klaus-liebler/factory_in_a_box/Erweiterungen Hardware.txt

Einen RGB-Ausgang weg
Dafür PWM-Steuerausgang für Vakuum-Pumpe -->passt eins zu eins, oder? Frequenz? ggf für Vakuum keine PWM, sondern knallhartes On/Off?
Wie viele Ventile haben wir jetzt eigentlich
	- Umschaltung für Schieber
	- Vakuum-Auflösung für Sauger
	- 2 oder 3 "Störventile
