klaus-liebler/factory_in_a_box/pcb_factory_control_unit/report.txt

Info: Processing symbol 'C1:Capacitor_SMD:C_0402_1005Metric'.
Info: Processing symbol 'C2:Capacitor_SMD:C_0402_1005Metric'.
Info: Processing symbol 'C3:Capacitor_SMD:C_0402_1005Metric'.
Info: Processing symbol 'C4:Capacitor_SMD:C_0402_1005Metric'.
Info: Processing symbol 'C5:Capacitor_SMD:C_0402_1005Metric'.
Info: Processing symbol 'C6:Capacitor_SMD:C_0402_1005Metric'.
Info: Processing symbol 'C7:Capacitor_SMD:C_0402_1005Metric'.
Info: Processing symbol 'C8:Capacitor_SMD:C_0402_1005Metric'.
Info: Processing symbol 'C9:Capacitor_SMD:C_0402_1005Metric'.
Info: Processing symbol 'C10:Capacitor_SMD:C_0402_1005Metric'.
Info: Processing symbol 'C11:Capacitor_SMD:C_0402_1005Metric'.
Info: Processing symbol 'C12:Capacitor_SMD:C_0402_1005Metric'.
Info: Processing symbol 'C13:Capacitor_SMD:C_0402_1005Metric'.
Info: Processing symbol 'C14:Capacitor_SMD:C_0402_1005Metric'.
Info: Processing symbol 'C15:Capacitor_SMD:C_0402_1005Metric'.
Info: Processing symbol 'C16:Capacitor_SMD:C_0402_1005Metric'.
Info: Processing symbol 'C17:Capacitor_SMD:C_0402_1005Metric'.
Info: Processing symbol 'C18:Capacitor_SMD:C_0402_1005Metric'.
Info: Processing symbol 'C19:Capacitor_SMD:C_0402_1005Metric'.
Info: Processing symbol 'C20:Capacitor_SMD:C_0402_1005Metric'.
Info: Processing symbol 'C21:Capacitor_SMD:C_0402_1005Metric'.
Info: Processing symbol 'C22:Capacitor_SMD:C_0402_1005Metric'.
Info: Processing symbol 'C23:Capacitor_SMD:C_0402_1005Metric'.
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
Info: Processing symbol 'C91:Capacitor_SMD:C_0402_1005Metric'.
Info: Processing symbol 'C92:Capacitor_SMD:C_0402_1005Metric'.
Info: Processing symbol 'C93:Capacitor_SMD:C_0402_1005Metric'.
Info: Processing symbol 'C94:Capacitor_SMD:C_0402_1005Metric'.
Info: Processing symbol 'C95:Capacitor_SMD:C_0402_1005Metric'.
Info: Processing symbol 'C96:Capacitor_SMD:C_0402_1005Metric'.
Info: Processing symbol 'C97:Capacitor_SMD:C_0402_1005Metric'.
Info: Processing symbol 'C98:Capacitor_SMD:C_0402_1005Metric'.
Info: Processing symbol 'C99:Capacitor_SMD:C_0402_1005Metric'.
Info: Processing symbol 'C100:Capacitor_SMD:C_0402_1005Metric'.
Info: Processing symbol 'C101:Capacitor_SMD:C_0805_2012Metric_Pad1.18x1.45mm_HandSolder'.
Info: Processing symbol 'D1:LED_SMD:LED_1206_3216Metric_ReverseMount_Hole1.8x2.4mm'.
Info: Processing symbol 'D2:Diode_SMD:D_SMA'.
Info: Processing symbol 'D3:Diode_SMD:D_SMA'.
Info: Processing symbol 'D4:LED_SMD:LED_1206_3216Metric_ReverseMount_Hole1.8x2.4mm'.
Info: Processing symbol 'D5:LED_SMD:LED_1206_3216Metric_ReverseMount_Hole1.8x2.4mm'.
Info: Processing symbol 'D6:LED_SMD:LED_1206_3216Metric_ReverseMount_Hole1.8x2.4mm'.
Info: Processing symbol 'D7:LED_SMD:LED_1206_3216Metric_ReverseMount_Hole1.8x2.4mm'.
Info: Processing symbol 'D8:Diode_SMD:D_SMA'.
Info: Processing symbol 'D9:Diode_SMD:D_SMA'.
Info: Processing symbol 'D10:Diode_SMD:D_SMA'.
Info: Processing symbol 'D11:Diode_SMD:D_SMA'.
Info: Processing symbol 'D12:LED_SMD:LED_1206_3216Metric_ReverseMount_Hole1.8x2.4mm'.
Info: Processing symbol 'D13:LED_SMD:LED_1206_3216Metric_ReverseMount_Hole1.8x2.4mm'.
Info: Processing symbol 'D14:Diode_SMD:D_SMA'.
Info: Processing symbol 'D15:Diode_SMD:D_SMA'.
Info: Processing symbol 'D16:LED_SMD:LED_1206_3216Metric_ReverseMount_Hole1.8x2.4mm'.
Info: Processing symbol 'D17:LED_SMD:LED_1206_3216Metric_ReverseMount_Hole1.8x2.4mm'.
Info: Processing symbol 'EthercatA1:liebler_CONN:RJ45_HANRUN_HR911105A'.
Info: Processing symbol 'EthercatB1:liebler_CONN:RJ45_HANRUN_HR911105A'.
Info: Processing symbol 'ETHERNET1:liebler_CONN:RJ45_HANRUN_HR911105A'.
Info: Processing symbol 'H1:MountingHole:MountingHole_4.3mm_M4_DIN965'.
Info: Processing symbol 'H2:MountingHole:MountingHole_4.3mm_M4_DIN965'.
Info: Processing symbol 'H3:MountingHole:MountingHole_4.3mm_M4_DIN965'.
Info: Processing symbol 'H4:MountingHole:MountingHole_4.3mm_M4_DIN965'.
Info: Processing symbol 'IJ1:liebler_CONN:JST_XH_B5B-XH-A_1x05_P2.50mm_Vertical_smaller'.
Info: Processing symbol 'J1:liebler_CONN:JST_XH_B3B-XH-A_1x03_P2.50mm_Vertical_smaller'.
Info: Processing symbol 'J2:liebler_CONN:IDC-Header_2x07_P1.27mm_Vertical_SMD'.
Info: Processing symbol 'J3:liebler_MECH:microSD push'.
Info: Processing symbol 'U5:Package_TO_SOT_SMD:SOT-23-6'.
Info: Processing symbol 'U6:Package_DFN_QFN:Texas_RGE0024H_VQFN-24-1EP_4x4mm_P0.5mm_EP2.7x2.7mm_ThermalVias'.
Info: Processing symbol 'U7:Package_TO_SOT_SMD:SOT-223-3_TabPin2'.
Info: Processing symbol 'U8:Package_SO:TSSOP-10_3x3mm_P0.5mm'.
Info: Processing symbol 'J4:Connector_BarrelJack:BarrelJack_Horizontal'.
Info: Processing symbol 'J5:liebler_CONN:USB_C_Receptacle_HRO_TYPE-C-31-M-12_smaller'.
Info: Processing symbol 'U9:Package_DFN_QFN:QFN-28-1EP_5x5mm_P0.5mm_EP3.75x3.75mm_ThermalVias'.
Info: Processing symbol 'U10:Package_DFN_QFN:QFN-28-1EP_5x5mm_P0.5mm_EP3.75x3.75mm_ThermalVias'.
Info: Processing symbol 'U11:Package_SO:SOIC-14_3.9x8.7mm_P1.27mm'.
Info: Processing symbol 'U12:Package_SO:SOIC-16_3.9x9.9mm_P1.27mm'.
Info: Processing symbol 'J6:liebler_CONN:USB_C_Receptacle_HRO_TYPE-C-31-M-12_smaller'.
Info: Processing symbol 'U13:Package_DFN_QFN:QFN-64-1EP_9x9mm_P0.5mm_EP6x6mm_ThermalVias'.
Info: Processing symbol 'X1:liebler_MODULES:DCDC-XL6009-boost'.
Info: Processing symbol 'Y1:Crystal:Crystal_SMD_2016-4Pin_2.0x1.6mm'.
Info: Processing symbol 'Y2:Crystal:Crystal_SMD_2016-4Pin_2.0x1.6mm'.
Info: Processing symbol 'J7:liebler_CONN:JST_XH_B5B-XH-A_1x05_P2.50mm_Vertical_smaller'.
Info: Processing symbol 'J8:liebler_CONN:JST_XH_B5B-XH-A_1x05_P2.50mm_Vertical_smaller'.
Info: Processing symbol 'J9:liebler_CONN:JST_XH_B5B-XH-A_1x05_P2.50mm_Vertical_smaller'.
Info: Processing symbol 'J10:liebler_CONN:JST_XH_B3B-XH-A_1x03_P2.50mm_Vertical_smaller'.
Info: Processing symbol 'J11:liebler_CONN:JST_XH_B3B-XH-A_1x03_P2.50mm_Vertical_smaller'.
Info: Processing symbol 'J12:liebler_CONN:JST_XH_B3B-XH-A_1x03_P2.50mm_Vertical_smaller'.
Info: Processing symbol 'J13:liebler_CONN:JST_XH_B3B-XH-A_1x03_P2.50mm_Vertical_smaller'.
Info: Processing symbol 'J14:liebler_CONN:JST_XH_B3B-XH-A_1x03_P2.50mm_Vertical_smaller'.
Info: Processing symbol 'J15:Connector_IDC:IDC-Header_2x05_P2.54mm_Vertical'.
Info: Processing symbol 'J16:liebler_CONN:JST_XH_B4B-XH-A_1x04_P2.50mm_Vertical_smaller'.
Info: Processing symbol 'J17:liebler_CONN:JST_XH_B4B-XH-A_1x04_P2.50mm_Vertical_smaller'.
Info: Processing symbol 'J18:liebler_CONN:JST_XH_B4B-XH-A_1x04_P2.50mm_Vertical_smaller'.
Info: Processing symbol 'J19:liebler_CONN:JST_XH_B3B-XH-A_1x03_P2.50mm_Vertical_smaller'.
Info: Processing symbol 'J20:Connector_Molex:Molex_SPOX_5267-03A_1x03_P2.50mm_Vertical'.
Info: Processing symbol 'J21:Connector_JST:JST_XH_B2B-XH-A_1x02_P2.50mm_Vertical'.
Info: Processing symbol 'J22:liebler_CONN:JST_XH_B4B-XH-A_1x04_P2.50mm_Vertical_smaller'.
Info: Processing symbol 'J23:liebler_CONN:PhoenixContact_MC_1,5_2-G-3.5_1x02_P3.50mm_Horizontal_smallerCourtyard'.
Info: Processing symbol 'J24:liebler_CONN:PhoenixContact_MC_1,5_2-G-3.5_1x02_P3.50mm_Horizontal_smallerCourtyard'.
Info: Processing symbol 'J25:Connector_JST:JST_XH_B2B-XH-A_1x02_P2.50mm_Vertical'.
Info: Processing symbol 'J26:Connector_JST:JST_XH_B2B-XH-A_1x02_P2.50mm_Vertical'.
Info: Processing symbol 'J27:Connector_JST:JST_XH_B2B-XH-A_1x02_P2.50mm_Vertical'.
Info: Processing symbol 'J28:Connector_JST:JST_XH_B2B-XH-A_1x02_P2.50mm_Vertical'.
Info: Processing symbol 'J29:liebler_CONN:JST_XH_B4B-XH-A_1x04_P2.50mm_Vertical_smaller'.
Info: Processing symbol 'L1:Inductor_SMD:L_0603_1608Metric'.
Info: Processing symbol 'L2:Inductor_SMD:L_0603_1608Metric'.
Info: Processing symbol 'L3:Inductor_SMD:L_Abracon_ASPI-0630LR'.
Info: Processing symbol 'L4:Inductor_SMD:L_Abracon_ASPI-0630LR'.
Info: Processing symbol 'L5:Inductor_SMD:L_Bourns_SRP1245A'.
Info: Processing symbol 'L6:Inductor_SMD:L_0805_2012Metric'.
Info: Processing symbol 'L7:Inductor_SMD:L_0603_1608Metric'.
Info: Processing symbol 'L8:Inductor_SMD:L_0603_1608Metric'.
Info: Processing symbol 'L9:Inductor_SMD:L_0603_1608Metric'.
Info: Processing symbol 'L10:Inductor_SMD:L_0603_1608Metric'.
Info: Processing symbol 'L11:Inductor_SMD:L_0603_1608Metric'.
Info: Processing symbol 'NT1:NetTie:NetTie-2_SMD_Pad0.5mm'.
Info: Processing symbol 'NT2:NetTie:NetTie-2_SMD_Pad0.5mm'.
Info: Processing symbol 'NT3:NetTie:NetTie-2_SMD_Pad0.5mm'.
Info: Processing symbol 'Q1:Package_SON:VSON-8_3.3x3.3mm_P0.65mm_NexFET'.
Info: Processing symbol 'Q2:Package_TO_SOT_SMD:SOT-23'.
Info: Processing symbol 'Q3:Package_TO_SOT_SMD:SOT-23'.
Info: Processing symbol 'Q4:Package_TO_SOT_SMD:SOT-23'.
Info: Processing symbol 'Q5:Package_TO_SOT_SMD:SOT-23'.
Info: Processing symbol 'Q6:Package_TO_SOT_SMD:SOT-23'.
Info: Processing symbol 'Q7:Package_TO_SOT_SMD:SOT-23'.
Info: Processing symbol 'Q8:Package_TO_SOT_SMD:SOT-23'.
Info: Processing symbol 'Q9:Package_TO_SOT_SMD:SOT-23'.
Info: Processing symbol 'R1:Resistor_SMD:R_0402_1005Metric'.
Info: Processing symbol 'R2:Resistor_SMD:R_0402_1005Metric'.
Info: Processing symbol 'R3:Resistor_SMD:R_0402_1005Metric'.
Info: Processing symbol 'R4:Resistor_SMD:R_0402_1005Metric'.
Info: Processing symbol 'R5:Resistor_SMD:R_0402_1005Metric'.
Info: Processing symbol 'R6:Resistor_SMD:R_0402_1005Metric'.
Info: Processing symbol 'R7:Resistor_SMD:R_0402_1005Metric'.
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
Info: Processing symbol 'R75:Resistor_SMD:R_0402_1005Metric'.
Info: Processing symbol 'R76:Resistor_SMD:R_0402_1005Metric'.
Info: Processing symbol 'R77:Resistor_SMD:R_0402_1005Metric'.
Info: Processing symbol 'R78:Resistor_SMD:R_0402_1005Metric'.
Info: Processing symbol 'R79:Resistor_SMD:R_0402_1005Metric'.
Info: Processing symbol 'R80:Resistor_SMD:R_0402_1005Metric'.
Info: Processing symbol 'R81:Resistor_SMD:R_0402_1005Metric'.
Info: Processing symbol 'R82:Resistor_SMD:R_0402_1005Metric'.
Info: Processing symbol 'R83:Resistor_SMD:R_0402_1005Metric'.
Info: Processing symbol 'R84:Resistor_SMD:R_0402_1005Metric'.
Info: Processing symbol 'R85:Resistor_SMD:R_0402_1005Metric'.
Info: Processing symbol 'R86:Resistor_SMD:R_0402_1005Metric'.
Info: Processing symbol 'R87:Resistor_SMD:R_0402_1005Metric'.
Info: Processing symbol 'R88:Resistor_SMD:R_0402_1005Metric'.
Info: Processing symbol 'R89:Resistor_SMD:R_0402_1005Metric'.
Info: Processing symbol 'R90:Resistor_SMD:R_0402_1005Metric'.
Info: Processing symbol 'R91:Resistor_SMD:R_0402_1005Metric'.
Info: Processing symbol 'R92:Resistor_SMD:R_0402_1005Metric'.
Info: Processing symbol 'R93:Resistor_SMD:R_0402_1005Metric'.
Info: Processing symbol 'R94:Resistor_SMD:R_0402_1005Metric'.
Info: Processing symbol 'R95:Resistor_SMD:R_0805_2012Metric_Pad1.20x1.40mm_HandSolder'.
Info: Processing symbol 'R96:Resistor_SMD:R_0805_2012Metric_Pad1.20x1.40mm_HandSolder'.
Info: Processing symbol 'R97:Resistor_SMD:R_0402_1005Metric'.
Info: Processing symbol 'R98:Resistor_SMD:R_0402_1005Metric'.
Info: Processing symbol 'R99:Resistor_SMD:R_0402_1005Metric'.
Info: Processing symbol 'R100:Resistor_SMD:R_0402_1005Metric'.
Info: Processing symbol 'R101:Resistor_SMD:R_0402_1005Metric'.
Info: Processing symbol 'R102:Resistor_SMD:R_0402_1005Metric'.
Info: Processing symbol 'R103:Resistor_SMD:R_0402_1005Metric'.
Info: Processing symbol 'R104:Resistor_SMD:R_0805_2012Metric_Pad1.20x1.40mm_HandSolder'.
Info: Processing symbol 'R105:Resistor_SMD:R_0402_1005Metric'.
Info: Processing symbol 'SW1:liebler_MECH:SW_SPST_TL3342_smaller'.
Info: Processing symbol 'SW2:liebler_MECH:SW_SPST_TL3342_smaller'.
Info: Processing symbol 'TP1:TestPoint:TestPoint_THTPad_D1.0mm_Drill0.5mm'.
Info: Processing symbol 'TP2:TestPoint:TestPoint_THTPad_D1.0mm_Drill0.5mm'.
Info: Processing symbol 'TP3:TestPoint:TestPoint_THTPad_D1.0mm_Drill0.5mm'.
Info: Processing symbol 'TP4:TestPoint:TestPoint_THTPad_D1.0mm_Drill0.5mm'.
Info: Processing symbol 'U1:Package_QFP:LQFP-100_14x14mm_P0.5mm'.
Info: Processing symbol 'U2:Package_DFN_QFN:DFN-8-1EP_3x3mm_P0.65mm_EP1.55x2.4mm'.
Info: Processing symbol 'U3:Package_DFN_QFN:VQFN-24-1EP_4x4mm_P0.5mm_EP2.5x2.5mm_ThermalVias'.
Info: Processing symbol 'U4:Package_TO_SOT_SMD:SOT-23-6'.
Updated X1 unit metadata.
Updated U11 symbol association from /3e57726e-e70f-48f8-bf8b-be1a55c6b2d5/e5de299f-0096-4c31-9eca-c668b48ce3ce to /3e57726e-e70f-48f8-bf8b-be1a55c6b2d5/e5f502ed-76cb-4969-b676-b47a32f629b9.
Changed X1 footprint from 'liebler_MODULES:DCDC-XL4015' to 'liebler_MODULES:DCDC-XL6009-boost'.
Removed unused net Net-(Q4-B).
Removed unused net Net-(Q4-C).
Warning: No net found for component J3 pad 10 (no pin 10 in symbol).
Warning: No net found for component J3 pad 10 (no pin 10 in symbol).
Warning: No net found for component J3 pad 10 (no pin 10 in symbol).
Warning: No net found for component J3 pad 10 (no pin 10 in symbol).
Warning: No net found for component J5 pad S1 (no pin S1 in symbol).
Warning: No net found for component J5 pad S1 (no pin S1 in symbol).
Warning: No net found for component J5 pad S1 (no pin S1 in symbol).
Warning: No net found for component J5 pad S1 (no pin S1 in symbol).
Warning: No net found for component J6 pad S1 (no pin S1 in symbol).
Warning: No net found for component J6 pad S1 (no pin S1 in symbol).
Warning: No net found for component J6 pad S1 (no pin S1 in symbol).
Warning: No net found for component J6 pad S1 (no pin S1 in symbol).
Error: J3 pad SH not found in liebler_MECH:microSD push.
Error: J5 pad SH not found in liebler_CONN:USB_C_Receptacle_HRO_TYPE-C-31-M-12_smaller.
Error: J6 pad SH not found in liebler_CONN:USB_C_Receptacle_HRO_TYPE-C-31-M-12_smaller.

Info: Total warnings: 12, errors: 3.
