klaus-liebler/factory_in_a_box/component_3d_models/requirements.md

# FactoryInABox
- Ein Rahmen wirklich ganz außen rum in allen drei Dimensionen. Gesamte Anlage muss innerhalb dieses Rahmens geschützt sein
- Möglichst viel mit Standard-Komponenten und Item-20-Profilen arbeiten
- Dann gerne 2D-Plattenmaterial benutzen
- Letzte Alternative: 3D-Druck
- Roboter-Montageplatte muss frei verschiebbar in x-Richtung sein

## Abmessungen
- Höhe des "Obergeschosses"= Höhe Fließband ab Befestigungsflasch + Höhe Steine + Breite (weil Quermontage) des 100mm Linearachse + 5mm Toleranz. Problem: Wie hoch ist die Kamera und reicht deren "Blickwinkel". Drehbare Befestigung auf der "Gegenseite" der Linearachse.
- Roboter Waveshare M1 gibt es nicht mehr. Nachfolger M2 ggf andere Abmessungen?

## Durchlaufregal
- Breite oben 82mm (Breite des Fließbandes)
- Damit das ganze unten sanft im für den Greifer notwendigen Winkel und im für den Greifer notwendigen Abstand zulaufen kann: Im Freien Fall ein Auseinanderführen. Bzw. Weil der hinterste Schacht auch schon fast hinten aufliegt: Hinten gerade runter
- TOF-Sensor ist 26x13mm und hat 20mm Lochabstand und soll zum Anschluss einen 6pol JST-XH-Stecker 90° abgewinkelt bekommen
