klaus-liebler/factory_in_a_box/UI für Druckregelung.pptx

Bedientableau für Kompressor (ein/aus, Leistung)

Tank-Symbol bzw Druckspeicher-Symbol.

Druck-Messinstrument mit Zeiger und Zahlenanzeige

Verbraucher-Symbol

Ventil

Verbraucher-Symbol

Ventil

Verbraucher-Symbol

Ventil

Kompressor-Symbol

Ventile können durch Draufklicken geöffnet und geschlossen werden – dann auch durch Farbumschlag anzeigen
