klaus-liebler/factory_in_a_box/paper_aale2027/AALE2027_Volltext.pdf

23. AALE-Konferenz
Fulda, 17.–19. März 2027

# Factory Control Unit

# Modellgetriebene Steuerung für die Lernfabrik Factory-in-a-Box

### Klaus M. Liebler¹

## Zusammenfassung

Lernfabriken machen Automatisierungstechnik greifbar und werden in berufsbildenden Schulen und Hochschulen der angewandten Wissenschaften in praxisorientierten Lehrformaten eingesetzt. Factory-in-a-Box (FiaB) ist ein weiteres Konzept in diesem Umfeld, das einen neuen Kompromiss zwischen Vielfalt, Kosten und Einsatzbereich anstrebt. Der Beitrag stellt zunächst kurz die wesentlichen Änderungen am Prozesskonzept gegenüber [8] vor. Im Fokus steht anschließend die Factory Control Unit (FCU), die eingebettete elektronische Zentralsteuerung von FiaB.

## Stichwörter

Factory-in-a-Box, Factory Control Unit, Lernfabrik, Modellgetriebene Entwicklung, Eingebettete Systeme

## 1 Stand der Technik

Für die berufliche Bildung und die Hochschullehre existiert eine Reihe kommerzieller Lehraufbauten, die jedoch selten sämtliche in Kapitel 2 formulierten Anforderungen gleichzeitig erfüllen. Die fischertechnik Training Factory [3] bildet mit den aus dem Baukastensystem bekannten Komponenten verschiedene Abläufe eines Industrieunternehmens spielerisch nach, wobei industrietypische Technik nur in geringem Umfang zum Einsatz kommt. Festo Didactic bietet demgegenüber ein breites Spektrum modularer, industrienaher Lernfabriken an, deren Module üblicherweise kundenspezifisch konfiguriert werden; vergleichbare, jedoch stärker auf einzelne Regelkreise als auf einen Gesamtprozess ausgerichtete Systeme vertreibt beispielsweise auch GUNT. Die Anschaffungskosten dieser industrienahen Systeme liegen typischerweise zwischen 20.000 € und über 100.000 €, wodurch sich eine Mehrfachbeschaffung für Kleingruppen- oder Einzelarbeitsplätze kaum wirtschaftlich realisieren lässt.

Einen deutlich kostengünstigeren, primär auf den schulischen Unterricht zugeschnittenen Weg verfolgt das an den Berufsbildenden Schulen Osnabrück entwickelte Smart Factory Model [9]: Eine reale speicherprogrammierbare Steuerung steuert einen kompakten Portalroboter, während ein in den Arbeitsbereich integrierter Bildschirm den Shopfloor virtuell darstellt und so einen schnellen Wechsel zwischen unterschiedlichen Prozessen ermöglicht; die Kosten für einen vollständigen Aufbau belaufen sich auf etwa 6.000 €.

Das in diesem Beitrag betrachtete Konzept Factory-in-a-Box (FiaB) wurde von Liebler [8] als kompakte, mobile und kostengünstige Modellfabrik vorgestellt, die einen vereinfachten industriellen Produktionsprozess anschaulich macht: einen Kreislaufprozess farbiger Holzklötze, aus denen kundenindividuelle Türme gefertigt werden. Der gesamte Aufbau wird als Open-Source-Projekt bereitgestellt, sodass

1 Hochschule Osnabrück, Fakultät für Ingenieurwissenschaften und Informatik, Osnabrück, Deutschland

Open Access. © 2027 Klaus M. Liebler
This work is licensed under the Creative Commons Attribution 4.0 License. +

Factory Control Unit | 2

Nachbau, Anpassung und Weiterentwicklung durch Dritte ausdrücklich vorgesehen sind. Gegenüber den zuvor genannten Systemen ordnet sich FiaB damit sowohl hinsichtlich der Anschaffungskosten als auch hinsichtlich Bauraum und Beweglichkeit am unteren Ende des Spektrums ein (vgl. Kapitel 7).

## 2 Anforderungen und Architektur

An die Modellfabrik Factory-in-a-Box wurden die folgenden wesentlichen Anforderungen gestellt:

– | Darstellung eines vereinfachten industriellen Produktionsprozesses
– | Einsetzbarkeit in verschiedenen Vorlesungsmodulen der Automatisierungstechnik
– | vielfältige Sensorik und Aktorik
– | vielfältige Kommunikationsschnittstellen
– | niedrige Investitions- und Betriebskosten
– | mechanisch und elektrisch robust (Außenrahmen, verpolungssicherer USB-C-Anschluss)
– | kompakt und mobil

Die Anforderungen wurden hinsichtlich Mechanik, Elektronik und Software wie folgt umgesetzt.

### 2.1 Mechanischer Aufbau

Die derzeitige Umsetzung basiert im Wesentlichen auf dem in [8] vorgestellten Konzept: einem Kreislaufprozess farbiger Holzblöcke. Produkt der Fabrik sind kundenindividuell gefertigte Türme aus diesen Holzklötzen. Eine wesentliche Erweiterung gegenüber dem ursprünglichen Konzept ist ein Pneumatiksystem, das die Holzklötze auf das Förderband auflegt: Es ersetzt den zuvor eingesetzten Servoantrieb durch ein weiteres, industrietypisches System und ermöglicht zugleich die Druckregelung als Thema der Regelungstechnik. Außerdem wurde der Greifer am Roboter durch einen Vakuum-Saugnapf ersetzt, was ein weiteres interessantes System einführt und die Betriebssicherheit erhöht. Darüber hinaus sollen RGB-LED-Streifen in den senkrechten Stützen als Fehlermeldeleuchte dienen und alternativ Prozessgrößen unmittelbar visualisieren.

### 2.2 Elektronisches Konzept

Die wachsende Vielfalt der integrierten Komponenten und die Anforderung nach innovativen Kommunikationsschnittstellen machten es erforderlich, von Lab@Home als zentraler Steuerungskomponente Abstand zu nehmen. Eine eigene Steuerplatine auf Basis eines STM32H5-Mikrocontrollers bindet stattdessen alle Sensoren und Aktoren an und stellt diverse Kommunikationsprotokolle bereit – sowohl für smarte Sensoren und Aktoren als auch in Richtung der übergeordneten Steuerungsebene.

### 2.3 Softwarearchitektur

Die C++-Firmware (C++20) basiert auf Eclipse ThreadX [2] als Echtzeitbetriebssystem und nutzt zusätzlich NetX Duo (für TCP/IP, TLS, DHCP, mDNS) sowie USBX (für CDC-ACM zur Realisierung von Modbus RTU sowie für CDC-NCM). Die Firmware orchestriert alle Sensoren und Aktoren, stellt verschiedene Kommunikationswege zur Außenwelt bereit und pflegt ein zentrales Informationsmodell.

### 2.4 Software-Build-Prozess

Zur Erstellung des Binärabbildes der Software ist es – ähnlich wie bei Lab@Home [7] – erforderlich, dass mehrere Schritte koordiniert nacheinander ablaufen. Bei Lab@Home wurde hierfür ein Gulp-Skript eingesetzt. Für die FCU wurde stattdessen ein eigenes Build-Tool auf Basis von .NET entwickelt. Die Entwicklung erfolgte KI-unterstützt: Ein KI-Assistent half unter anderem beim Architekturentwurf, bei der Codegenerierung sowie bei der Fehlersuche und verkürzte damit die Entwicklungszeit spürbar. Die Gründe für diese Werkzeugwahl werden im Folgenden erläutert.

## 3 Implementierung

### 3.1 Details zum Informationsmodell

Das Prozessabbild ist einmalig als annotierte C#-Klassen beschrieben (Abb. 1): 16 Klassen bilden Regionen, 75 Felder Register. Attribute legen Zugriffsrecht, Einheit, Registeradresse, Pin, Wertebereich und Darstellungsart fest; auch Bitfelder und 32-Bit-Werte aus Registerpaaren lassen sich beschreiben. Ein neu entwickelter Generator in C# (UniversalRegisterAccess), vom .NET-Build-Orchestrator aufgerufen, erzeugt daraus drei Artefakte: (1) einen C++-Header für Modbus mit Adresskonstanten, Regionsgrenzen, Bitmasken und typisierten Accessoren; (2) eine constexpr-Knotentabelle für OPC UA (ein Objekt je Region, eine Variable je Register mit Datentyp, Zugriffsrechten und Callbacks), die ohne Laufzeitaufbau im Flash liegt; sowie (3) eine TypeScript-Registerkarte, aus der das Web-UI seine generischen Register-Panels (Tabellen, Schalter, Schieberegler mit Grenzen) rendert. Schemaänderungen wirken so gleichzeitig auf Firmware und Oberfläche; Inkonsistenzen zwischen den Sichten werden bereits zur Übersetzungszeit vermieden.


Bild 1: Informationsmodell und Laufzeitarchitektur der FCU: Ein C#-Schema wird durch einen Generator in Modbus-, OPC-UA- und Web-UI-Code übersetzt; zur Laufzeit teilen alle Zugriffswege ein gemeinsames Registermodell.

Ein zweites Schema (BestBinaryBuffers) beschreibt rund 30 Nachrichten des WebSocket-Protokolls samt Union-Typen für Missionsschritte und Längengrenzen und erzeugt Kodierer, Dekodierer und maximale Puffergrößen für C++ und TypeScript. Der Orchestrator leitet je Board Hostname und MAC-Adresse aus der Chip-UID ab, erzeugt das TLS-Zertifikat, baut Web-UI (Vite) und Firmware (CMake) und flasht; das Preset Debug-Nucleo erlaubt die Arbeit auf einem Nucleo-H563ZI-Testboard.

### 3.2 Details zur Hardware

Die vierlagige Platine vereint einen STM32H563 (Cortex-M33, 640 KiB RAM) mit Ethernet, zwei USB-C-Anschlüssen (Device, Power-Delivery-Sink) und FDCAN. Für die Anlage sind zwei Schrittmotortreiber (TMC2209, sensorloses Homing), ein Wägezellenwandler, drei Abstands- und ein Farbsensor (I²C), ein Leistungsmonitor (INA226), Lichtschranken, Ventil- und PWM-Treiber, ein Drucksensoreingang, eine Statusbeleuchtung sowie ein Bus-Servo-Anschluss für den Roboterarm vorgesehen. Ein EtherCAT-Slave-Controller (LAN9253) ermöglicht bei Bedarf auch die Implementierung dieses echtzeitfähigen Protokolls.

Die elektronische Baugruppe ist auf einer Leiterplatte aufgebaut, die sich direkt mit den horizontalen oberen Streben verschrauben lässt. Die Platinenunterseite trägt alle SMD-Bauteile, die von einem chinesischen Platinenfertiger unmittelbar bestückt werden; die Oberseite enthält von Hand zu bestückende THT-Buchsen sowie umfangreiche Beschriftungen. Die Stromversorgung kann wahlweise über ein 24-V-Netzteil (Klinkenstecker) oder über ein USB-PD-Netzteil (20 V, 100 W) erfolgen.

### 3.3 Details zur Firmware

Kernaufgabe der Firmware ist die Initialisierung der Hardware und die Herstellung der Betriebsbereitschaft. Im laufenden Betrieb bedienen mehrere unabhängige Tasks alle Kommunikationsprozesse und steuern die Hardware an. Dabei laufen folgende Kommunikationsprozesse:

– | Konsolenausgabe des Logs
– | Modbus-TCP-Server, erreichbar über Ethernet und über einen virtuellen Netzwerkadapter an der USB-C-Schnittstelle (USB CDC-NCM)
– | OPC-UA-Server (Basic256Sha256 im Modus Sign), ebenfalls erreichbar über Ethernet und den vir- tuellen Netzwerkadapter
– | Modbus-RTU-Server, erreichbar über Ethernet und über eine virtuelle serielle Schnittstelle an der USB-C-Schnittstelle (USB CDC)
– | SNTP-Client zum Bezug der Echtzeit
– | HTTPS-Server zur Bereitstellung des Browser-Clients und einer RESTful API
– | HTTPS-WebSocket-Server für die laufende Kommunikation zwischen Browser und Baugruppe
– | synchronisierte Ansteuerung der Antriebe des 6-DOF-Roboters über ein Bus-Servo-Protokoll
– | USB-PD-Sink zur Anforderung von 20 V oder 28 V (PD 3.1) von einem entsprechend kompatiblen USB-PD-Netzteil

Der OPC-UA-Server ist als ressourceneffiziente Eigenentwicklung (rund 3900 Zeilen C++) entstanden. Hinsichtlich der Sicherheit unterstützt er derzeit Basic256Sha256 im Modus Sign. Eine Besonderheit: Der Namespace 0 enthält überwiegend konstante Werte und liegt daher als konstante Tabelle im Flash; nur die wenigen volatilen Werte verweisen auf Speicherorte im RAM. Zur Laufzeit wird dafür kaum RAM benötigt. OPC UA und HTTPS-Server teilen sich ein gemeinsames X.509-Zertifikat.

## 4 Details zum Webfrontend

Das Web-UI ist eine Single-Page-Anwendung aus Lit-Web-Components (TypeScript, Vite), die als whitespace-minimierte, obfuskierte und Brotli-komprimierte Datei (84 kB statt 460 kB) per HTTPS aus dem Flash der FCU ausgeliefert wird. Alle Anwendungsdaten werden anschließend ausschließlich über einen binären WebSocket ausgetauscht. Folgende Seiten sind erreichbar:

– | Registermodell: lesender und schreibender Zugriff auf alle im Informationsmodell definierten Re- gister über typgerecht gerenderte Eingabefelder und Schalter
– | Power Monitoring mit aktueller Versorgungsspannung, Strom, Momentanleistung und Leistungs- historie
– | Task-Manager mit ThreadX-Live-Statistik
– | Roboter-Missionsplanung
– | Druckregelkreis: Identifikation und Charakterisierung einer Druckregelstrecke sowie Parametrie- rung eines PID-Reglers

Die Seiten Druckregelkreis und Roboter-Missionsplanung haben besondere Bedeutung in der Lehre des Autors und werden deshalb im Folgenden ausführlicher beschrieben.

### 4.1 Druckregelstrecke

Die Druckregelstrecke besteht aus Kompressor, Kessel, einem realen Verbraucher (Doppelkolbenzylinder), drei simulierten Verbrauchern (Ventile mit Drossel) und einem Drucksensor. Die Weboberfläche bietet vollständig integrierte Möglichkeiten zur Kennlinienerstellung und zur dynamischen Analyse mittels des klassischen Sprungantwortversuchs (Auswertung nach dem Wendetangentenverfahren).

Im Vergleich zu den zuvor im Labor verwendeten Regelstrecken Heizwiderstand und Schwebekörper zeichnet sich die Druckregelstrecke durch eine gute Linearität in einem weiten Arbeitsbereich und ein angenehmes Zeitverhalten aus (Zeitkonstante etwa 20 s). Die Studierenden erhalten auf Wunsch programmintegrierte Unterstützung bei der Ermittlung von Arbeitspunkt, Proportionalitätsfaktor, Totzeit und Zeitkonstante. Die Werte lassen sich unmittelbar in eine Berechnungshilfe nach der T-Summen-Regel nach Kuhn oder nach Chien–Hrones–Reswick [1] übertragen, die ihrerseits die Ergebnisse in die Parameterfelder eines P-, PI- oder PIDT1-Reglers überträgt. Der Regelalgorithmus läuft dabei im Browser, der über Lesen und Beschreiben des Registermodells mit Drucksensor sowie realem und simulierten Verbrauchern kommuniziert.

### 4.2 Roboter-Missionsplanung

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

## 5 Details zum Build-Prozess

Zur Orchestrierung des Build-Prozesses wurde ein neues Build-Tool in .NET entwickelt. Ausschlaggebend für diese Entscheidung war, dass zur Beschreibung des Informationsmodells und der Nachrichtenstrukturen zwischen Browser-Frontend und HTTPS-WebSocket-Server annotierte C#-Klassen zum


Bild 2: Teach-Seite: Roboterdaten aus der Offline-Werkzeugkette, Browser-Komponenten und Kopplung zur FCU über eine Backend-Schnittstelle.

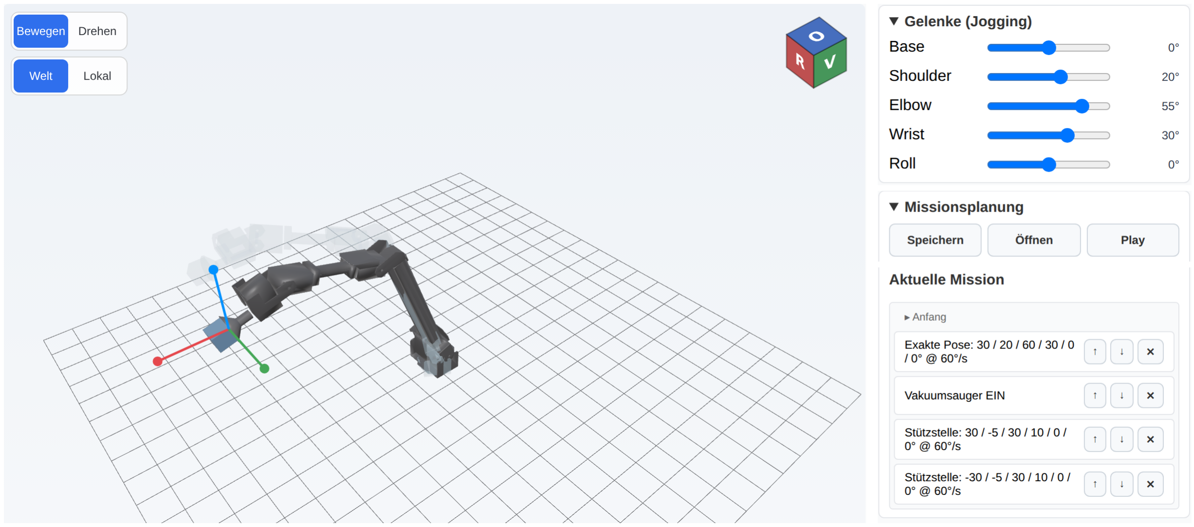
[picture p4: figure]

Bild 3: Teach-Seite (Ausschnitte): 3D-Modell mit Gizmo, ViewCube und Geisterbild; Gelenkschieber und Missionsliste (Entwicklungsserver, Mock-Backend).

Einsatz kommen sollten. Da für das Parsen und die Umwandlung dieser Klassen ohnehin eine .NET-Umgebung erforderlich war, erschien es aus Effizienzgründen sinnvoll, dieses Framework auch für die gesamte Build-Orchestrierung zu verwenden. Ein ausführliches Log und eine farbige Konsolenausgabe während des Builds schaffen dabei Transparenz und Nachverfolgbarkeit:

1. Auslesen der eindeutigen Chip-ID über das Debugging-Interface oder den seriellen Bootloader
2. Erstellung eines gerätespezifischen Zertifikats für OPC UA und HTTPS
3. Codegenerierung für einkompilierbare Informationen über die Hardware-ID der Baugruppe und daraus abgeleitete Größen
4. Codegenerierung für den einkompilierten Verweis auf den verwendeten Repository-Stand
5. Codegenerierung für das Informationsmodell auf Basis der annotierten C#-Klassen; der generierte Code wird vom OPC-UA-Server, von beiden Modbus-Servern und vom Webclient zum Aufbau der Strukturen verwendet
6. Codegenerierung der Encoder und Parser für die Kommunikation zwischen HTTPS-WebSocket-Server und Browser-Client, ebenfalls auf Basis annotierter C#-Klassen
7. Bau des Browser-Clients (Vite-Applikation, anschließend Single-File-Inlining, Whitespace-Elimination und Brotli-Kompression)
8. Bau der Firmware, wobei Zertifikate und Browser-Client in das Binary eingelinkt werden

## 6 Einsatz in der Lehre

Die FCU soll in vier Lehrveranstaltungen eingesetzt werden (Tab. 1). Alle arbeiten an derselben, greifbaren Anlage, setzen aber an unterschiedlichen Schnittstellen an.

Tabelle 1: Geplanter Einsatz der FCU in vier Lehrveranstaltungen.

Veranstaltung | Lerninhalte | Nutzung der FCU und Aufgaben
Connected | Systems
(Master)

Kommunikationsgrundlagen, Signierung und Verschlüsselung in OPC UA, Echtzeitprotokoll EtherCAT

| | Modbus und OPC UA (Basic256Sha256, Sign, Gerätezertifikat) auf einem Pro- zessabbild; EtherCAT-Slave (LAN9253); Mitschnitte und Zertifikate untersuchen
Regelungstechnik | Streckenidentifikation, | Reglerent-
| wurf, Anti-Windup | Druckregelstrecke: Kennlinie, Sprungant- wort, Reglerbetrieb (P/PI/PID); Regler ein- stellen und vergleichen

Automatisierungstechnik

IEC 61131-3, Ablaufsprache (AS),
Funktionsbausteinsprache (FBS)
| | Fabrik als reale Anlage; Soft-SPS (z. B. CODESYS) über OPC UA oder Modbus; Sortier- und Transportablauf, Inbetrieb- nahme
Embedded Systems | Hardwarenaher Entwurf, Echtzeitbe-
| triebssystem, Treiber | Modulare Platine, Testboard Nucleo- H563ZI, reproduzierbarer Build; Bau- gruppe oder Submodul weiterentwickeln

### 6.1 Master-Vorlesung „Connected Systems“

Die FCU dient als Anschauungsobjekt für Kommunikation, Absicherung und Echtzeitfähigkeit. Zunächst werden Kommunikationskonzepte (Master/Slave, Client/Server, Registerabbild gegenüber Informationsmodell) an Modbus und OPC UA auf demselben Prozessabbild verglichen. Für OPC UA wird das Sicherheitskonzept praktisch nachvollzogen: Der Server nutzt Basic256Sha256 im Modus Sign mit gerätespezifischem Zertifikat; Studierende untersuchen Zertifikate und Vertrauenskette, stellen im Netzwerkmitschnitt fest, dass signierte Nachrichten manipulationsgeschützt, aber lesbar sind, und diskutieren den Schritt zu Sign and Encrypt [5]. Als Echtzeitprotokoll dient EtherCAT [4]: Der Slave-Controller der Platine wird in einen Verbund aufgenommen, Zykluszeit und Determinismus werden mit Modbus und OPC UA verglichen.

### 6.2 Regelungstechnik: Druckregelstrecke

Die Druckregelstrecke hat eine nichtlineare, über die Ventilkombination veränderliche Kennlinie und deckt den Weg von der Identifikation bis zum Regler ab: Studierende nehmen Kennlinien auf, bestimmen aus Sprungantworten Totzeit und Zeitkonstante, entwerfen P-, PI- und PID-Regler nach Einstellregeln und beobachten im realen Regelkreis Stellgrößenbegrenzung und Anti-Windup. Da der Regelkreis nur über Register geschlossen wird, kann der Regler auch in einem Skript oder einer SPS laufen.

### 6.3 Automatisierungstechnik: Steuerungsentwurf nach IEC 61131-3

Die Fabrik ist der Prozess, für den Studierende die Steuerlogik nach IEC 61131-3 [6] entwickeln, wahlweise in Ablaufsprache (AS) oder Funktionsbausteinsprache (FBS), etwa in CODESYS als Soft-SPS. Die Kommunikation mit der Fabrik erfolgt über OPC UA oder Modbus, sodass beide Wege verglichen werden können. Typische Aufgaben sind ein Sortier- und Transportablauf mit Förderband, Lichtschranken, Ventilen und Sensoren sowie der Aufruf von Roboter-Missionen als Teilablauf; die Register-Panels dienen der Inbetriebnahme.

### 6.4 Embedded Systems: Weiterentwicklung von Baugruppen

Die Platine gliedert sich in funktionale Baugruppen (Antriebe, I²C-Sensorik, Leistungserfassung, Ventil- und PWM-Ausgänge, Kommunikation); Studierende können einzelne Baugruppen oder Submodule weiterentwickeln, etwa einen Sensorzweig, eine Treiberstufe oder eine Erweiterungsplatine samt Firmware-Treiber. Reproduzierbarer Build und Nucleo-H563ZI-Testboard erlauben Arbeit ohne eigene Platine; neue Register stehen nach Ergänzung im Schema in Modbus, OPC UA und Web-UI bereit.

## 7 Evaluation

Die grundsätzliche Funktion der Mechanik und der Elektronik der FCU wurde im Rahmen studentischer Abschlussarbeiten geprüft. Firmware und Build-Prozess sind implementiert und anhand von Unit-Tests geprüft. Offen sind konkrete Aufgabenformulierungen in allen Modulen sowie das Einholen von Feedback der Studierenden. Die Materialkosten pro Einheit belaufen sich auf etwa 750–850 €, wobei ein wesentlicher Teil auf den Roboter entfällt.

Zum Konferenzthema Energiemonitoring liefert der INA226 Spannung, Strom und Leistung der Anlage über alle Schnittstellen; in der Lehre lassen sich Ablaufvarianten energetisch vergleichen. Für Praxis und Forschung zeigt der Ansatz, wie ein Informationsmodell konsistente Feldbus-, OPC-UA- und Web-Sichten aus einer Quelle erzeugt und dabei auf einem preiswerten Mikrocontroller Platz findet.

## 8 Geplante Weiterentwicklung bis zur AALE

Angesichts des Fokus der AALE 2027 soll dieser Bereich noch dahingehend erweitert werden, dass die Leistung in den Kontext der aktivierten Verbraucher gesetzt wird und so eine verursachergerechte Zuordnung und damit eine effiziente Reduktion des Energieverbrauchs möglich wird.

Die Fortentwicklung von EtherCAT wird zunächst niedriger priorisiert, da es gegenwärtig keinen konkreten Einsatzfall dafür gibt.

## 9 Literatur

[1] K. L. Chien, J. A. Hrones, and J. B. Reswick. On the automatic control of generalized passive systems. Transactions of the ASME, 74:175–185, 1952.
[2] Eclipse Foundation. Eclipse threadx (ehemals azure rtos threadx). https://threadx.io.
[3] fischertechnik GmbH. Training factory industry 4.0 24v – accompanying booklet, 2024. Stand 22.03.2024.
[4] IEC. Iec 61158 (typ 12): Industrial communication networks – fieldbus specifications (ethercat). Technical report, International Electrotechnical Commission.
[5] IEC. Iec 62541: Opc unified architecture, teil 2 (sicherheitsmodell) und teil 6 (mappings). Technical report, International Electrotechnical Commission.
[6] IEC. Iec 61131-3: Speicherprogrammierbare steuerungen – teil 3: Programmiersprachen. Technical report, International Electrotechnical Commission, 2013.
[7] Klaus Liebler. Lab@home: Eine open-source experimentierplattform. In Tagungsband AALE 2023, pages 1–12. Hochschule für Technik, Wirtschaft und Kultur Leipzig, 2023.
[8] Klaus Liebler. Lab@home automatisiert eine modellfabrik und erhält einen ki-assistenten. In Tagungsband AALE 2025: Menschzentrierte Automation im digitalen Zeitalter, pages 232–240. Hochschule für Technik, Wirtschaft und Kultur Leipzig, 2025.
[9] Harald Strating and Simon Sayk. Das smart factory modell – innovativer unterricht an bbs zur vorbereitung auf den arbeitsplatz der zukunft in der industrie 4.0. In A. Grimm et al., editors, Digitalisierung und Nachhaltigkeit gestalten lernen. Beiträge der BAG-Tagung „All Days For Future – Energievielfalt in der gewerblichtechnischen Berufsbildung“, pages 113–128. wbv, Bielefeld, 2023.
