klaus-liebler/factory_in_a_box/Materialliste.xlsx

Sheet: Komponenten
Kosten:
Budget: | 8000.00 €
Anzahl: | 10
 |  | Einzel Budget: | Benötigt: | Verfügbar:
 |  | 800.00 € | 266.89 € | 533.11 €
 | Kategorien | Produkt | Bezeichnung/Daten | Preis | Anzahl | Gesamt Preis | Bestell-Link | Bestand | Benötigt | Zubestellen | Spalte 8 | Im Warenkorb |  |  |  |  | Produkt | Bestand
 | Roboterarm | RoArm | M3-S | 240.00 € | 1 | 240.00 € | https://www.waveshare.com/roarm-m3.htm?sku=30442 | 2 | 10 | 8 | Nicht Ausreichend | zurückgestellt |  |  |  | Nicht Verwendete Komponenten | Balgsauggreifer 1,5 Falten d=10mm | 10
 |  | Pneumatik-Magnetventil | 0520F-12V | 3.59 € | 1 | 3.59 € | https://de.aliexpress.com/item/1005004259294900.html | 10 | 10 | 0 | Vollständig | zurückgestellt |  |  |  |  | Digitaler Drucksensor | 1
 |  | Vakuumkompressor | HPV1-12V |  | 1 | 0.00 € |  | 5 | 10 | 5 | Nicht Ausreichend | zurückgestellt |  |  |  |  | NFC PN5180 | 1
 |  | Steck-Fitting 4-1/8" Anschluss L-Form | ELP4-1/8 |  | 1 | 0.00 € |  | 5 | 10 | 5 | Nicht Ausreichend | zurückgestellt |  |  |  |  | NFC PN532 | 1
 |  | Balgsauggreifer | 1,5 Falten d=15 mm |  | 1 | 0.00 € |  | 10 | 10 | 0 | Vollständig | zurückgestellt |  |  |  |  | Pneumatik-Magnetventil | 2
 |  | Anschlussstück |  |  | 1 | 0.00 € |  | 10 | 10 | 0 | Vollständig | zurückgestellt |  |  |  |  | Flow-Control-Valve | 20
 |  |  |  |  |  |  |  |  |  |  |  |  |  |  |  |  | Serial Servo Bus | 1
 | Pneumatik-System | Drucksensor | GS01525-02 | 15.78 € | 1 | 15.78 € | https://www.amazon.de/Sensor-Transducer-Druck-Kraftstoff-Gewinde-Edelstahl/dp/B0748BHLQL | 5 | 10 | 5 | Nicht Ausreichend | 7 |  |  |  |  | Pneumatik-Zylinder | 6
 |  | Pneumatik-Zylinder | SG-566-03 | 5.00 € | 1 | 5.00 € | https://de.aliexpress.com/item/4000324592767.html | 10 | 10 | 0 | Vollständig | ok |  |  |  |  | Doppel-Pneumatik-Zylinder | 2
 |  | Störventil | 3V1-06-3F-24V |  | 1 | 0.00 € |  | 1 | 10 | 9 | Nicht Ausreichend | 10 |  |  |  |  | Dichtband/Abdichtband | 11
 |  | Kompressor | Micro air pump DC24V |  | 1 | 0.00 € |  | 11 | 10 | -1 | Vollständig | ok |  |  |  |  | Endschalter | 10
 |  | Regulierungsventil | SL6-M5 | 0.76 € | 2 | 1.52 € |  | 20 | 20 | 0 | Vollständig | ok |  |  |  |  | NFC Wet Tag Sticker | 100
 |  | Regulierungsventil Störungen |  |  | 3 |  |  | 0 | 30 | 30 | Nicht Ausreichend | ??? |  |  |  |  | Kamera-Module | 6
 |  | Schwingungsdämpfer | M4 10mm | 0.25 € | 4 | 1.00 € |  | 8 | 40 | 32 | Nicht Ausreichend | 40 |  |  |  |  | Anschlussstück-Vakuumgreifer klein | 10
 |  | Schwingungsdämpfer | M5 15mm |  | 4 | 0.00 € |  | 40 | 40 | 0 | Vollständig | ok |  |  |  |  | Heatsinks | 1
 |  | Pneumatik T-Stück | female,female,male 1/8 Zoll |  | 1 | 0.00 € |  | 10 | 10 | 0 | Vollständig | ok |  |  |  |  | Mircocontroller | 5
 |  | Reduzierstück | Male G1/4 Female G1/8 |  | 1 | 0.00 € | https://de.aliexpress.com/item/1005008053975060.html | 12 | 10 | -2 | Vollständig | ok |  |  |  |  | Vakuumkompressor HPV1 24V | 1
 |  | Pneumatik-Magnetventil |  |  | 1 | 0.00 € |  | 10 | 10 | 0 | Vollständig | ok |  |  |  |  | Kompressor | 1
 |  | DruckBehälter |  |  | 1 | 0.00 € |  | 11 | 10 | -1 | Vollständig | ok |  |  |  |  | Alte Steuerplatine | 3
 |  |  |  |  |  |  |  |  |  |  |  |  |  |  |  |  | Spannungswandler | 1
 | Fahrstuhl | Gewichtsensor/Wägezellen |  |  | 1 | 0.00 € |  | 10 | 10 | 0 | Vollständig | ok |  |  |  |  | POE Switch | 1
 |  | Linearachse Fahrstuhl |  |  | 1 | 0.00 € |  | 10 | 10 | 0 | Vollständig | ok |  |  |  |  | Serial Bus Servo STS3215 12V | 1
 |  |  |  |  |  |  |  |  |  |  |  |  |  |  |  |  | Robot Manipulator | 1
 | Sortiermechanismus | Linearachse Sort | 28H30H0604A2 |  | 1 | 0.00 € |  | 11 | 10 | -1 | Vollständig | ok |  |  |  |  | L-Form verbindungsstück m/m | 3
 |  | Time of Flight Sensor | VL53L0X |  | 3 | 0.00 € |  | 3 | 30 | 27 | Nicht Ausreichend | noch offen |  |  |  |  | Pcross Laser | 1
 |  | Conveyerbelt | Mini-S210-552mm-NoPower |  | 1 | 0.00 € |  | 8 | 10 | 2 | Nicht Ausreichend | 3 |  |  |  |  | s 340 | 2
 |  | Lichtschranke | E3Z-R61 |  | 2 | 0.00 € |  | 11 | 20 | 9 | Nicht Ausreichend | 10 |  |  |  |  | Gelber Plastik Ball | 1
 |  | RGB-Sensor / KI-Kamera |  |  | 1 | 0.00 € |  | 0 | 10 | 10 | Nicht Ausreichend | noch offen, 2.Semester ET, ESP32-S3-CAM
 |  | Reflektor | Reflektor für Lichtschranke |  | 2 |  |  | 1 | 20 | 19 | Nicht Ausreichend | Reflexband verwenden
 | Steuerung | Platine |  |  | 1 | 0.00 € |  | Unbekannt | 10 | #VALUE! | #VALUE!
 |  | LED-Streifen in Meter |  |  | 0.5 | 0.00 € |  | 3 | 5 | 2 | Nicht Ausreichend
 |  | LED leisten |  |  | 1 | 0.00 € |  | 10 | 10 | 0 | Vollständig
 | Kabel | Cable Saddle Cable Tie Holder |  |  | Unbekannt |  |  | 50 | #VALUE! | #VALUE! | #VALUE!
 |  | PCB Phoenix Connector 2 Pin |  |  | 1 | 0.00 € |  | 12 | 10 | -2 | Vollständig
 |  | PCB Phoenix Connector 4 Pin |  |  | Unbekannt |  |  | 12 | #VALUE! | #VALUE! | #VALUE!
 |  | kabelkette 7x7mm ca. 45 cm |  |  | 1 | 0.00 € |  | 3 | 10 | 7 | Nicht Ausreichend
 | Rahmen | Eckverbinder 3D 20x20 B-Type nut 6 mit Schraube M4x5 |  | 0.00 € | 8 | 0.00 € |  | 128 | 80 | -48 | Vollständig
 |  | Aluprofil 20x20 B-Typ Nut 6 710mm |  | 0.00 € | 4 | 0.00 € |  | 40 | 40 | 0 | Vollständig |  | Aluprofil 20x20 B-Typ Nut 6
 |  | Aluprofil 20x20 B-Typ Nut 6 150mm |  | 0.00 € | 4 | 0.00 € |  | 42 | 40 | -2 | Vollständig |  | Gesamt | 56 | meter
 |  | Aluprofil 20x20 B-Typ Nut 6 540mm |  | 0.00 € | 4 | 0.00 € |  | 40 | 40 | 0 | Vollständig |  | Benötig | -0.3 | meter
 |  | Gummifüße 20x15x8mm | BOKJ097168x20 |  | 4 |  |  | 20 | 40 | 20 | Nicht Ausreichend
 |  | Nutensteine M4 |  |  | 39 | 0.00 € |  |  | 390 | 390 | Nicht Ausreichend
 | Schrauben etc. | Schrauben M2 5 mm |  |  | 2 |  |  |  | 20 | 20 | Nicht Ausreichend
 |  | Schrauben M2 10 mm |  |  | 4 |  |  |  | 40 | 40 | Nicht Ausreichend
 |  | Schrauben M3 30 mm |  |  | 3 |  |  |  | 30 | 30 | Nicht Ausreichend
 |  | Schrauben M3 10 mm |  |  | 6 |  |  |  | 60 | 60 | Nicht Ausreichend
 |  | Schrauben M3 15 mm |  |  | 6 |  |  |  | 60 | 60 | Nicht Ausreichend
 |  | Schrauben M4 10 mm |  |  | 44 | 0.00 € |  |  | 440 | 440 | Nicht Ausreichend
 |  | Schrauben M5 10 mm |  |  | 1 |  |  |  | 10 | 10 | Nicht Ausreichend
 |  | Schrauben M7 20 mm |  |  | 2 |  |  |  | 20 | 20 | Nicht Ausreichend
 |  | Schrauben M6 35 mm |  |  | 2 |  |  |  | 20 | 20 | Nicht Ausreichend
 |  | Muttern M2 |  |  | 4 |  |  |  | 40 | 40 | Nicht Ausreichend
 |  | Muttern M3 |  |  | 11 |  |  |  | 110 | 110 | Nicht Ausreichend
 |  | Muttern M4 |  |  | 4 |  |  |  | 40 | 40 | Nicht Ausreichend
 |  | Muttern M5 |  |  | 1 |  |  |  | 10 | 10 | Nicht Ausreichend
 |  | Muttern M6 |  |  | 2 |  |  |  | 20 | 20 | Nicht Ausreichend
 |  | Scheiben M3 7 mm |  |  | 3 |  |  |  | 30 | 30 | Nicht Ausreichend
 |  | Scheiben M4 15 mm |  |  | 20 |  |  |  | 200 | 200 | Nicht Ausreichend

Sheet: 3D-Druck
3D-Druck
 |  | Komponenten | Anzahl | Druckdauer | Fillament | Schrauben | Reifegrad | Schrauben zusätzlich* | Nutsteine | Unterlegscheiben** | Muttern
 | RoArm | VakuumpumpHolder | 1 |  |  | 2x M4 10mm |  |  | -
 |  | Vakuumgreifer | 1 |  |  | 2x M4 10mm ; 4x M3 | 100% |  | -
 |  | Verbindungsplatte RoArm | 1 |  |  | 4x M4 10mm |  |  | 4
 |  | VentHolder | 1 |  |  | 1x M4 10mm |  |  | -
 | Pneumatik | Regelungsventilhalter | 1 |  |  | 2x M4 10mm | 90% | 2x M6 35mm | 2 |  | 2x M6
 |  | Kompressorhalterung | 1 |  |  | 4x M4 Schwingungsdämpfer | 100% | 4x M5 Schwingungsdämpfer | 4 | 20x M4 15mm | 4x M4
 |  | Zylinderaufsatz | 1 |  |  | 2x M3 10mm | 100% |  | -
 |  | Zylinderhalterung | 1 |  |  | 2x M4 10mm | 90% | 1x M3 30mm | 2 | 1x M3 7mm | 1x M3
 |  | Befestigung Druckbehälter | 2 |  |  | 4x M4 10mm |  | 2x M7 20mm | 4
 | Sort | Separator | 1 |  |  | 8x M4 10mm |  |  | 8
 |  | Förderbandschlitten | 1 |  |  | - | 100% |  | -
 |  | SortierMechanismus | 1 |  |  | 6x M3 15mm ; 4x M2 5mm | 90% |  | - |  | 4x M2
 | Universal | Universal Bridge | 2 |  |  | 4x M4 10mm |  | 4x M3 10 mm ; 4x M4 10mm | 4 |  | 4x M3
 |  | Universal Side Holder | 2 |  |  | 4x M4 10mm | 100% | 2x M3 30 mm ; 2x M3 10 mm | 4 | 2x M3 7mm | 4x M3
 | Fahrstuhl | Befestigung Aufzug unten | 1 |  |  | 3x M4 10mm |  |  | 3
 |  | Trichter | 1 |  |  | - | 60% |  | -
 |  | Befestigung Aufzug oben | 1 |  |  | 2x M4 10mm |  |  | 2
 |  | Trichter Halterung | 1 |  |  | 1x M5 10mm | 60% | 2x M3 10 mm ; 2x M2 10mm | - |  | 1x M5
 |  |  |  |  |  |  |  |  |  |  | 2x M3
 |  | LED Mount | 2 |  |  | 2x M4 10mm | 80% |  | 2
 |  | Gesamt |  |  |  |  |  |  | 39
 |  |  |  |  |  |  |  | *Schrauben die nicht zur befestigung des 3D-Drucks dienen, sondern um Komponenten an diesem zu befestigen |  | **Länge gibt den Durchmesser an
