klaus-liebler/factory_in_a_box/pcb_factory_control_unit/jlcpcb/production_files/BOM-pcb_factory_control_unit.csv

Comment | Designator | Footprint | LCSC | Quantity
0 | R95,R96 | R_0805_2012Metric_Pad1.20x1.40mm_HandSolder | C17477 | 2
100m | R49,R50,R51,R52 | R_1206_3216Metric | C7467250 | 4
100u/50V | C45 | CP_Elec_8x10 | C178548 | 1
100uF | C64,C65 | CP_Elec_6.3x7.7 | C72478 | 2
10k | R10,R101,R102,R107,R11,R113,R114,R116,R118,R12,R14,R15,R16,R24,R33,R37,R38,R43,R47,R48,R54,R55,R57,R78,R79,R8,R81,R82,R9 | R_0402_1005Metric | C25744 | 29
10n | C19,C23,C24 | C_0402_1005Metric | C5137480 | 3
10p | C107,C113,C18,C20,C74,C75,C91,C92,C93,C94,C95,C96,C97,C98 | C_0402_1005Metric | C106199 | 14
10u | C110,C111,C25,C29,C30,C40,C67,C69 | C_0805_2012Metric | C6119889 | 8
10u | C102,C103,C104,C42,C44 | C_1210_3225Metric | C77102 | 5
10uH | L12,L3,L4 | L_Abracon_ASPI-0630LR | C475521 | 3
12k1 | R22,R83 | R_0402_1005Metric | C25852 | 2
1k | R1,R108,R13,R53,R58,R61,R62,R63,R64,R70,R71 | R_0402_1005Metric | C11702 | 11
1n5 | C112 | C_0402_1005Metric | C23967 | 1
1u | C14,C21,C4,C76,C79,C82,C87 | C_0402_1005Metric | C52923 | 7
1u/50V | C106,C33 | C_0805_2012Metric | C28323 | 2
220R@100M | L1,L10,L11,L2,L7,L8,L9 | L_0603_1608Metric | C80165 | 7
22k | R41 | R_0402_1005Metric | C25768 | 1
22n/50V | C100,C26,C56,C58,C99 | C_0402_1005Metric | C1532 | 5
22u | C36,C37,C38,C39,C43 | C_0805_2012Metric | C45783 | 5
22u/35V | C59,C60,C61,C62 | C_0805_2012Metric | C6119901 | 4
25MHz | Y1,Y2,Y3 | Crystal_SMD_2016-4Pin_2.0x1.6mm | C19711739 | 3
2m | R44 | R_1206_3216Metric | C844294 | 1
2u2 | C13,C15,C55,C57 | C_0402_1005Metric | C12530 | 4
330 | R103,R105,R28,R29,R97,R99 | R_0402_1005Metric | C25104 | 6
330k | R36,R40 | R_0402_1005Metric | C25778 | 2
33R | R17,R18,R19,R21 | R_0402_1005Metric | C25105 | 4
3k3 | R100,R20,R30,R80,R85,R86,R98 | R_0402_1005Metric | C25890 | 7
3u3 | L6 | L_0805_2012Metric | C162585 | 1
4.7uH | L5 | L_Bourns_SRP1245A | C212263 | 1
40N06D | Q1,Q10,Q4,Q5,Q6,Q7,Q8 | VSON-8_3.3x3.3mm_P0.65mm_NexFET | C7543836 | 7
47n | C108,C109 | C_0402_1005Metric | C307434 | 2
49R9 | R23,R25,R26,R27,R87,R88,R89,R90,R91,R92,R93,R94 | R_0402_1005Metric | C25120 | 12
4u7 | C11 | C_0402_1005Metric | C307423 | 1
56p | C34,C35 | C_0402_1005Metric | C107007 | 2
5k1 | R2,R3,R31,R39,R4,R42,R45,R46,R5,R6,R7,R84 | R_0402_1005Metric | C25905 | 12
74AHCT125 | U11 | SOIC-14_3.9x8.7mm_P1.27mm | C155176 | 1
82k | R109,R110 | R_0402_1005Metric | C4142 | 2
AMS1117-3.3 | U7 | SOT-223-3_TabPin2 | C6186 | 1
BSS138 | Q2 | SOT-23 | C82045 | 1
CH224A | U1 | Texas_DSQ0010A_WSON-10-1EP_2x2mm_P0.4mm_EP0.9x1.5mm_ThermalVias | C42459160 | 1
HR911105A_small | ETHERNET1,EthercatA1,EthercatB1 | RJ45_HANRUN_HR911105A | C12074 | 3
HX711 | U12 | SOIC-16_3.9x9.9mm_P1.27mm | C6705483 | 1
INA226 | U8 | TSSOP-10_3x3mm_P0.5mm | C49851 | 1
LAN8742A | U3 | VQFN-24-1EP_4x4mm_P0.5mm_EP2.5x2.5mm_ThermalVias | C621425 | 1
LAN9253 | U13 | QFN-64-1EP_9x9mm_P0.5mm_EP6x6mm_ThermalVias | C5745149 | 1
M1 | R106,R32,R34,R60,R65,R67,R69,R73,R75 | R_0402_1005Metric | C25741 | 9
MX26631DL | U14 | Texas_RGE0024H_VQFN-24-1EP_4x4mm_P0.5mm_EP2.7x2.7mm_ThermalVias | C18197523 | 1
Micro_SD_Card_Det1 | J3 | microSD push | C381082 | 1
NUP2105L | D18 | SOT-23 | C2976509 | 1
OFF TERM ON | SW3 | SW_SPDT_PCM12 | C221841 | 1
Push | SW1,SW2 | SW_SPST_TL3342_smaller | C318884 | 2
RED | D1,D12,D13,D16,D17,D4,D5,D6,D7 | LED_1206_3216Metric_ReverseMount_Hole1.8x2.4mm | C2827254 | 9
S8550 | Q9 | SOT-23 | C364313 | 1
SIT3051TK | U2 | DFN-8-1EP_3x3mm_P0.65mm_EP1.55x2.4mm | C601078 | 1
SMAJ28CA | D3 | D_SMA | C19077546 | 1
SS34 | D10,D11,D14,D15,D8,D9 | D_SMA | C8678 | 6
SS56C | D2 | D_SMC | C24138 | 1
STDC14 | J2 | IDC-Header_2x07_P1.27mm_Vertical_SMD | C6332251 | 1
STM32H743VITx | U17 | LQFP-100_14x14mm_P0.5mm | C114409 | 1
TMC2209 | U10,U9 | QFN-28-1EP_5x5mm_P0.5mm_EP3.75x3.75mm_ThermalVias | C2150710 | 2
TPS54202DDC | U4,U5 | SOT-23-6 | C191884 | 2
TPS55340 | U15 | WQFN-16-1EP_3x3mm_P0.5mm_EP1.68x1.68mm_ThermalVias | C169167 | 1
USB-C | J5,J6 | USB_C_Receptacle_HRO_TYPE-C-31-M-12_smaller | C165948 | 2
USBLC6-2SC6 | U16 | SOT-23-6 | C2687116 | 1
k1 | R35,R59,R66,R68,R72,R74,R76,R77 | R_0402_1005Metric | C25076 | 8
k12 | R115 | R_0805_2012Metric | C17437 | 1
n47 | C22,C78 | C_0402_1005Metric | C76971 | 2
u1 | C1,C12,C16,C17,C2,C3,C46,C49,C5,C50,C6,C63,C66,C68,C7,C70,C71,C72,C73,C77,C8,C80,C81,C83,C84,C85,C86,C88,C89,C9,C90 | C_0402_1005Metric | C1525 | 31
u1/16V | C31,C32,C41 | C_0402_1005Metric | C1525 | 3
u1/35 | C105 | C_0805_2012Metric | C49678 | 1
u1/35V | C27,C28,C51,C52,C53,C54 | C_0805_2012Metric | C49678 | 6
u1/50V | C47,C48 | C_0805_2012Metric | C49678 | 2
GND_ETH | R104 | R_0805_2012Metric_Pad1.20x1.40mm_HandSolder |  | 1
4n7/2k | C101 | C_0805_2012Metric_Pad1.18x1.45mm_HandSolder |  | 1
INB | J28 | JST_XH_B2B-XH-A_1x02_P2.50mm_Vertical |  | 1
Gpio1 | J30 | JST_XH_B3B-XH-A_1x03_P2.50mm_Vertical_smaller |  | 1
I2C1A | J9 | JST_XH_B5B-XH-A_1x05_P2.50mm_Vertical_smaller |  | 1
Vacuum Valve | J25 | JST_XH_B2B-XH-A_1x02_P2.50mm_Vertical |  | 1
Gpio2 | J31 | JST_XH_B3B-XH-A_1x03_P2.50mm_Vertical_smaller |  | 1
I2C3 | J7 | JST_XH_B5B-XH-A_1x05_P2.50mm_Vertical_smaller |  | 1
I2C1B | J8 | JST_XH_B5B-XH-A_1x05_P2.50mm_Vertical_smaller |  | 1
Conveyor | J23 | PhoenixContact_MC_1,5_2-G-3.5_1x02_P3.50mm_Horizontal_smallerCourtyard |  | 1
Elevator | J17 | JST_XH_B4B-XH-A_1x04_P2.50mm_Vertical_smaller |  | 1
RoArm | J20 | Molex_SPOX_5267-03A_1x03_P2.50mm_Vertical |  | 1
Malibotti | J16 | JST_XH_B4B-XH-A_1x04_P2.50mm_Vertical_smaller |  | 1
Disturbance1 | J26 | JST_XH_B2B-XH-A_1x02_P2.50mm_Vertical |  | 1
Weight | J29 | JST_XH_B4B-XH-A_1x04_P2.50mm_Vertical_smaller |  | 1
StepperUART | TP4 | TestPoint_THTPad_D1.0mm_Drill0.5mm |  | 1
I2C4 | IJ1 | JST_XH_B5B-XH-A_1x05_P2.50mm_Vertical_smaller |  | 1
UEXT | J15 | IDC-Header_2x05_P2.54mm_Vertical |  | 1
Cylinder Valve | J21 | JST_XH_B2B-XH-A_1x02_P2.50mm_Vertical |  | 1
DC IN | J4 | BarrelJack_Horizontal |  | 1
PressureSns | J14 | JST_XH_B3B-XH-A_1x03_P2.50mm_Vertical_smaller |  | 1
WS2812_CH1 | J10 | JST_XH_B3B-XH-A_1x03_P2.50mm_Vertical_smaller |  | 1
WS2812_CH2 | J11 | JST_XH_B3B-XH-A_1x03_P2.50mm_Vertical_smaller |  | 1
Vacuum Pump | J19 | JST_XH_B3B-XH-A_1x03_P2.50mm_Vertical_smaller |  | 1
Disturbance2 | J27 | JST_XH_B2B-XH-A_1x02_P2.50mm_Vertical |  | 1
RoArm | J22 | JST_XH_B4B-XH-A_1x04_P2.50mm_Vertical_smaller |  | 1
Compressor | J24 | PhoenixContact_MC_1,5_2-G-3.5_1x02_P3.50mm_Horizontal_smallerCourtyard |  | 1
Sorter | J18 | JST_XH_B4B-XH-A_1x04_P2.50mm_Vertical_smaller |  | 1
LightBar2 | J13 | JST_XH_B3B-XH-A_1x03_P2.50mm_Vertical_smaller |  | 1
LightBar1 | J12 | JST_XH_B3B-XH-A_1x03_P2.50mm_Vertical_smaller |  | 1
CAN-Bus | J1 | JST_XH_B3B-XH-A_1x03_P2.50mm_Vertical_smaller |  | 1
