klaus-liebler/factory_in_a_box/Budgetplanung.xlsx

Bauteil | Preis
Roboter | 280
Förderband | 60
Aufzug | 40
Sortierer | 25
Factory Control Board | 60
Stecker Buchsen für FCB | 20
Aluprofile | 50
Kleinteile | 10
3D-Druck | 20
Kompressor | 25
Vakuumpumpe | 15
Druckbehälter | 30
Zylinder | 10
Ventile | 20
Schlauch | 5
Lichtschranke | 10
Distanzsensoren | 10
Lichtschranken am Fallschacht | 10
Kleinteilepauschale | 50
