klaus-liebler/factory_in_a_box/first_concept_prototype/Models-3D/Separador con cosito Assembly.stp

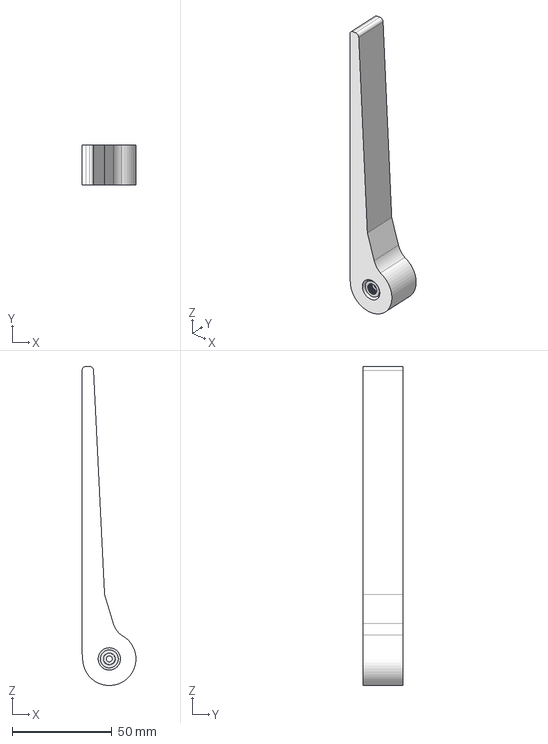
[picture p5: CAD file, 2025-12-14]
first_concept_prototype/Models-3D/Separador con cosito Assembly.stp
27.0 x 20.0 x 159.9 mm
Separador
arm_2pad
