klaus-liebler/factory_in_a_box/first_concept_prototype/Models-3D/Assembly.stp

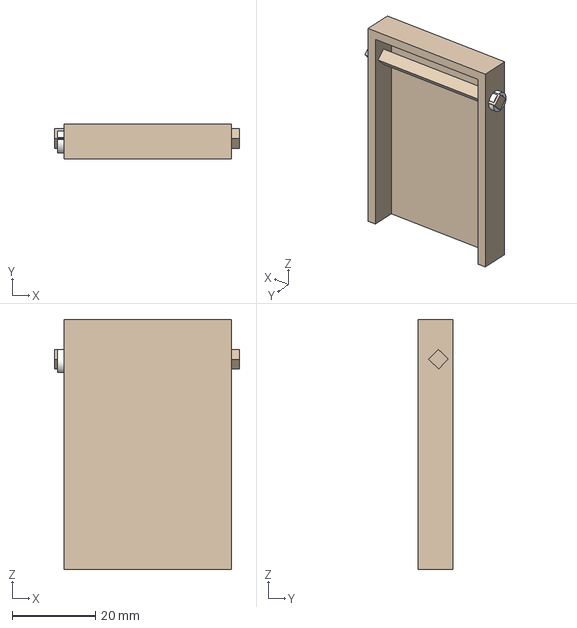
[picture p6: CAD file, 2025-12-14]
first_concept_prototype/Models-3D/Assembly.stp
44.5 x 8.50 x 60.0 mm
Rampa Separador
Parte del servo
