klaus-liebler/factory_in_a_box/component_3d_models/20X20 - T-slot - Aluminium Profile.iges

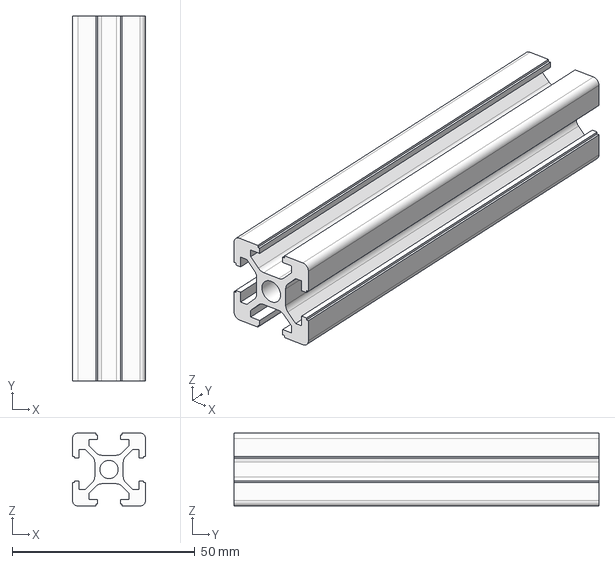
[picture p7: CAD file, 2025-12-14]
component_3d_models/20X20 - T-slot - Aluminium Profile.iges
20.0 x 100.0 x 20.0 mm
