klaus-liebler/factory_in_a_box/firmware_factory_control_unit/web/tools/roarm-meshes/source-assets/meshes/roarm_m3/link5.stl

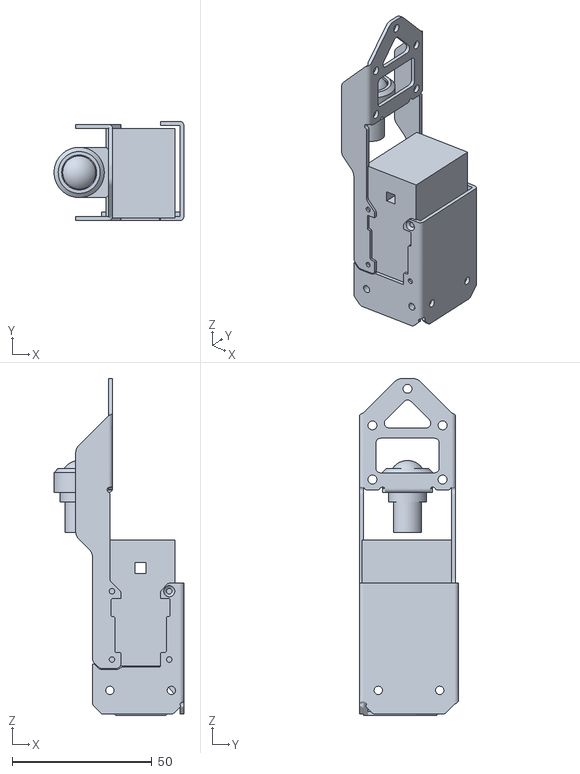
[picture p8: CAD file, 2026-08-25]
firmware_factory_control_unit/web/tools/roarm-meshes/source-assets/meshes/roarm_m3/link5.stl
46.5 x 35.5 x 120.6
