klaus-liebler/factory_in_a_box/first_concept_prototype/Models-3D/Tarjeta.stp

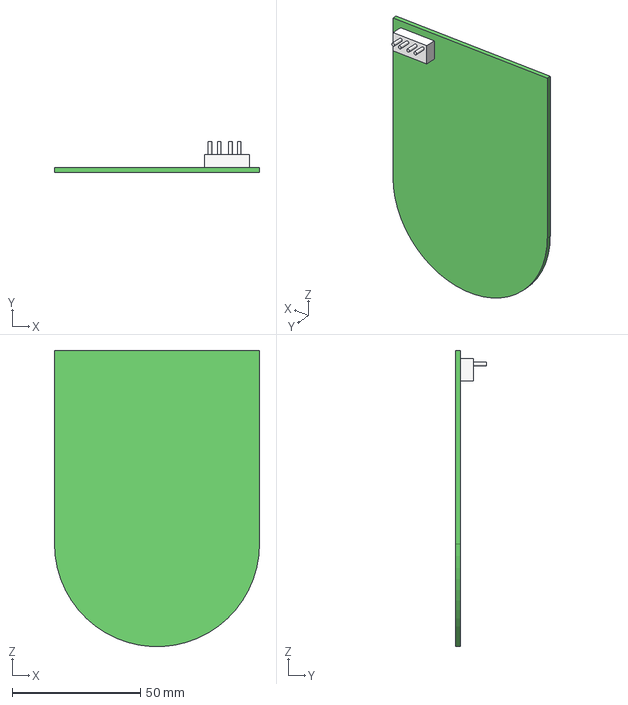
[picture p9: CAD file, 2025-12-14]
first_concept_prototype/Models-3D/Tarjeta.stp
80.0 x 12.0 x 115.5 mm
