klaus-liebler/factory_in_a_box/component_3d_models/item_44804_profil-5-20x20-natur-448_3000_front_high.dxf

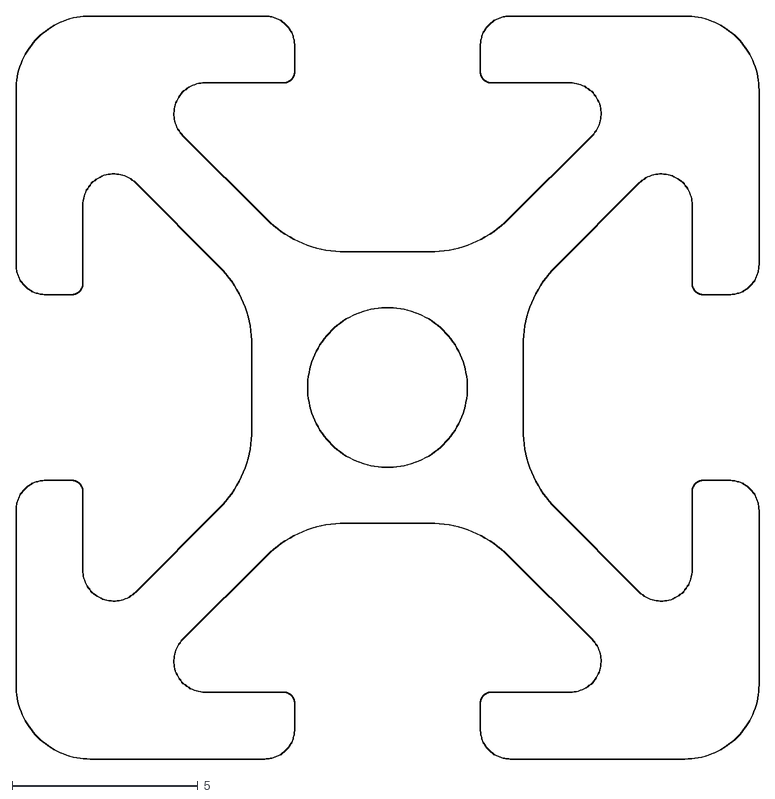
[picture p10: CAD file, 2025-12-14]
component_3d_models/item_44804_profil-5-20x20-natur-448_3000_front_high.dxf
20.0 x 20.0
