klaus-liebler/factory_in_a_box/firmware_factory_control_unit/web/tools/roarm-meshes/source-assets/meshes/roarm_m3/gripper_link.stl

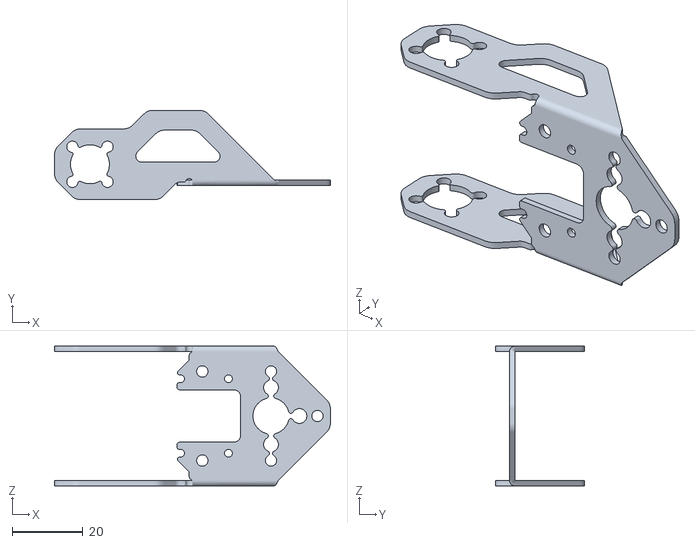
[picture p11: CAD file, 2026-08-25]
firmware_factory_control_unit/web/tools/roarm-meshes/source-assets/meshes/roarm_m3/gripper_link.stl
77.9 x 25.2 x 39.4
