klaus-liebler/factory_in_a_box/first_concept_prototype/Models-3D/BeltConvenyor.stp

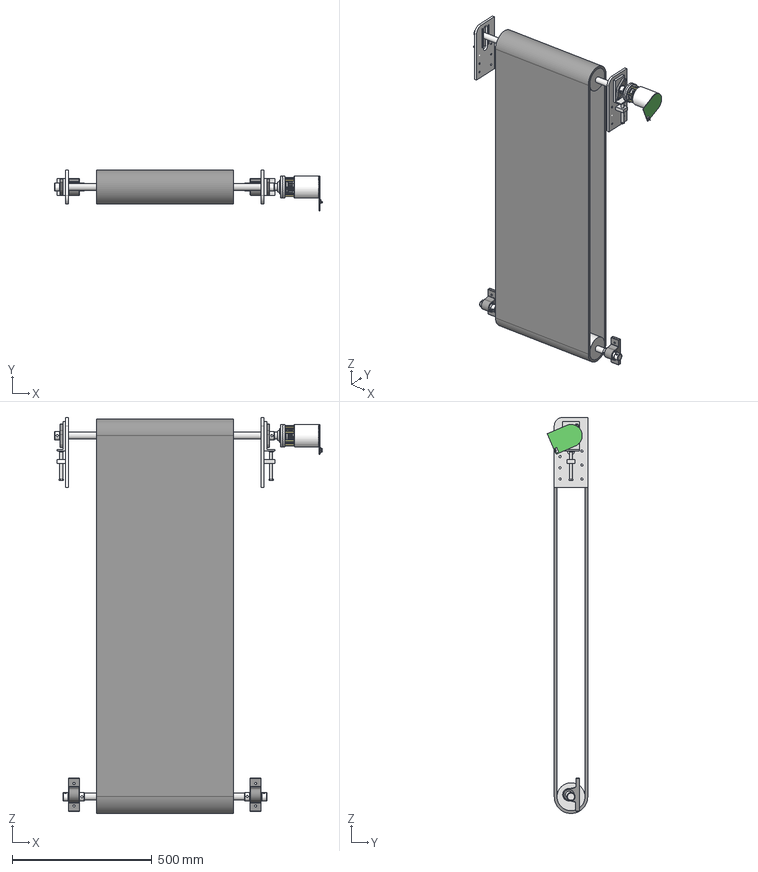
[picture p12: CAD file, 2025-12-14]
first_concept_prototype/Models-3D/BeltConvenyor.stp
958.9 x 145.2 x 1416.2 mm
RulmanYataklama x 2
Tahrik tamburu
MilYüzüğü x 6
GerdirmeMekanizması
Gergi-Mek-Rulman
Gerdirme-Mesnet x 2
Gewindeschaft x 2
Gerdirme-Mek-Sol_1
Gerdirme-plaka2
Tahrik-Tamburu
MİL-redüktor
Flanş-1
Flanş-2
Belt
Rehber-Plaka x 2
Gear
Palitos x 6
Parte de afuera
Tarjeta
