klaus-liebler/factory_in_a_box/component_3d_models/Eurobox 80 x 60 x 22.STEP

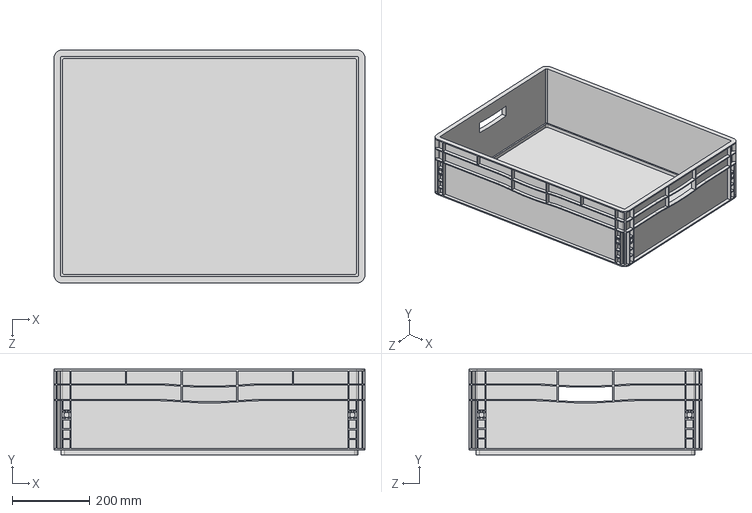
[picture p13: CAD file, 2025-12-14]
component_3d_models/Eurobox 80 x 60 x 22.STEP
800.0 x 220.0 x 600.0 mm
