klaus-liebler/factory_in_a_box/firmware_factory_control_unit/web/tools/roarm-meshes/source-assets/meshes/roarm_m3/base_link.stl

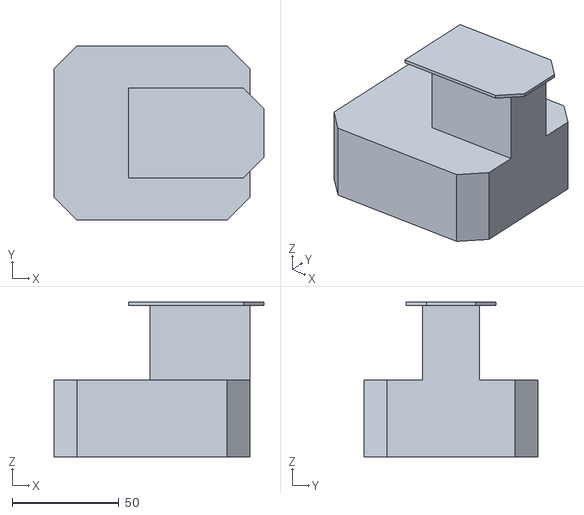
[picture p14: CAD file, 2026-08-25]
firmware_factory_control_unit/web/tools/roarm-meshes/source-assets/meshes/roarm_m3/base_link.stl
98.5 x 81.6 x 72.6
