klaus-liebler/factory_in_a_box/first_concept_prototype/Models-3D/Soporte elevador.stp

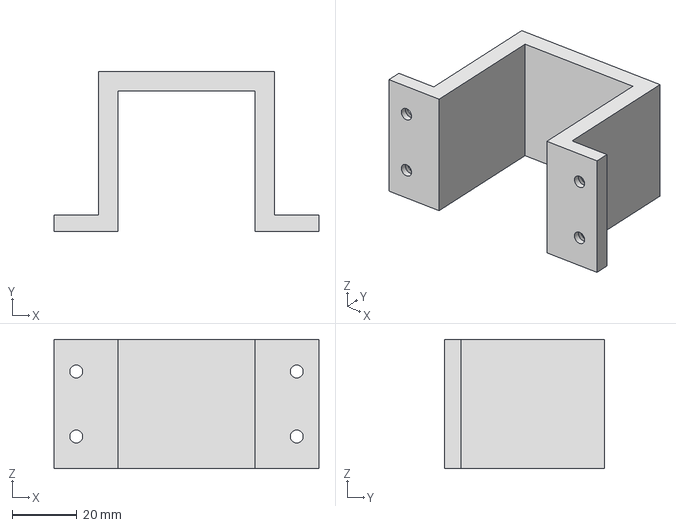
[picture p15: CAD file, 2025-12-14]
first_concept_prototype/Models-3D/Soporte elevador.stp
82.0 x 49.4 x 40.0 mm
