klaus-liebler/factory_in_a_box/component_3d_models/LinearAxis Stepper 100mm .stp

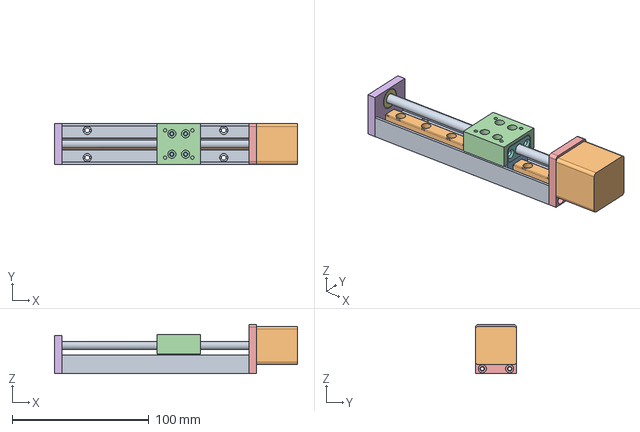
[picture p16: CAD file, 2025-12-14]
component_3d_models/LinearAxis Stepper 100mm .stp
178.0 x 30.0 x 36.0 mm
