klaus-liebler/factory_in_a_box/firmware_factory_control_unit/web/tools/roarm-meshes/source-assets/meshes/roarm_m3/link1.stl

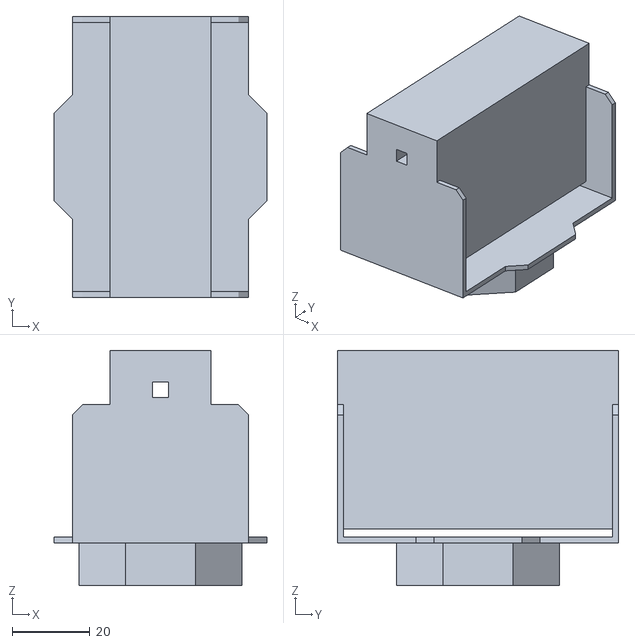
[picture p17: CAD file, 2026-08-25]
firmware_factory_control_unit/web/tools/roarm-meshes/source-assets/meshes/roarm_m3/link1.stl
54.8 x 72.4 x 60.6
