klaus-liebler/factory_in_a_box/firmware_factory_control_unit/web/tools/roarm-meshes/source-assets/meshes/roarm_m3/link4.stl

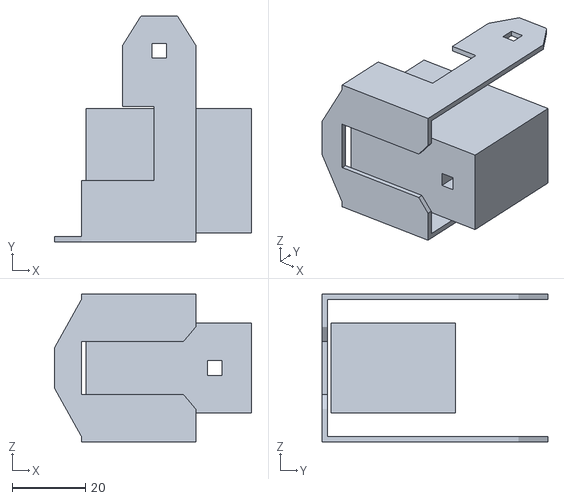
[picture p18: CAD file, 2026-08-25]
firmware_factory_control_unit/web/tools/roarm-meshes/source-assets/meshes/roarm_m3/link4.stl
53.9 x 61.8 x 40.4
