klaus-liebler/factory_in_a_box/first_concept_prototype/Models-3D/Tornillo.stp

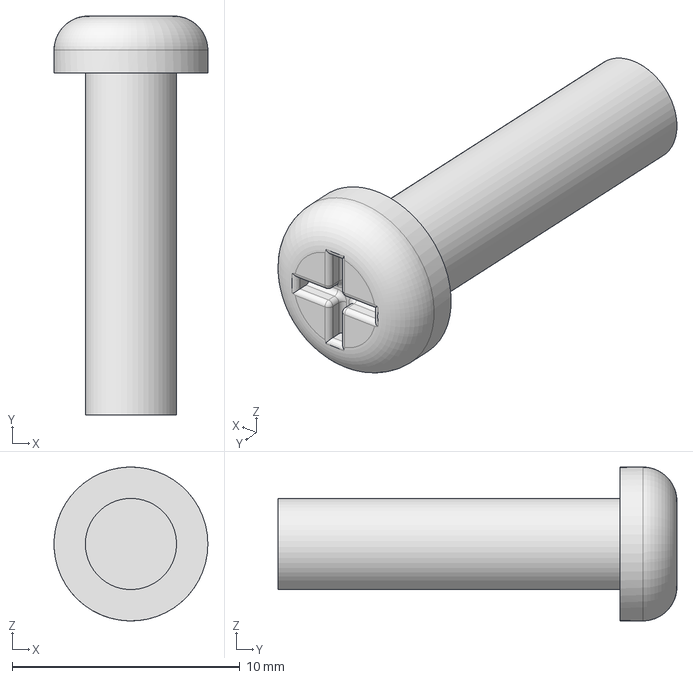
[picture p19: CAD file, 2025-12-14]
first_concept_prototype/Models-3D/Tornillo.stp
6.75 x 17.5 x 6.75 mm
