klaus-liebler/factory_in_a_box/first_concept_prototype/Models-3D/Parte1 Soporte sensor.stp

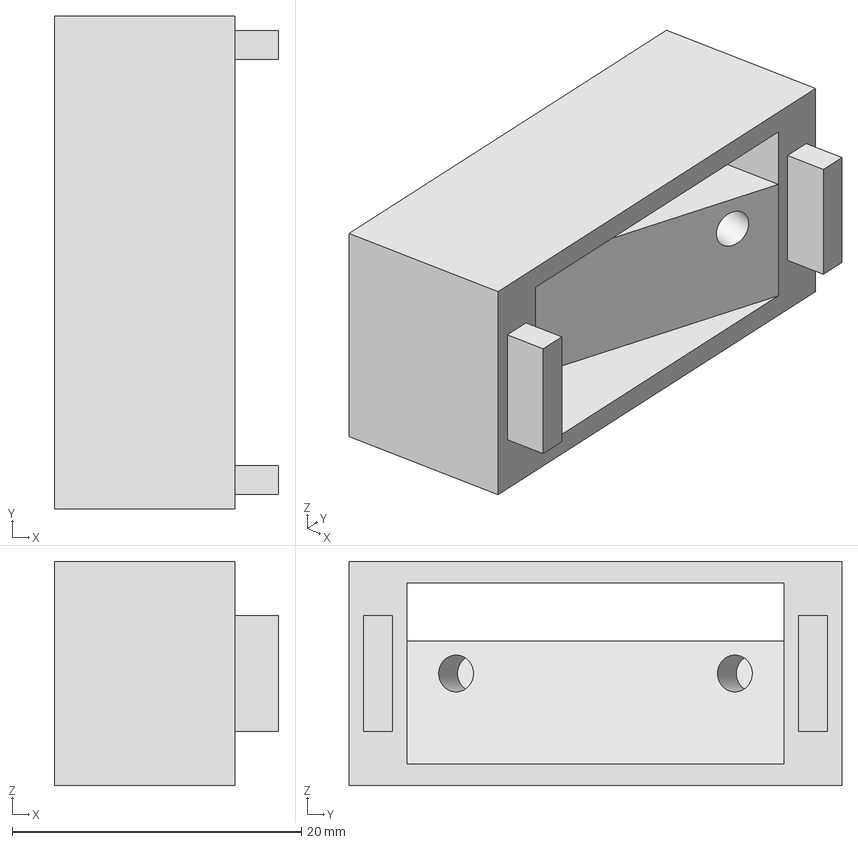
[picture p21: CAD file, 2025-12-14]
first_concept_prototype/Models-3D/Parte1 Soporte sensor.stp
15.5 x 34.1 x 15.5 mm
