klaus-liebler/factory_in_a_box/first_concept_prototype/Models-3D/Rampa de arriba.stp

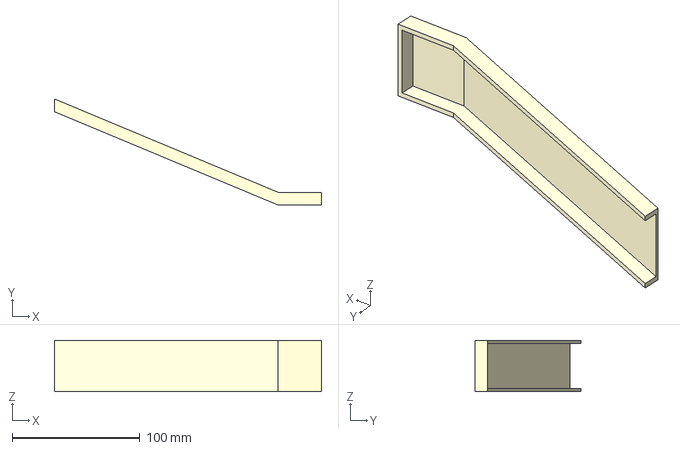
[picture p23: CAD file, 2025-12-14]
first_concept_prototype/Models-3D/Rampa de arriba.stp
208.9 x 83.0 x 40.1 mm
