klaus-liebler/factory_in_a_box/first_concept_prototype/Models-3D/Soporte 1 Elevador.stp

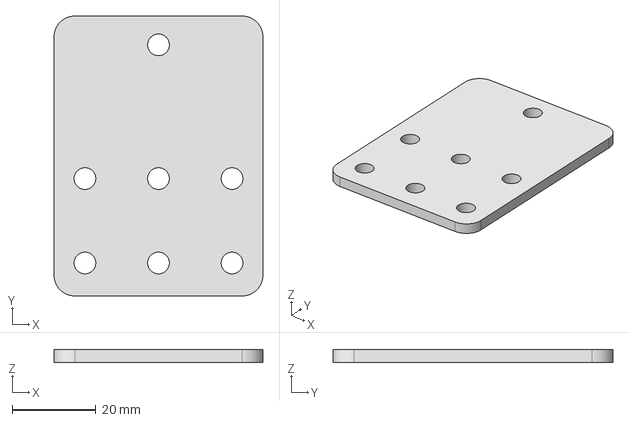
[picture p24: CAD file, 2025-12-14]
first_concept_prototype/Models-3D/Soporte 1 Elevador.stp
50.0 x 67.0 x 3.00 mm
