klaus-liebler/factory_in_a_box/first_concept_prototype/Models-3D/Rampa V4.stp

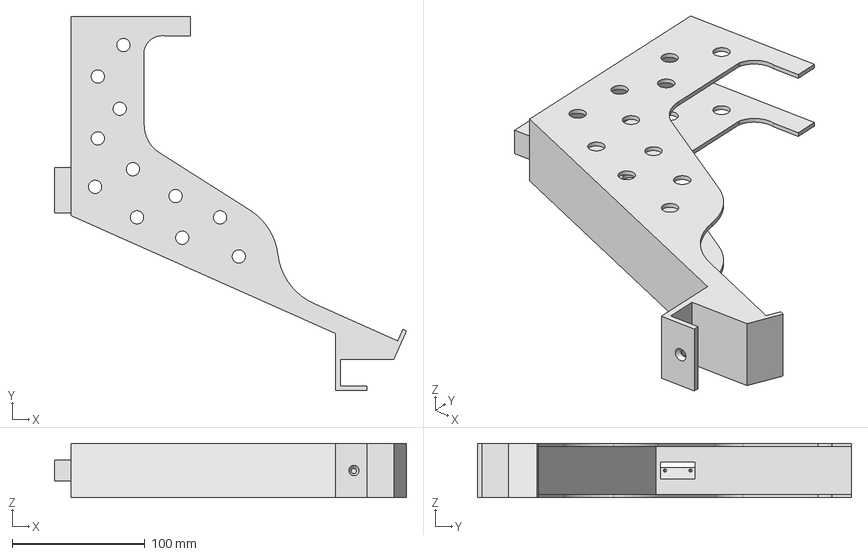
[picture p25: CAD file, 2025-12-14]
first_concept_prototype/Models-3D/Rampa V4.stp
264.8 x 281.7 x 41.0 mm
