klaus-liebler/factory_in_a_box/first_concept_prototype/Models-3D/Parte del servo.stp

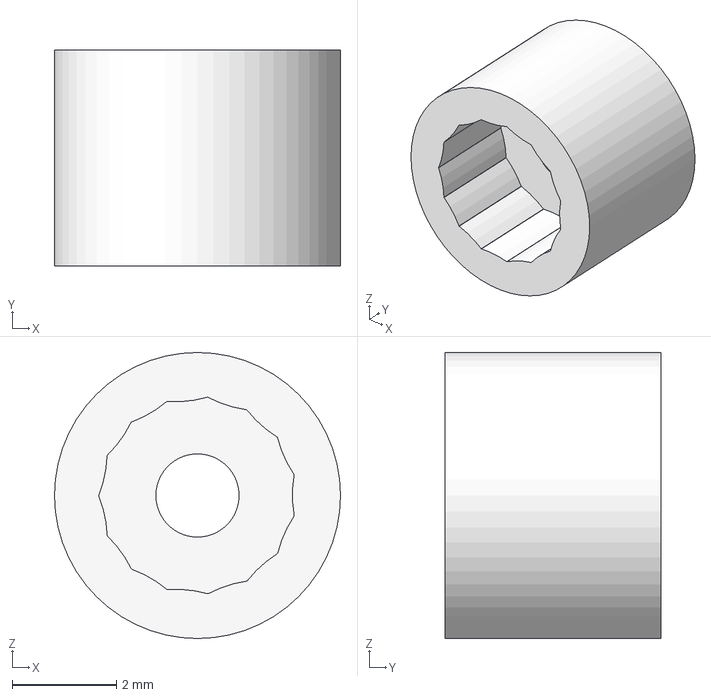
[picture p26: CAD file, 2025-12-14]
first_concept_prototype/Models-3D/Parte del servo.stp
5.50 x 4.15 x 5.50 mm
