klaus-liebler/factory_in_a_box/first_concept_prototype/Models-3D/Profile42-6cm.stp

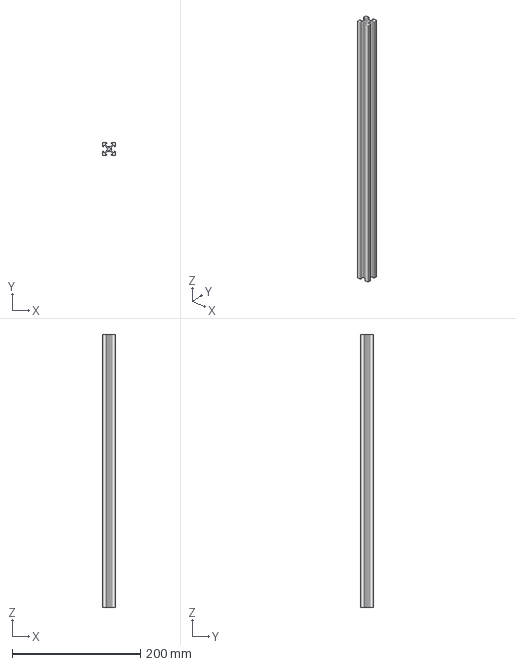
[picture p27: CAD file, 2025-12-14]
first_concept_prototype/Models-3D/Profile42-6cm.stp
20.0 x 20.0 x 426.0 mm
