klaus-liebler/factory_in_a_box/first_concept_prototype/Models-3D/dge_25a_tb_eg_100_lf_01.stp

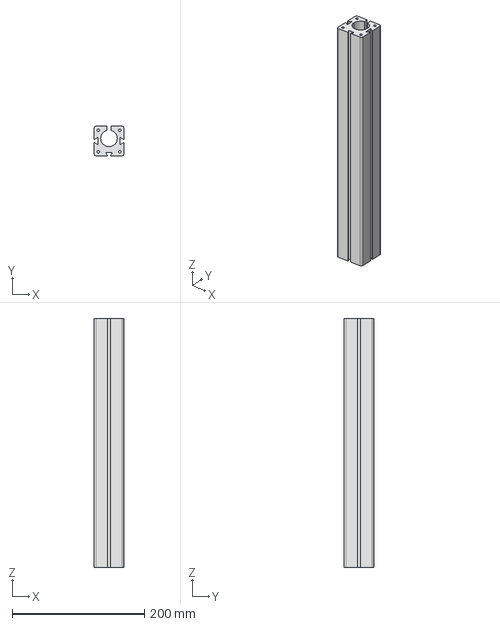
[picture p28: CAD file, 2025-12-14]
first_concept_prototype/Models-3D/dge_25a_tb_eg_100_lf_01.stp
45.0 x 45.0 x 376.0 mm
