klaus-liebler/factory_in_a_box/first_concept_prototype/Models-3D/dge_25a_tb_eg_100_lf_05.stp

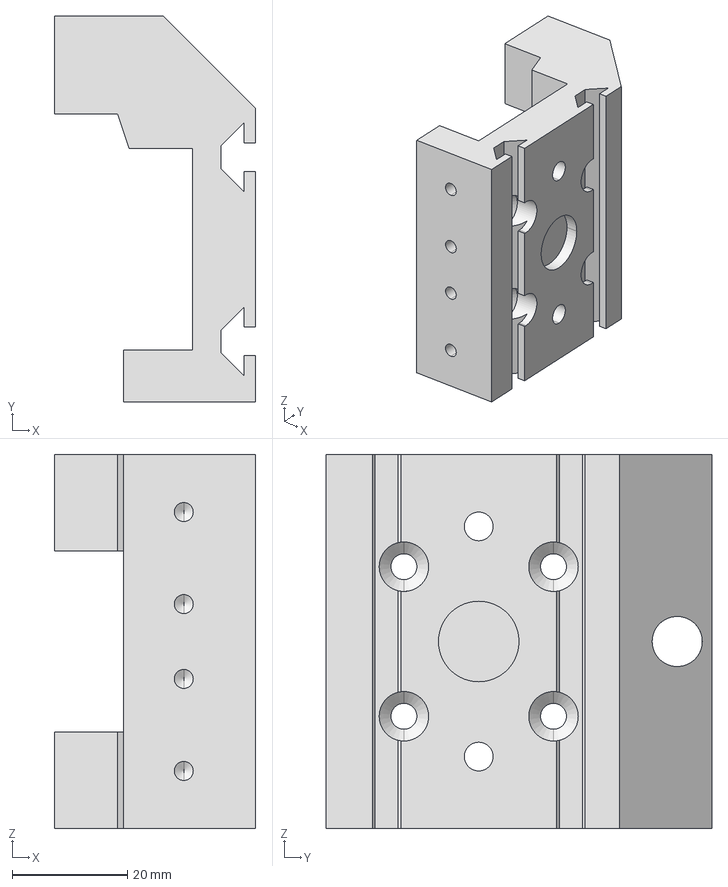
[picture p29: CAD file, 2025-12-14]
first_concept_prototype/Models-3D/dge_25a_tb_eg_100_lf_05.stp
35.0 x 67.0 x 65.0 mm
