klaus-liebler/factory_in_a_box/first_concept_prototype/Models-3D/dge_25a_tb_eg_100_lf_10.stp

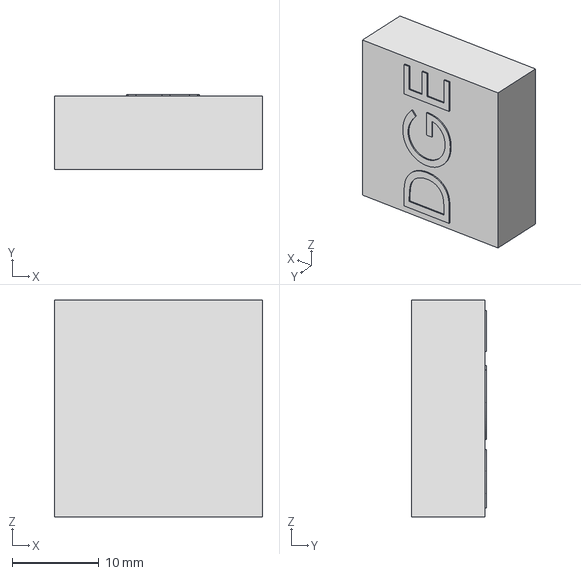
[picture p30: CAD file, 2025-12-14]
first_concept_prototype/Models-3D/dge_25a_tb_eg_100_lf_10.stp
24.0 x 8.70 x 25.0 mm
