klaus-liebler/factory_in_a_box/first_concept_prototype/Models-3D/Color Sensor Module.stp

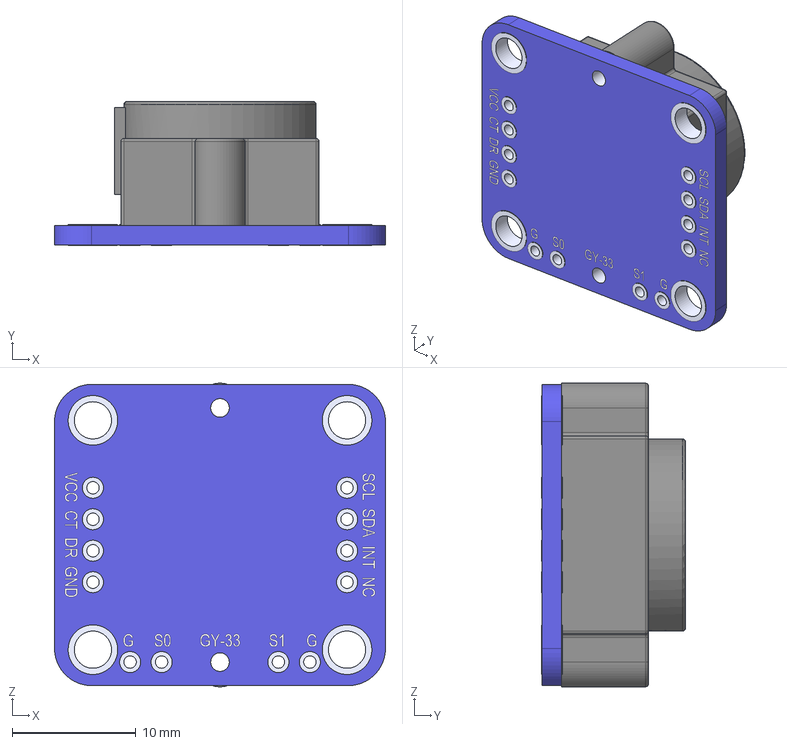
[picture p32: CAD file, 2025-12-14]
first_concept_prototype/Models-3D/Color Sensor Module.stp
26.7 x 11.7 x 24.5 mm
