klaus-liebler/factory_in_a_box/first_concept_prototype/Models-3D/Separador Largo.stp

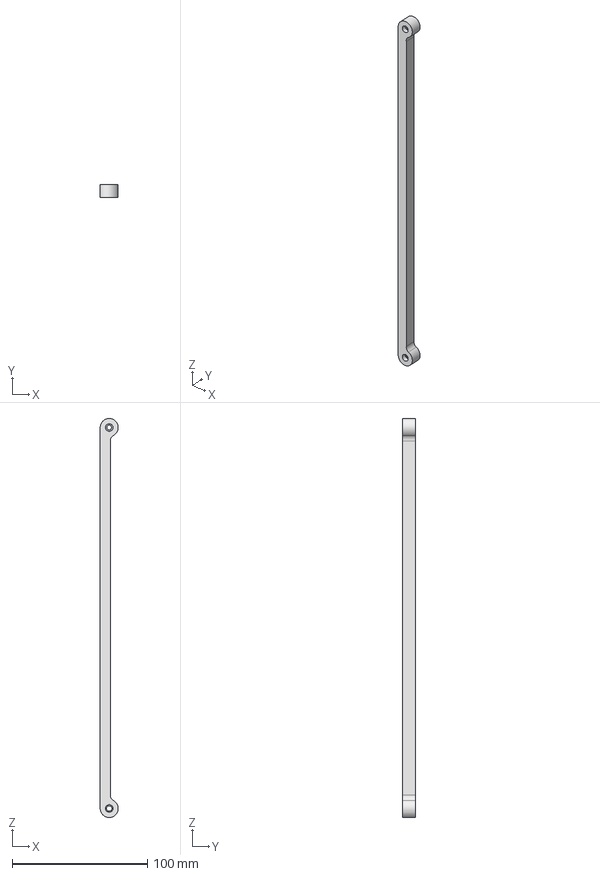
[picture p33: CAD file, 2025-12-14]
first_concept_prototype/Models-3D/Separador Largo.stp
13.7 x 9.43 x 295.0 mm
