klaus-liebler/factory_in_a_box/first_concept_prototype/Models-3D/Conveyor V2.stp

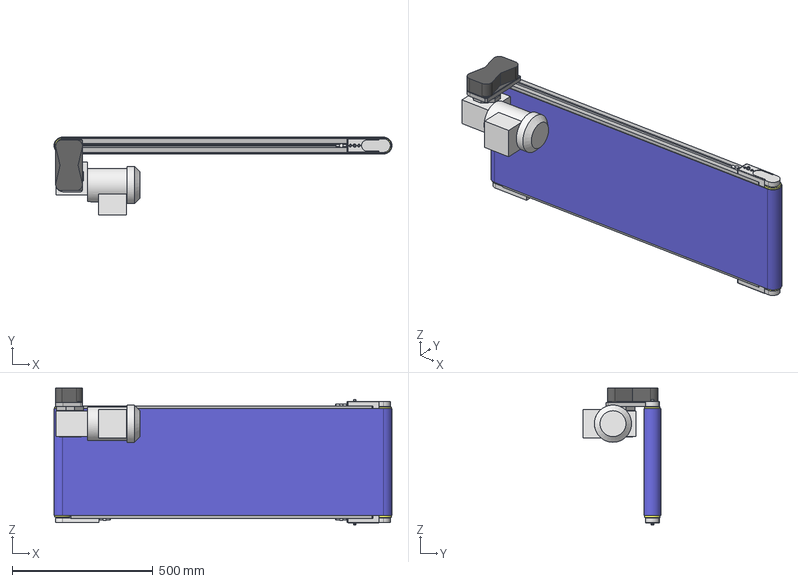
[picture p34: CAD file, 2025-12-14]
first_concept_prototype/Models-3D/Conveyor V2.stp
1200.0 x 276.0 x 485.1 mm
ñò³ë
êðîíøòåéí
âàë
êðîíøòåéí_1
M8x40 x 3
ñóõàð x 3
Ì6õ12 x 8
ñòð³÷êà
ðåäóêòîð
äâèãóí
êðèøêà
âàë_1
êðîíøòåéí_2 x 2
åêðàí x 2
øàéáà 6 x 2
ïëàñòèíà
