klaus-liebler/factory_in_a_box/first_concept_prototype/Models-3D/Palitos.stp

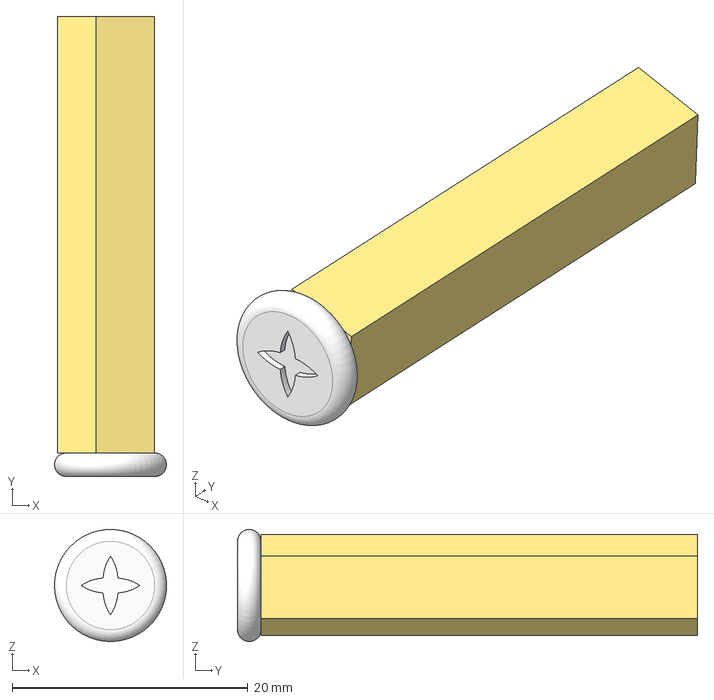
[picture p35: CAD file, 2025-12-14]
first_concept_prototype/Models-3D/Palitos.stp
9.50 x 39.0 x 9.50 mm
