klaus-liebler/factory_in_a_box/first_concept_prototype/Models-3D/Little green box.stp

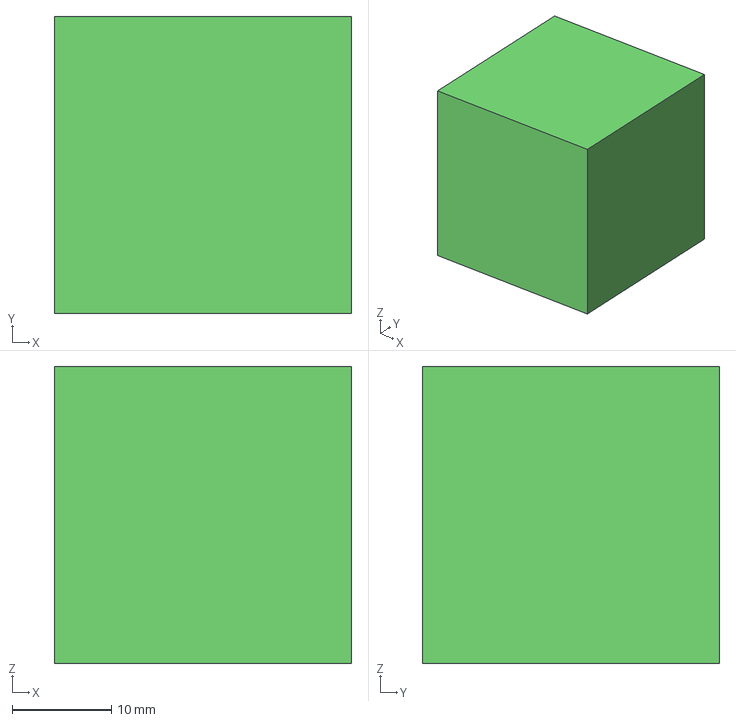
[picture p36: CAD file, 2025-12-14]
first_concept_prototype/Models-3D/Little green box.stp
30.0 x 30.0 x 30.0 mm
