klaus-liebler/factory_in_a_box/first_concept_prototype/Models-3D/Pieza ascensor.stp

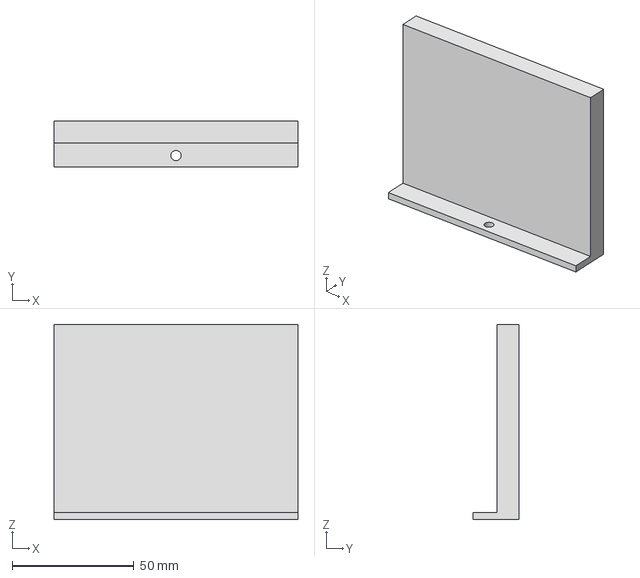
[picture p37: CAD file, 2025-12-14]
first_concept_prototype/Models-3D/Pieza ascensor.stp
100.0 x 19.0 x 80.0 mm
