klaus-liebler/factory_in_a_box/first_concept_prototype/Models-3D/Gear.stp

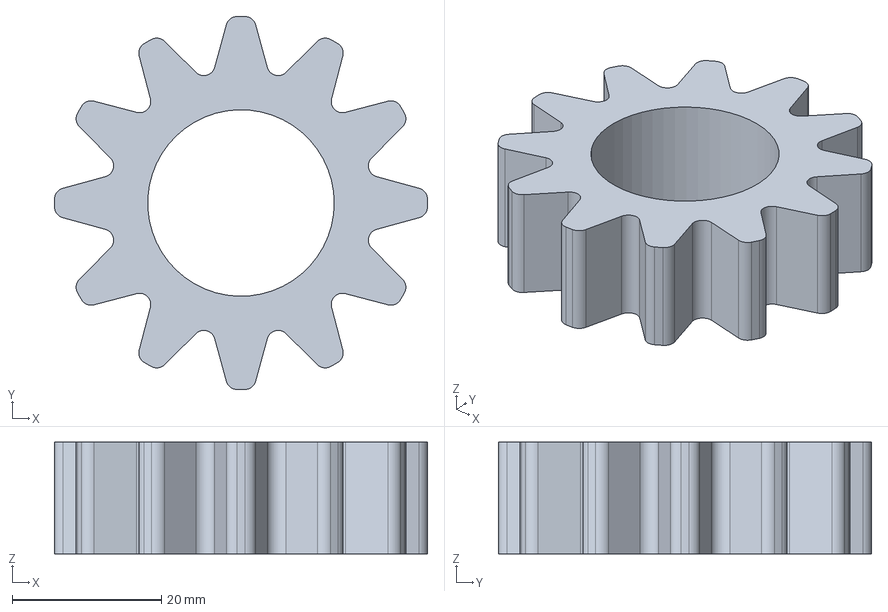
[picture p38: CAD file, 2025-12-14]
first_concept_prototype/Models-3D/Gear.stp
50.0 x 50.0 x 15.0 mm
