klaus-liebler/factory_in_a_box/first_concept_prototype/Models-3D/Profile16-5cm.stp

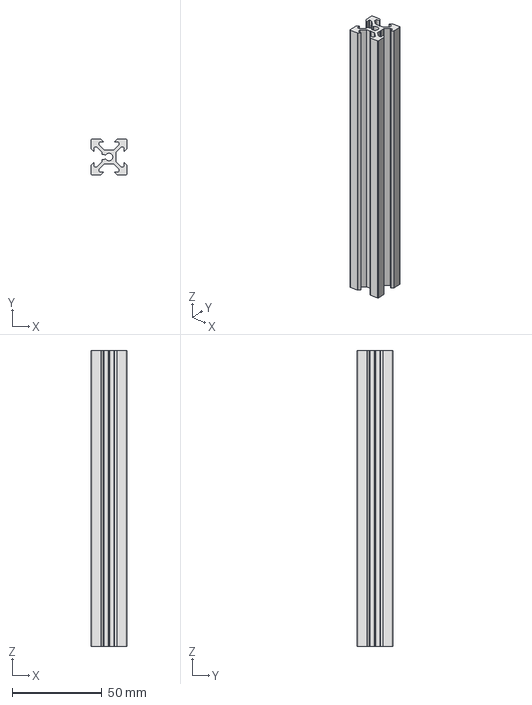
[picture p39: CAD file, 2025-12-14]
first_concept_prototype/Models-3D/Profile16-5cm.stp
20.0 x 20.0 x 165.0 mm
