klaus-liebler/factory_in_a_box/first_concept_prototype/Models-3D/Soporte Servo.stp

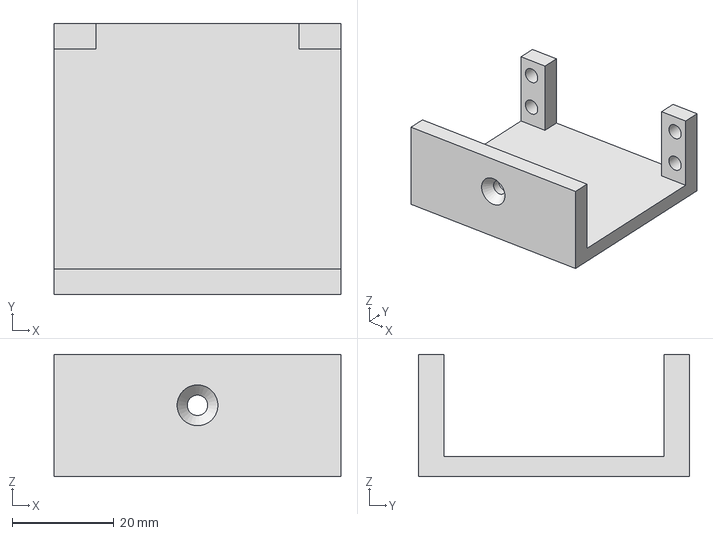
[picture p40: CAD file, 2025-12-14]
first_concept_prototype/Models-3D/Soporte Servo.stp
56.3 x 53.2 x 24.0 mm
