klaus-liebler/factory_in_a_box/first_concept_prototype/Models-3D/Elevador cosa.stp

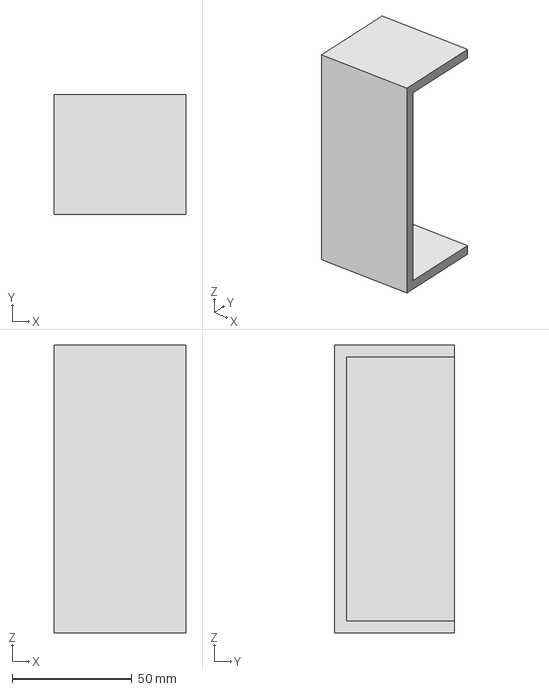
[picture p41: CAD file, 2025-12-14]
first_concept_prototype/Models-3D/Elevador cosa.stp
55.0 x 50.0 x 120.0 mm
