klaus-liebler/factory_in_a_box/first_concept_prototype/Models-3D/Box.stp

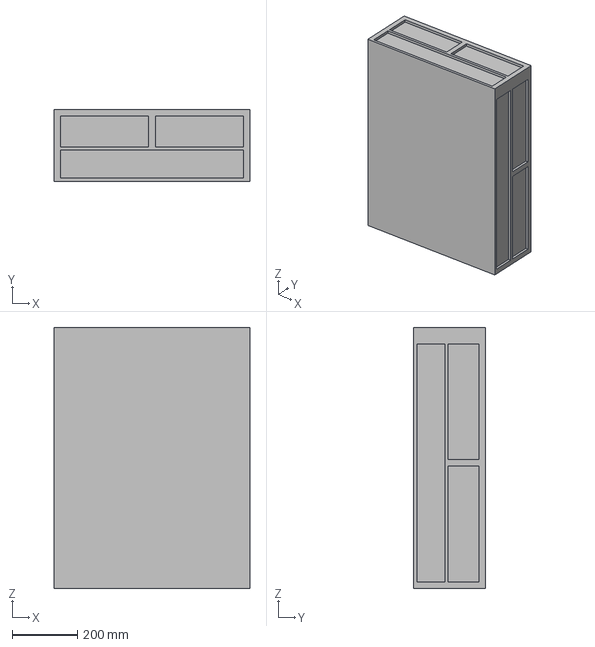
[picture p42: CAD file, 2025-12-14]
first_concept_prototype/Models-3D/Box.stp
600.0 x 220.0 x 800.0 mm
