klaus-liebler/factory_in_a_box/first_concept_prototype/Models-3D/Parte de afuera.stp

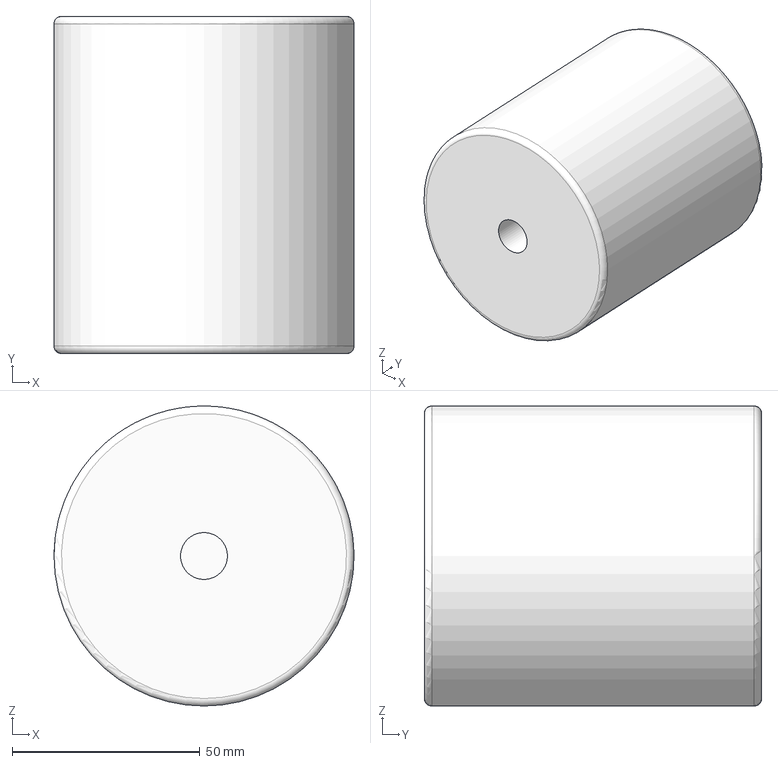
[picture p44: CAD file, 2025-12-14]
first_concept_prototype/Models-3D/Parte de afuera.stp
80.0 x 90.0 x 80.0 mm
