klaus-liebler/factory_in_a_box/first_concept_prototype/Models-3D/dge_25a_tb_eg_100_lf_09.stp

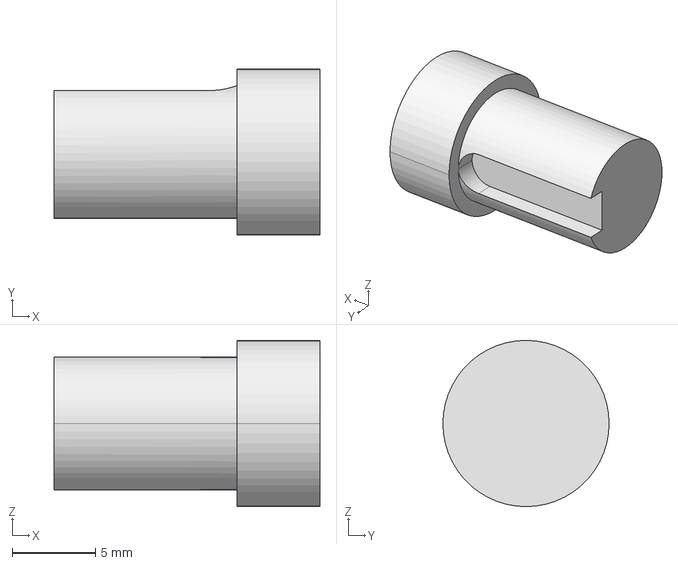
[picture p45: CAD file, 2025-12-14]
first_concept_prototype/Models-3D/dge_25a_tb_eg_100_lf_09.stp
16.0 x 10.0 x 10.0 mm
