klaus-liebler/factory_in_a_box/first_concept_prototype/Models-3D/Soporte Separadores.stp

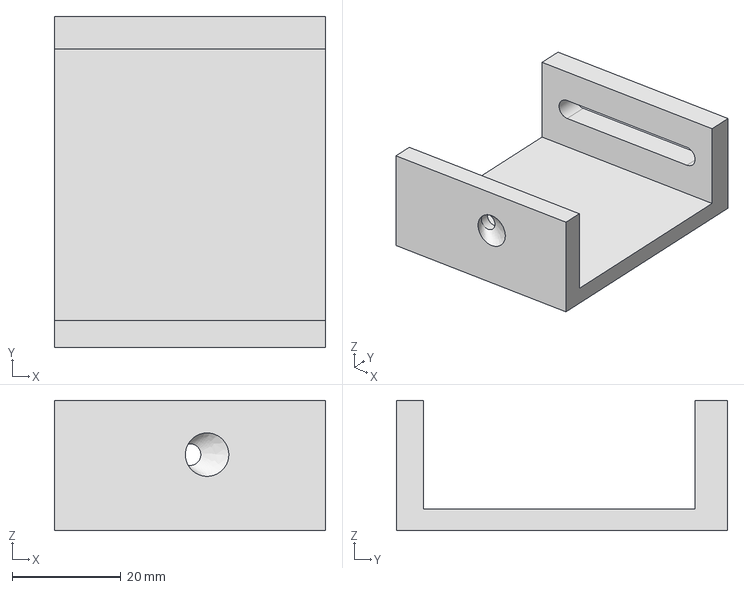
[picture p46: CAD file, 2025-12-14]
first_concept_prototype/Models-3D/Soporte Separadores.stp
50.0 x 61.0 x 24.0 mm
