klaus-liebler/factory_in_a_box/first_concept_prototype/Models-3D/Convenyor Belt.stp

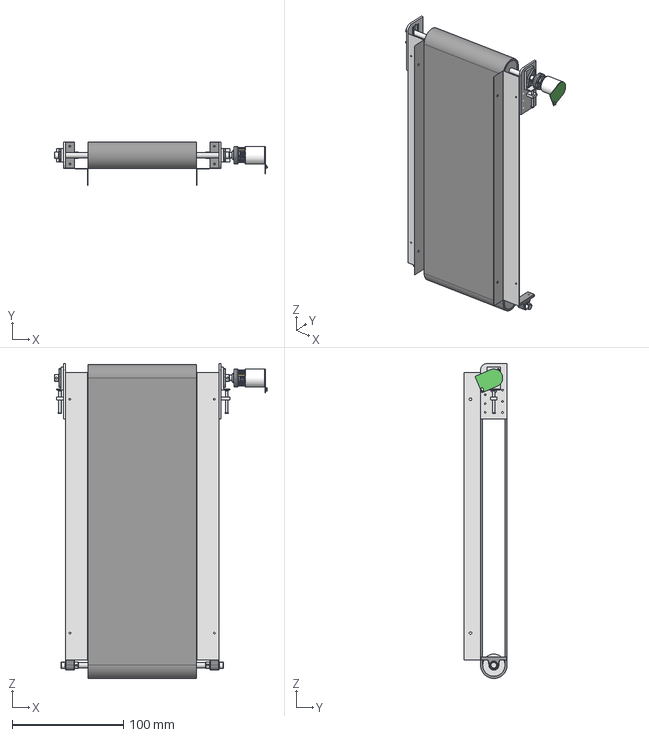
[picture p48: CAD file, 2025-12-14]
first_concept_prototype/Models-3D/Convenyor Belt.stp
191.8 x 39.0 x 283.2 mm
