klaus-liebler/factory_in_a_box/first_concept_prototype/Models-3D/Soporte Sensor de color.stp

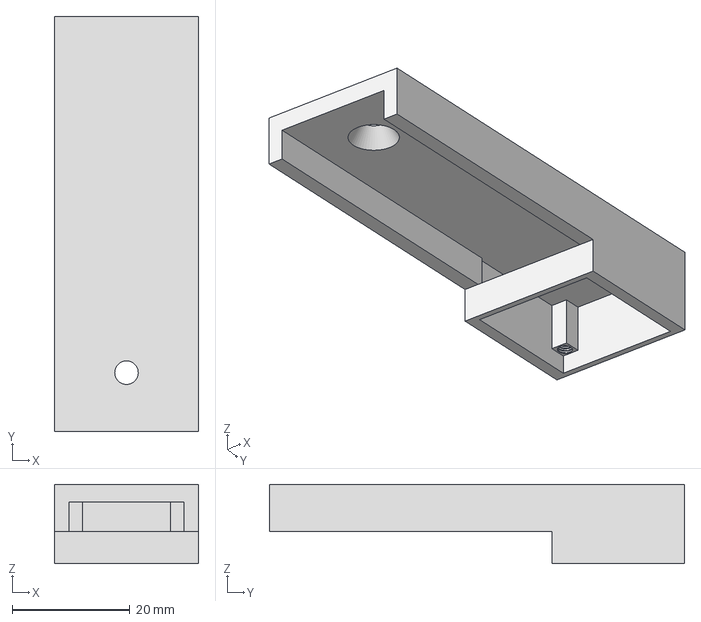
[picture p49: CAD file, 2025-12-14]
first_concept_prototype/Models-3D/Soporte Sensor de color.stp
24.5 x 70.5 x 13.5 mm
