klaus-liebler/factory_in_a_box/first_concept_prototype/Models-3D/Separador Largo 280mm.stp

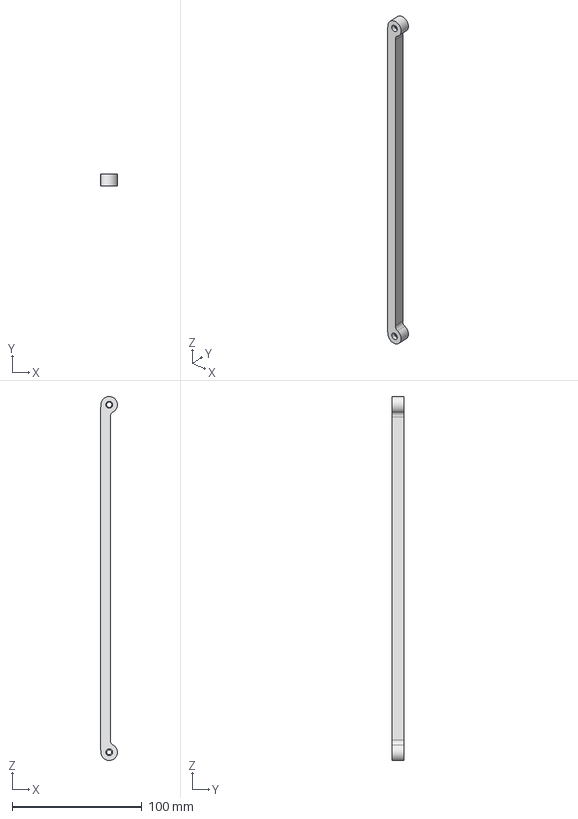
[picture p50: CAD file, 2025-12-14]
first_concept_prototype/Models-3D/Separador Largo 280mm.stp
13.0 x 8.95 x 280.0 mm
