klaus-liebler/factory_in_a_box/first_concept_prototype/Models-3D/DibujoSeparadorUnico.dxf

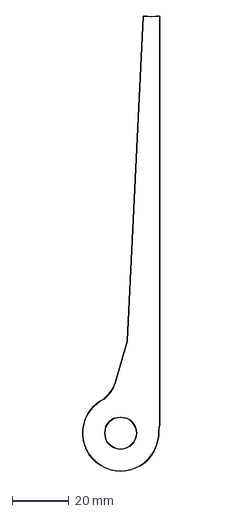
[picture p52: CAD file, 2025-12-14]
first_concept_prototype/Models-3D/DibujoSeparadorUnico.dxf
27.8 x 160.8 mm
