klaus-liebler/factory_in_a_box/first_concept_prototype/Models-3D/Parte 3 - Pared 1.stp

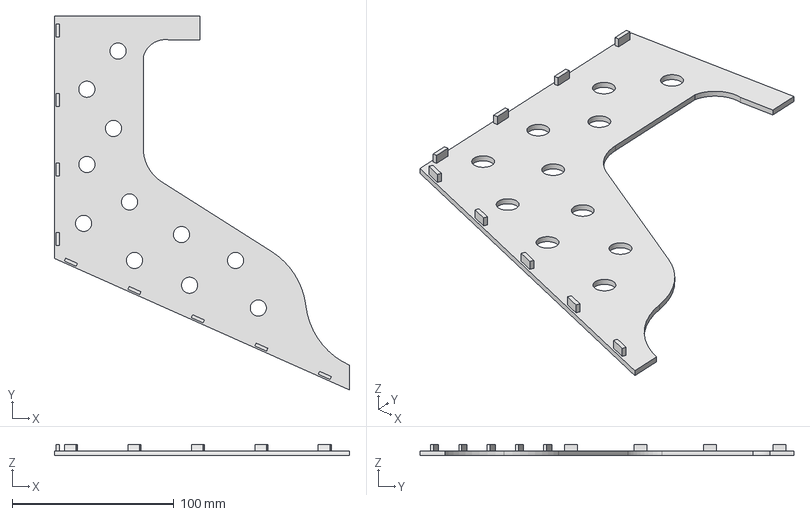
[picture p54: CAD file, 2025-12-14]
first_concept_prototype/Models-3D/Parte 3 - Pared 1.stp
182.6 x 231.4 x 6.50 mm
