klaus-liebler/factory_in_a_box/first_concept_prototype/Models-3D/Robot Arm.stp

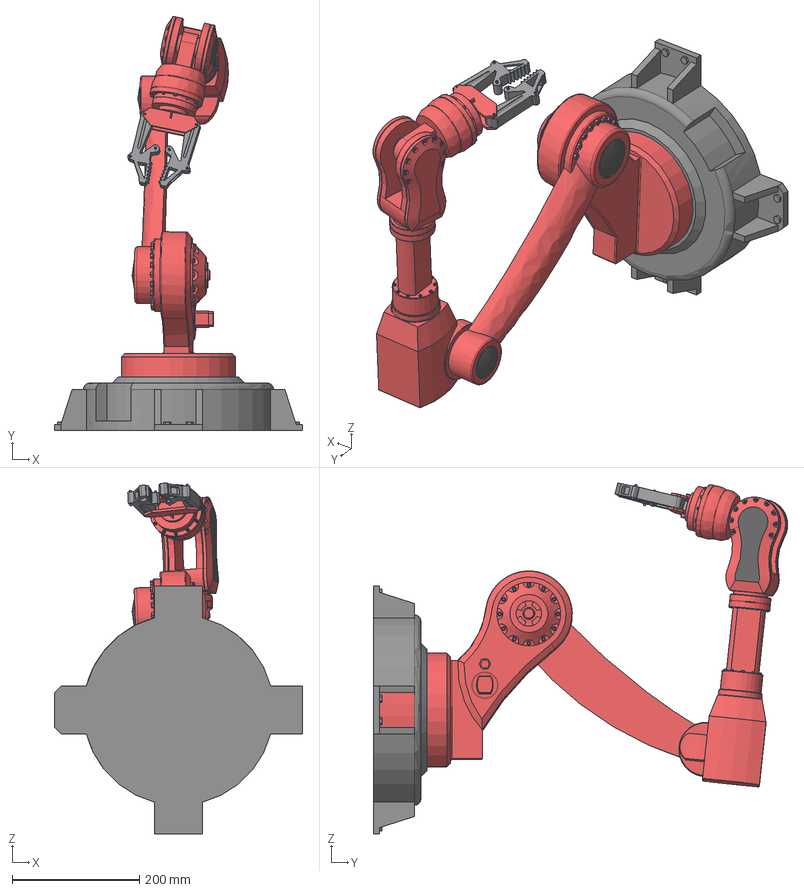
[picture p55: CAD file, 2025-12-14]
first_concept_prototype/Models-3D/Robot Arm.stp
390.5 x 652.6 x 552.6 mm
BASE
LINK 1
link 2
LINK 3
link end 2
link 4
LINK END 1
END EFFECTOR x 2
