klaus-liebler/factory_in_a_box/first_concept_prototype/Models-3D/Profile72-5cm.stp

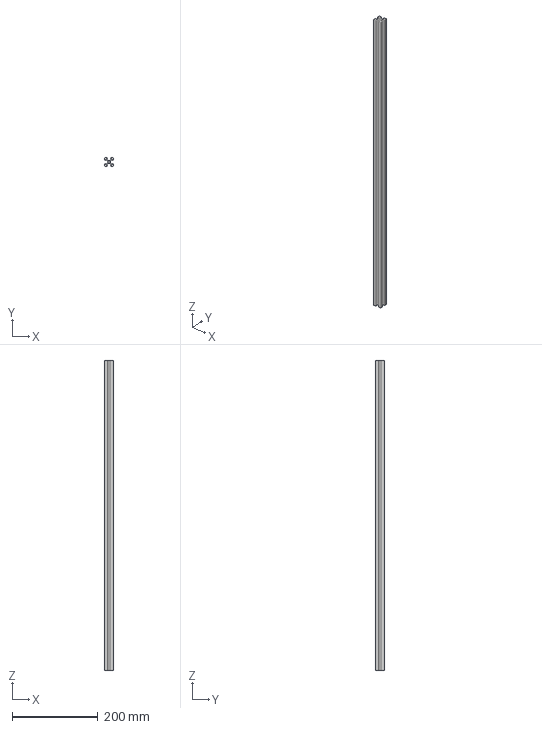
[picture p56: CAD file, 2025-12-14]
first_concept_prototype/Models-3D/Profile72-5cm.stp
20.0 x 20.0 x 725.0 mm
