klaus-liebler/factory_in_a_box/first_concept_prototype/Models-3D/Soporte Tubo.stp

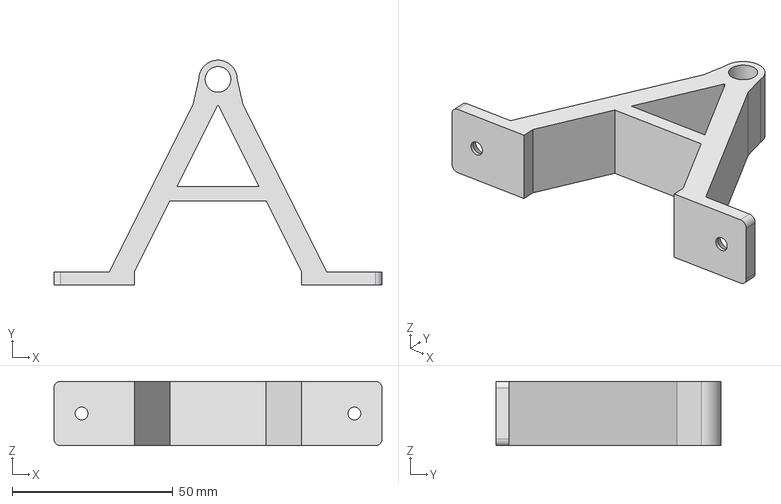
[picture p57: CAD file, 2025-12-14]
first_concept_prototype/Models-3D/Soporte Tubo.stp
102.2 x 70.0 x 20.0 mm
