klaus-liebler/factory_in_a_box/first_concept_prototype/Models-3D/ServoMotor.stp

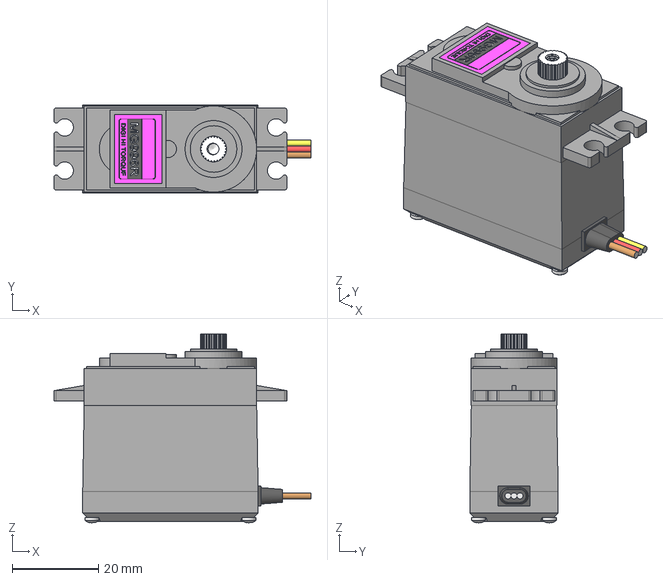
[picture p58: CAD file, 2025-12-14]
first_concept_prototype/Models-3D/ServoMotor.stp
59.6 x 20.5 x 43.8 mm
