klaus-liebler/factory_in_a_box/first_concept_prototype/Models-3D/Slide Guide.stp

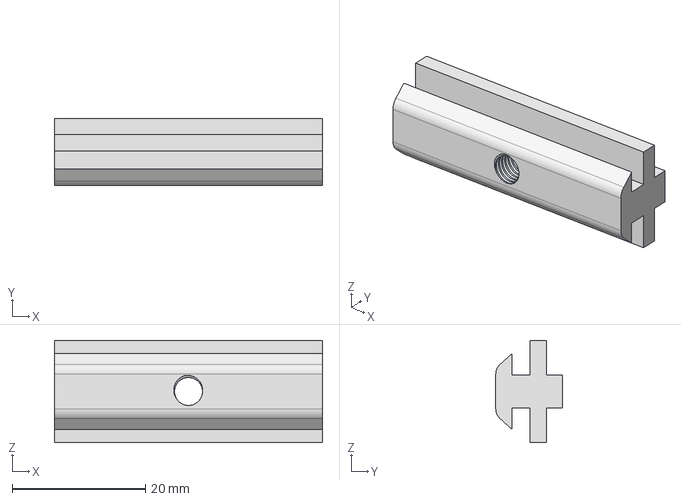
[picture p59: CAD file, 2025-12-14]
first_concept_prototype/Models-3D/Slide Guide.stp
40.3 x 10.0 x 15.4 mm
