klaus-liebler/factory_in_a_box/first_concept_prototype/Models-3D/Little Robot Arm 1.stp

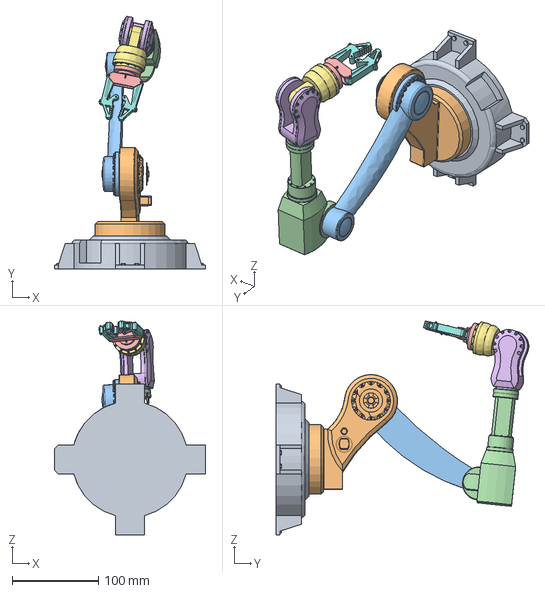
[picture p60: CAD file, 2025-12-14]
first_concept_prototype/Models-3D/Little Robot Arm 1.stp
175.7 x 293.7 x 248.7 mm
