klaus-liebler/factory_in_a_box/first_concept_prototype/Models-3D/Elevador Superior.stp

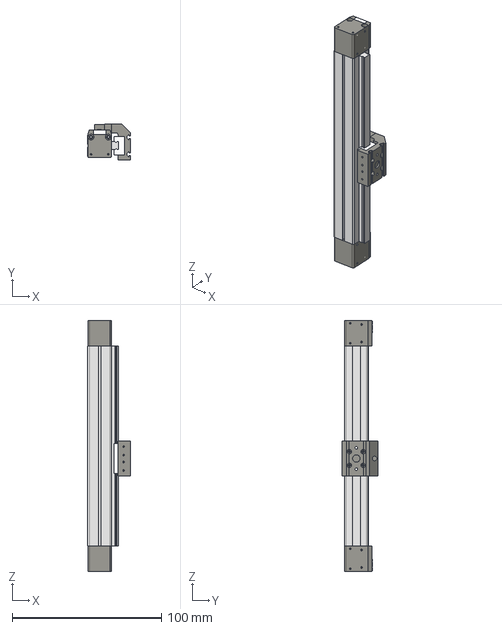
[picture p61: CAD file, 2025-12-14]
first_concept_prototype/Models-3D/Elevador Superior.stp
28.5 x 23.8 x 168.0 mm
