klaus-liebler/factory_in_a_box/first_concept_prototype/Models-3D/Rampa de abajo.stp

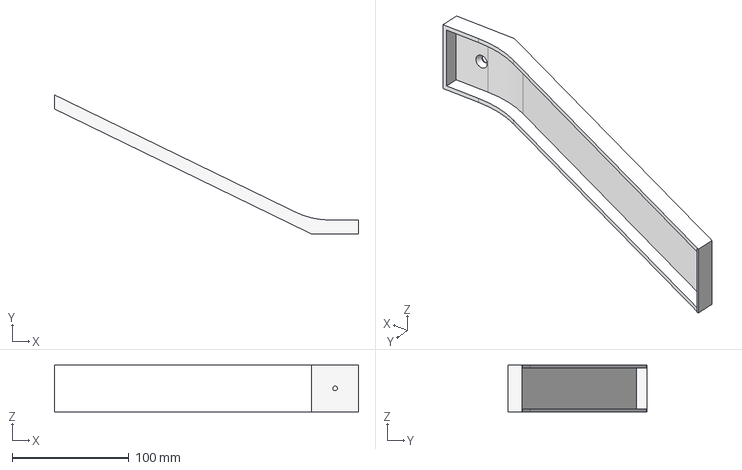
[picture p62: CAD file, 2025-12-14]
first_concept_prototype/Models-3D/Rampa de abajo.stp
260.0 x 119.0 x 40.1 mm
