klaus-liebler/factory_in_a_box/first_concept_prototype/Models-3D/Little Robot Arm.stp

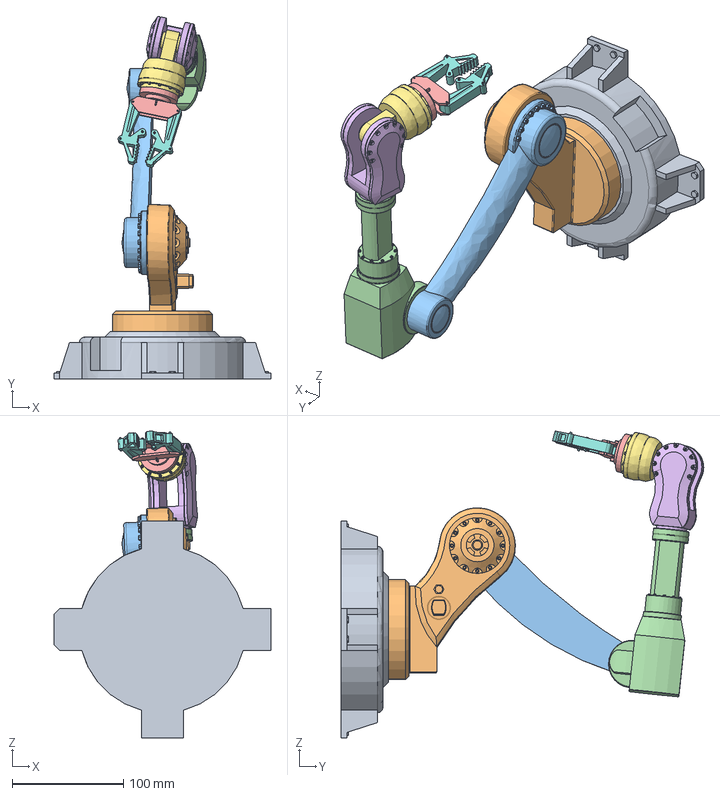
[picture p63: CAD file, 2025-12-14]
first_concept_prototype/Models-3D/Little Robot Arm.stp
195.2 x 326.3 x 276.3 mm
