klaus-liebler/factory_in_a_box/first_concept_prototype/Models-3D/Parte 2 - Base.stp

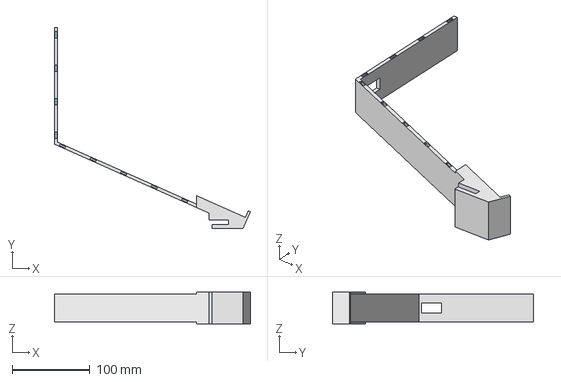
[picture p64: CAD file, 2025-12-14]
first_concept_prototype/Models-3D/Parte 2 - Base.stp
252.3 x 258.2 x 41.0 mm
