klaus-liebler/factory_in_a_box/first_concept_prototype/Models-3D/Cosito servo.stp

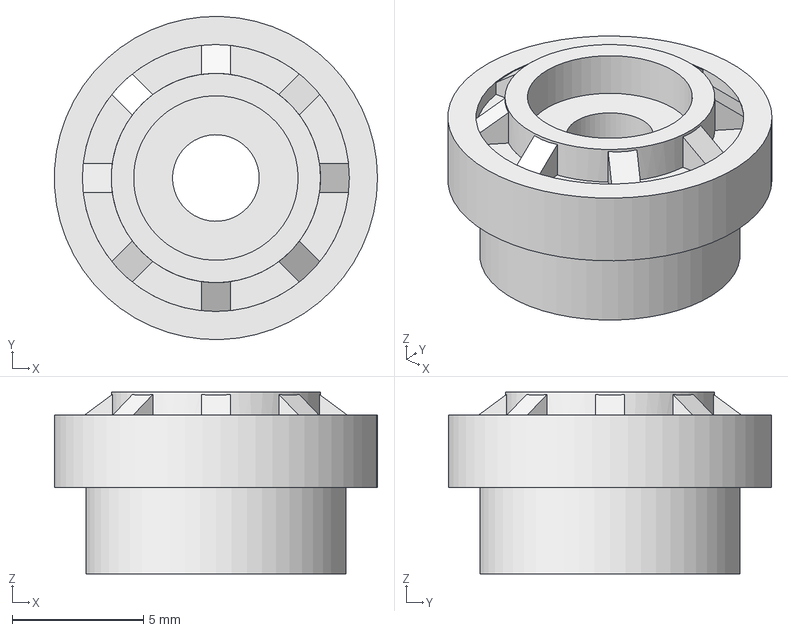
[picture p65: CAD file, 2025-12-14]
first_concept_prototype/Models-3D/Cosito servo.stp
12.3 x 12.3 x 6.93 mm
