klaus-liebler/factory_in_a_box/first_concept_prototype/Models-3D/Base para las piezas V2.stp

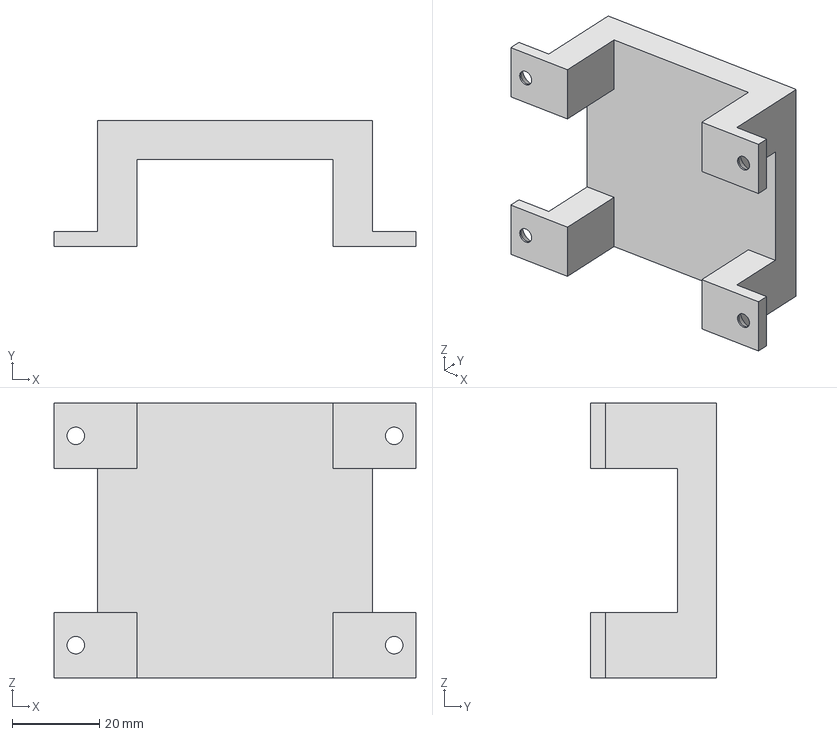
[picture p66: CAD file, 2025-12-14]
first_concept_prototype/Models-3D/Base para las piezas V2.stp
83.0 x 29.0 x 63.0 mm
