klaus-liebler/factory_in_a_box/first_concept_prototype/Models-3D/Conveyor belt_si.stp

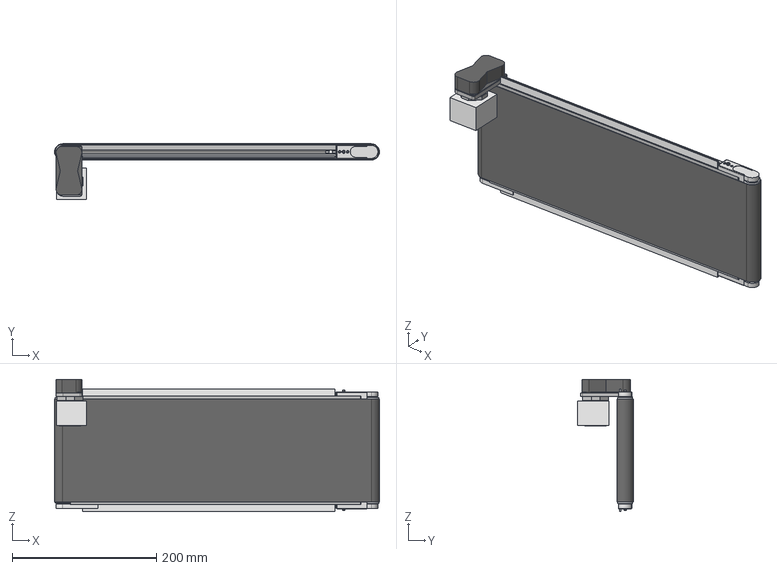
[picture p67: CAD file, 2025-12-14]
first_concept_prototype/Models-3D/Conveyor belt_si.stp
450.0 x 76.9 x 183.4 mm
