klaus-liebler/factory_in_a_box/first_concept_prototype/Models-3D/Separador.stp

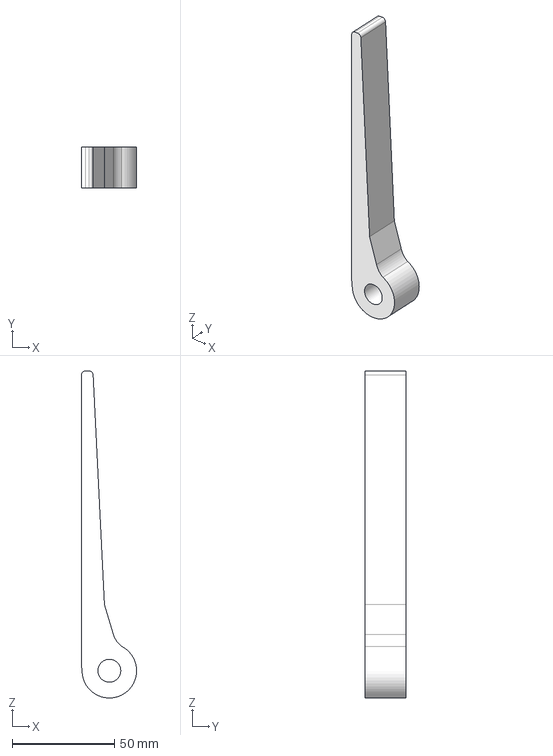
[picture p68: CAD file, 2025-12-14]
first_concept_prototype/Models-3D/Separador.stp
27.0 x 20.0 x 159.9 mm
