klaus-liebler/factory_in_a_box/first_concept_prototype/Models-3D/dge_25a_tb_eg_100_lf.stp

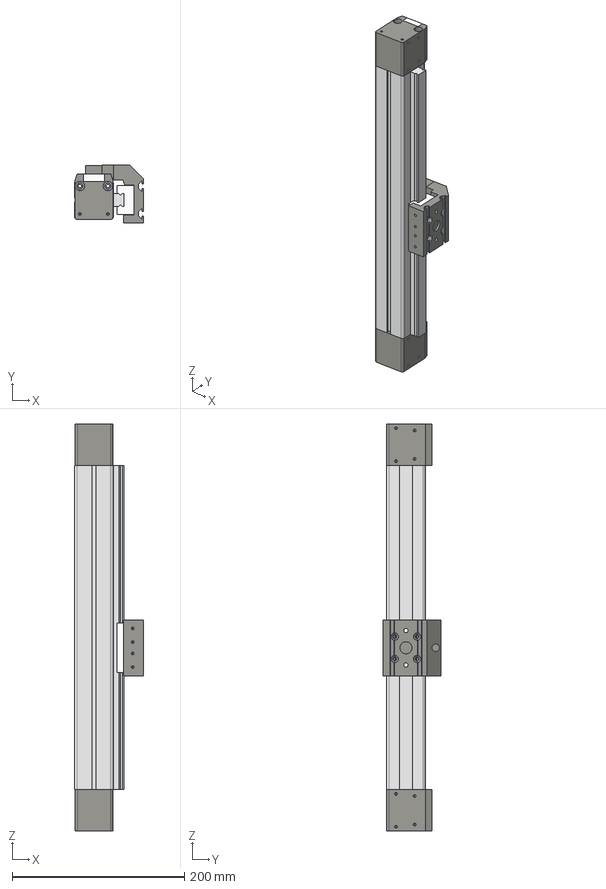
[picture p69: CAD file, 2025-12-14]
first_concept_prototype/Models-3D/dge_25a_tb_eg_100_lf.stp
80.0 x 67.0 x 472.0 mm
dge_25a_tb_eg_100_lf_01
dge_25a_tb_eg_100_lf_02
dge_25a_tb_eg_100_lf_03
dge_25a_tb_eg_100_lf_04
dge_25a_tb_eg_100_lf_05
dge_25a_tb_eg_100_lf_06
dge_25a_tb_eg_100_lf_07
dge_25a_tb_eg_100_lf_08
dge_25a_tb_eg_100_lf_10
dge_25a_tb_eg_100_lf_11
dge_25a_tb_eg_100_lf_12
