klaus-liebler/factory_in_a_box/first_concept_prototype/Models-3D/Rampa del medio.stp

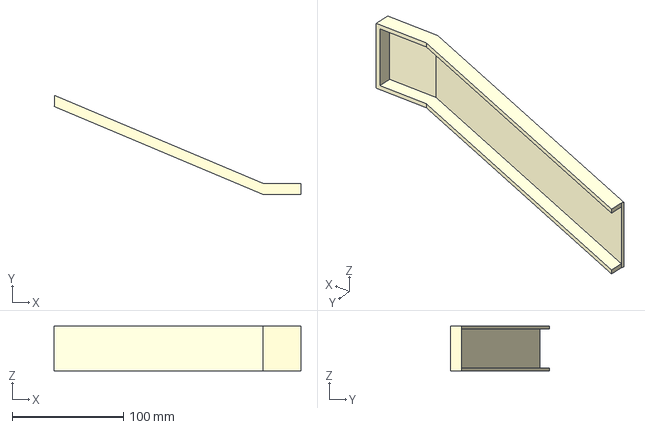
[picture p70: CAD file, 2025-12-14]
first_concept_prototype/Models-3D/Rampa del medio.stp
222.4 x 89.3 x 40.1 mm
