klaus-liebler/factory_in_a_box/first_concept_prototype/Models-3D/Rampa.stp

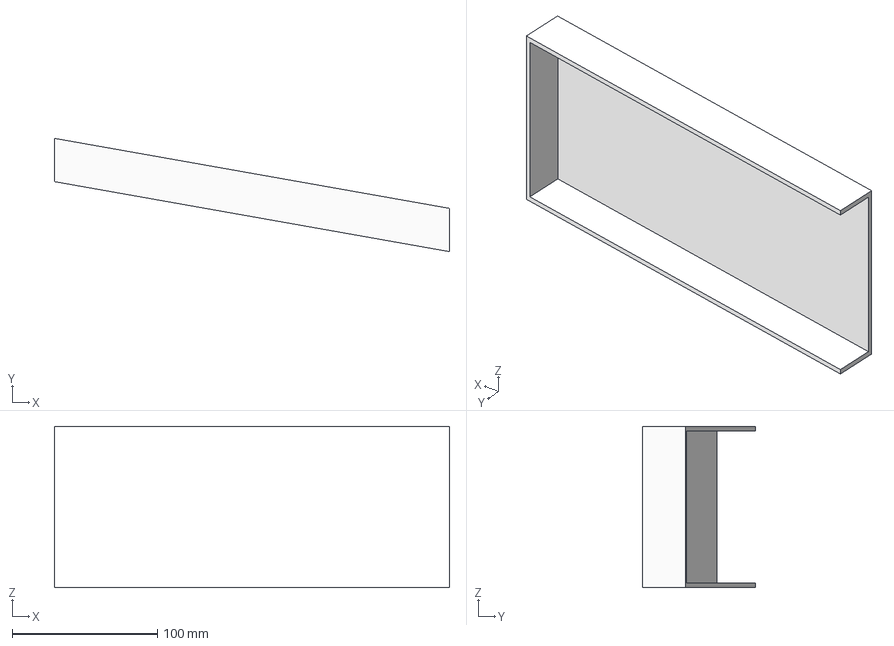
[picture p71: CAD file, 2025-12-14]
first_concept_prototype/Models-3D/Rampa.stp
272.0 x 78.0 x 110.9 mm
