klaus-liebler/factory_in_a_box/first_concept_prototype/Models-3D/20x20_aluminium_vslot_extrusion.SLDPRT

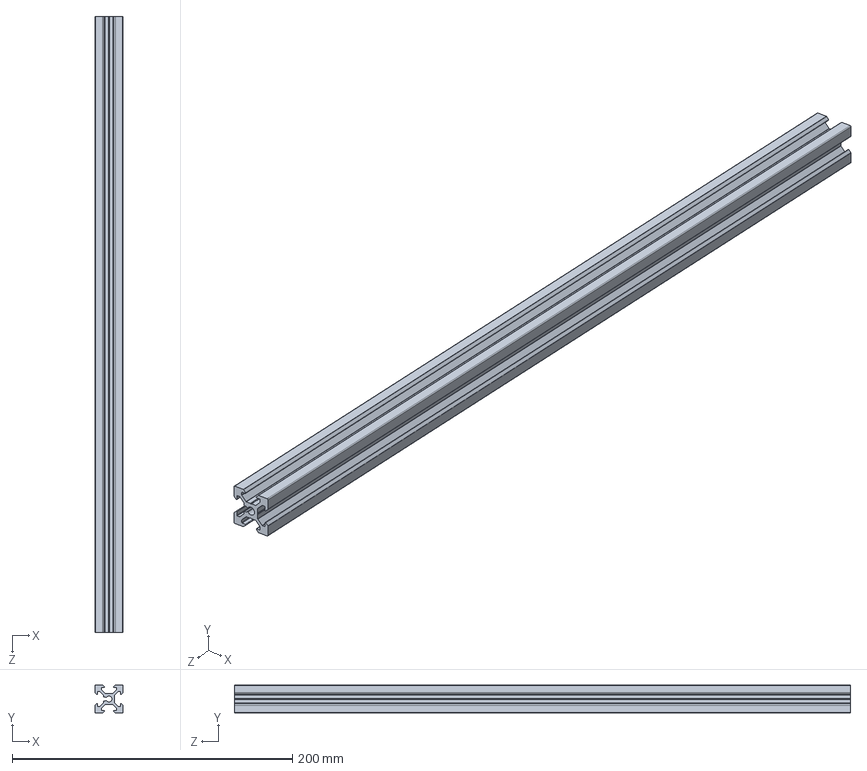
[picture p72: CAD file, 2025-12-14]
first_concept_prototype/Models-3D/20x20_aluminium_vslot_extrusion.SLDPRT
20.0 x 20.0 x 440.0 mm
