klaus-liebler/factory_in_a_box/first_concept_prototype/Models-3D/Parte 5 - Soporte de abajo.stp

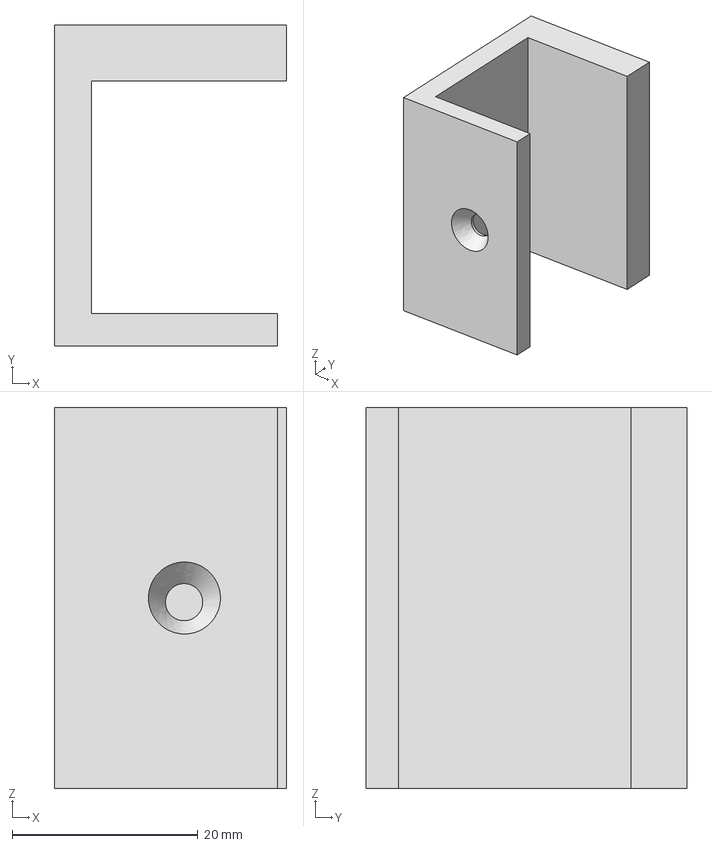
[picture p73: CAD file, 2025-12-14]
first_concept_prototype/Models-3D/Parte 5 - Soporte de abajo.stp
25.0 x 34.5 x 41.0 mm
