klaus-liebler/factory_in_a_box/first_concept_prototype/Models-3D/Little Robot Arm 2.stp

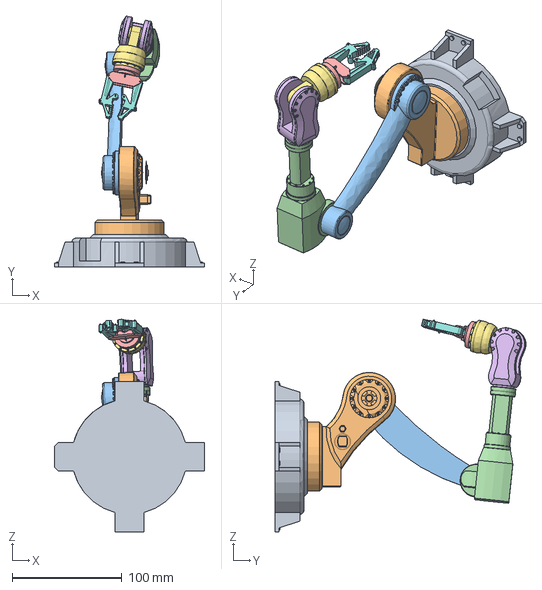
[picture p74: CAD file, 2025-12-14]
first_concept_prototype/Models-3D/Little Robot Arm 2.stp
136.7 x 228.4 x 193.4 mm
