klaus-liebler/factory_in_a_box/first_concept_prototype/Models-3D/Rampa Separador.stp

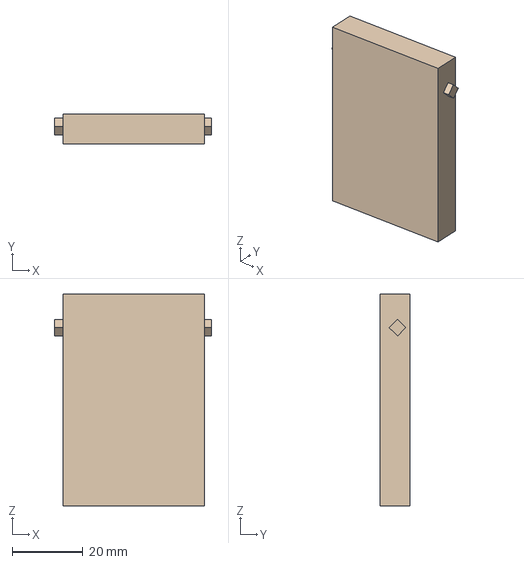
[picture p75: CAD file, 2025-12-14]
first_concept_prototype/Models-3D/Rampa Separador.stp
44.5 x 8.50 x 60.0 mm
