klaus-liebler/factory_in_a_box/first_concept_prototype/Models-3D/Belt.stp

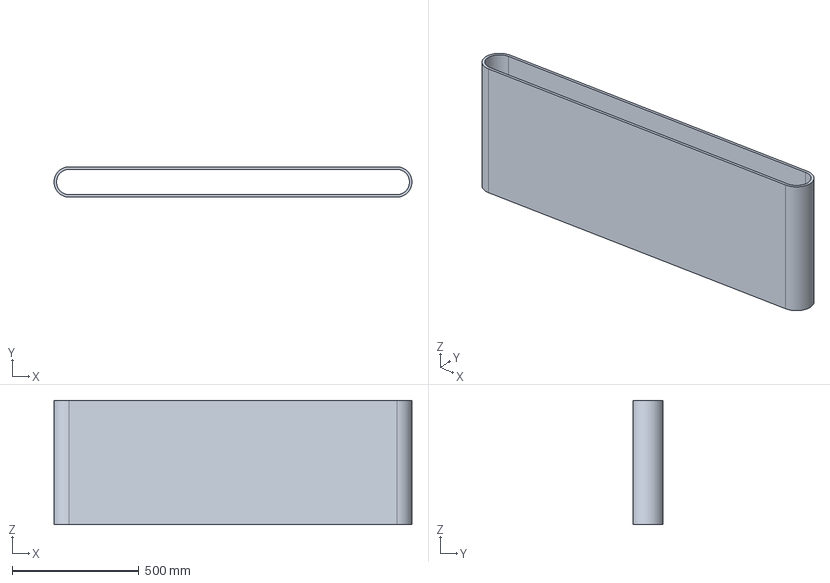
[picture p79: CAD file, 2025-12-14]
first_concept_prototype/Models-3D/Belt.stp
1411.2 x 120.0 x 489.6 mm
