klaus-liebler/factory_in_a_box/first_concept_prototype/Models-3D/cosita de servo 2 lados.stp

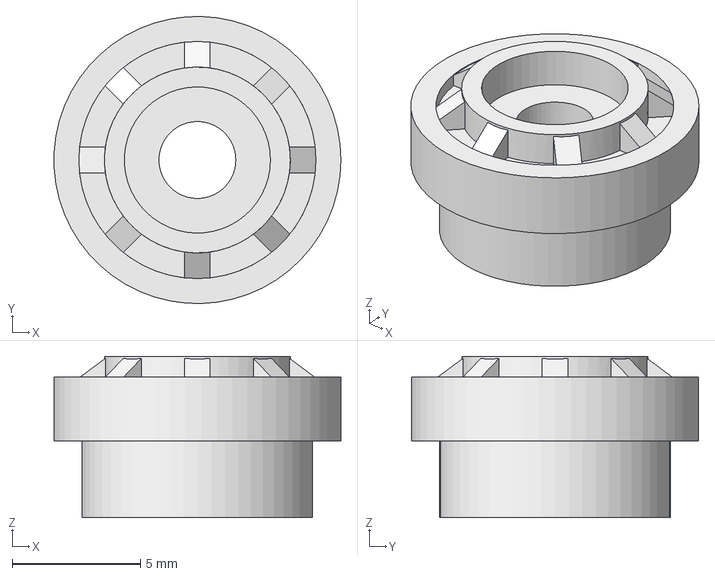
[picture p80: CAD file, 2025-12-14]
first_concept_prototype/Models-3D/cosita de servo 2 lados.stp
11.2 x 11.2 x 6.30 mm
