klaus-liebler/factory_in_a_box/first_concept_prototype/Models-3D/Tunel.stp

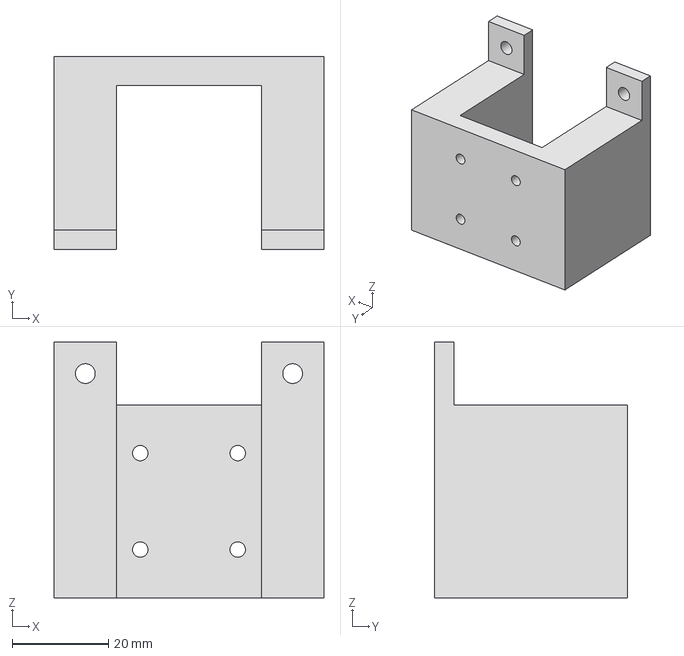
[picture p81: CAD file, 2025-12-14]
first_concept_prototype/Models-3D/Tunel.stp
56.0 x 40.0 x 53.0 mm
