klaus-liebler/factory_in_a_box/(list of files, cad)

Other CAD files:
first_concept_prototype/Models-3D/Little blue box.stp
first_concept_prototype/Models-3D/dge_25a_tb_eg_100_lf_07.stp
first_concept_prototype/Models-3D/Separador servo (Left).stp
first_concept_prototype/Models-3D/Parte 4 - Pared 2.stp
first_concept_prototype/Models-3D/dge_25a_tb_eg_100_lf_06.stp
first_concept_prototype/Models-3D/Separador servo (Right).stp
first_concept_prototype/Models-3D/Little red box.stp
component_3d_models/20X20 - T-slot - Aluminium Profile.f3d
first_concept_prototype/Models-3D/Convenyor Belt_.stp
first_concept_prototype/Models-3D/Rampa V2.stp
first_concept_prototype/Models-3D/Rampa V3 - copia.stp
first_concept_prototype/Models-3D/Rampa V3.stp
first_concept_prototype/Models-3D/Rampa V4 - copia.stp
first_concept_prototype/Models-3D/Rampa de abajo - copia.stp
first_concept_prototype/Models-3D/Separador - copia.stp
first_concept_prototype/Models-3D/Soporte Servo - copia.stp
