klaus-liebler/factory_in_a_box/firmware_factory_control_unit/docs/build-process.md

# Build-Prozess

`builder/` ist der Build-Orchestrator für den gesamten Build: Board-Identität + TLS-Zertifikat
provisionieren, Register-Map und Git-Info generieren, Web-UI bauen (Single-File, Brotli-komprimiert),
Firmware bauen (CMake) und flashen (STM32_Programmer_CLI) -- inklusive dateibasiertem Protokoll
jedes erfolgreichen Flash-Vorgangs im Board-Archiv (s. Abschnitt 6). Implementiert als
dotnet-Konsolenapplikation (C#, net10.0); lediglich
das Vite-Plugin für den Web-Build (Abschnitt 7) ist weiterhin TypeScript, da Vite keine C#-API hat --
`BuildWebApp` ruft Vite dafür per Kindprozess auf (Abschnitt 4).

## 1. Voraussetzungen

Vor dem ersten Build muessen folgende Programme installiert und im `PATH` verfuegbar sein (nach
Installation jeweils Terminal/IDE neu starten, damit ein aktualisierter `PATH` greift). Kein Punkt
davon wird vom Build-Prozess selbst geprueft oder installiert -- fehlt eines, bricht die jeweils
betroffene Phase mit einer Fehlermeldung ab (`cmake`/`ninja`/`arm-none-eabi-gcc` nicht gefunden,
`node`/`npm` nicht gefunden, `STM32_Programmer_CLI.exe` nicht gefunden).

| Programm | Gebraucht fuer | Installation |
|---|---|---|
| .NET SDK 10 | `builder/` selbst (`dotnet build`/`dotnet run`) | `winget install Microsoft.DotNet.SDK.10` |
| Node.js (inkl. npm) | `BuildWebApp` (vite) | `winget install OpenJS.NodeJS` |
| CMake | `BuildFirmware` (Configure) | `winget install Kitware.CMake` |
| Ninja | `BuildFirmware` (Generator, s. `CMakePresets.json`) | `winget install Ninja-build.Ninja` |
| GCC 16 fuer arm-none-eabi (MSYS2 UCRT64, `C:/opt/msys64/ucrt64`) | `BuildFirmware` (Cross-Compiler, s. `rtoos/cmake/arm-none-eabi.cmake`; `CMakePresets.json` setzt `RTOS_GCC_ROOT` und den PATH) | MSYS2: `pacman -S mingw-w64-ucrt-x86_64-arm-none-eabi-gcc` (GCC >= 16; rtoos bricht mit jedem anderen Compiler ab) |
| STM32CubeProgrammer | `FlashFirmware`/`PipelineFlash` (nicht fuer reine Board-Builds noetig) | Kein Winget-Paket -- Installer von [st.com/stm32cubeprog](https://www.st.com/en/development-tools/stm32cubeprog.html) (ST-Account noetig); Standardpfad passt zu `appsettings.json.template`, s. Abschnitt 8 |

`arm-none-eabi-gcc`/`STM32_Programmer_CLI.exe` haben keinen projektinternen Pfad-Override
(muessen im `PATH` liegen); Letzteres kann zusaetzlich per `STM32_PRG_PATH`-Umgebungsvariable oder
`builder/appsettings.json` auf einen abweichenden Installationsort zeigen, s. Abschnitt 8.

## 2. Kommandos

Einmalig nach dem Checkout:

```
dotnet build builder
npm install --prefix web
```

(`dotnet build` legt `builder/appsettings.json` aus der Vorlage an, falls sie fehlt, s. Abschnitt
8. `npm install` muss im `web/`-Verzeichnis laufen -- es gibt bewusst kein npm-Workspace-Root mehr
(s. Abschnitt 4); es installiert `web/`s Dependencies inkl. `vite`/`terser`/`html-minifier-terser`
nach `web/node_modules/`, wo `WebAppBuildService` sowie
`web/build-tools/vite-plugin-single-file-firmware-asset.ts` sie zur Laufzeit erwarten.)

### Gesamt-Pipelines

```
dotnet run --project builder -- PipelineLazy   -- --preset <Release|Debug|Release-Rev1|Debug-Rev1|Release-Rev3|Debug-Rev3>   # kein Flash
dotnet run --project builder -- PipelineForced -- --preset <Release|Debug|Release-Rev1|Debug-Rev1|Release-Rev3|Debug-Rev3>   # wie lazy, Zertifikat erzwungen
dotnet run --project builder -- PipelineFlash  -- --preset <Release|Debug|Release-Rev1|Debug-Rev1|Release-Rev3|Debug-Rev3>   # wie lazy, danach flashen
```

`--preset` fehlt -> Default `Release` (s. `Stm32BuildContext.Preset`). Das Preset waehlt die
Hardware-Revision der Platine (`RTOS_FCU_REVISION`, Pin-Belegung in `src/pins.hpp`):
`Release`/`Debug` = Revision 2 (STM32H563 mit CH224K), `Release-Rev1`/`Debug-Rev1` = Revision 1
(erste Platinen, STM32H563, Pin-Belegung des frueheren CubeMX-Projekts), `Release-Rev3`/`Debug-Rev3`
= Revision 3 (STM32H743VIT6, aktuelle Platine `pcb_factory_control_unit`; `RTOS_CHIP=stm32h743`).
Das Nucleo-Testboard wird nicht mehr unterstuetzt. Die Unique-ID liest der Builder je nach Chip an
der richtigen Adresse (Device ID beim Verbinden: 0x484 STM32H563 -> 0x08FFF800, 0x450 STM32H743 ->
0x1FF1E800, `Stm32HardwareIdentityService`).

Beispiel fuer den alltaeglichen Zyklus (Board an ST-Link, provisionieren + bauen + flashen):

```
dotnet run --project builder -- PipelineFlash -- --preset Release
```

### Einzelne Schritte

Jeder Build-Schritt ist eine mit `[BuildStep]` markierte Methode in `builder/Program.cs`, per CLI
über ihren Methodennamen aufrufbar (kein zentrales String-Register mehr, s. Abschnitt 4):

```
dotnet run --project builder -- PrepareContextWithRealHardware                 # Board-ID lesen + Hardware-Snapshot schreiben
dotnet run --project builder -- PrepareContextWithCommandLineArguments -- --board <boardId>   # Board-Kontext ohne angeschlossene Hardware setzen
dotnet run --project builder -- GenerateCertificatesLazy                       # Zertifikat wiederverwenden/bei Bedarf erzeugen
dotnet run --project builder -- GenerateCertificatesForced                     # Zertifikat immer neu erzeugen
dotnet run --project builder -- GenerateDeviceArtifacts                        # device_ids.hh + device-ids.json (generated/) + Kopie von board_info.json aus dem Board-Archiv
dotnet run --project builder -- GenerateRegisterAccessFiles          # schema/register_map/*.cs -> Code (Modbus + OPC UA + Web)
dotnet run --project builder -- GenerateBestBinaryBufferFiles                  # schema/best_binary_buffers/*.cs -> Code
dotnet run --project builder -- GenerateTerminalFiles                          # schema/terminal/*.cs -> Code
dotnet run --project builder -- ReadGitStatusAndGenerateFiles                  # Git-Stand -> Code
dotnet run --project builder -- CopyGeneratedFilesToBuildDirectory             # Board-Archiv -> generated, web/generated, build/assets
dotnet run --project builder -- BuildWebApp                                    # vite build
dotnet run --project builder -- BuildFirmware        -- --preset <preset>      # cmake configure + build
dotnet run --project builder -- FlashFirmware        -- --preset <preset>      # STM32_Programmer_CLI + board_info.json/flash_events.jsonl-Eintrag
```

Jeder Schritt ist einzeln sinnvoll aufrufbar, z. B. nur `GenerateRegisterAccessFiles` nach
einer Änderung an `schema/register_map/*.cs`, ohne Board oder Firmware-Build anzufassen.

### `--board` überschreiben

Alle Schritte außer `PrepareContextWithRealHardware`/`PrepareContextWithCommandLineArguments`
ermitteln das Board über einen Cache (`build/.last-board-id`, geschrieben von diesen beiden
Schritten). Um explizit für ein anderes, gerade nicht angeschlossenes Board zu arbeiten (z. B.
Register-Map für ein Archiv nachziehen):

```
dotnet run --project builder -- GenerateRegisterAccessFiles -- --board 363836_004500173434510434363836
```

## 3. Build-Schritte im Detail

Generierte Dateien landen seit August 2026 direkt im Projekt (`generated/`, `web/generated/`),
nicht mehr im Board-Archiv -- Ausnahme sind Dateien, die echten persistenten Zustand tragen statt
reiner Build-Ableitung zu sein: Zertifikate/Schluessel (Kontinuitaet gewuenscht), `board_info.json`
(das Board-Archiv-Root selbst) und `gitstatus.json` (Audit-Trail fuer `flash_events.jsonl`, s.
Abschnitt 6) -- die bleiben im Board-Archiv bzw. werden von dort unveraendert gespiegelt.

| # | Schritt | Braucht Hardware? | Schreibt nach |
|---|---|---|---|
| 1 | `PrepareContextWithRealHardware` | ja (ST-Link) | Board-Archiv -- liest Chip-UID, berechnet Hostname/MACs und schreibt `hardware-identity.json`. |
| 1' | `PrepareContextWithCommandLineArguments` | nein (`--board <boardId>`) | Nur die Board-ID-Cache-Datei -- setzt den Board-Kontext ohne Geräte-Zugriff, fuer ein bereits archiviertes Board. |
| 2 | `GenerateCertificatesLazy` | nein | Board-Archiv (Ausnahme, s.o.) -- erzeugt/aktualisiert PEM+DER nur falls noch nicht vorhanden; schreibt `certificate-info.json`. |
| 3 | `GenerateCertificatesForced` | nein | Board-Archiv (Ausnahme) -- wie 2, aber immer neu erzeugen (CA-Rotation, Ablauf). |
| 4 | `GenerateDeviceArtifacts` | nein | `generated/` -- `hardware-identity.json` + `certificate-info.json` (Board-Archiv) -> `device_ids.hh` + `device-ids.json`; kopiert zusaetzlich `board_info.json` (Archiv-Root, Ausnahme) unveraendert dorthin. |
| 5 | `GenerateRegisterAccessFiles` | nein | `generated/` + `web/generated/` + `docs/generated/` -- `schema/register_map/*.cs` -> `register_map.hpp` + `register_map_opcua.hpp` + `register-map.ts` + `modbus-registers.md` (tabellarische Register-Uebersicht nach Gruppe und nach Adresse) (universal_register_access). |
| 6 | `GenerateBestBinaryBufferFiles` | nein | `generated/` + `web/generated/` -- `schema/best_binary_buffers/*.cs` (wiederholbares `--best-binary-buffer-schema-path` fuer weitere Quellen) -> `ws_protocol.hh` + `ws-protocol.ts` (ueber das geteilte WsProtocolBuildService, s. Abschnitt 4). |
| 6' | `GenerateTerminalFiles` | nein | `generated/` + `web/generated/` -- `schema/terminal/*.cs` (C#-Klassen: Befehle, Parameter, Werte/Lookups der Terminal-Seite; Attribute in `TerminalSchemaAttributes.cs`, Generator `TerminalCatalog` in `firmware_builder_common`) -> `terminal_commands.hh` (Firmware: Handler je Befehl, Antwort je Lookup, zur Compilezeit geprueft) + `terminal-commands.ts` (in die Web-App compiliert: Vervollstaendigung, help, Parameter-Sprechblase); s. [terminal.md](terminal.md). |
| 7 | `ReadGitStatusAndGenerateFiles` | nein | `generated/` + `web/generated/` -- `gitconstants.hh`, `firmware_constants.hh` (BOARD_NAME/FW_VERSION_*, s. Abschnitt 6), `build-info.ts` aus Git-Abfrage + `firmware-version.json` + `device-ids.json` (generated/); `gitstatus.json` (Ausnahme) zusaetzlich ins Board-Archiv. |
| 8 | `CopyGeneratedFilesToBuildDirectory` | nein | `build/assets/` -- kopiert nur noch die Zertifikat-DER-Dateien (Ausnahme) aus dem Board-Archiv; alles andere generiert bereits direkt im Projekt. |
| 9 | `BuildWebApp` | nein | `web/dist/`, `build/assets/index.html.br` -- ruft `vite build` per Kindprozess auf (inkl. Inlining/Minify/Brotli über `singleFileFirmwareAssetPlugin`). |
| 10 | `BuildFirmware` | nein | `build/<preset>/` -- `cmake --preset` + `cmake --build --preset`. |
| 11 | `FlashFirmware` | ja (ST-Link) | `STM32_Programmer_CLI -c port=SWD -w <build>.elf -v -rst`, danach Aktualisierung von `board_info.json`/`flash_events.jsonl` im Board-Archiv (nur bei verifiziertem Erfolg). |

```mermaid
flowchart TD
    HW["Board an ST-Link"]
    HWID["1: PrepareContextWithRealHardware"]
    CERTL["2: GenerateCertificatesLazy"]
    CERTF["3: GenerateCertificatesForced"]
    ART["4: GenerateDeviceArtifacts"]
    RM["5: GenerateRegisterAccessFiles"]
    WSP["6: GenerateBestBinaryBufferFiles"]
    TERM["6': GenerateTerminalFiles"]
    GS["7: ReadGitStatusAndGenerateFiles"]
    ARCHIVE["Board-Archiv (Ausnahmen)\nstm32_boards/&lt;id&gt;/generated/\nhardware-identity.json, certificate-info.json,\nZertifikate/Schluessel, gitstatus.json"]
    PROJECT["generated/ + web/generated/\n(direkt generiert, kein Zwischenschritt)"]
    COPY["8: CopyGeneratedFilesToBuildDirectory\n(nur noch Zertifikate -> build/assets/)"]
    WEB["9: BuildWebApp (vite)"]
    FW["10: BuildFirmware (cmake)"]
    FLASH["11: FlashFirmware"]
    BOARDJSON[("board_info.json +\nflash_events.jsonl\n(im Board-Archiv)")]

    HW --> HWID
    HWID --> ARCHIVE
    CERTL --> ARCHIVE
    CERTF --> ARCHIVE
    ART --> PROJECT
    ART -.->|"liest hardware-identity.json/\ncertificate-info.json, spiegelt board_info.json"| ARCHIVE
    RM --> PROJECT
    WSP --> PROJECT
    TERM --> PROJECT
    GS --> PROJECT
    GS -.->|"gitstatus.json"| ARCHIVE
    ARCHIVE --> COPY
    PROJECT --> WEB
    COPY --> WEB
    PROJECT --> FW
    COPY --> FW
    WEB --> FW
    FW --> FLASH
    FLASH -->|"nur bei Erfolg"| BOARDJSON
```

## 4. Architektur des Build-Skripts (`builder/`)

```
builder/
├── builder.csproj                   # net10.0 Console-App, Microsoft.Extensions.Configuration(.Json/.Binder)
├── Program.cs                       # Einstiegspunkt + ein [BuildStep] pro Schritt (s. Abschnitt 3): dispatcht per BuildStepRunner.Run(args, a => Stm32Toolchain.CreateBuildContext(a, x => new Stm32BuildContext(x)), typeof(Program)); Pipelines rufen andere Schritte per BuildStepRunner.Invoke seriell auf
├── Stm32BuildContext.cs             # projekteigene Pfade auf Basis von Stm32BuildContextBase (FirmwareBuilder.Common) -- die chip-generische IBuildContextStm32-Logik (Board-Identitaet/BoardSettings etc.) liegt dort
├── appsettings.json                  # gitignored: persönliche Maschinenpfade (STM32CubeProgrammer, OneDrive-Ordner, CA, Default-Board-Type)
├── appsettings.json.template         # getrackte Vorlage; wird von einem MSBuild-Target (EnsureAppSettings) automatisch angelegt
├── BuilderSettings.cs                # appsettings.json gebunden an getrennte typsichere Konfigurationsklassen
└── GlobalUsings.cs                   # globale Imports auf FirmwareBuilder.Common

web/build-tools/
├── vite-plugin-single-file-firmware-asset.ts
├── singlefile-minify.ts
└── html-minifier-terser.d.ts
```

Die eigentlichen Schritt-Implementierungen (`Stm32BoardProvisioningService`, `GitBuildArtifactsService`,
`GeneratedArtifactsCopyService`, `Stm32FlashService`, `FlashFirmwarePipelineService`,
`UniversalRegisterAccessBuildService`, `BestBinaryBufferBuildService`, `CmakeFirmwareBuildService`,
`WebAppBuildService`, `BoardStateStore`, `FirmwareVersionReader` -- die von `Program.cs` aufgerufenen
Services) leben **nicht** in diesem Repo, sondern in einem eigenständigen Schwester-Repo
`dotnet_libs/firmware_builder_common` (Projekt `FirmwareBuilder.Common`, per `<ProjectReference>`
in `builder/builder.csproj` eingebunden, analog zu `../stm32_libs` fuer die Firmware selbst, s.
Abschnitt 5) -- dieses Repo wird von mehreren Hardware-Projekten geteilt (u. a. gibt es dort auch
einen `Esp32/`-Zweig fuer ESP-IDF-Boards, s. `sensact_firmware`). Auch der generische Dispatch-
Mechanismus (`[BuildStepAttribute]`, `BuildStepRunner`, `IBuildContext`/`IBuildContextStm32`) liegt
dort, projektuebergreifend geteilt; die STM32-spezifischen Services liegen unter `stm32/`
(`Stm32BoardProvisioningService.cs`, `Stm32FlashService.cs`, `Stm32HardwareIdentityService.cs`).
Fuer den genauen Dateizuschnitt gilt das Schwester-Repo selbst als Quelle, nicht dieses Dokument.

Jeder Schritt ist eine mit `[BuildStep]` markierte, oeffentliche statische Methode
`(IBuildContextStm32 ctx)` in `Program.cs` -- per CLI ueber ihren Methodennamen aufrufbar, keine
String-Konstanten-Registrierung mehr. Pipelines (`PipelineLazy`/`PipelineForced`/`PipelineFlash`)
sind selbst ganz normale `[BuildStep]`-Methoden, deren Body andere Schritte seriell per
`BuildStepRunner.Invoke(ctx, SchrittName)` aufruft -- jeder Aufruf (top-level oder aus einer
Pipeline heraus) bekommt dieselbe farbige Start/Erfolg/Fehler-Konsolenausgabe samt Zeitmessung.

Ausführung ausschließlich über `dotnet run --project builder -- <Schritt> [--preset ...] [--board ...]`
(bzw. nach einem einmaligen `dotnet build builder` auch direkt über die gebaute
`builder/bin/<Config>/net10.0/builder.exe`).

**`BuildWebApp` und die drei TypeScript-Dateien:** Vite hat keine C#-API, daher bleiben
`vite-plugin-single-file-firmware-asset.ts`, `singlefile-minify.ts` und `html-minifier-terser.d.ts`
bewusst TypeScript -- sie implementieren ein Vite-Plugin, das `web/vite.config.ts` einbindet
(`import { singleFileFirmwareAssetPlugin } from "./build-tools/vite-plugin-single-file-firmware-asset.ts"`).
`Program.cs` ruft dafür den zentralen Shared-Service `WebAppBuildService` auf, der intern
`node node_modules/vite/bin/vite.js build <webDir> --config web/vite.config.ts` startet
(Node/npm müssen dafür installiert sein, s. Abschnitt 1) --
Vite lädt die Plugin-Datei dabei selbst (natives TypeScript-Type-Stripping, keine
Zusatzabhängigkeit wie `ts-node`/`tsx`).

Alle fuer den Web-Build noetigen npm-Abhaengigkeiten liegen direkt in `web/package.json`
(`vite`, `html-minifier-terser`, `terser` usw.). Es gibt bewusst kein npm-Workspace-Root mehr;
Install und Build laufen ausschliesslich im `web/`-Verzeichnis.

## 5. Verzeichnisstrukturen

Repo (nur die vom Build-Prozess betroffenen Teile):

```
firmware_factory_control_unit/
├── firmware-version.json         # Produktversion (FW_VERSION_MAJOR/MINOR/PATCH), s. Abschnitt 6
├── builder/                      # s. Abschnitt 4
├── tools/                        # Skripte OHNE Bezug zur Codegenerierung (rename-usb-devices.ps1, test-modbus.ts, ...)
├── generated/                     # gitignored: device_ids.hh, gitconstants.hh, firmware_constants.hh,
│                                  # board_info.json, register_map.hpp,
│                                  # register_map_opcua.hpp, ws_protocol.hh, terminal_commands.hh
├── web/
│   ├── src/                      # kein generated/, kein register-map.ts mehr darunter
│   └── generated/                 # gitignored: build-info.ts, register-map.ts, ws-protocol.ts
├── build/                         # komplett gitignored (CMake-Output + generierte Assets)
│   ├── .last-board-id             # "letztes bekanntes Board"-Cache, s. Abschnitt 2
│   ├── assets/                    # device_certificate.der, device_key.der, index.html.br
│   └── Release/, Debug/, Release-Rev1/, Debug-Rev1/, Release-Rev3/, Debug-Rev3/   # je Preset ein eigener CMake-Binärordner
├── schema/
│   ├── best_binary_buffers/       # C#-Protokollschema (BestBinaryBuffers) + ids.txt
│   ├── register_map/              # C#-Registerschema (Modbus + OPC UA), s. Abschnitt 3
│   └── terminal/commands.cs       # Befehlskatalog der Terminal-Seite (Web-UI + Firmware)
└── docs/
    ├── build-process.md
    └── generated/                 # eingecheckt: modbus-registers.md (Register-Uebersicht, s. Abschnitt 3)
```

Board-Archiv (`C:\Users\<user>\OneDrive - HSOS\stm32_boards\`, Pfad aus `builder/appsettings.json`,
je Maschine individuell):

```
stm32_boards/
└── <shortId>_<fullUid>\                # = boardId, s. Abschnitt 6
    ├── board_info.json                      # aktueller Board-Zustand, s. Abschnitt 6
    ├── flash_events.jsonl               # Flash-Historie (Append-Only-Log), s. Abschnitt 6
    ├── factory-box-<shortId>.pem.key
    ├── factory-box-<shortId>.pem.crt
    ├── factory-box-<shortId>.csr
    └── generated\                      # NUR persistenter Zustand -- reine Build-Ableitung generiert
                                          # seit August 2026 direkt ins Projekt (generated/,
                                          # web/generated/), s. Abschnitt 3
        ├── hardware-identity.json      # Rohdaten vom letzten PrepareContextWithRealHardware-Lauf
        ├── certificate-info.json       # Issuer/Gueltigkeit des aktuellen Zertifikats
        ├── device_certificate.der      # Ausnahme: Kontinuitaet gewuenscht, nicht bei jedem Build neu
        ├── device_key.der
        ├── root_ca.der
        └── gitstatus.json              # Ausnahme: Audit-Trail, mit flash_events.jsonl korreliert
```

Generierte Verzeichnisse/Dateien sind nicht eingecheckt (`generated/`, `web/generated/`,
`build/` komplett -- inkl. `build/assets/*.der`, `build/assets/index.html.br` -- sowie `web/dist/`,
s. `.gitignore`). Ein frisches Checkout ist erst nach einmaligem Lauf der Build-Phasen baubar.

## 6. Board-Verwaltung (`board_info.json`/`flash_events.jsonl`) + Board-Type-/BOARD_NAME-Zuordnung

Dateibasiert, kein zentrales DB-File -- jedes physische Board hat sein eigenes Archivverzeichnis
`stm32_boards/<boardId>/` (`boardId` = `<shortId>_<volle96-Bit-Chip-UID>`, s. `Stm32HardwareIdentityService.ReadHardwareIds`),
darin zwei Dateien (Zugriff über `BoardStateStore.cs` im Shared-Projekt), analog zum Vorbild
`@klaus-liebler/espidf-vite` (Repo `npm-packages`, Commit "Generate everything in special
'GENERATED'-Directory", 2025-01-26 -- dort wurde eine anfangs eingesetzte SQLite-Lösung exakt
dieses Zuschnitts zugunsten von genau einem Verzeichnis pro Board verworfen; dieses Projekt hatte
dieselbe SQLite-Zwischenlösung, s. Commit f57f7f2, und zieht hier nach):

**`board_info.json`** -- aktueller Zustand dieses einen Boards, bei jedem erfolgreichen Flash komplett
neu geschrieben:

```json
{
  "chipUid": "004500173434510434363836",
  "hostname": "factory-box-363836",
  "mcuType": "STM32H563ZI",
  "boardTypeName": "FactoryControlUnit",
  "boardTypeVersion": null,
  "firstConnectedAtEpoch": 1753000000,
  "lastConnectedAtEpoch": 1753500000,
  "webAdminPassword": null,
  "boardSettings": { "last_debug_probe_id": "066FFF525550755187144257" }
}
```

`boardTypeVersion`/`webAdminPassword`/`boardSettings` sind der projektübergreifende, generische Teil
des Board-Zustands (Backing für `IBuildContext.BoardTypeVersion`/`WebAdminPassword`/`BoardSettings`,
s. `dotnet_libs/firmware_builder_common`) -- `boardSettings` ist ein flaches String-Dictionary,
`"last_debug_probe_id"` ersetzt das frühere dedizierte `lastStlinkProbeSerial`-Feld (chip-
übergreifend nutzbar, nicht STM32-spezifisch benannt). Weitere wohlbekannte Schlüssel:
`"override_hostname"`, `"override_wifi_ap_ssid"`.

**`flash_events.jsonl`** -- ein JSON-Objekt pro Zeile, ein Eintrag pro verifiziert erfolgreichem
Flash-Vorgang (echtes Append-Only-Log: `File.AppendAllText`, kein Read-Modify-Write der ganzen
Historie bei jedem Flash):

```jsonl
{"flashedAtEpoch":1753500000,"cmakePreset":"Release","gitCommitHash":"a1b2c3d","gitBranch":"master","gitIsDirty":false,"firmwareVersion":"1.2.3"}
```

Kein separater Typ-Katalog (die vormaligen `mcu_types`/`board_types`-Tabellen entfallen ersatzlos):
`mcuType`/`boardTypeName` stehen direkt als Klartext-Feld in `board_info.json`, ohne Fremdschlüssel --
`mcu_types` enthielt ohnehin projektweit nur den einen Eintrag `"STM32H563ZI"`,
`board_types.version` war immer `1` und `.settings` immer `NULL` (nie geschrieben). Falls künftig
eine vom angeschlossenen Board unabhängige Liste ALLER bekannten Board-Typen gebraucht wird (z. B.
für eine Auswahl-UI): das lässt sich jederzeit nachträglich per Verzeichnis-Scan über alle
`stm32_boards/*/board_info.json` ermitteln (Distinct auf `boardTypeName`), ohne dass `BoardStateStore.cs`
dafür etwas vorhalten muss.

**Board-Type-Zuordnung über die Chip-UID (bzw. das daraus abgeleitete `boardId`), nicht über das
Preset:** `PrepareContextWithRealHardware` (Schritt 1) schlägt `boardId` in
dessen `board_info.json` nach (`BoardStateStore.TryGetBoardTypeName`). Existiert noch kein `board_info.json` (z. B.
brandneue Platine), greift `BuilderSettings.BoardDefaults.DefaultBoardTypeName` (aus `appsettings.json`, s.
Abschnitt 8) als Fallback -- derselbe Mechanismus liefert `IBuildContext.BoardTypeName` fuer JEDEN
Schritt, nicht nur fuer Schritt 1 (s. `Stm32BuildContext.BoardTypeName`). Das Ergebnis landet als
`boardName` in `device-ids.json`; `board_info.json` selbst wird unveraendert (keine eigene
Projektionsdatei mehr, vormals `board-variant.json`/`BoardVariant`) direkt nach `generated/`
gespiegelt (Schritt 4, `GenerateDeviceArtifacts` -- die einzige Ausnahme von "generierte Dateien nur
im Projekt", s. Abschnitt 3, da es kein Build-Derivat, sondern gespiegelter persistenter Zustand ist)
und wird von dort sowohl für `firmware_constants.hh`s `BOARD_NAME` (Schritt 7,
`ReadGitStatusAndGenerateFiles`) als auch beim tatsächlichen Flashen (Schritt 11, `FlashFirmware`,
liest aus dem Board-Archiv) für `boardTypeName` wiederverwendet.

Die Hardware-Revision kommt ausschliesslich aus dem CMake-Preset (s. Abschnitt 2), nicht aus
`board_info.json`.

`BOARD_NAME` (der Anzeigename in Firmware-Log/Web-UI, z. B. `"FactoryControlUnit"`) ist damit
identisch mit `board_info.json`s `boardTypeName`-Wert -- kein separater, ausführlicherer Anzeigestring
mehr (den gab es in der frueheren HAL-Firmware hartkodiert samt
`#ifdef BOARD_NUCLEO_H563ZI`-Umschaltung). `FW_VERSION_MAJOR/MINOR/PATCH` kommen unabhängig davon aus
`firmware-version.json` (Repo-Root, von Hand gepflegt bei einem Versions-Bump). Beide zusammen
generiert `ReadGitStatusAndGenerateFiles` (Phase 7) nach `generated/firmware_constants.hh`
und in `web/generated/build-info.ts`.

## 7. Web-Build-Plugin

`web/build-tools/vite-plugin-single-file-firmware-asset.ts` ersetzt die frühere Kombination aus
`vite-plugin-singlefile` + separatem Minify-Schritt + manuellem `npm run embed`: EIN Vite-Plugin,
das im selben `generateBundle`-Hook (a) JS/CSS in die `index.html` inlined (Kern angelehnt an
[`vite-plugin-singlefile`](https://github.com/richardtallent/vite-plugin-singlefile), MIT-lizenziert,
nachgebaut statt als Abhängigkeit eingebunden), (b) über `singlefile-minify.ts`
(`minifyHtmlDocument()`) Whitespace/Kommentare inkl. Lit-Templates entfernt und (c) Brotli-
komprimiert direkt nach `build/assets/index.html.br` schreibt. `BuildWebApp` (Phase 9) ist damit ein
einziger Vite-Build-Aufruf (aus `WebAppBuildService` per Kindprozess gestartet, s. Abschnitt 4)
ohne Nachbearbeitungsschritt.

## 8. Bekannte Annahmen / Hinweise

- **LAN8742-PHY-Adresse `0`** (rtoos `boards/fcu`, `board::phy_address`; PHYAD0 offen = interner
  Pull-down). Liest das System-Info-Panel "PHY nicht erreichbar", stimmt die Adresse nicht.

- **`builder/appsettings.json`** enthält persönliche Maschinenpfade (STM32CubeProgrammer-Pfad,
  OneDrive-Ordner für Board-Archiv/CA) und den `DefaultBoardTypeName`-Fallback (s. Abschnitt 6) und
  ist gitignored -- getrackt ist nur `appsettings.json.template`; ein MSBuild-Target
  (`EnsureAppSettings` in `builder.csproj`) legt die reale Datei bei jedem `dotnet build`/`dotnet run`
  automatisch daraus an, falls sie fehlt, ohne eine vorhandene zu überschreiben. Gebunden an die
  typsichere `BuilderSettings`-Konfigurationsklassen über die Standard-.NET-Konfigurationsmechanik
  (`Microsoft.Extensions.Configuration`) -- `STM32_PRG_PATH` bleibt zusätzlich als dokumentierte
  Umgebungsvariable überschreibbar (s. `Stm32ProgrammerOptions.ResolveStm32ProgrammerCli()`).
