klaus-liebler/factory_in_a_box/pcb_factory_control_unit/pcb_factory_control_unit.kicad_pcb

## KiCad design pcb_factory_control_unit/pcb_factory_control_unit.kicad_pcb (2026-11-12)

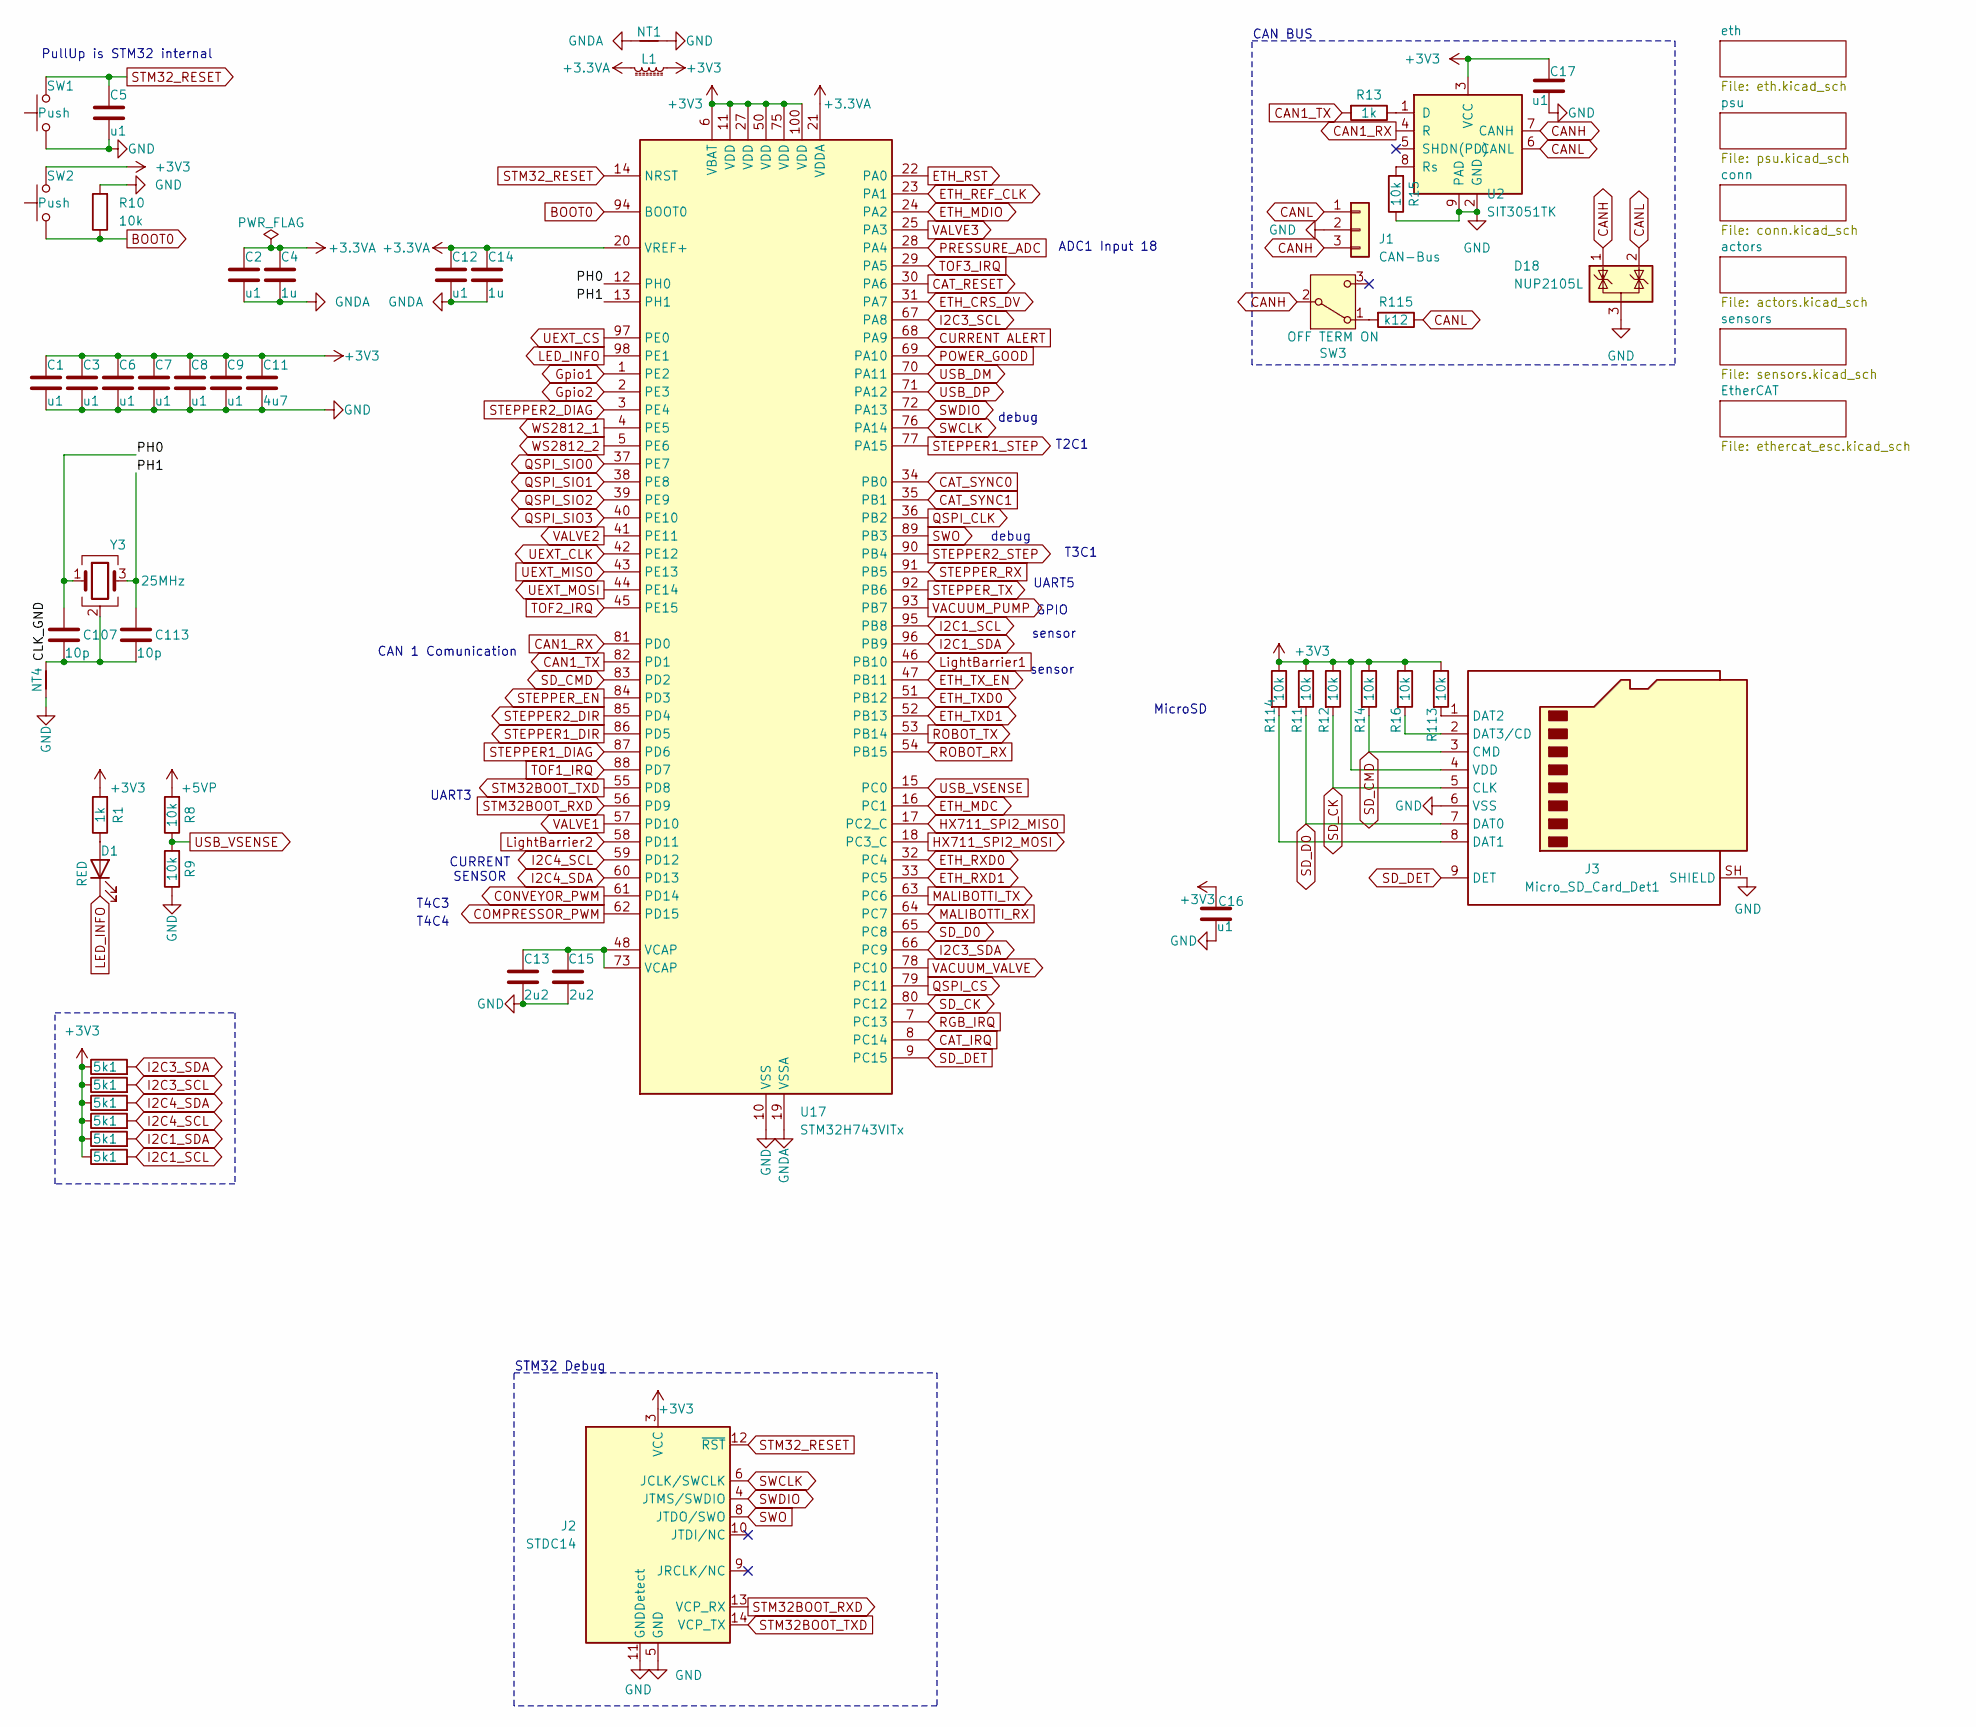
[picture p82: schematic pcb_factory_control_unit.kicad_sch]

Parts:
C1, C2, C3, C5, C6, C7, C8, C9, C12, C16, C17: u1; C_0402_1005Metric; MPN CL05B104KO5NNNC; LCSC C1525
C4, C14: 1u; C_0402_1005Metric; MPN CL05A105KA5NQNC; LCSC C52923
C11: 4u7; C_0402_1005Metric; LCSC C307423
C13, C15: 2u2; C_0402_1005Metric; MPN CL05A225MQ5NSNC; LCSC C12530
C107, C113: 10p; C_0402_1005Metric; MPN CC0402JRNPO9BN100; LCSC C106199
D1: RED; LED_1206_3216Metric_ReverseMount_Hole1.8x2.4mm; MPN P2-1206RTCS2-0.9T-F; LCSC C2827254
D18: NUP2105L; SOT-23; MPN NUP2105LT1G; LCSC C2976509
J1: CAN-Bus; JST_XH_B3B-XH-A_1x03_P2.50mm_Vertical_smaller
J2: STDC14; IDC-Header_2x07_P1.27mm_Vertical_SMD; LCSC C6332251
J3: Micro_SD_Card_Det1; microSD push; MPN TF PUSH; LCSC C381082
L1: 220R@100M; L_0603_1608Metric; MPN BLM18PG221SN1D; LCSC C80165
NT1, NT4: NetTie_2; NetTie-2_SMD_Pad0.5mm
R1, R13: 1k; R_0402_1005Metric; MPN 0402WGF1001TCE; LCSC C11702
R2, R3, R4, R5, R6, R7: 5k1; R_0402_1005Metric; MPN 0402WGF5101TCE; LCSC C25905
R8, R9, R10, R11, R12, R14, R15, R16, R113, R114: 10k; R_0402_1005Metric; MPN 0402WGF1002TCE; LCSC C25744
R115: k12; R_0805_2012Metric; MPN 0805W8F1200T5E; LCSC C17437
SW1, SW2: Push; SW_SPST_TL3342_smaller; LCSC C318884
SW3: OFF TERM ON; SW_SPDT_PCM12; MPN PCM12SMTR; LCSC C221841
U2: SIT3051TK; DFN-8-1EP_3x3mm_P0.65mm_EP1.55x2.4mm; LCSC C601078
U17: STM32H743VITx; LQFP-100_14x14mm_P0.5mm
Y3: 25MHz; Crystal_SMD_2016-4Pin_2.0x1.6mm; LCSC C19711739

Connections:
+3.3VA: C2.1, C4.1, C12.1, C14.1, L1.2, U17.20 (VREF+), U17.21 (VDDA)
+3V3: C1.1, C3.1, C6.1, C7.1, C8.1, C9.1, C11.1, C16.2, C17.1, J2.3 (VCC), J3.4 (VDD), L1.1, R1.2, R2.1, R3.1, R4.1, R5.1, R6.1, R7.1, R11.1, R12.1, R14.1, R16.1, R113.1, R114.1, SW2.2, U2.3 (VCC), U17.6 (VBAT), U17.11 (VDD), U17.27 (VDD), U17.50 (VDD), U17.75 (VDD), U17.100 (VDD); also elsewhere on the board
+5VP: R8.2; also elsewhere on the board
/CLK_GND: C107.2, C113.2, NT4.2, Y3.2 (G), Y3.4 (G)
/PH0: C107.1, U17.12 (PH0), Y3.1
/PH1: C113.1, U17.13 (PH1), Y3.3
BOOT0: R10.1, SW2.1, U17.94 (BOOT0)
CAN1_RX: U2.4 (R), U17.81 (PD0)
CAN1_TX: R13.2, U17.82 (PD1)
CANH: D18.1 (K), J1.3, SW3.2 (B), U2.7 (CANH)
CANL: D18.2 (K), J1.1, R115.1, U2.6 (CANL)
CAT_IRQ: U17.8 (PC14); also elsewhere on the board
CAT_RESET: U17.30 (PA6); also elsewhere on the board
CAT_SYNC0: U17.34 (PB0); also elsewhere on the board
CAT_SYNC1: U17.35 (PB1); also elsewhere on the board
COMPRESSOR_PWM: U17.62 (PD15); also elsewhere on the board
CONVEYOR_PWM: U17.61 (PD14); also elsewhere on the board
CURRENT ALERT: U17.68 (PA9); also elsewhere on the board
ETH_CRS_DV: U17.31 (PA7); also elsewhere on the board
ETH_MDC: U17.16 (PC1); also elsewhere on the board
ETH_MDIO: U17.24 (PA2); also elsewhere on the board
ETH_REF_CLK: U17.23 (PA1); also elsewhere on the board
ETH_RST: U17.22 (PA0); also elsewhere on the board
ETH_RXD0: U17.32 (PC4); also elsewhere on the board
ETH_RXD1: U17.33 (PC5); also elsewhere on the board
ETH_TXD0: U17.51 (PB12); also elsewhere on the board
ETH_TXD1: U17.52 (PB13); also elsewhere on the board
ETH_TX_EN: U17.47 (PB11); also elsewhere on the board
GND: C1.2, C3.2, C5.2, C6.2, C7.2, C8.2, C9.2, C11.2, C13.2, C15.2, C16.1, C17.2, D18.3 (A), J1.2, J2.5 (GND), J2.7 (GND), J2.11 (GNDDetect), J3.6 (VSS), J3.SH (SHIELD), NT1.2, NT4.1, R9.1, R10.2, R15.1, SW1.1, U2.2 (GND), U2.9 (PAD), U17.10 (VSS), U17.26 (VSS), U17.49 (VSS), U17.74 (VSS), U17.99 (VSS); also elsewhere on the board
GNDA: C2.2, C4.2, C12.2, C14.2, NT1.1, U17.19 (VSSA)
Gpio1: U17.1 (PE2); also elsewhere on the board
Gpio2: U17.2 (PE3); also elsewhere on the board
HX711_SPI2_MISO: U17.17 (PC2_C); also elsewhere on the board
HX711_SPI2_MOSI: U17.18 (PC3_C); also elsewhere on the board
I2C1_SCL: R7.2, U17.95 (PB8); also elsewhere on the board
I2C1_SDA: R6.2, U17.96 (PB9); also elsewhere on the board
I2C3_SCL: R3.2, U17.67 (PA8); also elsewhere on the board
I2C3_SDA: R2.2, U17.66 (PC9); also elsewhere on the board
I2C4_SCL: R5.2, U17.59 (PD12); also elsewhere on the board
I2C4_SDA: R4.2, U17.60 (PD13); also elsewhere on the board
LED_INFO: D1.1 (K), U17.98 (PE1)
LightBarrier1: U17.46 (PB10); also elsewhere on the board
LightBarrier2: U17.58 (PD11); also elsewhere on the board
MALIBOTTI_RX: U17.64 (PC7); also elsewhere on the board
MALIBOTTI_TX: U17.63 (PC6); also elsewhere on the board
unnamed: C13.1, C15.1, U17.48 (VCAP), U17.73 (VCAP)
unnamed: D1.2 (A), R1.1
unnamed: J3.8 (DAT1), R114.2
unnamed: J3.1 (DAT2), R113.2
unnamed: J3.2 (DAT3/CD), R16.2
unnamed: R115.2, SW3.1 (A)
unnamed: R13.1, U2.1 (D)
unnamed: R15.2, U2.8 (Rs)
POWER_GOOD: U17.69 (PA10); also elsewhere on the board
PRESSURE_ADC: U17.28 (PA4); also elsewhere on the board
QSPI_CLK: U17.36 (PB2); also elsewhere on the board
QSPI_CS: U17.79 (PC11); also elsewhere on the board
QSPI_SIO0: U17.37 (PE7); also elsewhere on the board
QSPI_SIO1: U17.38 (PE8); also elsewhere on the board
QSPI_SIO2: U17.39 (PE9); also elsewhere on the board
QSPI_SIO3: U17.40 (PE10); also elsewhere on the board
RGB_IRQ: U17.7 (PC13); also elsewhere on the board
ROBOT_RX: U17.54 (PB15); also elsewhere on the board
ROBOT_TX: U17.53 (PB14); also elsewhere on the board
SD_CK: J3.5 (CLK), R12.2, U17.80 (PC12)
SD_CMD: J3.3 (CMD), R14.2, U17.83 (PD2)
SD_D0: J3.7 (DAT0), R11.2, U17.65 (PC8)
SD_DET: J3.9 (DET), U17.9 (PC15)
STEPPER1_DIAG: U17.87 (PD6); also elsewhere on the board
STEPPER1_DIR: U17.86 (PD5); also elsewhere on the board
STEPPER1_STEP: U17.77 (PA15); also elsewhere on the board
STEPPER2_DIAG: U17.3 (PE4); also elsewhere on the board
STEPPER2_DIR: U17.85 (PD4); also elsewhere on the board
STEPPER2_STEP: U17.90 (PB4); also elsewhere on the board
STEPPER_EN: U17.84 (PD3); also elsewhere on the board
STEPPER_RX: U17.91 (PB5); also elsewhere on the board
STEPPER_TX: U17.92 (PB6); also elsewhere on the board
STM32BOOT_RXD: J2.13 (VCP_RX), U17.56 (PD9)
STM32BOOT_TXD: J2.14 (VCP_TX), U17.55 (PD8)
STM32_RESET: C5.1, J2.12 (~RST), SW1.2, U17.14 (NRST)
SWCLK: J2.6 (JCLK/SWCLK), U17.76 (PA14)
SWDIO: J2.4 (JTMS/SWDIO), U17.72 (PA13)
SWO: J2.8 (JTDO/SWO), U17.89 (PB3)
TOF1_IRQ: U17.88 (PD7); also elsewhere on the board
TOF2_IRQ: U17.45 (PE15); also elsewhere on the board
TOF3_IRQ: U17.29 (PA5); also elsewhere on the board
UEXT_CLK: U17.42 (PE12); also elsewhere on the board
UEXT_CS: U17.97 (PE0); also elsewhere on the board
UEXT_MISO: U17.43 (PE13); also elsewhere on the board
UEXT_MOSI: U17.44 (PE14); also elsewhere on the board
USB_DM: U17.70 (PA11); also elsewhere on the board
USB_DP: U17.71 (PA12); also elsewhere on the board
USB_VSENSE: R8.1, R9.2, U17.15 (PC0)
VACUUM_PUMP: U17.93 (PB7); also elsewhere on the board
VACUUM_VALVE: U17.78 (PC10); also elsewhere on the board
VALVE1: U17.57 (PD10); also elsewhere on the board
VALVE2: U17.41 (PE11); also elsewhere on the board
VALVE3: U17.25 (PA3); also elsewhere on the board
WS2812_1: U17.4 (PE5); also elsewhere on the board
WS2812_2: U17.5 (PE6); also elsewhere on the board

Notes on the sheet:
T4C3
CAN 1 Comunication
debug
MicroSD
T2C1
UART5
CAN BUS
UART3
sensor
ADC1 Input 18
STM32 Debug
CURRENT SENSOR
PullUp is STM32 internal
T4C4
T3C1
GPIO

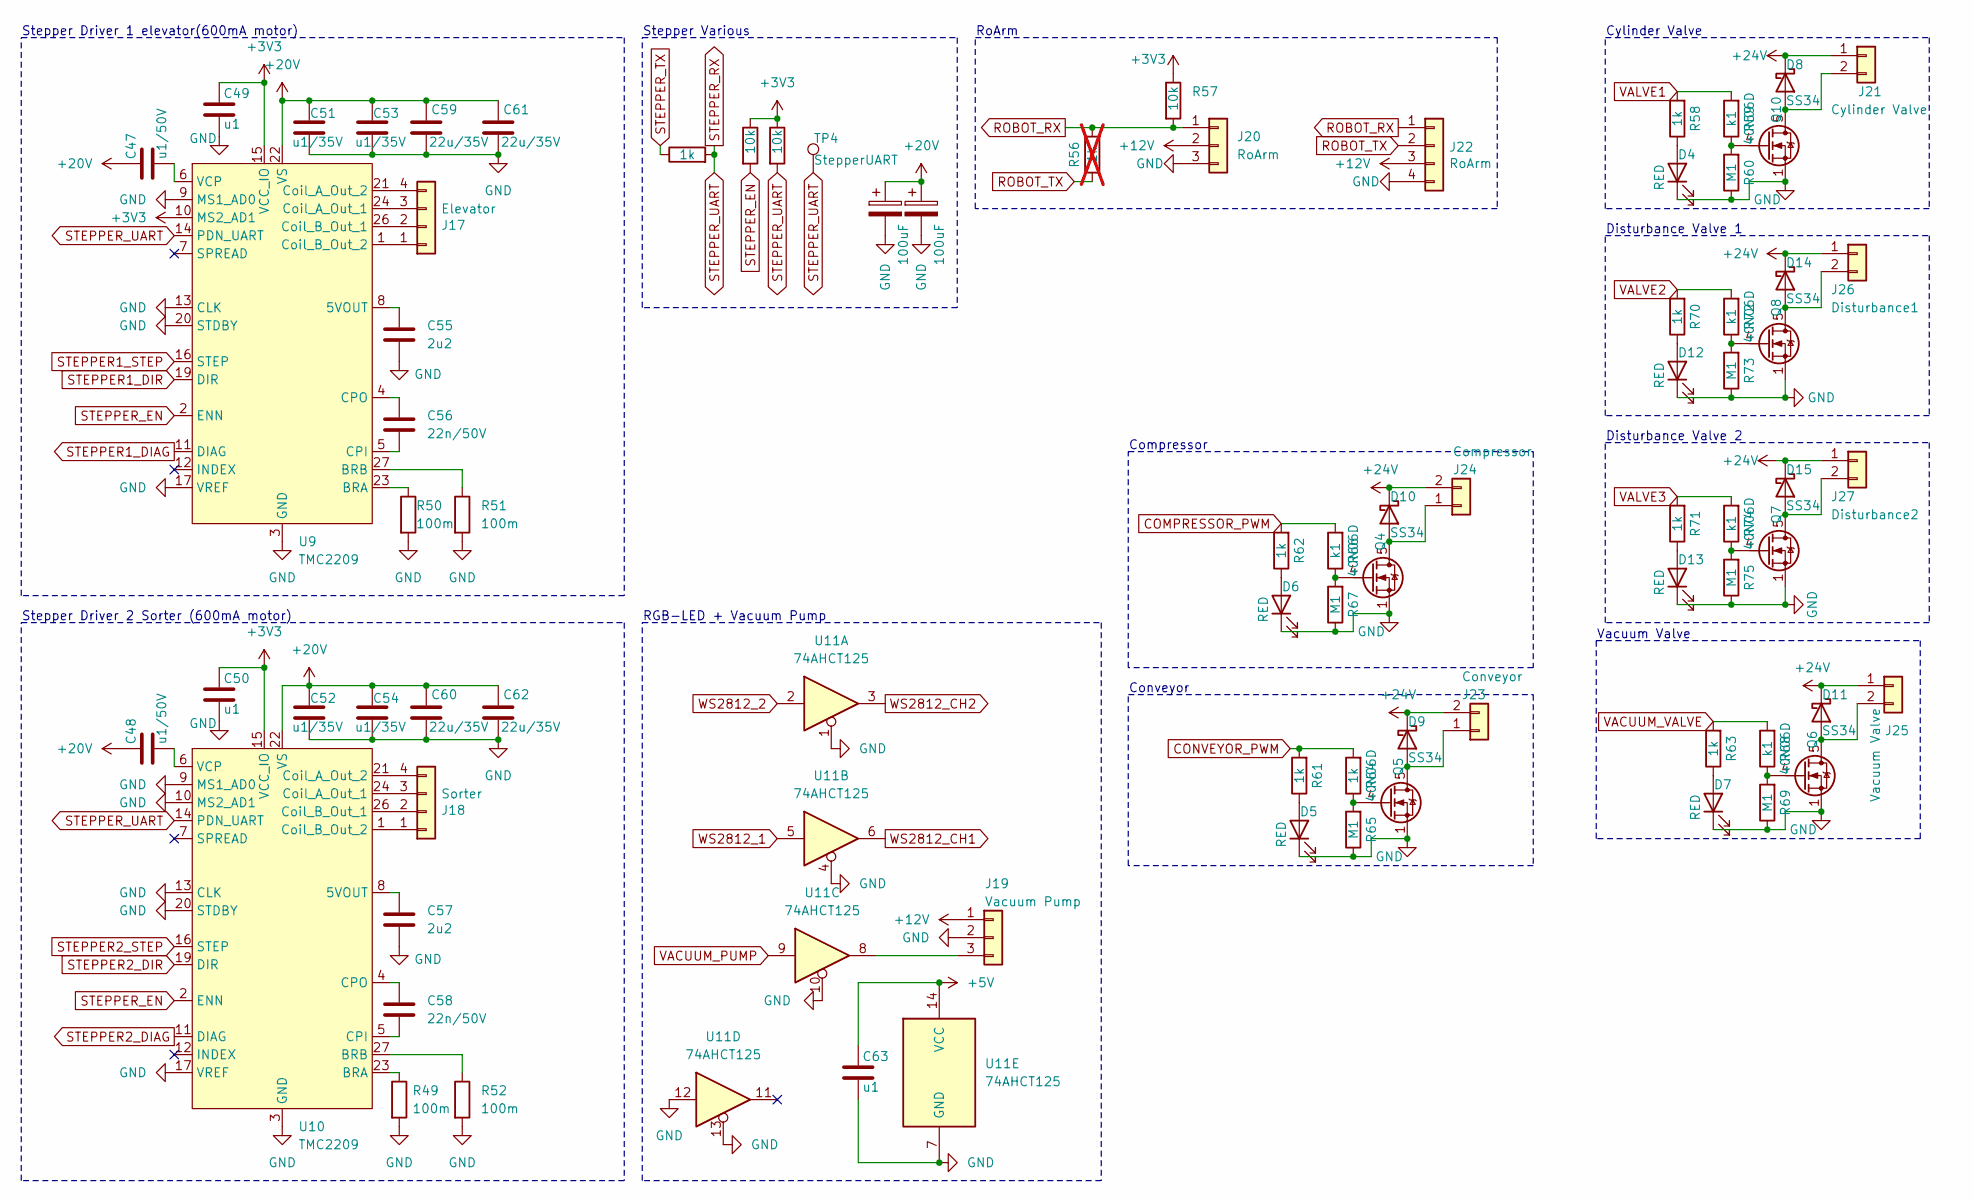
[picture p83: schematic actors.kicad_sch]

Parts:
C47, C48: u1/50V; C_0805_2012Metric; MPN CC0805KRX7R9BB104; LCSC C49678
C49, C50, C63: u1; C_0402_1005Metric; MPN CL05B104KO5NNNC; LCSC C1525
C51, C52, C53, C54: u1/35V; C_0805_2012Metric; MPN CC0805KRX7R9BB104; LCSC C49678
C55, C57: 2u2; C_0402_1005Metric; MPN CL05A225MQ5NSNC; LCSC C12530
C56, C58: 22n/50V; C_0402_1005Metric; MPN 0402B223K500NT; LCSC C1532
C59, C60, C61, C62: 22u/35V; C_0805_2012Metric; MPN CGA0805X5R226M350MT; LCSC C6119901
C64, C65: 100uF; CP_Elec_6.3x7.7; MPN RVT1V101M0607; LCSC C72478
D4, D5, D6, D7, D12, D13: RED; LED_1206_3216Metric_ReverseMount_Hole1.8x2.4mm; MPN P2-1206RTCS2-0.9T-F; LCSC C2827254
D8, D9, D10, D11, D14, D15: SS34; D_SMA; MPN SS34; LCSC C8678
J17: Elevator; JST_XH_B4B-XH-A_1x04_P2.50mm_Vertical_smaller; MPN XH-4AW
J18: Sorter; JST_XH_B4B-XH-A_1x04_P2.50mm_Vertical_smaller; MPN XH-4AW
J19: Vacuum Pump; JST_XH_B3B-XH-A_1x03_P2.50mm_Vertical_smaller
J20: RoArm; Molex_SPOX_5267-03A_1x03_P2.50mm_Vertical; MPN 5267-03A / 22035035
J21: Cylinder Valve; JST_XH_B2B-XH-A_1x02_P2.50mm_Vertical
J22: RoArm; JST_XH_B4B-XH-A_1x04_P2.50mm_Vertical_smaller; MPN XH-4AW
J23: Conveyor; PhoenixContact_MC_1,5_2-G-3.5_1x02_P3.50mm_Horizontal_small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
J24: Compressor; PhoenixContact_MC_1,5_2-G-3.5_1x02_P3.50mm_Horizontal_small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
J25: Vacuum Valve; JST_XH_B2B-XH-A_1x02_P2.50mm_Vertical
J26: Disturbance1; JST_XH_B2B-XH-A_1x02_P2.50mm_Vertical
J27: Disturbance2; JST_XH_B2B-XH-A_1x02_P2.50mm_Vertical
Q4, Q5, Q6, Q7, Q8, Q10: 40N06D; VSON-8_3.3x3.3mm_P0.65mm_NexFET; MPN 40N06D; LCSC C7543836
R49, R50, R51, R52: 100m; R_1206_3216Metric; MPN FRM121WFR100TM; LCSC C7467250
R53, R58, R61, R62, R63, R64, R70, R71: 1k; R_0402_1005Metric; MPN 0402WGF1001TCE; LCSC C11702
R54, R55, R57: 10k; R_0402_1005Metric; MPN 0402WGF1002TCE; LCSC C25744
R56: 1k; R_0805_2012Metric_Pad1.20x1.40mm_HandSolder; not fitted
R59, R66, R68, R72, R74: k1; R_0402_1005Metric; MPN 0402WGF1000TCE; LCSC C25076
R60, R65, R67, R69, R73, R75: M1; R_0402_1005Metric; MPN 0402WGF1003TCE; LCSC C25741
TP4: StepperUART; TestPoint_THTPad_D1.0mm_Drill0.5mm
U9, U10: TMC2209; QFN-28-1EP_5x5mm_P0.5mm_EP3.75x3.75mm_ThermalVias; MPN TMC2209-LA-T; LCSC C2150710
U11: 74AHCT125; SOIC-14_3.9x8.7mm_P1.27mm; LCSC C155176

Connections:
+3V3: C49.1, C50.1, R54.1, R55.1, R57.1, U9.10 (MS2_AD1), U9.15 (VCC_IO), U10.15 (VCC_IO); also elsewhere on the board
+5V: C63.1, U11.14 (VCC); also elsewhere on the board
+12V: J19.1, J20.2, J22.3; also elsewhere on the board
+20V: C47.1, C48.1, C51.1, C52.1, C53.1, C54.1, C59.2, C60.2, C61.2, C62.2, C64.1, C65.1, U9.22 (VS), U9.28 (VS), U10.22 (VS), U10.28 (VS); also elsewhere on the board
+24V: D8.1 (K), D9.1 (K), D10.1 (K), D11.1 (K), D14.1 (K), D15.1 (K), J21.1, J23.2, J24.2, J25.1, J26.1, J27.1; also elsewhere on the board
COMPRESSOR_PWM: R62.2, R66.2; also elsewhere on the board
CONVEYOR_PWM: R61.2, R64.2; also elsewhere on the board
GND: C49.2, C50.2, C51.2, C52.2, C53.2, C54.2, C55.2, C57.2, C59.1, C60.1, C61.1, C62.1, C63.2, C64.2, C65.2, D4.1 (K), D5.1 (K), D6.1 (K), D7.1 (K), D12.1 (K), D13.1 (K), J19.2, J20.3, J22.4, Q4.1 (S), Q4.2 (S), Q4.3 (S), Q5.1 (S), Q5.2 (S), Q5.3 (S), Q6.1 (S), Q6.2 (S), Q6.3 (S), Q7.1 (S), Q7.2 (S), Q7.3 (S), Q8.1 (S), Q8.2 (S), Q8.3 (S), Q10.1 (S), Q10.2 (S), Q10.3 (S), R49.2, R50.2, R51.2, R52.2, R60.1, R65.1, R67.1, R69.1, R73.1, R75.1, U9.3 (GND), U9.9 (MS1_AD0), U9.13 (CLK), U9.17 (VREF), U9.18 (GND), U9.20 (STDBY), U9.25 (GND), U9.29 (PAD), U10.3 (GND), U10.9 (MS1_AD0), U10.10 (MS2_AD1), U10.13 (CLK), U10.17 (VREF), U10.18 (GND), U10.20 (STDBY), U10.25 (GND), U10.29 (PAD), U11.1, U11.4, U11.7 (GND), U11.10, U11.12, U11.13; also elsewhere on the board
unnamed: D4.2 (A), R58.1
unnamed: D5.2 (A), R61.1
unnamed: D6.2 (A), R62.1
unnamed: D7.2 (A), R63.1
unnamed: D8.2 (A), J21.2, Q10.5 (D)
unnamed: D9.2 (A), J23.1, Q5.5 (D)
unnamed: D10.2 (A), J24.1, Q4.5 (D)
unnamed: D11.2 (A), J25.2, Q6.5 (D)
unnamed: D12.2 (A), R70.1
unnamed: D13.2 (A), R71.1
unnamed: D14.2 (A), J26.2, Q8.5 (D)
unnamed: D15.2 (A), J27.2, Q7.5 (D)
unnamed: J17.1, U9.1 (Coil_B_Out_2)
unnamed: J17.2, U9.26 (Coil_B_Out_1)
unnamed: J17.3, U9.24 (Coil_A_Out_1)
unnamed: J17.4, U9.21 (Coil_A_Out_2)
unnamed: J18.1, U10.1 (Coil_B_Out_2)
unnamed: J18.2, U10.26 (Coil_B_Out_1)
unnamed: J18.3, U10.24 (Coil_A_Out_1)
unnamed: J18.4, U10.21 (Coil_A_Out_2)
unnamed: J19.3, U11.8
unnamed: Q4.4 (G), R66.1, R67.2
unnamed: Q5.4 (G), R64.1, R65.2
unnamed: Q6.4 (G), R68.1, R69.2
unnamed: Q7.4 (G), R74.1, R75.2
unnamed: Q8.4 (G), R72.1, R73.2
unnamed: Q10.4 (G), R59.1, R60.2
unnamed: C55.1, U9.8 (5VOUT)
unnamed: R50.1, U9.23 (BRA)
unnamed: R51.1, U9.27 (BRB)
unnamed: C56.2, U9.5 (CPI)
unnamed: C56.1, U9.4 (CPO)
unnamed: C47.2, U9.6 (VCP)
unnamed: C57.1, U10.8 (5VOUT)
unnamed: R49.1, U10.23 (BRA)
unnamed: R52.1, U10.27 (BRB)
unnamed: C58.2, U10.5 (CPI)
unnamed: C58.1, U10.4 (CPO)
unnamed: C48.2, U10.6 (VCP)
ROBOT_RX: J20.1, J22.1, R56.2, R57.2; also elsewhere on the board
ROBOT_TX: J22.2, R56.1; also elsewhere on the board
STEPPER1_DIAG: U9.11 (DIAG); also elsewhere on the board
STEPPER1_DIR: U9.19 (DIR); also elsewhere on the board
STEPPER1_STEP: U9.16 (STEP); also elsewhere on the board
STEPPER2_DIAG: U10.11 (DIAG); also elsewhere on the board
STEPPER2_DIR: U10.19 (DIR); also elsewhere on the board
STEPPER2_STEP: U10.16 (STEP); also elsewhere on the board
STEPPER_EN: R54.2, U9.2 (ENN), U10.2 (ENN); also elsewhere on the board
STEPPER_RX: R53.2, R55.2, TP4.1 (1_1), U9.14 (PDN_UART), U10.14 (PDN_UART); also elsewhere on the board
STEPPER_TX: R53.1; also elsewhere on the board
VACUUM_PUMP: U11.9; also elsewhere on the board
VACUUM_VALVE: R63.2, R68.2; also elsewhere on the board
VALVE1: R58.2, R59.2; also elsewhere on the board
VALVE2: R70.2, R72.2; also elsewhere on the board
VALVE3: R71.2, R74.2; also elsewhere on the board
WS2812_1: U11.5; also elsewhere on the board
WS2812_2: U11.2; also elsewhere on the board
WS2812_CH1: U11.6; also elsewhere on the board
WS2812_CH2: U11.3; also elsewhere on the board

Notes on the sheet:
RoArm
Disturbance Valve 1
Vacuum Valve
Compressor
Stepper Driver 2 Sorter (600mA motor)
Disturbance Valve 2
Stepper Driver 1 elevator(600mA motor)
Conveyor
RGB-LED + Vacuum Pump
Stepper Various
Cylinder Valve

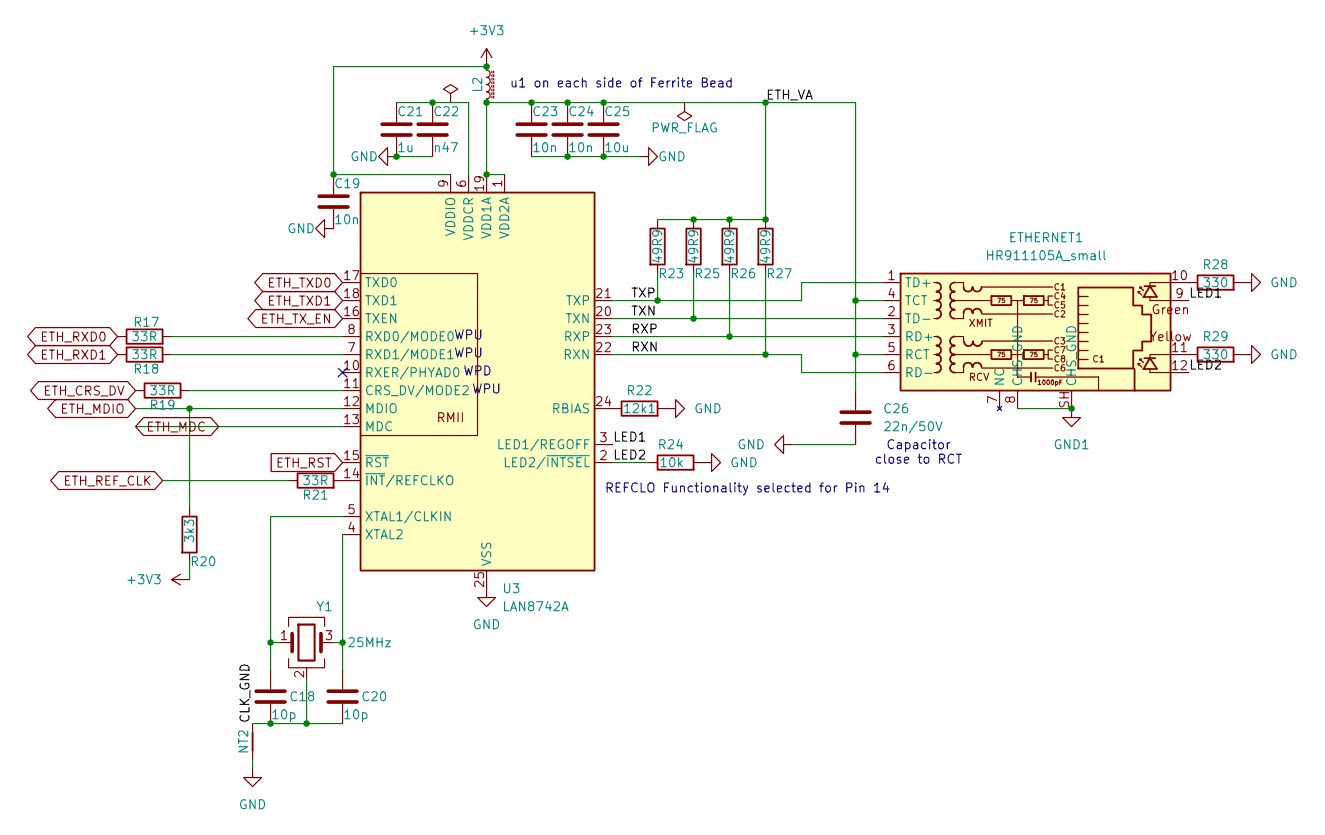
[picture p84: schematic eth.kicad_sch]

Parts:
C18, C20: 10p; C_0402_1005Metric; MPN CC0402JRNPO9BN100; LCSC C106199
C19, C23, C24: 10n; C_0402_1005Metric; MPN FCC0402B103K500AT; LCSC C5137480
C21: 1u; C_0402_1005Metric; MPN CL05A105KA5NQNC; LCSC C52923
C22: n47; C_0402_1005Metric; MPN GRM1555C1H471JA01D; LCSC C76971
C25: 10u; C_0805_2012Metric; MPN CGA0805X5R106K500MT; LCSC C6119889
C26: 22n/50V; C_0402_1005Metric; MPN 0402B223K500NT; LCSC C1532
ETHERNET1: HR911105A_small; RJ45_HANRUN_HR911105A; LCSC C12074
L2: 220R@100M; L_0603_1608Metric; MPN BLM18PG221SN1D; LCSC C80165
NT2: NetTie_2; NetTie-2_SMD_Pad0.5mm
R17, R18, R19, R21: 33R; R_0402_1005Metric; LCSC C25105
R20: 3k3; R_0402_1005Metric; MPN 0402WGF3301TCE; LCSC C25890
R22: 12k1; R_0402_1005Metric; LCSC C25852
R23, R25, R26, R27: 49R9; R_0402_1005Metric; LCSC C25120
R24: 10k; R_0402_1005Metric; MPN 0402WGF1002TCE; LCSC C25744
R28, R29: 330; R_0402_1005Metric; MPN 0402WGF3300TCE; LCSC C25104
U3: LAN8742A; VQFN-24-1EP_4x4mm_P0.5mm_EP2.5x2.5mm_ThermalVias; LCSC C621425
Y1: 25MHz; Crystal_SMD_2016-4Pin_2.0x1.6mm; LCSC C19711739

Connections:
+3V3: C19.1, L2.1, R20.2, U3.9 (VDDIO); also elsewhere on the board
/eth/CLK_GND: C18.2, C20.2, NT2.2, Y1.2 (G), Y1.4 (G)
/eth/ETH_VA: C23.1, C24.1, C25.1, C26.1, ETHERNET1.4 (TCT), ETHERNET1.5 (RCT), L2.2, R23.1, R25.1, R26.1, R27.1, U3.1 (VDD2A), U3.19 (VDD1A)
/eth/LED1: ETHERNET1.9, U3.3 (LED1/REGOFF)
/eth/LED2: ETHERNET1.12, R24.1, U3.2 (LED2/~INTSEL)
/eth/RXN: ETHERNET1.6 (RD-), R27.2, U3.22 (RXN)
/eth/RXP: ETHERNET1.3 (RD+), R26.2, U3.23 (RXP)
/eth/TXN: ETHERNET1.2 (TD-), R25.2, U3.20 (TXN)
/eth/TXP: ETHERNET1.1 (TD+), R23.2, U3.21 (TXP)
ETH_CRS_DV: R19.1; also elsewhere on the board
ETH_MDC: U3.13 (MDC); also elsewhere on the board
ETH_MDIO: R20.1, U3.12 (MDIO); also elsewhere on the board
ETH_REF_CLK: R21.1; also elsewhere on the board
ETH_RST: U3.15 (~RST); also elsewhere on the board
ETH_RXD0: R17.1; also elsewhere on the board
ETH_RXD1: R18.1; also elsewhere on the board
ETH_TXD0: U3.17 (TXD0); also elsewhere on the board
ETH_TXD1: U3.18 (TXD1); also elsewhere on the board
ETH_TX_EN: U3.16 (TXEN); also elsewhere on the board
GND: C19.2, C21.2, C22.2, C23.2, C24.2, C25.2, C26.2, NT2.1, R22.2, R24.2, R28.2, R29.2, U3.25 (VSS); also elsewhere on the board
GND1: ETHERNET1.8 (CHS_GND), ETHERNET1.SH (CHS_GND); also elsewhere on the board
unnamed: ETHERNET1.10, R28.1
unnamed: ETHERNET1.11, R29.1
unnamed: R19.2, U3.11 (CRS_DV/MODE2)
unnamed: R22.1, U3.24 (RBIAS)
unnamed: R17.2, U3.8 (RXD0/MODE0)
unnamed: R18.2, U3.7 (RXD1/MODE1)
unnamed: C21.1, C22.1, U3.6 (VDDCR)
unnamed: C18.1, U3.5 (XTAL1/CLKIN), Y1.1
unnamed: C20.1, U3.4 (XTAL2), Y1.3
unnamed: R21.2, U3.14 (~INT/REFCLKO)

Notes on the sheet:
Capacitor close to RCT
u1 on each side of Ferrite Bead
WPU
REFCLO Functionality selected for Pin 14
WPD

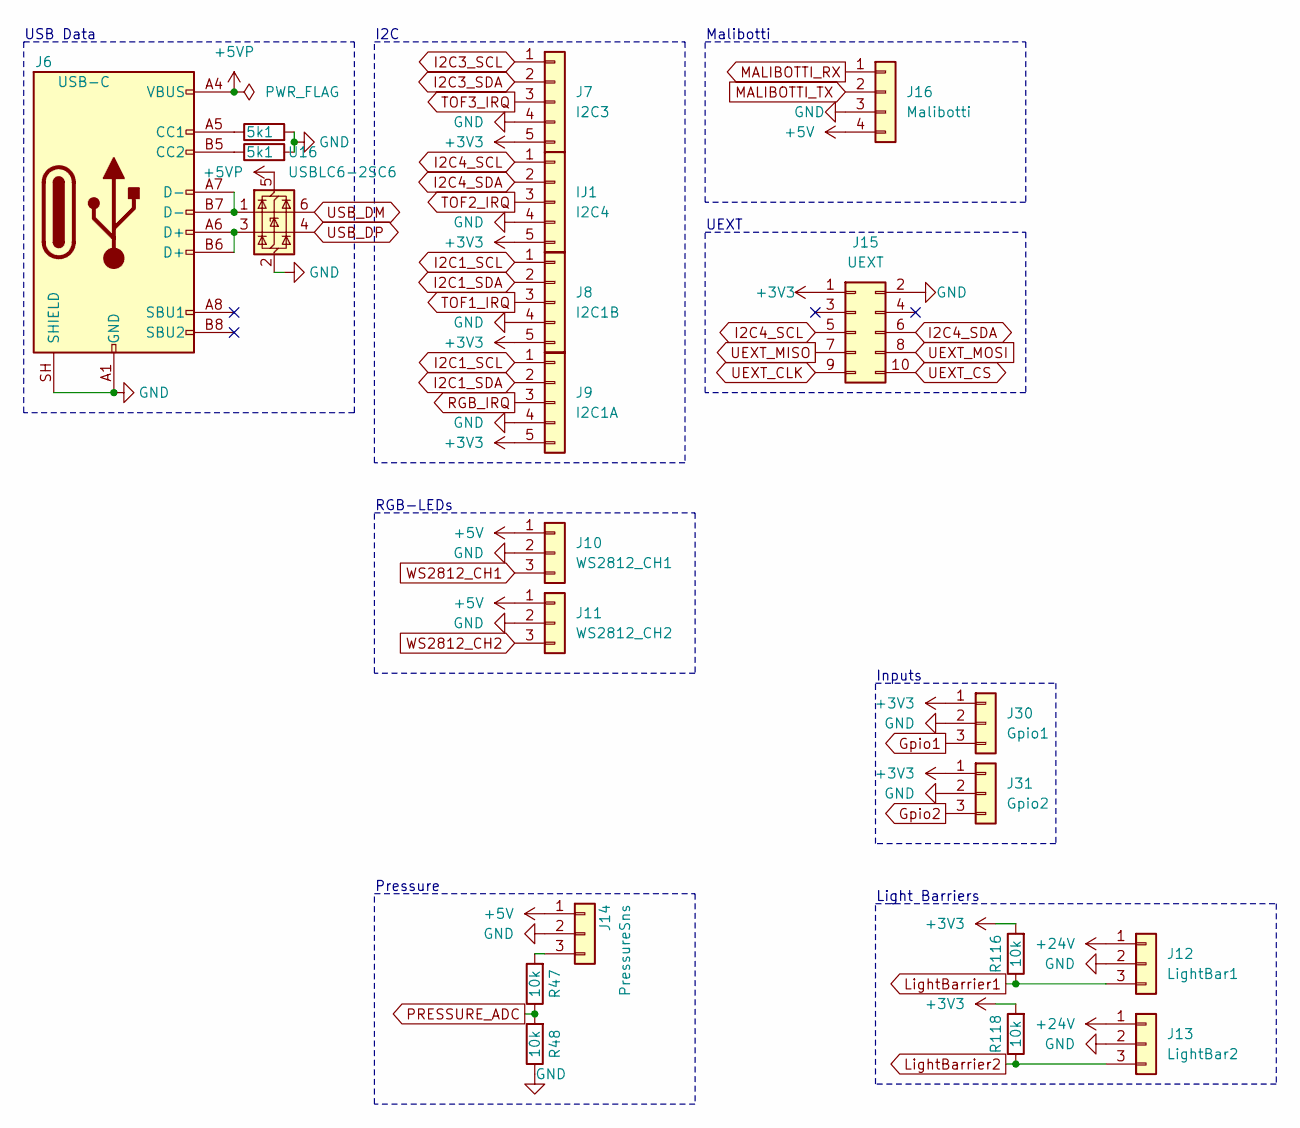
[picture p85: schematic conn.kicad_sch]

Parts:
IJ1: I2C4; JST_XH_B5B-XH-A_1x05_P2.50mm_Vertical_smaller
J6: USB-C; USB_C_Receptacle_HRO_TYPE-C-31-M-12_smaller; MPN TYPE-C-31-M-12; LCSC C165948
J7: I2C3; JST_XH_B5B-XH-A_1x05_P2.50mm_Vertical_smaller
J8: I2C1B; JST_XH_B5B-XH-A_1x05_P2.50mm_Vertical_smaller
J9: I2C1A; JST_XH_B5B-XH-A_1x05_P2.50mm_Vertical_smaller
J10: WS2812_CH1; JST_XH_B3B-XH-A_1x03_P2.50mm_Vertical_smaller
J11: WS2812_CH2; JST_XH_B3B-XH-A_1x03_P2.50mm_Vertical_smaller
J12: LightBar1; JST_XH_B3B-XH-A_1x03_P2.50mm_Vertical_smaller
J13: LightBar2; JST_XH_B3B-XH-A_1x03_P2.50mm_Vertical_smaller
J14: PressureSns; JST_XH_B3B-XH-A_1x03_P2.50mm_Vertical_smaller
J15: UEXT; IDC-Header_2x05_P2.54mm_Vertical
J16: Malibotti; JST_XH_B4B-XH-A_1x04_P2.50mm_Vertical_smaller
J30: Gpio1; JST_XH_B3B-XH-A_1x03_P2.50mm_Vertical_smaller
J31: Gpio2; JST_XH_B3B-XH-A_1x03_P2.50mm_Vertical_smaller
R45, R46: 5k1; R_0402_1005Metric; MPN 0402WGF5101TCE; LCSC C25905
R47, R48, R116, R118: 10k; R_0402_1005Metric; MPN 0402WGF1002TCE; LCSC C25744
U16: USBLC6-2SC6; SOT-23-6; MPN USBLC6-2SC6; LCSC C2687116

Connections:
+3V3: IJ1.5, J7.5, J8.5, J9.5, J15.1, J30.1, J31.1, R116.2, R118.2; also elsewhere on the board
+5V: J10.1, J11.1, J14.1, J16.4; also elsewhere on the board
+5VP: J6.A4 (VBUS), J6.A9 (VBUS), J6.B4 (VBUS), J6.B9 (VBUS), U16.5 (VBUS); also elsewhere on the board
+24V: J12.1, J13.1; also elsewhere on the board
GND: IJ1.4, J6.A1 (GND), J6.A12 (GND), J6.B1 (GND), J6.B12 (GND), J6.SH (SHIELD), J7.4, J8.4, J9.4, J10.2, J11.2, J12.2, J13.2, J14.2, J15.2, J16.3, J30.2, J31.2, R45.2, R46.2, R48.1, U16.2 (GND); also elsewhere on the board
Gpio1: J30.3; also elsewhere on the board
Gpio2: J31.3; also elsewhere on the board
I2C1_SCL: J8.1, J9.1; also elsewhere on the board
I2C1_SDA: J8.2, J9.2; also elsewhere on the board
I2C3_SCL: J7.1; also elsewhere on the board
I2C3_SDA: J7.2; also elsewhere on the board
I2C4_SCL: IJ1.1, J15.5; also elsewhere on the board
I2C4_SDA: IJ1.2, J15.6; also elsewhere on the board
LightBarrier1: J12.3, R116.1; also elsewhere on the board
LightBarrier2: J13.3, R118.1; also elsewhere on the board
MALIBOTTI_RX: J16.1; also elsewhere on the board
MALIBOTTI_TX: J16.2; also elsewhere on the board
unnamed: J6.A5 (CC1), R45.1
unnamed: J6.B5 (CC2), R46.1
unnamed: J6.A6 (D+), J6.B6 (D+), U16.3 (I/O2)
unnamed: J6.A7 (D-), J6.B7 (D-), U16.1 (I/O1)
unnamed: J14.3, R47.2
PRESSURE_ADC: R47.1, R48.2; also elsewhere on the board
RGB_IRQ: J9.3; also elsewhere on the board
TOF1_IRQ: J8.3; also elsewhere on the board
TOF2_IRQ: IJ1.3; also elsewhere on the board
TOF3_IRQ: J7.3; also elsewhere on the board
UEXT_CLK: J15.9; also elsewhere on the board
UEXT_CS: J15.10; also elsewhere on the board
UEXT_MISO: J15.7; also elsewhere on the board
UEXT_MOSI: J15.8; also elsewhere on the board
USB_DM: U16.6 (I/O1); also elsewhere on the board
USB_DP: U16.4 (I/O2); also elsewhere on the board
WS2812_CH1: J10.3; also elsewhere on the board
WS2812_CH2: J11.3; also elsewhere on the board

Notes on the sheet:
Pressure
I2C
UEXT
Light Barriers
Inputs
RGB-LEDs
USB Data
Malibotti

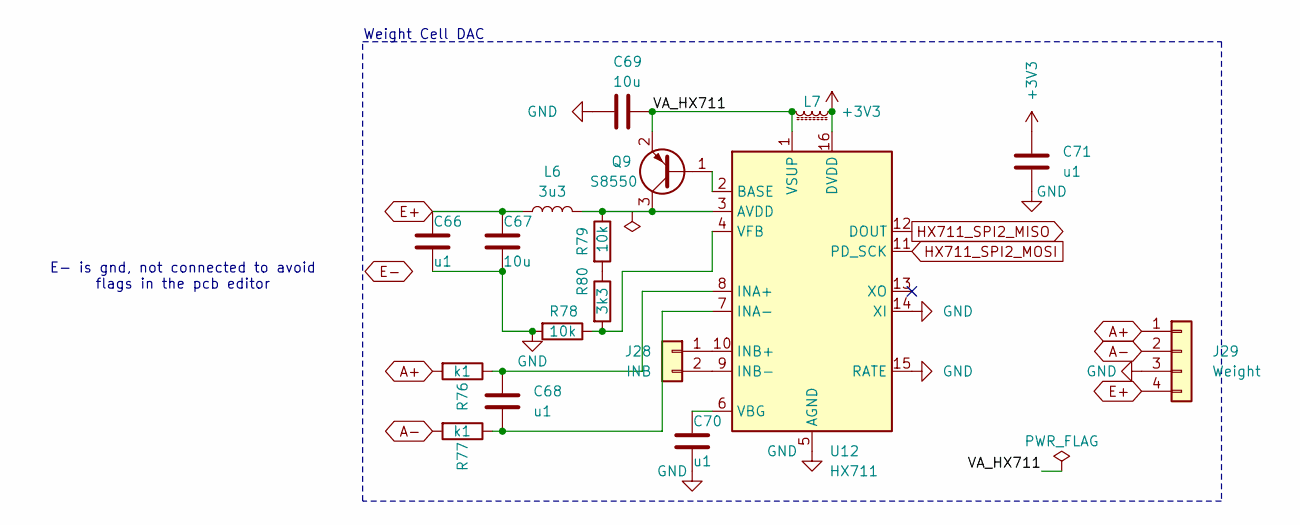
[picture p86: schematic sensors.kicad_sch]

Parts:
C66, C68, C70, C71: u1; C_0402_1005Metric; MPN CL05B104KO5NNNC; LCSC C1525
C67, C69: 10u; C_0805_2012Metric; MPN CGA0805X5R106K500MT; LCSC C6119889
J28: INB; JST_XH_B2B-XH-A_1x02_P2.50mm_Vertical
J29: Weight; JST_XH_B4B-XH-A_1x04_P2.50mm_Vertical_smaller
L6: 3u3; L_0805_2012Metric; LCSC C162585
L7: 220R@100M; L_0603_1608Metric; MPN BLM18PG221SN1D; LCSC C80165
Q9: S8550; SOT-23; MPN S8550; LCSC C364313
R76, R77: k1; R_0402_1005Metric; MPN 0402WGF1000TCE; LCSC C25076
R78, R79: 10k; R_0402_1005Metric; MPN 0402WGF1002TCE; LCSC C25744
R80: 3k3; R_0402_1005Metric; MPN 0402WGF3301TCE; LCSC C25890
U12: HX711; SOIC-16_3.9x9.9mm_P1.27mm; LCSC C6705483

Connections:
+3V3: C71.1, L7.1, U12.16 (DVDD); also elsewhere on the board
/sensors/VA_HX711: C69.1, L7.2, Q9.2 (E), U12.1 (VSUP)
A+: J29.1, R76.2
A-: J29.2, R77.2
E+: C66.1, C67.1, J29.4, L6.1
GND: C66.2, C67.2, C69.2, C70.2, C71.2, J29.3, R78.2, U12.5 (AGND), U12.14 (XI), U12.15 (RATE); also elsewhere on the board
HX711_SPI2_MISO: U12.12 (DOUT); also elsewhere on the board
HX711_SPI2_MOSI: U12.11 (PD_SCK); also elsewhere on the board
unnamed: J28.1, U12.10 (INB+)
unnamed: J28.2, U12.9 (INB-)
unnamed: Q9.1 (B), U12.2 (BASE)
unnamed: L6.2, Q9.3 (C), R79.1, U12.3 (AVDD)
unnamed: R79.2, R80.1
unnamed: C68.1, R76.1, U12.8 (INA+)
unnamed: C68.2, R77.1, U12.7 (INA-)
unnamed: C70.1, U12.6 (VBG)
unnamed: R78.1, R80.2, U12.4 (VFB)

Notes on the sheet:
Weight Cell DAC
E- is gnd, not connected to avoid flags in the pcb editor
