klaus-liebler/factory_in_a_box/pcb_factory_control_unit/pcb_factory_control_unit.kicad_pcb

## KiCad design pcb_factory_control_unit/pcb_factory_control_unit.kicad_pcb (continued)

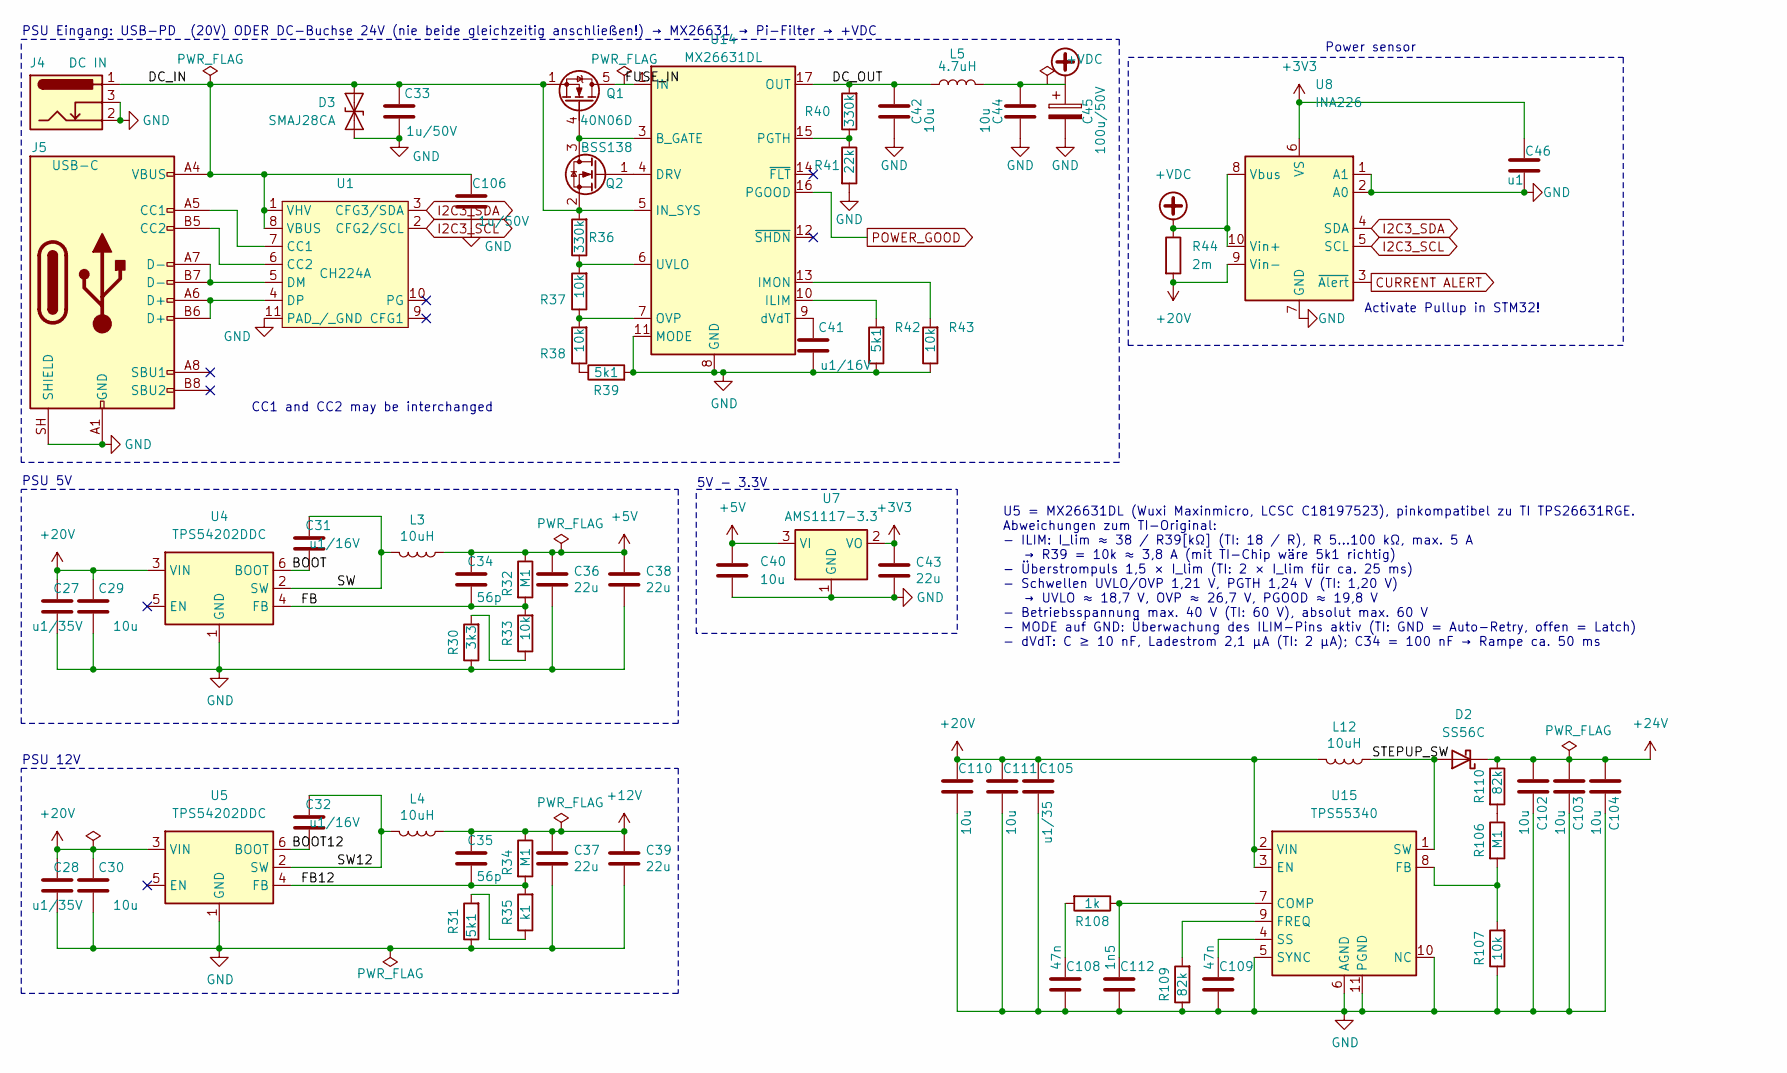
[picture p87: schematic psu.kicad_sch]

Parts:
C27, C28: u1/35V; C_0805_2012Metric; MPN CC0805KRX7R9BB104; LCSC C49678
C29, C30, C40, C110, C111: 10u; C_0805_2012Metric; MPN CGA0805X5R106K500MT; LCSC C6119889
C31, C32, C41: u1/16V; C_0402_1005Metric; MPN CL05B104KO5NNNC; LCSC C1525
C33, C106: 1u/50V; C_0805_2012Metric; MPN CL21B105KBFNNNE; LCSC C28323
C34, C35: 56p; C_0402_1005Metric; MPN CC0402JRNPO9BN560; LCSC C107007
C36, C37, C38, C39, C43: 22u; C_0805_2012Metric; MPN CL21A226MAQNNNE; LCSC C45783
C42, C44, C102, C103, C104: 10u; C_1210_3225Metric; MPN GRM32ER71H106KA12L; LCSC C77102
C45: 100u/50V; CP_Elec_8x10; MPN EEE-FK1H101P; LCSC C178548
C46: u1; C_0402_1005Metric; MPN CL05B104KO5NNNC; LCSC C1525
C105: u1/35; C_0805_2012Metric; MPN CC0805KRX7R9BB104; LCSC C49678
C108, C109: 47n; C_0402_1005Metric; MPN CL05B473KO5NNNC; LCSC C307434
C112: 1n5; C_0402_1005Metric; MPN CL05B152KB5NNNC; LCSC C23967
D2: SS56C; D_SMC; LCSC C24138
D3: SMAJ28CA; D_SMA; MPN SMAJ28CA; LCSC C19077546
J4: DC IN; BarrelJack_Horizontal; MPN DC-005 2.0
J5: USB-C; USB_C_Receptacle_HRO_TYPE-C-31-M-12_smaller; MPN TYPE-C-31-M-12; LCSC C165948
L3, L4, L12: 10uH; L_Abracon_ASPI-0630LR; MPN FXL0650-100-M; LCSC C475521
L5: 4.7uH; L_Bourns_SRP1245A; LCSC C54620181
Q1: 40N06D; VSON-8_3.3x3.3mm_P0.65mm_NexFET; MPN 40N06D; LCSC C7543836
Q2: BSS138; SOT-23; MPN BSS138LT1G; LCSC C82045
R30: 3k3; R_0402_1005Metric; MPN 0402WGF3301TCE; LCSC C25890
R31, R39, R42: 5k1; R_0402_1005Metric; MPN 0402WGF5101TCE; LCSC C25905
R32, R34, R106: M1; R_0402_1005Metric; MPN 0402WGF1003TCE; LCSC C25741
R33, R37, R38, R43, R107: 10k; R_0402_1005Metric; MPN 0402WGF1002TCE; LCSC C25744
R35: k1; R_0402_1005Metric; MPN 0402WGF1000TCE; LCSC C25076
R36, R40: 330k; R_0402_1005Metric; MPN 0402WGF3303TCE; LCSC C25778
R41: 22k; R_0402_1005Metric; MPN 0402WGF2202TCE; LCSC C25768
R44: 2m; R_1206_3216Metric; LCSC C844294
R108: 1k; R_0402_1005Metric; MPN 0402WGF1001TCE; LCSC C11702
R109, R110: 82k; R_0402_1005Metric; MPN 0402WGF8202TCE; LCSC C4142
U1: CH224A; Texas_DSQ0010A_WSON-10-1EP_2x2mm_P0.4mm_EP0.9x1.5mm_Thermal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; LCSC C42459160
U4, U5: TPS54202DDC; SOT-23-6; MPN TPS54202DDCR; LCSC C191884
U7: AMS1117-3.3; SOT-223-3_TabPin2; LCSC C6186
U8: INA226; TSSOP-10_3x3mm_P0.5mm; LCSC C49851
U14: MX26631DL; Texas_RGE0024H_VQFN-24-1EP_4x4mm_P0.5mm_EP2.7x2.7mm_Thermal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; MPN MX26631DL; LCSC C18197523
U15: TPS55340; WQFN-16-1EP_3x3mm_P0.5mm_EP1.68x1.68mm_ThermalVias; MPN TPS55340RTER; LCSC C169167

Connections:
+3V3: C43.1, C46.1, U7.2 (VO), U8.6 (VS); also elsewhere on the board
+5V: C34.2, C36.1, C38.1, C40.1, L3.1, R32.1, U7.3 (VI); also elsewhere on the board
+12V: C35.2, C37.1, C39.1, L4.1, R34.1; also elsewhere on the board
+20V: C27.2, C28.2, C29.2, C30.2, C105.2, C110.2, C111.2, L12.2, R44.2, U4.3 (VIN), U5.3 (VIN), U8.9 (Vin-), U15.2 (VIN), U15.3 (EN); also elsewhere on the board
+24V: C102.1, C103.1, C104.1, D2.1 (K), R110.1; also elsewhere on the board
+VDC: C44.1, C45.1, L5.2, R44.1, U8.8 (Vbus), U8.10 (Vin+)
/psu/BOOT: C31.1, U4.6 (BOOT)
/psu/BOOT12: C32.1, U5.6 (BOOT)
/psu/DC_IN: C33.2, C106.2, D3.2 (A2), J4.1, J5.A4 (VBUS), J5.A9 (VBUS), J5.B4 (VBUS), J5.B9 (VBUS), Q1.1 (S), Q1.2 (S), Q1.3 (S), Q2.2 (S), R36.2, U1.1 (VHV), U1.8 (VBUS), U14.5 (IN_SYS)
/psu/DC_OUT: C42.1, L5.1, R40.2, U14.17 (OUT), U14.18 (OUT)
/psu/FB: C34.1, R32.2, R33.2, U4.4 (FB)
/psu/FB12: C35.1, R34.2, R35.2, U5.4 (FB)
/psu/FUSE_IN: Q1.5 (D), U14.1 (IN), U14.2 (IN)
/psu/STEPUP_SW: D2.2 (A), L12.1, U15.1 (SW), U15.15 (SW), U15.16 (SW)
/psu/SW: C31.2, L3.2, U4.2 (SW)
/psu/SW12: C32.2, L4.2, U5.2 (SW)
CURRENT ALERT: U8.3 (~Alert); also elsewhere on the board
GND: C27.1, C28.1, C29.1, C30.1, C33.1, C36.2, C37.2, C38.2, C39.2, C40.2, C41.1, C42.2, C43.2, C44.2, C45.2, C46.2, C102.2, C103.2, C104.2, C105.1, C106.1, C108.1, C109.1, C110.1, C111.1, C112.1, D3.1 (A1), J4.2, J4.3, J5.A1 (GND), J5.A12 (GND), J5.B1 (GND), J5.B12 (GND), J5.SH (SHIELD), R30.1, R31.1, R39.2, R41.2, R42.1, R43.1, R107.1, R109.1, U1.11 (PAD_/_GND), U4.1 (GND), U5.1 (GND), U7.1 (GND), U8.1 (A1), U8.2 (A0), U8.7 (GND), U14.8 (GND), U14.11 (MODE), U14.25 (GND), U15.5 (SYNC), U15.6 (AGND), U15.10 (NC), U15.11 (PGND), U15.12 (PGND), U15.13 (PGND), U15.14 (NC), U15.17 (AGND); also elsewhere on the board
I2C3_SCL: U1.2 (CFG2/SCL), U8.5 (SCL); also elsewhere on the board
I2C3_SDA: U1.3 (CFG3/SDA), U8.4 (SDA); also elsewhere on the board
unnamed: C108.2, R108.2
unnamed: J5.A5 (CC1), U1.7 (CC1)
unnamed: J5.B5 (CC2), U1.6 (CC2)
unnamed: Q1.4 (G), Q2.3 (D), U14.3 (B_GATE)
unnamed: Q2.1 (G), U14.4 (DRV)
unnamed: R30.2, R33.1
unnamed: R31.2, R35.1
unnamed: R38.1, R39.1
unnamed: R106.1, R110.2
unnamed: J5.A7 (D-), J5.B7 (D-), U1.5 (DM)
unnamed: J5.A6 (D+), J5.B6 (D+), U1.4 (DP)
unnamed: R42.2, U14.10 (ILIM)
unnamed: R43.2, U14.13 (IMON)
unnamed: R37.1, R38.2, U14.7 (OVP)
unnamed: R40.1, R41.1, U14.15 (PGTH)
unnamed: R36.1, R37.2, U14.6 (UVLO)
unnamed: C41.2, U14.9 (dVdT)
unnamed: C112.2, R108.1, U15.7 (COMP)
unnamed: R106.2, R107.2, U15.8 (FB)
unnamed: R109.2, U15.9 (FREQ)
unnamed: C109.2, U15.4 (SS)
POWER_GOOD: U14.16 (PGOOD); also elsewhere on the board

Notes on the sheet:
PSU 5V
Power sensor
U5 = MX26631DL (Wuxi Maxinmicro, LCSC C18197523), pinkompatibel zu TI TPS26631RGE. Abweichungen zum TI-Original: - ILIM: I_lim ≈ 38 / R39[kΩ] (TI: 18 / R), R 5…100 kΩ, max. 5 A → R39 = 10k ≈ 3,8 A (mit TI-Chip wäre 5k1 richtig) - Überstrompuls 1,5 × I_lim (TI: 2 × I_lim für ca. 25 ms) - Schwellen U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
PSU Eingang: USB-PD (20V) ODER DC-Buchse 24V (nie beide gleichzeitig anschließen!) → MX26631 → Pi-Filter → +VDC
PSU 12V
Activate Pullup in STM32!
CC1 and CC2 may be interchanged
5V - 3.3V

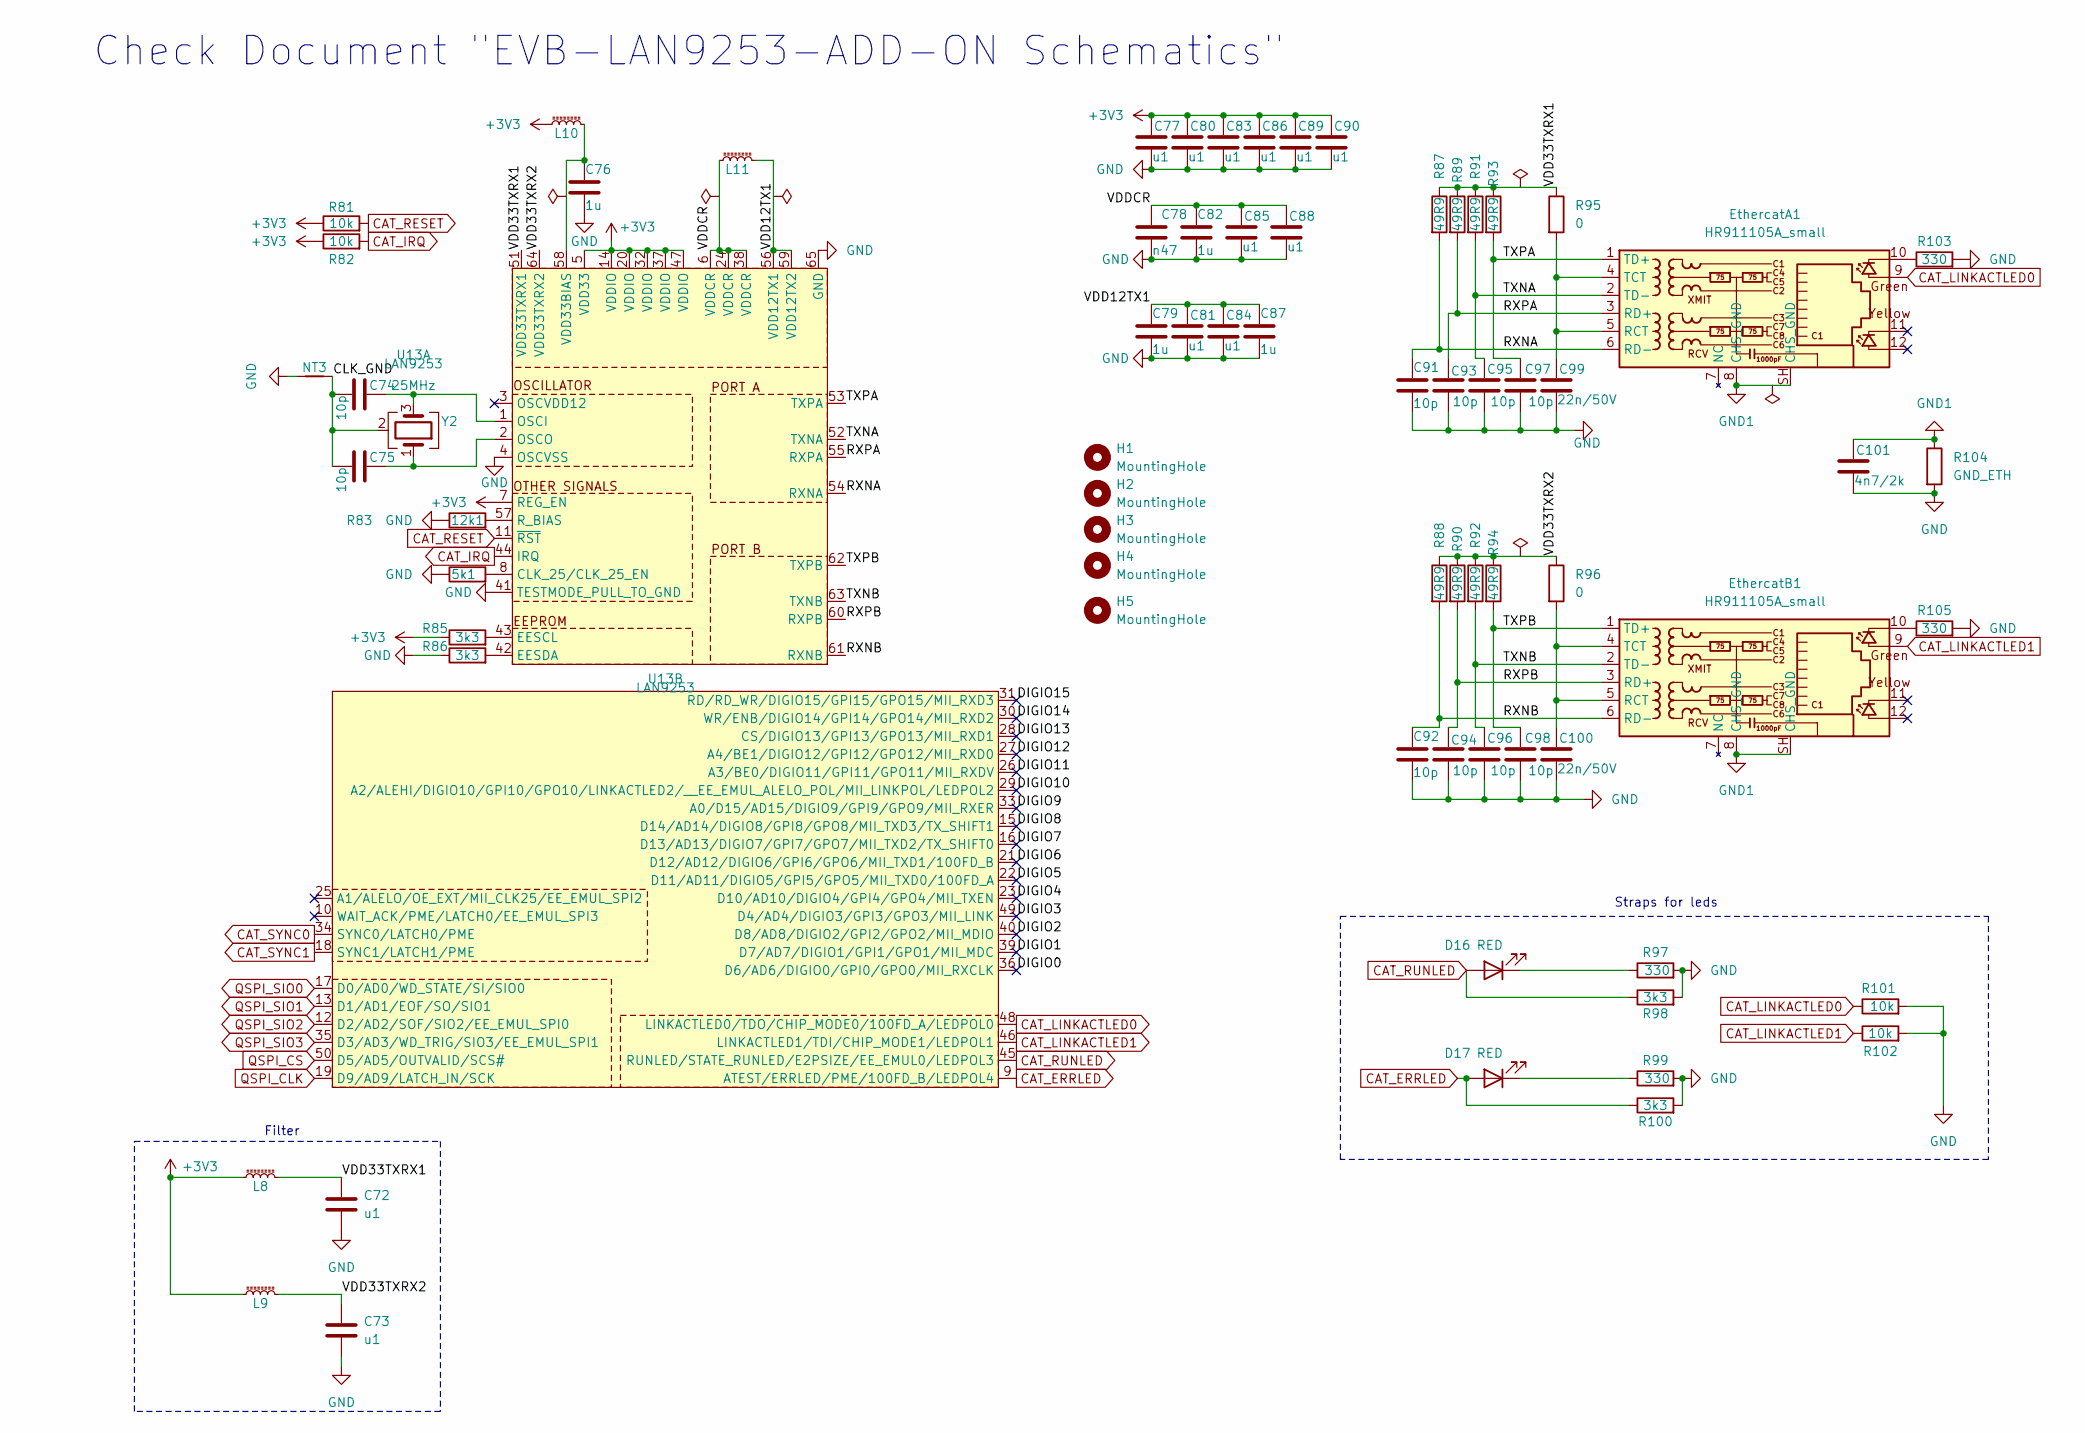
[picture p88: schematic ethercat_esc.kicad_sch]

Parts:
C72, C73, C77, C80, C81, C83, C84, C85, C86, C88, C89, C90: u1; C_0402_1005Metric; MPN CL05B104KO5NNNC; LCSC C1525
C74, C75, C91, C92, C93, C94, C95, C96, C97, C98: 10p; C_0402_1005Metric; MPN CC0402JRNPO9BN100; LCSC C106199
C76, C79, C82, C87: 1u; C_0402_1005Metric; MPN CL05A105KA5NQNC; LCSC C52923
C78: n47; C_0402_1005Metric; MPN GRM1555C1H471JA01D; LCSC C76971
C99, C100: 22n/50V; C_0402_1005Metric; MPN 0402B223K500NT; LCSC C1532
C101: 4n7/2k; C_0805_2012Metric_Pad1.18x1.45mm_HandSolder
D16, D17: RED; LED_1206_3216Metric_ReverseMount_Hole1.8x2.4mm; MPN P2-1206RTCS2-0.9T-F; LCSC C2827254
EthercatA1: HR911105A_small; RJ45_HANRUN_HR911105A; LCSC C12074
EthercatB1: HR911105A_small; RJ45_HANRUN_HR911105A; LCSC C12074
H1, H2, H3, H4: MountingHole; MountingHole_4.3mm_M4_DIN965
H5: MountingHole; barrel_jack_positive_polarity
L8, L9, L10, L11: 220R@100M; L_0603_1608Metric; MPN BLM18PG221SN1D; LCSC C80165
NT3: NetTie_2; NetTie-2_SMD_Pad0.5mm
R81, R82, R101, R102: 10k; R_0402_1005Metric; MPN 0402WGF1002TCE; LCSC C25744
R83: 12k1; R_0402_1005Metric; LCSC C25852
R84: 5k1; R_0402_1005Metric; MPN 0402WGF5101TCE; LCSC C25905
R85, R86, R98, R100: 3k3; R_0402_1005Metric; MPN 0402WGF3301TCE; LCSC C25890
R87, R88, R89, R90, R91, R92, R93, R94: 49R9; R_0402_1005Metric; LCSC C25120
R95, R96: 0; R_0805_2012Metric_Pad1.20x1.40mm_HandSolder; MPN 0805W8F0000T5E; LCSC C17477
R97, R99, R103, R105: 330; R_0402_1005Metric; MPN 0402WGF3300TCE; LCSC C25104
R104: GND_ETH; R_0805_2012Metric_Pad1.20x1.40mm_HandSolder
U13: LAN9253; QFN-64-1EP_9x9mm_P0.5mm_EP6x6mm_ThermalVias; MPN LAN9253-I/R4X; LCSC C5745149
Y2: 25MHz; Crystal_SMD_2016-4Pin_2.0x1.6mm; LCSC C19711739

Connections:
+3V3: C77.1, C80.1, C83.1, C86.1, C89.1, C90.1, L8.1, L9.1, L10.1, R81.1, R82.1, R85.1, U13.5 (VDD33), U13.7 (REG_EN), U13.14 (VDDIO), U13.20 (VDDIO), U13.32 (VDDIO), U13.37 (VDDIO), U13.47 (VDDIO); also elsewhere on the board
/EtherCAT/CLK_GND: C74.2, C75.2, NT3.2, Y2.2 (G), Y2.4 (G)
/EtherCAT/DIGIO0: U13.36 (D6/AD6/DIGIO0/GPI0/GPO0/MII_RXCLK)
/EtherCAT/DIGIO1: U13.39 (D7/AD7/DIGIO1/GPI1/GPO1/MII_MDC)
/EtherCAT/DIGIO2: U13.40 (D8/AD8/DIGIO2/GPI2/GPO2/MII_MDIO)
/EtherCAT/DIGIO3: U13.49 (D4/AD4/DIGIO3/GPI3/GPO3/MII_LINK)
/EtherCAT/DIGIO4: U13.23 (D10/AD10/DIGIO4/GPI4/GPO4/MII_TXEN)
/EtherCAT/DIGIO5: U13.22 (D11/AD11/DIGIO5/GPI5/GPO5/MII_TXD0/100F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)
/EtherCAT/DIGIO6: U13.21 (D12/AD12/DIGIO6/GPI6/GPO6/MII_TXD1/100F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)
/EtherCAT/DIGIO7: U13.16 (D13/AD13/DIGIO7/GPI7/GPO7/MII_TXD2/TX_S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)
/EtherCAT/DIGIO8: U13.15 (D14/AD14/DIGIO8/GPI8/GPO8/MII_TXD3/TX_S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)
/EtherCAT/DIGIO9: U13.33 (A0/D15/AD15/DIGIO9/GPI9/GPO9/MII_RXER)
/EtherCAT/DIGIO10: U13.29 (A2/ALEHI/DIGIO10/GPI10/GPO10/LINKACTLED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)
/EtherCAT/DIGIO11: U13.26 (A3/BE0/DIGIO11/GPI11/GPO11/MII_RXDV)
/EtherCAT/DIGIO12: U13.27 (A4/BE1/DIGIO12/GPI12/GPO12/MII_RXD0)
/EtherCAT/DIGIO13: U13.28 (CS/DIGIO13/GPI13/GPO13/MII_RXD1)
/EtherCAT/DIGIO14: U13.30 (WR/ENB/DIGIO14/GPI14/GPO14/MII_RXD2)
/EtherCAT/DIGIO15: U13.31 (RD/RD_WR/DIGIO15/GPI15/GPO15/MII_RXD3)
/EtherCAT/RXNA: C91.1, EthercatA1.6 (RD-), R87.2, U13.54 (RXNA)
/EtherCAT/RXNB: C92.1, EthercatB1.6 (RD-), R88.2, U13.61 (RXNB)
/EtherCAT/RXPA: C93.1, EthercatA1.3 (RD+), R89.2, U13.55 (RXPA)
/EtherCAT/RXPB: C94.1, EthercatB1.3 (RD+), R90.2, U13.60 (RXPB)
/EtherCAT/TXNA: C95.1, EthercatA1.2 (TD-), R91.2, U13.52 (TXNA)
/EtherCAT/TXNB: C96.1, EthercatB1.2 (TD-), R92.2, U13.63 (TXNB)
/EtherCAT/TXPA: C97.1, EthercatA1.1 (TD+), R93.2, U13.53 (TXPA)
/EtherCAT/TXPB: C98.1, EthercatB1.1 (TD+), R94.2, U13.62 (TXPB)
/EtherCAT/VDD12TX1: C79.1, C81.1, C84.1, C87.1, L11.2, U13.56 (VDD12TX1), U13.59 (VDD12TX2)
/EtherCAT/VDD33TXRX1: C72.1, L8.2, R87.1, R89.1, R91.1, R93.1, R95.1, U13.51 (VDD33TXRX1)
/EtherCAT/VDD33TXRX2: C73.1, L9.2, R88.1, R90.1, R92.1, R94.1, R96.1, U13.64 (VDD33TXRX2)
/EtherCAT/VDDCR: C78.1, C82.1, C85.1, C88.1, L11.1, U13.6 (VDDCR), U13.24 (VDDCR), U13.38 (VDDCR)
CAT_ERRLED: D17.2 (A), R100.1, U13.9 (ATEST/ERRLED/PME/100FD_B/LEDPOL4)
CAT_IRQ: R82.2, U13.44 (IRQ); also elsewhere on the board
CAT_LINKACTLED0: EthercatA1.9, R101.1, U13.48 (LINKACTLED0/TDO/CHIP_MODE0/100FD_A/LEDP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)
CAT_LINKACTLED1: EthercatB1.9, R102.1, U13.46 (LINKACTLED1/TDI/CHIP_MODE1/LEDPOL1)
CAT_RESET: R81.2, U13.11 (~RST); also elsewhere on the board
CAT_RUNLED: D16.2 (A), R98.1, U13.45 (RUNLED/STATE_RUNLED/E2PSIZE/EE_EMUL0/LE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)
CAT_SYNC0: U13.34 (SYNC0/LATCH0/PME); also elsewhere on the board
CAT_SYNC1: U13.18 (SYNC1/LATCH1/PME); also elsewhere on the board
GND: C72.2, C73.2, C76.2, C77.2, C78.2, C79.2, C80.2, C81.2, C82.2, C83.2, C84.2, C85.2, C86.2, C87.2, C88.2, C89.2, C90.2, C91.2, C92.2, C93.2, C94.2, C95.2, C96.2, C97.2, C98.2, C99.2, C100.2, C101.2, NT3.1, R83.1, R84.1, R86.1, R97.2, R98.2, R99.2, R100.2, R101.2, R102.2, R103.2, R104.2, R105.2, U13.4 (OSCVSS), U13.41 (TESTMODE_PULL_TO_GND), U13.65 (GND); also elsewhere on the board
GND1: C101.1, EthercatA1.8 (CHS_GND), EthercatA1.SH (CHS_GND), EthercatB1.8 (CHS_GND), EthercatB1.SH (CHS_GND), R104.1; also elsewhere on the board
unnamed: D16.1 (K), R97.1
unnamed: D17.1 (K), R99.1
unnamed: EthercatA1.10, R103.1
unnamed: C99.1, EthercatA1.4 (TCT), EthercatA1.5 (RCT), R95.2
unnamed: EthercatB1.10, R105.1
unnamed: C100.1, EthercatB1.4 (TCT), EthercatB1.5 (RCT), R96.2
unnamed: R84.2, U13.8 (CLK_25/CLK_25_EN)
unnamed: R85.2, U13.43 (EESCL)
unnamed: R86.2, U13.42 (EESDA)
unnamed: C74.1, U13.1 (OSCI), Y2.3
unnamed: C75.1, U13.2 (OSCO), Y2.1
unnamed: R83.2, U13.57 (R_BIAS)
unnamed: C76.1, L10.2, U13.58 (VDD33BIAS)
QSPI_CLK: U13.19 (D9/AD9/LATCH_IN/SCK); also elsewhere on the board
QSPI_CS: U13.50 (D5/AD5/OUTVALID/SCS#); also elsewhere on the board
QSPI_SIO0: U13.17 (D0/AD0/WD_STATE/SI/SIO0); also elsewhere on the board
QSPI_SIO1: U13.13 (D1/AD1/EOF/SO/SIO1); also elsewhere on the board
QSPI_SIO2: U13.12 (D2/AD2/SOF/SIO2/EE_EMUL_SPI0); also elsewhere on the board
QSPI_SIO3: U13.35 (D3/AD3/WD_TRIG/SIO3/EE_EMUL_SPI1); also elsewhere on the board

Notes on the sheet:
Straps for leds
Filter
Check Document "EVB-LAN9253-ADD-ON Schematics"

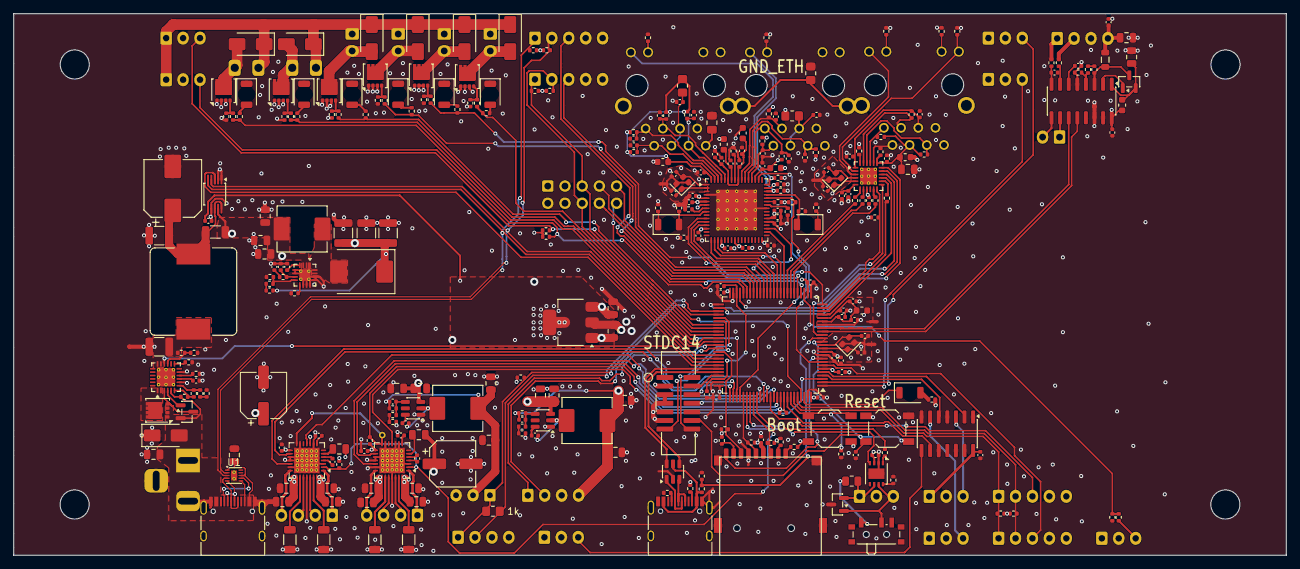
[picture p89: board pcb_factory_control_unit.kicad_pcb from above]

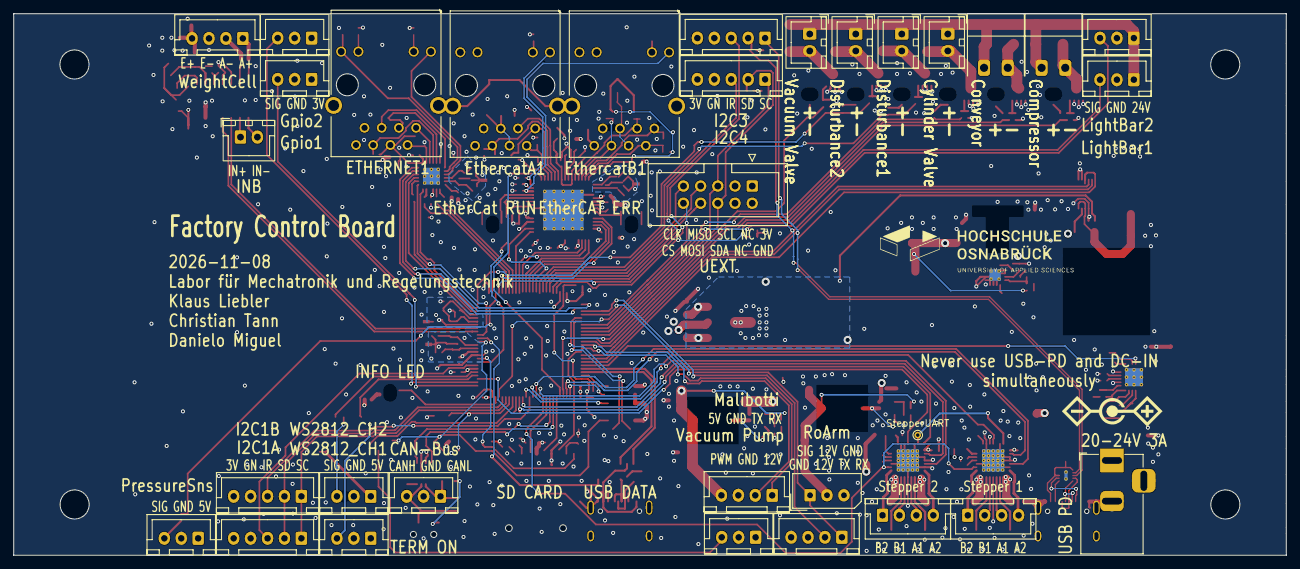
[picture p90: board pcb_factory_control_unit.kicad_pcb from below]

Board: 4 copper layers, 188.0 x 80.0 mm, 333 parts (33 on the bottom side), 244 nets.
