klaus-liebler/factory_in_a_box/licheerv_nano_base/licheerv_nano_base.kicad_pcb

## KiCad design licheerv_nano_base/licheerv_nano_base.kicad_pcb (2025-12-23)

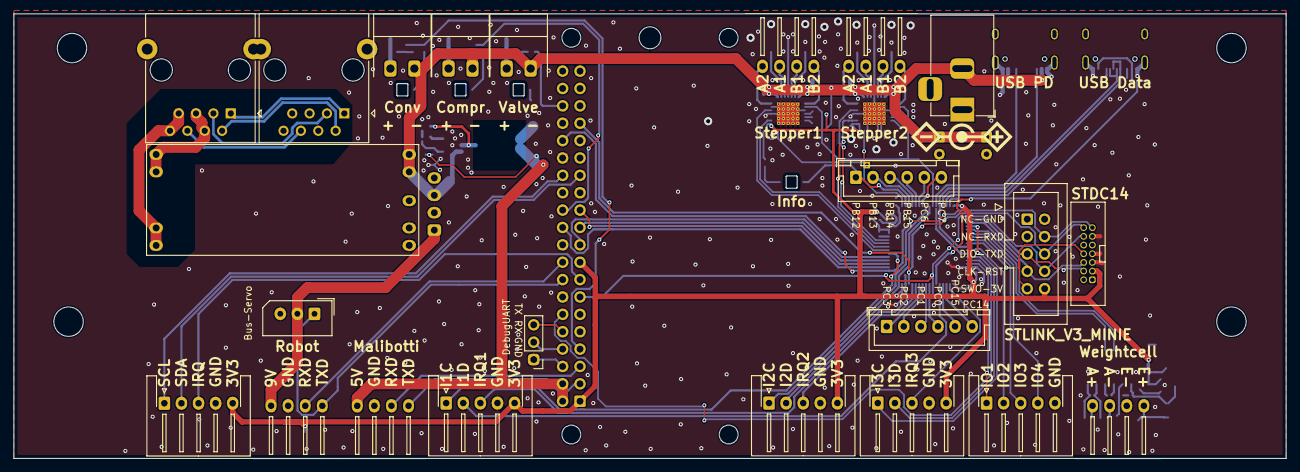
[picture p91: board licheerv_nano_base.kicad_pcb from above]

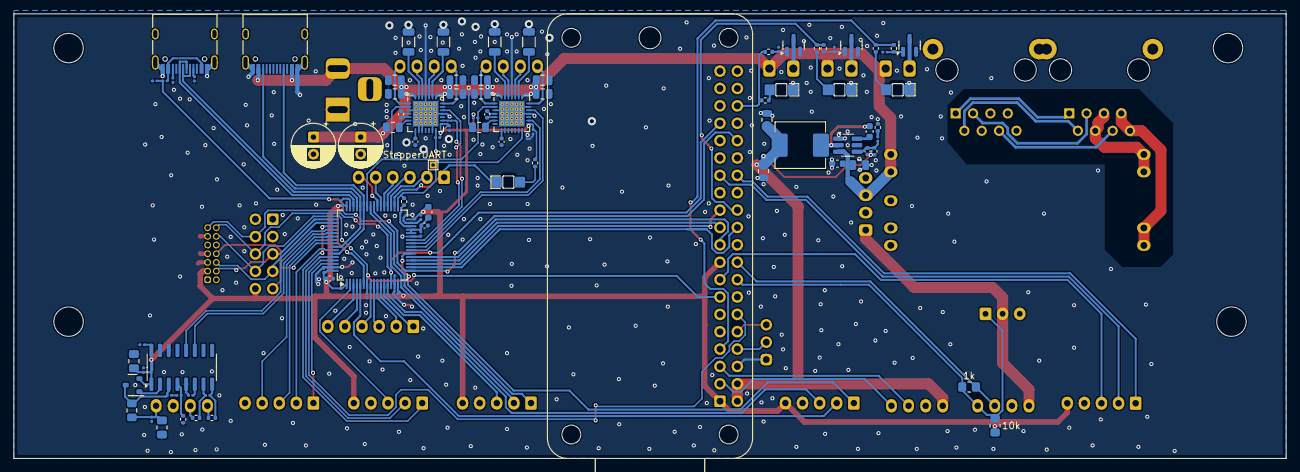
[picture p92: board licheerv_nano_base.kicad_pcb from below]

Board: 2 copper layers, 186.0 x 65.0 mm, 122 parts (92 on the bottom side), 122 nets.

Parts:
C1: u1/35V; C_0603_1608Metric
C2: 10u/35V; C_0805_2012Metric
C3: u1/16V; C_0603_1608Metric
C4: 56p; C_0402_1005Metric
C5, C7: 22u; C_0805_2012Metric
C6, C9, C11, C12, C13, C15, C16, C17, C18, C19, C20, C21, C27, C28: u1; C_0201_0603Metric
C8, C33, C35: 2u2; C_0402_1005Metric
C10, C22: 10u; C_0805_2012Metric_Pad1.18x1.45mm_HandSolder
C14: 4u7; C_0402_1005Metric
C23, C24: 100uF; CP_Radial_D6.3mm_P2.50mm
C25, C26: u1; C_0805_2012Metric
C29, C30, C42, C43: u1/35V; C_0805_2012Metric
C34, C36: 22n/50V; C_0402_1005Metric
C37, C38, C39, C40: 22u/35V; C_0805_2012Metric
D1: Motor; LED_1206_3216Metric_ReverseMount
D2: Valve; LED_1206_3216Metric_ReverseMount
D3: Compressor; LED_1206_3216Metric_ReverseMount
D4: Info; LED_1206_3216Metric_ReverseMount
FB1: 600R; L_0603_1608Metric
FID2: Fiducial; barrel_jack_positive_polarity
H1, H2, H8, H9: MountingHole; MountingHole_4.3mm_M4
H6: MountingHole; MountingHole_3.2mm_M3
J1, J22: USB STM32; USB_C_Receptacle_HRO_TYPE-C-31-M-12_smaller
J2: DC IN; BarrelJack_Horizontal
J3: TOF3; JST_XH_S5B-XH-A-1_1x05_P2.50mm_Horizontal
J4: TOF2; JST_XH_S5B-XH-A-1_1x05_P2.50mm_Horizontal
J5, J6: TOF1; JST_XH_S5B-XH-A-1_1x05_P2.50mm_Horizontal
J7: STEP1; JST_XH_S4B-XH-A-1_1x04_P2.50mm_Horizontal_SmallerCourtyard
J8: STEP2; JST_XH_S4B-XH-A-1_1x04_P2.50mm_Horizontal_SmallerCourtyard
J9: Conveyor; PhoenixContact_MC_1,5_2-G-3.5_1x02_P3.50mm_Horizontal_small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
J10: Valve; PhoenixContact_MC_1,5_2-G-3.5_1x02_P3.50mm_Horizontal_small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
J11: ETH_IN; RJ45_WithoutMagneticsTHT
J12: ETH_OUT; RJ45_WithoutMagneticsTHT
J13: Compressor; PhoenixContact_MC_1,5_2-G-3.5_1x02_P3.50mm_Horizontal_small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
J14: DebugUART; PinHeader_1x03_P2.54mm_Vertical_smallerCourtyard
J15: Weight; JST_XH_S4B-XH-A-1_1x04_P2.50mm_Horizontal_SmallerCourtyard
J16: Malibotti; JST_XH_S4B-XH-A-1_1x04_P2.50mm_Horizontal_SmallerCourtyard
J17: Robot; JST_XH_S4B-XH-A-1_1x04_P2.50mm_Horizontal_SmallerCourtyard
J18: STLINK_V3_MINIE; IDC-Header_2x05_P2.54mm_Vertical
J19: IO; JST_XH_S5B-XH-A-1_1x05_P2.50mm_Horizontal
J20: Bus-Servo; Molex_SPOX_5267-03A_1x03_P2.50mm_Vertical
J21: STDC14; IDC_2x07_P1.27mm_Vertical
J23, J24: IO; JST_XH_B6B-XH-A_1x06_P2.50mm_Vertical
L1: 10uH; L_Abracon_ASPI-0630LR
L2: 3u3; L_0805_2012Metric_Pad1.15x1.40mm_HandSolder
NT1: NetTie_2; NetTie-2_SMD_Pad0.5mm
Q1: BC807; SOT-23_smaller
Q2, Q3, Q4: IRLML6344; SOT-23
R1, R19, R20, R22, R23, R25, R26, R31: 1k; R_0402_1005Metric
R2: M1; R_0402_1005Metric
R3, R8, R9, R10, R11, R21, R24, R27, R29, R30: 10k; R_0201_0603Metric
R4: 3k3; R_0402_1005Metric
R5, R6: k1; R_0402_1005Metric
R7: 8k2; R_0402_1005Metric
R13, R28: 5k1; R_0201_0603Metric
R15, R16, R17, R18: r1; R_1206_3216Metric
R76: 10k; R_0805_2012Metric_Pad1.20x1.40mm_HandSolder
R77: 1k; R_0805_2012Metric_Pad1.20x1.40mm_HandSolder
TP1: StepperUART; TestPoint_THTPad_1.0x1.0mm_Drill0.5mm
U1: TPS54202DDC; SOT-23-6_Handsoldering
U2: STM32G431RBTx; LQFP-64_10x10mm_P0.5mm
U3: HX711; SOIC-16_3.9x9.9mm_P1.27mm
U4: DCDC_MP2315
U5, U6: TMC2209; QFN-28-1EP_5x5mm_P0.5mm_EP3.75x3.75mm_ThermalVias
U7: PoE->24V; XC7010_DCDC_ISOLATED_MODUEL
X1: Radxa Zero 3E

Connections:
5-24V: C1.2, C2.2, C23.1, C24.1, C25.1, C26.1, C29.1, C30.1, C37.2, C38.2, C39.2, C40.2, C42.1, C43.1, J1.A4 (VBUS), J1.A9 (VBUS), J1.B4 (VBUS), J1.B9 (VBUS), J2.2, J9.1, J10.1, J13.1, U1.3 (VIN), U4.3 (IN+), U5.22 (VS), U5.28 (VS), U6.22 (VS), U6.28 (VS), U7.8 (VOUT+), U7.9 (VOUT+)
+3.3VA: C20.1, C22.1, NT1.2, Q1.2 (E), U3.1 (VSUP)
+3V3: C14.1, C15.1, C16.1, C17.1, C18.1, C19.1, C21.1, C27.1, C28.1, FB1.2, J3.5, J4.5, J5.5, J6.5, J18.10, J21.3 (VCC), NT1.1, R9.1, R10.1, R31.2, R76.1, U2.1 (VBAT), U2.16 (VDD), U2.32 (VDD), U2.48 (VDD), U2.64 (VDD), U3.16 (DVDD), U5.15 (VCC_IO), U6.15 (VCC_IO), X1.1 (3V3), X1.17 (3V3)
+5V: C4.2, C5.1, C7.1, J16.1, L1.1, R2.1, X1.2 (5V), X1.4 (5V)
+5VP: J22.A4 (VBUS), J22.A9 (VBUS), J22.B4 (VBUS), J22.B9 (VBUS), R29.2
+9V: J17.1, J20.2, U4.1 (OUT+)
+48V: J11.4, J11.5, U7.1 (VIN+), U7.2 (VIN+)
/RX: J14.2, X1.8 (U2T)
/TX: J14.3, X1.10 (U2R)
/psu/BOOT: C3.1, U1.6 (BOOT)
/psu/FB: C4.1, R2.2, R3.2, U1.4 (FB)
/psu/SW: C3.2, L1.2, U1.2 (SW)
A+: J15.1, R5.2
A-: J15.2, R6.2
Compressor_PWM: R25.2, R26.2, X1.24 (G4C6/S3_CS0/PWM13/U9R/I3S_SDI)
Conveyor_PWM: R19.2, R20.2, X1.7 (G3C4/-/-/PWM14_M0)
E+: C6.1, C10.1, J15.4, L2.1
GND: C1.1, C2.1, C5.2, C6.2, C7.2, C8.2, C9.2, C10.2, C12.2, C13.2, C14.2, C15.2, C16.2, C17.2, C18.2, C19.2, C20.2, C21.2, C22.2, C23.2, C24.2, C27.2, C28.2, C29.2, C30.2, C33.2, C35.2, C37.1, C38.1, C39.1, C40.1, C42.2, C43.2, D1.1 (K), D2.1 (K), D3.1 (K), J1.A1 (GND), J1.A12 (GND), J1.B1 (GND), J1.B12 (GND), J1.S1 (SHIELD), J2.1, J3.4, J4.4, J5.4, J6.4, J11.SH, J12.SH, J14.1, J15.3, J16.2, J17.2, J18.2, J19.5, J20.3, J21.5 (GND), J21.7 (GND), J21.11 (GNDDetect), J22.A1 (GND), J22.A12 (GND), J22.B1 (GND), J22.B12 (GND), J22.S1 (SHIELD), Q2.2 (S), Q3.2 (S), Q4.2 (S), R4.1, R7.2, R13.2, R15.2, R16.2, R17.2, R18.2, R21.1, R24.1, R27.1, R28.2, R30.1, U1.1 (GND), U2.15 (VSS), U2.27 (VSSA), U2.31 (VSS), U2.47 (VSS), U2.63 (VSS), U3.5 (AGND), U3.14 (XI), U3.15 (RATE), U4.2 (GND), U5.3 (GND), U5.9 (MS1_AD0), U5.10 (MS2_AD1), U5.13 (CLK), U5.18 (GND), U5.20 (STDBY), U5.25 (GND), U5.29 (PAD), U6.3 (GND), U6.9 (MS1_AD0), U6.10 (MS2_AD1), U6.13 (CLK), U6.18 (GND), U6.20 (STDBY), U6.25 (GND), U6.29 (PAD), U7.5 (VOUT-), U7.6 (VOUT-), X1.6 (GND), X1.9 (GND), X1.14 (GND), X1.20 (GND), X1.25 (GND), X1.30 (GND), X1.34 (GND), X1.39 (GND)
GND1: J11.7, J11.8, U7.3 (VIN-), U7.4 (VIN-)
HX711_CLK: U2.53 (PC11), U3.11 (PD_SCK)
HX711_DATA: U2.52 (PC10), U3.12 (DOUT)
INT_RGB: J6.3, X1.15 (G3B0)
INT_TOF1: J4.3, U2.13 (PA1)
INT_TOF2: J5.3, U2.12 (PA0)
INT_TOF3: J3.3, U2.2 (PC13)
IO1: J19.1, U2.62 (PB9)
IO2: J19.2, U2.58 (PB5)
IO3: J19.3, U2.55 (PD2)
IO4: J19.4, U2.54 (PC12)
MALIBOTTI_RXD: J16.3, X1.5 (G1A1/U3T/PU!)
MALIBOTTI_TXD: J16.4, X1.3 (G1A0/U3R/PU!)
unnamed: D1.2 (A), R19.1
unnamed: D2.2 (A), R22.1
unnamed: D3.2 (A), R25.1
unnamed: D4.2 (A), R31.1
unnamed: J7.1, U5.1 (Coil_B_Out_2)
unnamed: J7.2, U5.26 (Coil_B_Out_1)
unnamed: J7.3, U5.24 (Coil_A_Out_1)
unnamed: J7.4, U5.21 (Coil_A_Out_2)
unnamed: J8.1, U6.1 (Coil_B_Out_2)
unnamed: J8.2, U6.26 (Coil_B_Out_1)
unnamed: J8.3, U6.24 (Coil_A_Out_1)
unnamed: J8.4, U6.21 (Coil_A_Out_2)
unnamed: J9.2, Q2.3 (D)
unnamed: J10.2, Q3.3 (D)
unnamed: J11.1, J12.1
unnamed: J11.2, J12.2
unnamed: J11.3, J12.3
unnamed: J11.6, J12.6
unnamed: J13.2, Q4.3 (D)
unnamed: J22.A5 (CC1), R13.1
unnamed: J22.B5 (CC2), R28.1
unnamed: Q1.1 (B), U3.2 (BASE)
unnamed: L2.2, Q1.3 (C), R8.1, U3.3 (AVDD)
unnamed: Q2.1 (G), R20.1, R21.2
unnamed: Q3.1 (G), R23.1, R24.2
unnamed: Q4.1 (G), R26.1, R27.2
unnamed: R3.1, R4.2
unnamed: R8.2, R11.1
unnamed: C8.1, C9.1, FB1.1, U2.28 (VREF+), U2.29 (VDDA)
unnamed: C11.1, R5.1, U3.8 (INA+)
unnamed: C11.2, R6.1, U3.7 (INA-)
unnamed: C13.1, U3.6 (VBG)
unnamed: R7.1, R11.2, U3.4 (VFB)
unnamed: C33.1, U5.8 (5VOUT)
unnamed: R15.1, U5.23 (BRA)
unnamed: R17.1, U5.27 (BRB)
unnamed: C34.2, U5.5 (CPI)
unnamed: C34.1, U5.4 (CPO)
unnamed: C25.2, U5.6 (VCP)
unnamed: C35.1, U6.8 (5VOUT)
unnamed: R16.1, U6.23 (BRA)
unnamed: R18.1, U6.27 (BRB)
unnamed: C36.2, U6.5 (CPI)
unnamed: C36.1, U6.4 (CPO)
unnamed: C26.2, U6.6 (VCP)
PB12: D4.1 (K), J23.1, U2.34 (PB12)
PB13: J23.2, U2.35 (PB13)
PC14: J24.6, U2.3 (PC14)
PC15: J24.5, U2.4 (PC15)
ROBOT_RXD: J17.3, R77.1, X1.18 (G3B2/U4T/PWM9)
ROBOT_TXD: J17.4, J20.1, R76.2, R77.2, X1.16 (G3B1/U4R/PWM8)
SCL: J6.1, X1.28 (G4B3/-/-/I4C_SCL/I2S_SDO/PU!)
SDA: J6.2, X1.27 (G4B2/-/I2S_SDI/I4C_SDA/PU!)
SPI1_MISO: U2.20 (PA6), X1.21 (G4C5/S3_MISO/I3S_SDO/PWM12/U9T)
SPI1_MOSI: U2.21 (PA7), X1.19 (G4C3/S3MOSI/I3S_SCLK/PWM15)
SPI1_NSS: U2.18 (PA4), X1.22 (G3C1/-/-/-/I1S_SDO2)
SPI1_SCK: U2.19 (PA5), X1.23 (G4C2/S3_CLK/I3S_MCLK/PWM14)
STEPPER_EN: R9.2, U2.42 (PA8), U5.2 (ENN), U6.2 (ENN)
STEPPER_UART: R1.2, R10.2, TP1.1, U2.33 (PB11), U5.14 (PDN_UART), U6.14 (PDN_UART)
STM32BOOT_RXD: J18.4, J21.13 (VCP_RX), U2.17 (PA3), X1.32 (G3C2/U5T/-/-/I2S_SDO3)
STM32BOOT_TXD: J18.6, J21.14 (VCP_TX), U2.14 (PA2), X1.33 (G3C3/-/I1S_SCLK/-/U5R)
STM32_BOOT: U2.61 (PB8), X1.12 (G3A3)
STM32_RESET: C12.1, J18.8, J21.12 (~RST), U2.7 (PG10), X1.13 (G3A2/-/-/I2S3_MCLK)
SWCLK: J18.7, J21.6 (JCLK/SWCLK), U2.50 (PA14)
SWDIO: J18.5, J21.4 (JTMS/SWDIO), U2.49 (PA13)
SWO: J18.9, J21.8 (JTDO/SWO), U2.56 (PB3)
Stepper1_Dir: U2.23 (PC5), U5.19 (DIR)
Stepper1_Step: U2.24 (PB0), U5.16 (STEP)
Stepper2_Dir: U2.26 (PB2), U6.19 (DIR)
Stepper2_Step: U2.25 (PB1), U6.16 (STEP)
T1C1-LU1R: J24.4, U2.8 (PC0)
T1C2-LU1T: J24.3, U2.9 (PC1)
T1C3: J24.2, U2.10 (PC2)
T1C4: J24.1, U2.11 (PC3)
T8C1: J23.5, U2.38 (PC6)
T8C2: J23.6, U2.39 (PC7)
T15C1: J23.3, U2.36 (PB14)
T15C2: J23.4, U2.37 (PB15)
U3T: R1.1, U2.30 (PB10)
USBPD_CC1: J1.A5 (CC1), U2.43 (PA9), U2.59 (PB6)
USBPD_CC2: J1.B5 (CC2), U2.44 (PA10), U2.57 (PB4)
USBPD_D+: J22.A6 (D+), J22.B6 (D+), U2.46 (PA12)
USBPD_D-: J22.A7 (D-), J22.B7 (D-), U2.45 (PA11)
USB_VSENSE: R29.1, R30.2, U2.6 (PF1)
Valve: R22.2, R23.2, X1.36 (G3A7)
i1c: J4.1, U2.22 (PC4)
i1d: J4.2, U2.5 (PF0)
i2c: J5.1, U2.40 (PC8)
i2d: J5.2, U2.41 (PC9)
i3c: J3.1, U2.51 (PA15)
i3d: J3.2, U2.60 (PB7)
