klaus-liebler/factory_in_a_box/firmware_factory_control_unit/Core/Src/main.c

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
/* Includes ------------------------------------------------------------------*/
#include "main.h"
#include "string.h"

/* USER CODE BEGIN Includes */
#include <stdio.h>
#include "tx_api.h"
#include "generated/device_ids.hh"

void enable_dwt_cycle_counter(void); // common_stm32/common.cc
/* USER CODE END Includes */


ETH_TxPacketConfigTypeDef TxConfig;
ETH_DMADescTypeDef  DMARxDscrTab[ETH_RX_DESC_CNT]; /* Ethernet Rx DMA Descriptors */
ETH_DMADescTypeDef  DMATxDscrTab[ETH_TX_DESC_CNT]; /* Ethernet Tx DMA Descriptors */

ADC_HandleTypeDef hadc1;

DCACHE_HandleTypeDef hdcache1;

ETH_HandleTypeDef heth;

FDCAN_HandleTypeDef hfdcan1;

I2C_HandleTypeDef hi2c1;
I2C_HandleTypeDef hi2c2;
I2C_HandleTypeDef hi2c4;

XSPI_HandleTypeDef hxspi1;

SD_HandleTypeDef hsd1;

SPI_HandleTypeDef hspi2;
SPI_HandleTypeDef hspi4;
DMA_HandleTypeDef handle_GPDMA1_Channel1;
DMA_HandleTypeDef handle_GPDMA1_Channel0;

TIM_HandleTypeDef htim2;
TIM_HandleTypeDef htim3;
TIM_HandleTypeDef htim4;
TIM_HandleTypeDef htim15;
TIM_HandleTypeDef htim16;
TIM_HandleTypeDef htim17;
DMA_HandleTypeDef handle_GPDMA1_Channel3;
DMA_HandleTypeDef handle_GPDMA1_Channel2;

UART_HandleTypeDef huart5;
UART_HandleTypeDef huart7;
UART_HandleTypeDef huart12;
UART_HandleTypeDef huart3;

PCD_HandleTypeDef hpcd_USB_DRD_FS;

void SystemClock_Config(void);
static void MX_GPIO_Init(void);
static void MX_GPDMA1_Init(void);
static void MX_DCACHE1_Init(void);
static void MX_USART3_UART_Init(void);
static void MX_ETH_Init(void);
static void MX_FLASH_Init(void);
static void MX_I2C1_Init(void);
static void MX_I2C2_Init(void);
static void MX_I2C4_Init(void);
static void MX_SDMMC1_SD_Init(void);
static void MX_SPI2_Init(void);
static void MX_TIM2_Init(void);
static void MX_TIM3_Init(void);
static void MX_TIM4_Init(void);
static void MX_TIM15_Init(void);
static void MX_UART7_Init(void);
static void MX_UCPD1_Init(void);
static void MX_USB_PCD_Init(void);
static void MX_FDCAN1_Init(void);
static void MX_SPI4_Init(void);
static void MX_OCTOSPI1_Init(void);
static void MX_TIM16_Init(void);
static void MX_TIM17_Init(void);
static void MX_UART12_Init(void);
static void MX_ADC1_Init(void);
static void MX_UART5_Init(void);
static void MX_ICACHE_Init(void);
/**
  * @brief  The application entry point.
  * @retval int
  */
int main(void)
{

  /* USER CODE BEGIN 1 */
  // DWT-Zykluszaehler ganz am Anfang aktivieren (nicht erst in _tx_initialize_low_level(), das
  // erst mit tx_kernel_enter() weit unten laeuft) -- hal_tick_threadx.c braucht ihn schon fuer
  // HAL_Delay()/HAL_GetTick()-Aufrufe, die VOR dem ThreadX-Kernelstart passieren (z.B.
  // SystemClock_Config() und die MX_*_Init()-Timeouts) und fuer die CPU-Zeit-Statistik
  // (tx_execution_profile.c).
  // tx_initialize_low_level.S setzt dieselben Enable-Bits spaeter nochmals -- harmlos, setzt
  // CYCCNT dort nicht zurueck. Nur hier, genau einmal aufrufen (s. common.cc).
  enable_dwt_cycle_counter();
  /* USER CODE END 1 */

  /* MCU Configuration--------------------------------------------------------*/

  /* Reset of all peripherals, Initializes the Flash interface and the Systick. */
  HAL_Init();

  /* Configure the system clock */
  SystemClock_Config();

  /* Initialize all configured peripherals */
  MX_GPIO_Init();
  /* USER CODE BEGIN 2 */
  // Alle MX_*_Init() ausser MX_GPIO_Init() stehen in der .ioc auf "Do Not Generate Function
  // Call" -- hier nur, was VOR der Versorgungsspannungspruefung (App::WaitForSupplyVoltage(),
  // s. app.cc) gebraucht wird: Caches/Flash/DMA als Basis, USART3 fuers Log, I2C4 fuer den
  // INA226, UCPD1 fuer USB-PD. Alle stromhungrigen Peripherien (ETH, Stepper-UART/-Timer, SD,
  // USB-Device, ...) initialisiert erst MX_Init_PowerConsumers() unten, aufgerufen aus dem
  // App-Main-Thread, sobald >18V anliegen. MX_GPIO_Init() oben laesst STEPPER_EN (Low-aktiv)
  // HIGH und den ETH-PHY im Reset (ETH_RESET LOW) -- die Verbraucher bleiben bis dahin aus.
  MX_GPDMA1_Init();
  MX_DCACHE1_Init();
  MX_USART3_UART_Init();
  MX_FLASH_Init();
  MX_I2C4_Init();
  MX_UCPD1_Init();
  MX_ICACHE_Init();
  tx_kernel_enter();
  /* USER CODE END 2 */

  /* Infinite loop */
  /* USER CODE BEGIN WHILE */
  while (1)
  {
    /* USER CODE END WHILE */

    /* USER CODE BEGIN 3 */
  }
  /* USER CODE END 3 */
}

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
/* USER CODE BEGIN 4 */
// Gegenstueck zu den fruehen MX_*_Init()-Aufrufen in main() (USER CODE 2): alle restlichen
// Peripherien in der urspruenglich von CubeMX generierten Reihenfolge. Hier statt in einer
// anderen Datei, weil die MX_*_Init()-Funktionen static sind (Visibility in der .ioc).
void MX_Init_PowerConsumers(void)
{
  MX_ETH_Init();
  MX_I2C1_Init();
  MX_I2C2_Init();
  MX_SDMMC1_SD_Init();
  MX_SPI2_Init();
  MX_TIM2_Init();
  MX_TIM3_Init();
  MX_TIM4_Init();
  MX_TIM15_Init();
  MX_UART7_Init();
  MX_USB_PCD_Init();
  MX_FDCAN1_Init();
  MX_SPI4_Init();
  MX_OCTOSPI1_Init();
  MX_TIM16_Init();
  MX_TIM17_Init();
  MX_UART12_Init();
  MX_ADC1_Init();
  MX_UART5_Init();
}
/* USER CODE END 4 */
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
