klaus-liebler/factory_in_a_box/firmware_factory_control_unit/Core/Inc/fx_stm32_sd_driver.h

/**************************************************************************/
/*                                                                        */
/*       Copyright (c) Microsoft Corporation. All rights reserved.        */
/*                                                                        */
/*       This software is licensed under the Microsoft Software License   */
/*       Terms for Microsoft Azure RTOS. Full text of the license can be  */
/*       found in the LICENSE file at https://aka.ms/AzureRTOS_EULA       */
/*       and in the root directory of this software.                      */
/*                                                                        */
/**************************************************************************/

/* Define to prevent recursive inclusion -------------------------------------*/
#pragma once

#ifdef __cplusplus
extern "C" {
#endif

/* Includes ------------------------------------------------------------------*/
#include "fx_api.h"

#include "stm32h5xx_hal.h"
/* Exported types ------------------------------------------------------------*/
extern TX_SEMAPHORE sd_tx_semaphore;
extern TX_SEMAPHORE sd_rx_semaphore;

/* Exported constants --------------------------------------------------------*/
/* Default timeout used to wait for fx operations */
// War 10s -- das ist genau die Verzoegerung, die beim fehlenden microSD-Kartenlesen im Boot-Log
// sichtbar war: check_sd_status() (fx_stm32_sd_driver.c) wartet damit, bis
// fx_stm32_sd_get_status() "bereit" meldet, was ohne gesteckte Karte (hsd1 erreicht nie
// HAL_SD_CARD_TRANSFER, s. fx_stm32_sd_driver_adapter.c) nie eintritt -- die volle Zeitspanne
// wird also bei jedem Boot ohne Karte verbraten. Dieselbe Konstante gilt auch fuer die
// DMA-Completion-Semaphoren bei echten Sektor-Lese-/Schreibzugriffen (s. FX_STM32_SD_RX/TX_
// Makros weiter unten) -- 1s ist dafuer immer noch grosszuegig (eine einzelne Blockuebertragung
// braucht typischerweise wenige Millisekunden), reduziert die Kein-Karte-Wartezeit im Boot aber
// von 10s auf 1s.
// Achtung: liegt ausserhalb eines USER-CODE-Blocks, CubeMX-FileX-Regenerierung kann das
// zuruecksetzen.
#define FX_STM32_SD_DEFAULT_TIMEOUT                           (1 * TX_TIMER_TICKS_PER_SECOND)

/* let the filex low-level driver initialize the SD driver */
#define FX_STM32_SD_INIT                                      0

/* Enable the cache maintenance, needed when using SD DMA
 * and accessing buffers in cacheable area
 * this is valid only for CM7 based products or those
 * with dedicated cache IP.
 * For STM32H5 this flag should be always set to 0 unless external
 * memories are being used.
 */
#define FX_STM32_SD_CACHE_MAINTENANCE                         0

/* Use the SD DMA API */
#define FX_STM32_SD_DMA_API                                   1

/* SDIO instance to be used by FileX */
#define FX_STM32_SD_INSTANCE                                  0

/* Default sector size, used by the driver */
#define FX_STM32_SD_DEFAULT_SECTOR_SIZE                       512

/* Exported macro ------------------------------------------------------------*/
/* Define the macro to get the current time in ticks */
#define FX_STM32_SD_CURRENT_TIME()                            tx_time_get()

/* Macro called before initializing the SD driver
 * e.g. create a semaphore used for transfer notification */
/* USER CODE BEGIN FX_STM32_SD_PRE_INIT_TX */

#define FX_STM32_SD_PRE_INIT(_media_ptr)                do { \
                                                          if ((tx_semaphore_create(&sd_rx_semaphore, "sd rx transfer semaphore", 0) != TX_SUCCESS) || \
                                                              (tx_semaphore_create(&sd_tx_semaphore, "sd tx transfer semaphore", 0) != TX_SUCCESS))  \
                                                          { \
                                                            _media_ptr->fx_media_driver_status = FX_IO_ERROR; \
                                                          } \
                                                        } while(0)

/* USER CODE END FX_STM32_SD_PRE_INIT_TX */

/* Macro called after initializing the SD driver */
/* USER CODE BEGIN FX_STM32_SD_POST_INIT */

#define FX_STM32_SD_POST_INIT(_media_ptr)

/* USER CODE END FX_STM32_SD_POST_INIT */

/* Macro called after the SD deinit */

/* USER CODE BEGIN FX_STM32_SD_POST_DEINIT_TX */

#define FX_STM32_SD_POST_DEINIT(_media_ptr)             do { \
                                                          tx_semaphore_delete(&sd_rx_semaphore); \
                                                          tx_semaphore_delete(&sd_tx_semaphore); \
                                                        } while(0)

/* USER CODE END FX_STM32_SD_POST_DEINIT_TX */

/* Macro called after the abort request */
/* USER CODE BEGIN FX_STM32_SD_POST_ABORT */

#define FX_STM32_SD_POST_ABORT(_media_ptr)

/* USER CODE END FX_STM32_SD_POST_ABORT */

/* Macro called before performing read operation */
/* USER CODE BEGIN FX_STM32_SD_PRE_READ_TRANSFER_DMA */

#define FX_STM32_SD_PRE_READ_TRANSFER(_media_ptr)
/* USER CODE END FX_STM32_SD_PRE_READ_TRANSFER_DMA */

/* Macro called after performing read operation */
/* USER CODE BEGIN FX_STM32_SD_POST_READ_TRANSFER_TX */

#define FX_STM32_SD_POST_READ_TRANSFER(_media_ptr)

/* USER CODE END FX_STM32_SD_POST_READ_TRANSFER_TX */

/* Macro for read error handling */
/* USER CODE BEGIN FX_STM32_SD_READ_TRANSFER_ERROR_TX */

#define FX_STM32_SD_READ_TRANSFER_ERROR(_status_)

/* USER CODE END FX_STM32_SD_READ_TRANSFER_ERROR_TX */

/* Define how to notify about Read completion operation */
/* USER CODE BEGIN FX_STM32_SD_READ_CPLT_NOTIFY_TX */

#define FX_STM32_SD_READ_CPLT_NOTIFY()                  do { \
                                                          if(tx_semaphore_get(&sd_rx_semaphore, FX_STM32_SD_DEFAULT_TIMEOUT) != TX_SUCCESS) \
                                                            { \
                                                              return FX_IO_ERROR; \
                                                            } \
                                                        } while(0)

/* USER CODE END FX_STM32_SD_READ_CPLT_NOTIFY_TX */

/* Define how to notify about write completion operation */
/* USER CODE BEGIN FX_STM32_SD_WRITE_CPLT_NOTIFY_TX */

#define FX_STM32_SD_WRITE_CPLT_NOTIFY()                 do { \
                                                          if(tx_semaphore_get(&sd_tx_semaphore, FX_STM32_SD_DEFAULT_TIMEOUT) != TX_SUCCESS) \
                                                            { \
                                                              return FX_IO_ERROR; \
                                                            } \
                                                        } while(0)

/* USER CODE END FX_STM32_SD_WRITE_CPLT_NOTIFY_TX */

/* Macro called before performing write operation */
/* USER CODE BEGIN FX_STM32_SD_PRE_WRITE_TRANSFER_TX */

#define FX_STM32_SD_PRE_WRITE_TRANSFER(_media_ptr)

/* USER CODE END FX_STM32_SD_PRE_WRITE_TRANSFER_TX */

/* Macro called after performing write operation */
/* USER CODE BEGIN FX_STM32_SD_POST_WRITE_TRANSFER */

#define FX_STM32_SD_POST_WRITE_TRANSFER(_media_ptr)

/* USER CODE END FX_STM32_SD_POST_WRITE_TRANSFER */

/* Macro for write error handling */
/* USER CODE BEGIN FX_STM32_SD_WRITE_TRANSFER_ERROR */

#define FX_STM32_SD_WRITE_TRANSFER_ERROR(_status_)

/* USER CODE END FX_STM32_SD_WRITE_TRANSFER_ERROR */

/* Exported functions prototypes ---------------------------------------------*/

INT fx_stm32_sd_init(UINT instance);
INT fx_stm32_sd_deinit(UINT instance);

INT fx_stm32_sd_get_status(UINT instance);

INT fx_stm32_sd_read_blocks(UINT instance, UINT *buffer, UINT start_block, UINT total_blocks);
INT fx_stm32_sd_write_blocks(UINT instance, UINT *buffer, UINT start_block, UINT total_blocks);

VOID fx_stm32_sd_driver(FX_MEDIA *media_ptr);

#ifdef __cplusplus
}
#endif
