klaus-liebler/factory_in_a_box/firmware_factory_control_unit/Core/Src/app.cc

#include "app.hh"
#include "modbus_register_model.hh"
#include "tx_api.h"
#include "net_setup.hpp"
#include "opcua_setup.hpp"
#include "sntp_setup.hpp"
#include "opcua/clock.hpp"
#include "generated/gitconstants.hh"
#include "generated/device_ids.hh"
// Fuer App::ModbusRtuThread() -- ruft ux_device_class_cdc_acm_read()/_write() direkt auf (kein
// Zwischen-Wrapper in usbd_device.c), nur die Instanz selbst kommt von dort (s.
// usbd_cdc_modbus_instance()), weil sie in usbd_device.c privat bleibt (von
// cdc_modbus_activate()/_deactivate() gesetzt). ux_api.h zuerst, weil ux_device_class_cdc_acm.h
// dessen Basistypen (UX_SLAVE_INTERFACE, UX_MUTEX, ...) voraussetzt, ohne es selbst einzubinden.
#include "ux_api.h"
#include "ux_device_class_cdc_acm.h"
#include "nx_secure_tls_api.h"
#include "ina226.hpp"

extern "C" ADC_HandleTypeDef hadc1;
extern "C" I2C_HandleTypeDef hi2c4;

constexpr uint32_t DEFAULT_MEMORY_SIZE = 1024;
constexpr uint32_t DEFAULT_PRIORITY = 5;
constexpr uint32_t NX_APP_THREAD_STACK_SIZE = 8 * 1024;
constexpr uint32_t NX_APP_THREAD_PRIORITY = 10;
constexpr uint32_t IO_THREAD_STACK_SIZE = 6 * 1024;
// War 12 (niedrigere Prioritaet als NetX' eigener IP-Thread, s. net_setup.cpp
// NX_APP_INSTANCE_PRIORITY=10) -- ThreadX: kleinere Zahl = hoehere Prioritaet. Der IP-Thread
// verarbeitet ALLE eingehenden Pakete (TCP/HTTP/DHCP/mDNS) und verdraengte den IO-Thread damit
// bei jedem Webseiten-Reload komplett auf Thread-Ebene (nicht nur kurz per Interrupt), teils
// hunderte ms am Stueck -- das liess I2C4-/SPI2-Transfers (INA226, HX711) mit Timeout
// fehlschlagen, selbst nachdem ETH_IRQn/ETH_WKUP_IRQn (NVIC-Ebene, s. stm32h5xx_hal_msp.c)
// bereits abgesenkt wurden. Jetzt hoeher als der NetX-IP-Thread (10) und die App-Threads: der
// IO-Thread schlaeft ohnehin ~50ms pro Zyklus (s. io.hpp IO_THREAD_SLEEP_TICKS), gibt dem
// Netzwerk-Stack also reichlich Gelegenheit, ohne dass der Sensor-Zyklus verdraengt wird.
constexpr uint32_t IO_THREAD_PRIORITY = 8;
constexpr uint32_t USBD_DEVICE_THREAD_STACK_SIZE = 4 * 1024;
// Zwischen Modbus (5, zeitkritischste TCP-Antworten) und io_thread (8) angesiedelt -- s.
// Begruendung in app.hh (USB-Full-Speed-Timing vertraegt keinen 50ms-Zyklus).
constexpr uint32_t USBD_DEVICE_THREAD_PRIORITY = 6;
constexpr uint32_t MODBUS_RTU_THREAD_STACK_SIZE = 2 * DEFAULT_MEMORY_SIZE;
// Wie die vormalige RX/TX-Thread-Prioritaet in usbd_device.c (MODBUS_CDC_THREAD_PRIORITY) --
// reaktionsschnell wie usbd_device_thread, da beide auf denselben USB-Full-Speed-Zeitschranken
// laufen (App::ModbusRtuThread() ruft blockierend ux_device_class_cdc_acm_read()/_write() auf).
constexpr uint32_t MODBUS_RTU_THREAD_PRIORITY = 6;
constexpr uint32_t HEARTBEAT_THREAD_STACK_SIZE = 2 * 1024;
// Niedrigste Prioritaet aller App-Threads (grosse Zahl) -- reine Diagnose, darf nirgendwo
// dazwischenfunken, schlaeft ohnehin 3s pro Zyklus.
constexpr uint32_t HEARTBEAT_THREAD_PRIORITY = 12;

// TX_MUTEX{} zero-initialisiert u.a. tx_mutex_id -- tx_mutex_create() setzt dieses Feld
// intern auf die magische Konstante TX_MUTEX_ID (ungleich 0, s. tx_mutex.h), daher genuegt ein
// Test auf tx_mutex_id!=0 als "wurde bereits erzeugt"-Pruefung, ohne ein zusaetzliches
// bool-Flag zu pflegen. Schuetzt __malloc_lock/__malloc_unlock vor Aufrufen, die vor
// tx_application_define() passieren koennen (z.B. malloc() aus globalen Konstruktoren).
static TX_MUTEX malloc_mutex{};
static TX_MUTEX log_mutex{};

static void log_lock(bool lock) {
    if (lock) {
        tx_mutex_get(&log_mutex, TX_WAIT_FOREVER);
    } else {
        tx_mutex_put(&log_mutex);
    }
}

extern "C" void __malloc_lock(struct _reent *reent){
    (void)reent;
    if (malloc_mutex.tx_mutex_id == 0) return;
    tx_mutex_get(&malloc_mutex, TX_WAIT_FOREVER);
}

extern "C" void __malloc_unlock(struct _reent *reent){
    (void)reent;
    if (malloc_mutex.tx_mutex_id == 0) return;
    tx_mutex_put(&malloc_mutex);
}

extern "C" void tx_application_define(void *first_unused_memory) {
    (void)first_unused_memory;
    auto& app = App::Instance();

    tx_mutex_create(&malloc_mutex, const_cast<CHAR *>("malloc_mutex"), TX_INHERIT);
    // TX_INHERIT (not TX_NO_INHERIT as before): LOG_INFO_ML/LOG_ML/LOG_ML_END (log.h) can now
    // legitimately hold this lock for a while (e.g. the whole ~256ms I2C boot scan) -- priority
    // inheritance avoids unbounded priority inversion for any higher-priority thread that tries
    // to log during that window.
    tx_mutex_create(&log_mutex, const_cast<CHAR *>("Log Mutex"), TX_INHERIT);
    log_set_lock(log_lock);
    log_set_level(LOG_INFO);
    opcua::InitClockSync();

    log_info("tx_application_define() called, first_unused_memory=%p", first_unused_memory);

    static UCHAR byte_pool_buffer[NX_APP_MEM_POOL_SIZE] __attribute__((aligned(4)));
    XASSERT(tx_byte_pool_create(&app.byte_pool, _C("Byte Pool"),
                                 byte_pool_buffer, NX_APP_MEM_POOL_SIZE), "Byte Pool create failed");
    void *ptr = nullptr;
    XASSERT(tx_byte_allocate(&app.byte_pool, &ptr, NX_APP_THREAD_STACK_SIZE, TX_NO_WAIT), "App Main Thread stack allocate failed");
    XASSERT(tx_thread_create(&app.app_main_thread, _C("App Main Thread"),
                     App::AppThreadStatic, (ULONG)&app,
                     ptr, NX_APP_THREAD_STACK_SIZE,
                     NX_APP_THREAD_PRIORITY, NX_APP_THREAD_PRIORITY,
                     TX_NO_TIME_SLICE, TX_AUTO_START), "App Main Thread create failed");
    log_info("Application initialization complete");
}

void App::AppThreadStatic(ULONG arg) {
    reinterpret_cast<App*>(arg)->AppThread();
}

void App::ModbusTcpServerThreadStatic(ULONG arg) {
    reinterpret_cast<App*>(arg)->ModbusTcpServerThread();
}

void App::IOThreadStatic(ULONG arg) {
    reinterpret_cast<App*>(arg)->IOThread();
}

void App::ModbusRtuThreadStatic(ULONG arg) {
    reinterpret_cast<App*>(arg)->ModbusRtuThread();
}

void App::UsbdDeviceThreadStatic(ULONG arg) {
    reinterpret_cast<App*>(arg)->UsbdDeviceThread();
}

void App::HeartbeatThreadStatic(ULONG arg) {
    reinterpret_cast<App*>(arg)->HeartbeatThread();
}

void App::ModbusTcpServerThread(){
    this->modbus_tcp_server->initialize();
    log_info("Modbus TCP Server started on Port %u", this->modbus_tcp_server->Port());
    this->modbus_tcp_server->run();
}

// Blockierender Lese-/Verarbeitungs-/Sende-Loop fuer Modbus-RTU-ueber-USB-CDC. Lebt bewusst
// hier (statt in modbus_rtu_server.hpp) -- ModbusRtuServer selbst enthaelt nur noch die
// Protokoll-Logik (Framing/CRC/Register-Zugriff, s. dortiger Klassenkommentar), keine eigene
// Thread-/USB-IO-Schleife. Ruft ux_device_class_cdc_acm_read()/_write() direkt auf (kein
// Zwischen-Wrapper in usbd_device.c) -- nur die Instanz selbst kommt von dort (s.
// usbd_cdc_modbus_instance()), weil sie in usbd_device.c privat bleibt (von
// cdc_modbus_activate()/_deactivate() gesetzt). EIN Thread, EIN Puffer (ModbusRtuServer::
// Buffer()) statt vorheriger Ringpuffer-/Mailbox-Konstruktion mit zwei Zwischen-Threads:
// Empfangen und Senden schliessen sich hier gegenseitig aus, was fuer Modbus-RTU (strikt
// Anfrage/Antwort, nie beides gleichzeitig unterwegs) ohnehin passt.
[[noreturn]] void App::ModbusRtuThread() {
    log_info("Modbus RTU Server started on USB-CDC (slave ID %u)", this->modbus_rtu_server->SlaveId());

    uint8_t* buf = this->modbus_rtu_server->Buffer();
    const size_t buf_size = ModbusRtuServer::BufferSize();
    const ULONG inter_frame_timeout_ticks = this->modbus_rtu_server->InterFrameTimeoutTicks();
    size_t message_length = 0;
    size_t response_length = 0;
    ULONG last_rx_tick = tx_time_get();

    while (true) {
        UX_SLAVE_CLASS_CDC_ACM* instance = usbd_cdc_modbus_instance();
        if (instance == nullptr) {
            // Kein Host verbunden -- kurz schlafen
            tx_thread_sleep(10);
            continue;
        }

        ULONG actual_length = 0;

        if (response_length != 0) {
            // Antwort steht bereits vollstaendig in buf (s. ModbusRtuServer::ProcessChunk()) --
            // senden und erst danach wieder empfangen (Modbus-RTU ist strikt Anfrage/Antwort).
            ux_device_class_cdc_acm_write(instance, buf, (ULONG)response_length, &actual_length);
            response_length = 0;
            continue;
        }

        UINT status = ux_device_class_cdc_acm_read(instance, buf + message_length,
                                                    (ULONG)(buf_size - message_length), &actual_length);
        if (status != UX_SUCCESS || actual_length == 0) {
            // Timeout (UX_NON_CONTROL_TRANSFER_TIMEOUT), Deaktivierung waehrend des Wartens,
            // o.ae. -- angefangener Frame zu lange her -- verwerfen.
            if (message_length != 0 && (tx_time_get() - last_rx_tick) > inter_frame_timeout_ticks) {
                message_length = 0;
            }
            continue;
        }

        message_length += actual_length;
        last_rx_tick = tx_time_get();
        this->modbus_rtu_server->ProcessChunk(&message_length, &response_length);

        if (message_length == buf_size && response_length == 0) {
            // Ueberlauf-Schutz: Puffer randvoll, aber immer noch kein gueltiger Frame -- neu
            // anfangen statt beim naechsten Durchlauf mit space=0 zu lesen.
            message_length = 0;
        }
    }
}

void App::IOThread() {
    this->io->Setup();
    log_info("I/O Thread started");
    this->io->Loop();
}

// serial_string/net_mac/net_mac_string kommen fix-und-fertig aus Core/generated/
// device_ids.hh -- nicht mehr wie frueher (s. Commit-Historie) hier aus this->chip_uid
// abgeleitet (App::InitIdentityAndRegisterModel() prueft bereits beim Boot, dass DEVICE_CHIP_UID_W0/1/2
// zur tatsaechlichen Chip-UID passen, s. dort).
[[noreturn]] void App::UsbdDeviceThread() {
    usbd_device_setup(DEVICE_USB_SERIAL_STRING, DEVICE_USB_NCM_MAC, DEVICE_USB_NCM_MAC_STRING);
    log_info("USB Device Thread started");
    usbd_device_loop();
}

// Rein diagnostisch: liest ausschliesslich bereits vom io_thread periodisch aktualisierte
// Register (CPU_TEMPERATURE_C/FREE_HEAP_KIB/PWR_*, s. cpu_temp.hh/power.hh/io.cpp) -- kein
// eigener Zugriff auf DTS/I2C4, daher unkritisch bzgl. Peripherie-Besitz/Timing des io_threads.
// PWR_STATUS==0 bedeutet "INA226 erkannt und Read() erfolgreich" (s. power.hh); ohne das faellt
// die Zeile auf einen "n/a"-Hinweis zurueck statt eine Spannung/Strom von 0 vorzutaeuschen.
//
// Sendet ausserdem bei jedem Durchlauf ein WebSocket-Ping an alle verbundenen Clients (s.
// Http::WebServer::SendKeepalivePings()) -- ohne das wuerde eine ansonsten gesunde, aber
// inaktive WebSocket-Verbindung nach Ablauf des Session-Timeouts (net_setup.cpp, aktuell 30s)
// einfach getrennt (sichtbar im Log als "WebSocket: Verbindung geschlossen"/"...geoeffnet" im
// Minutentakt), da Broadcast()-Nachrichten (z.B. die Log-Spiegelung) rein ausgehend sind und den
// Idle-Timer von nx_tcpserver nicht zuruecksetzen -- nur eingehende Bytes tun das, hier also das
// vom Browser automatisch beantwortete Pong. 3s-Takt ist bewusst grosszuegig unter dem Timeout,
// kein eigener Thread/Timer noetig, da dieser Thread ohnehin schon in diesem Takt laeuft.
[[noreturn]] void App::HeartbeatThread() {
    log_info("Heartbeat Thread started");
    while (true) {
        int16_t cpu_temp_c = (int16_t)this->register_model->GetInputRegister(ModbusRegisters::Input::CPU_TEMPERATURE_C);
        uint16_t free_heap_kib = this->register_model->GetInputRegister(ModbusRegisters::Input::FREE_HEAP_KIB);
        bool power_ok = this->register_model->GetInputRegister(ModbusRegisters::Input::PWR_STATUS) == 0;
        ULONG tx_ticks_now = tx_time_get();

        this->https_server.SendKeepalivePings();

        // See usbd_device_poll_state_change()'s comment (usbd_device.h) -- the USB ISR only
        // records the latest state; logging it happens here, from proper thread context.
        char usb_state_message[64];
        if (usbd_device_poll_state_change(usb_state_message, sizeof(usb_state_message))) {
            log_info("%s", usb_state_message);
        }

        if (power_ok) {
            uint16_t bus_mv = this->register_model->GetInputRegister(ModbusRegisters::Input::PWR_BUS_VOLTAGE_MV);
            int16_t current_ma = (int16_t)this->register_model->GetInputRegister(ModbusRegisters::Input::PWR_CURRENT_MA);
            log_info("Heartbeat: CPU=%d C, FreeHeap=%u KiB, Bus=%u mV, Current=%d mA",
                     (int)cpu_temp_c, (unsigned)free_heap_kib, (unsigned)bus_mv, (int)current_ma);
        } else {
            log_info("Heartbeat: CPU=%d C, FreeHeap=%u KiB, Power=n/a (INA226 nicht erkannt)",
                     (int)cpu_temp_c, (unsigned)free_heap_kib);
        }

        // Bis zur naechsten durch 3 teilbaren Sekunde schlafen (statt starr 3s ab jetzt) --
        // Ausgaben landen dadurch auf einem festen 0/3/6/9...-Sekundenraster seit Boot, statt
        // mit der Zeit zu "wandern" (die Laufzeit des Schleifenkoerpers selbst wuerde sich sonst
        // von Durchlauf zu Durchlauf aufsummieren).
        ULONG now_seconds = tx_ticks_now / TX_TIMER_TICKS_PER_SECOND;
        ULONG next_seconds = ((now_seconds / 3) + 1) * 3;
        ULONG target_ticks = next_seconds * TX_TIMER_TICKS_PER_SECOND;
        // -1: tx_thread_sleep(N) garantiert nur "mindestens N Ticks" -- in der Praxis wacht der
        // Thread erst nach N+1 Ticks auf (er wartet den aktuell schon angebrochenen Tick noch
        // vollstaendig ab, s. Debugging-Sitzung: txTicks landete deshalb immer auf .../...01
        // statt .../...00). Ein Tick weniger anfordern kompensiert das, sodass wir tatsaechlich
        // exakt auf target_ticks aufwachen. sleep_ticks bleibt dabei immer >=1 (target liegt per
        // Konstruktion mindestens 1 Tick, hoechstens 300 Ticks in der Zukunft).
        ULONG sleep_ticks = target_ticks - tx_ticks_now - 1;
        tx_thread_sleep(sleep_ticks);
    }
}

void App::AppThread() {
    void *ptr = nullptr;

    // Muss die allererste Zeile sein: ab hier laeuft echter ThreadX-Thread-Kontext (dieser
    // Thread ist der einzige mit TX_AUTO_START), tx_thread_sleep() ist somit ab jetzt ueberall
    // im Programm zulaessig -- s. hal_tick_threadx.c/HAL_Delay().
    hal_tick_threadx_mark_running();

    InitIdentityAndRegisterModel();

    // Erst wenn die Versorgung steht, die stromhungrige Peripherie und alles, was darauf
    // aufbaut -- s. WaitForSupplyVoltage() und main.c (USER CODE 2/4).
    WaitForSupplyVoltage();
    MX_Init_PowerConsumers();

    // Reset-Pin des LAN8720-Phy kurz auf LOW, damit er sauber startet (s. LAN8720-Datenblatt).
    // MX_GPIO_Init() haelt ihn ohnehin seit dem Boot im Reset -- erst hier freigeben.
    HAL_GPIO_WritePin(ETH_RESET_GPIO_Port, ETH_RESET_Pin, GPIO_PIN_RESET);
    HAL_Delay(10);
    HAL_GPIO_WritePin(ETH_RESET_GPIO_Port, ETH_RESET_Pin, GPIO_PIN_SET);
    HAL_Delay(10);

    // ADC1 Continuous-Conversion-Modus starten
    HAL_ADC_Start(&hadc1);

    // Frueher in tx_application_define() -- jetzt hier, weil der ETH-Treiber (nx_ip_create() mit
    // nx_stm32_eth_driver) MX_ETH_Init() und einen aus dem Reset entlassenen PHY braucht.
    fx_system_initialize();
    nx_system_initialize();
    // Legt u.a. NetX Secures globalen _nx_secure_tls_protection-Mutex an. Fehlte bis 2026-10-07:
    // ohne ihn scheiterte jedes interne tx_mutex_get() still mit TX_MUTEX_ERROR, TLS lief also
    // komplett ungeschuetzt -- obwohl Http::WebServer::Broadcast() (Log-Spiegelung) aus beliebigen
    // Threads auf dieselben TLS-Sessions sendet wie der nx_tcpserver-Thread.
    nx_secure_tls_initialize();
    net_setup_create(this, &this->byte_pool);

    net_setup_start(this);

    // See sntp_setup.hpp -- own thread, waits for the network then keeps opcua::Now() synced to
    // real UTC via SNTP (see libs/opcua_native/include/opcua/clock.hpp).
    SntpSetup(this);

    // See opcua_setup.hpp -- unlike Modbus TCP/HTTPS, no dedicated thread is created here:
    // nx_tcpserver_create() (inside OpcUaTcpServer::Create()) spawns and auto-starts its own
    // worker thread, and this server has no separate timer engine that would need one.
    OpcUaServerSetup(this);

    this->modbus_tcp_server = new ModbusTcpServer(&this->ip_instance, &this->packet_pool, *this->register_model);

    // cdc_itf=1: zweite CDC-Deskriptorinstanz in usbd_device.c (ITF_CDC1_MODBUS_*), Instanz 0
    // ist "FactoryControl Debug". slave_id=1 (Modbus-Standard-Default, ueber Modbus-Register
    // aktuell nicht konfigurierbar -- bei Bedarf spaeter aus einem Holding-Register lesen).
    // Braucht wie ModbusTcpServer einen eigenen Thread (s. modbus_rtu_thread-Erzeugung unten) --
    // App::ModbusRtuThread() liest/verarbeitet/sendet blockierend in einer Endlosschleife (s.
    // dort).
    this->modbus_rtu_server = new ModbusRtuServer(1, *this->register_model);

    XASSERT(tx_byte_allocate(&this->byte_pool, &ptr, 2 * DEFAULT_MEMORY_SIZE, TX_NO_WAIT), "Modbus TCP server thread stack allocate failed");
    XASSERT(tx_thread_create(
        &this->modbus_tcp_server_thread,
        _C("Modbus TCP Server Thread"),
        ModbusTcpServerThreadStatic,
        (ULONG)this,
        ptr,
        2 * DEFAULT_MEMORY_SIZE,
        DEFAULT_PRIORITY,
        DEFAULT_PRIORITY,
        TX_NO_TIME_SLICE,
        TX_AUTO_START
    ), "Modbus TCP server thread create failed");

    XASSERT(tx_byte_allocate(&this->byte_pool, &ptr, MODBUS_RTU_THREAD_STACK_SIZE, TX_NO_WAIT), "Modbus RTU thread stack allocate failed");
    XASSERT(tx_thread_create(
        &this->modbus_rtu_thread,
        _C("Modbus RTU Thread"),
        ModbusRtuThreadStatic,
        (ULONG)this,
        ptr,
        MODBUS_RTU_THREAD_STACK_SIZE,
        MODBUS_RTU_THREAD_PRIORITY,
        MODBUS_RTU_THREAD_PRIORITY,
        TX_NO_TIME_SLICE,
        TX_AUTO_START
    ), "Modbus RTU thread create failed");

    this->io = new Io(*this->register_model, this->ip_instance, this->dhcp_client, *this->usb_pd_control);
    // io->Setup() (registerlevel-Init aller Subsysteme: ADC-Start, PWM-Modus-Fixups, TMC2209-
    // UART-Init, I2C-Sensor-Init, FDCAN-Filter, WS2812/LED-Init) laeuft im IO-Thread selbst
    // (App::IOThread()), NICHT hier -- mehrere der darin aufgerufenen Setup()-Funktionen
    // brauchen funktionierende HAL-Timeouts (HAL_Delay()/HAL_I2C_*), die waehrend
    // tx_application_define() nicht funktionieren (Interrupts gesperrt, solange
    // tx_kernel_enter() laeuft).
    XASSERT(tx_byte_allocate(&this->byte_pool, &ptr, IO_THREAD_STACK_SIZE, TX_NO_WAIT), "IO Thread stack allocate failed");
    XASSERT(tx_thread_create(&this->io_thread, _C("IO Thread"),
                     App::IOThreadStatic, (ULONG)this,
                     ptr, IO_THREAD_STACK_SIZE,
                     IO_THREAD_PRIORITY, IO_THREAD_PRIORITY,
                     TX_NO_TIME_SLICE, TX_AUTO_START), "IO thread create failed");

    // Reaktionsschnell (s. Begruendung in app.hh): niedrigere Prioritaetszahl = hoehere
    // Prioritaet als io_thread, damit USB-Enumeration/Bulk-Transfers nicht durch den
    // 50ms-Sensor-/Aktor-Zyklus ausgebremst werden.
    XASSERT(tx_byte_allocate(&this->byte_pool, &ptr, USBD_DEVICE_THREAD_STACK_SIZE, TX_NO_WAIT), "USB Device Thread stack allocate failed");
    XASSERT(tx_thread_create(&this->usbd_device_thread, _C("USB Device Thread"),
                     App::UsbdDeviceThreadStatic, (ULONG)this,
                     ptr, USBD_DEVICE_THREAD_STACK_SIZE,
                     USBD_DEVICE_THREAD_PRIORITY, USBD_DEVICE_THREAD_PRIORITY,
                     TX_NO_TIME_SLICE, TX_AUTO_START), "USB Device thread create failed");

    XASSERT(tx_byte_allocate(&this->byte_pool, &ptr, HEARTBEAT_THREAD_STACK_SIZE, TX_NO_WAIT), "Heartbeat Thread stack allocate failed");
    XASSERT(tx_thread_create(&this->heartbeat_thread, _C("Heartbeat Thread"),
                     App::HeartbeatThreadStatic, (ULONG)this,
                     ptr, HEARTBEAT_THREAD_STACK_SIZE,
                     HEARTBEAT_THREAD_PRIORITY, HEARTBEAT_THREAD_PRIORITY,
                     TX_NO_TIME_SLICE, TX_AUTO_START), "Heartbeat thread create failed");

    // Letzte Byte-Pool-Zuteilung im ganzen Boot-Ablauf -- ab hier ist bekannt, wie viel von den
    // NX_APP_MEM_POOL_SIZE (s. constants.hh) tatsaechlich noch frei bleibt (u.a. seit die TLS-Metadata-/
    // Paketpuffer in net_setup.cpp aus diesem Pool statt vom Heap kommen). available_bytes==0
    // waere trotz erfolgreicher einzelner tx_byte_allocate()-Aufrufe ein Alarmsignal (Pool bereits
    // bis auf Fragmentierungsreste ausgeschoepft).
    ULONG byte_pool_available = 0;
    ULONG byte_pool_fragments = 0;
    if (tx_byte_pool_info_get(&this->byte_pool, nullptr, &byte_pool_available, &byte_pool_fragments, nullptr, nullptr, nullptr) == TX_SUCCESS) {
        log_info("Byte Pool: %lu von %lu Byte frei (%lu Fragmente)",
                  (unsigned long)byte_pool_available, (unsigned long)NX_APP_MEM_POOL_SIZE, (unsigned long)byte_pool_fragments);
    }
}

void App::fillRegistersWithInitialValues() {
    this->register_model->SetInputRegister(ModbusRegisters::Input::FW_VERSION_MAJOR, FW_VERSION_MAJOR);
    this->register_model->SetInputRegister(ModbusRegisters::Input::FW_VERSION_MINOR, FW_VERSION_MINOR);
    ModbusRegisters::Accessors::Diagnostics::ChipId_Write(*this->register_model,
        ModbusRegisters::Uid96{chip_uid[0], chip_uid[1], chip_uid[2]});
}

void App::greeting() {
    // LOG_INFO_ML/LOG_ML/LOG_ML_END (log.h): one locked block so another thread's concurrent
    // log line can't land in the middle of this banner.
    LOG_INFO_ML("");
    LOG_ML("=== FactoryInABox Control Unit starting ===");
    LOG_ML(" -> Board:    %.*s", (int)BOARD_NAME.length(), BOARD_NAME.data());
    LOG_ML(" -> Hostname: %s.local", DEVICE_HOSTNAME);
    LOG_ML("--- Build Information ---");
    LOG_ML(" -> Version:  %.*s", (int)git::VERSION.length(), git::VERSION.data());
    LOG_ML(" -> Commit:   %.*s (%.*s)", (int)git::COMMIT_HASH.length(), git::COMMIT_HASH.data(),
            (int)git::BRANCH.length(), git::BRANCH.data());
    LOG_ML(" -> Message:  %.*s", (int)git::COMMIT_MESSAGE.length(), git::COMMIT_MESSAGE.data());
    LOG_ML(" -> Author:   %.*s", (int)git::COMMIT_AUTHOR.length(), git::COMMIT_AUTHOR.data());
    // %lu statt %lld: newlib-nano (dieses Projekts printf-Implementierung) unterstuetzt keine
    // 64-Bit-Formatspezifizierer -- ein Unix-Epoch-Zeitstempel in Sekunden passt aber bis Jahr
    // 2106 komfortabel in 32 Bit.
    LOG_ML(" -> Built:    %lu (epoch)", (unsigned long)git::BUILD_TIMESTAMP_EPOCH);
    // War zuvor invertiert (dirty -> "Clean: yes" als WARN, clean -> "Clean: no" als INFO) --
    // ML-Bloecke haben nur einen Level fuer den ganzen Block (s. log.h), daher hier als reiner
    // Text statt eines Level-Wechsels mitten im Block ausgedrueckt.
    LOG_ML(" -> Clean:    %s", git::IS_DIRTY ? "no" : "yes");

    LOG_ML("--- Clocks ---");
    LOG_ML(" -> SYSCLK:   %lu MHz", (unsigned long)(HAL_RCC_GetSysClockFreq() / 1000000));
    LOG_ML(" -> HCLK:     %lu MHz", (unsigned long)(HAL_RCC_GetHCLKFreq() / 1000000));
    LOG_ML(" -> PCLK1:    %lu MHz", (unsigned long)(HAL_RCC_GetPCLK1Freq() / 1000000));
    LOG_ML(" -> PCLK2:    %lu MHz", (unsigned long)(HAL_RCC_GetPCLK2Freq() / 1000000));

    LOG_ML("--- Chip ---");
    LOG_ML(" -> UID:      %08lX-%08lX-%08lX", (unsigned long)this->chip_uid[0], (unsigned long)this->chip_uid[1], (unsigned long)this->chip_uid[2]);
    LOG_ML(" -> Reset:    %s", reset_cause());
    __HAL_RCC_CLEAR_RESET_FLAGS();

    // Direkt aus DEVICE_ETH_MAC statt aus heth.Init.MACAddr: MX_ETH_Init() (das letzteres
    // befuellt) laeuft erst nach der Versorgungsspannungspruefung, s. App::AppThread().
    LOG_ML(" -> MAC:      %02X:%02X:%02X:%02X:%02X:%02X",
            DEVICE_ETH_MAC[0], DEVICE_ETH_MAC[1], DEVICE_ETH_MAC[2],
            DEVICE_ETH_MAC[3], DEVICE_ETH_MAC[4], DEVICE_ETH_MAC[5]);
    LOG_ML("============================================");
    LOG_ML_END();
}

// Erster Schritt im App-Main-Thread (s. AppThread()) -- frueher als SetupBeforeThreadX() vor
// tx_kernel_enter(), wofuer es aber keinen Grund gibt: zu diesem Zeitpunkt laeuft noch kein
// anderer Thread, das kurze Abschalten des ICACHE fuer die UID-Lesezugriffe stoert also niemanden.
void App::InitIdentityAndRegisterModel() {
    HAL_ICACHE_Disable();
    this->chip_uid[0] = HAL_GetUIDw0();
    this->chip_uid[1] = HAL_GetUIDw1();
    this->chip_uid[2] = HAL_GetUIDw2();
    HAL_ICACHE_Enable();
    // Board-Identitaetscheck: DEVICE_CHIP_UID_W0/1/2 (Core/generated/device_ids.hh) sind
    // fuer genau EIN physisches Board eincompiliert (s.
    // builder/Phases/ReadHardwareIds.cs) -- USB-Seriennummer und NCM-MAC-Adresse
    // (DEVICE_USB_SERIAL_STRING/DEVICE_USB_NCM_MAC, s. UsbdDeviceThread()) sind daraus abgeleitet
    // und wuerden bei einem Mismatch STILL die falsche Identitaet nach aussen zeigen. Deshalb
    // hier ein harter Stopp statt eines Log-Warnings, sobald die tatsaechliche Chip-UID nicht
    // passt (z.B. Firmware von Board A versehentlich auf Board B geflasht) -- noch vor jedem
    // weiteren Setup-Schritt.
    if (this->chip_uid[0] != DEVICE_CHIP_UID_W0 || this->chip_uid[1] != DEVICE_CHIP_UID_W1 ||
        this->chip_uid[2] != DEVICE_CHIP_UID_W2) {
        log_error("Chip-UID mismatch: Firmware wurde fuer ein anderes Board provisioniert! "
                  "eincompiliert=%08lX-%08lX-%08lX tatsaechlich=%08lX-%08lX-%08lX -- "
                  "\"node tools/provision_board_individual_data_and_files.mjs\" fuer DIESES Board ausfuehren.",
                  (unsigned long)DEVICE_CHIP_UID_W0, (unsigned long)DEVICE_CHIP_UID_W1, (unsigned long)DEVICE_CHIP_UID_W2,
                  (unsigned long)this->chip_uid[0], (unsigned long)this->chip_uid[1], (unsigned long)this->chip_uid[2]);
        Error_Handler();
    }

    greeting();
    
    this->register_model = BuildModbusRegisterModel();
    // Sofort "scharf" schalten: noch greift nur dieser Thread zu, aber alle weiteren Threads
    // (IO, Modbus, Webserver, ...) entstehen erst danach in AppThread().
    this->register_model->ArmForMultithreadingWithMutex();
    this->usb_pd_control = new USBPDControl(this->register_model);
    fillRegistersWithInitialValues();
}

// Mindestspannung, ab der die stromhungrigen Verbraucher (Stepper-Endstufen, ETH-PHY, ...)
// initialisiert werden duerfen. USB-PD wird mit 20V angefordert, der Hohlstecker-Eingang liefert
// ebenfalls ~20V -- 18V lassen Spielraum fuer Messtoleranz und Leitungsverluste.
constexpr int32_t SUPPLY_MIN_MV = 18000;
constexpr int PD_REQUEST_MV = 20000;
// Wie in PowerSetupAndLoop (setup_and_loops/power.hh) -- fuer die reine Busspannung ohne Belang,
// muss aber fuer INA226::Init() (Kalibrierregister) sinnvoll gesetzt sein.
constexpr double SUPPLY_SHUNT_MILLIOHM = 10.0;
constexpr uint32_t SUPPLY_MAX_EXPECTED_CURRENT_MA = 8000;
constexpr int SUPPLY_MAX_CONSECUTIVE_READ_FAILURES = 5;
constexpr ULONG SUPPLY_WAIT_LOG_INTERVAL_TICKS = 5 * TX_TIMER_TICKS_PER_SECOND;

// Spannungs-Gate vor allen stromhungrigen Verbrauchern: misst per INA226 (I2C4) die
// Versorgungsspannung. Liegen bereits >18V an (Hohlstecker, oder ein PD-Netzteil, das schon von
// einem vorherigen Boot her 20V liefert), geht es sofort weiter. Sonst wird USB-PD gestartet,
// 20V angefordert und blockiert, bis der INA226 >18V misst -- bewusst ohne Timeout (ohne
// ausreichende Versorgung soll nichts Weiteres laufen). Antwortet der INA226 nicht, kann die
// Versorgung nicht geprueft werden -- dann harter Stopp.
void App::WaitForSupplyVoltage() {
#ifdef BOARD_NUCLEO_H563ZI
    // Test-Rig ohne INA226 und ohne 20V-Versorgung (nur ST-Link-USB) -- dort gibt es weder etwas
    // zu messen noch stromhungrige Verbraucher, die geschuetzt werden muessten.
    log_info("Versorgung: Nucleo-Board -- keine Spannungspruefung, USB-PD wird nicht gestartet");
    this->usb_pd_control->UpdatePdStatusRegister();
    return;
#endif
    ina226::INA226 monitor{&hi2c4, SUPPLY_SHUNT_MILLIOHM, SUPPLY_MAX_EXPECTED_CURRENT_MA};
    if (!(monitor.Probe() && monitor.Init())) {
        log_error("INA226 (I2C4, addr 0x40) nicht erkannt -- Versorgungsspannung nicht pruefbar, Abbruch");
        Error_Handler();
    }
    // Erste Wandlung abwarten: 4 Samples x (1.1ms Bus + 1.1ms Shunt), s. ina226.cpp CONFIG_VALUE.
    tx_thread_sleep(2);

    int consecutive_failures = 0;
    auto read_bus_mv = [&]() -> int32_t {
        ina226::Measurement m;
        while (!monitor.Read(&m)) {
            if (++consecutive_failures >= SUPPLY_MAX_CONSECUTIVE_READ_FAILURES) {
                log_error("INA226: %d Lesefehler in Folge -- Versorgungsspannung nicht pruefbar, Abbruch",
                          consecutive_failures);
                Error_Handler();
            }
            tx_thread_sleep(1);
        }
        consecutive_failures = 0;
        return m.bus_voltage_mv;
    };

    int32_t bus_mv = read_bus_mv();
    if (bus_mv >= SUPPLY_MIN_MV) {
        log_info("Versorgung: %ld mV liegen bereits an -- USB-PD wird nicht gestartet", (long)bus_mv);
        this->usb_pd_control->UpdatePdStatusRegister();
        return;
    }

    log_info("Versorgung: nur %ld mV -- starte USB-PD und warte auf >= %ld mV",
             (long)bus_mv, (long)SUPPLY_MIN_MV);
    this->usb_pd_control->Start(PD_REQUEST_MV);
    ULONG last_log = tx_time_get();
    while (bus_mv < SUPPLY_MIN_MV) {
        this->usb_pd_control->Loop();
        tx_thread_sleep(1);
        bus_mv = read_bus_mv();
        if (tx_time_get() - last_log >= SUPPLY_WAIT_LOG_INTERVAL_TICKS) {
            last_log = tx_time_get();
            log_warn("Versorgung: warte weiterhin auf >= %ld mV, aktuell %ld mV",
                     (long)SUPPLY_MIN_MV, (long)bus_mv);
        }
    }
    this->usb_pd_control->Loop();
    log_info("Versorgung: %ld mV erreicht", (long)bus_mv);
}
