klaus-liebler/factory_in_a_box/(commit log)

2025-12-16 Initial commit lichee_rv_nano_base pcb
    [BOM-licheerv_nano_base.csv, licheerv_nano_base.kicad_pcb, licheerv_nano_base.kicad_sch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]
2025-12-23 lichee_rv_nano aka radxa zero 3e as ordered @ jlcpcb
    [BOM-licheerv_nano_base.csv, actors.kicad_sch, licheerv_nano_base.kicad_pcb, licheerv_nano_base.kicad_sch, psu.kicad_sch, sensors.kicad_sch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]
2026-01-25 Fixes
    - air ventilation holes
    - HX711 is on SPI MISO and SPI MOSI according to https://github.com/ufnalski/hx711_non_blocking_spi_g431kb (PC10-->PC11, PC11-->PC12)
    - DC connector polarity changed
    - connectors for voltages
    - TMC2209 got different communication IDs
    - Elkos mor space
    [radxa_zero_3e_control_unit.kicad_pcb, radxa_zero_3e_control_unit.kicad_sch]
2026-02-08 WIP, before repinning SUM32G431
    [actors.kicad_sch, psu.kicad_sch, radxa_zero_3e_control_unit.kicad_pcb, radxa_zero_3e_control_unit.kicad_sch]
2026-02-10 Udated control unit pcb
    [actors.kicad_sch, psu.kicad_sch, radxa_zero_3e_control_unit.kicad_pcb, radxa_zero_3e_control_unit.kicad_sch, sensors.kicad_sch]
2026-02-17 Sigmoid Stepper
    [psu.kicad_sch, radxa_zero_3e_control_unit.kicad_pcb, radxa_zero_3e_control_unit.kicad_sch]
2026-02-19 Sigmoid Test Plots
    [motion_full.csv, motion_short.csv]
2026-02-26 First time zero errors, but bad layout
    [Budgetplanung.xlsx, actors.kicad_sch, conn.kicad_sch, eth.kicad_sch, pcb_control_unit_ethernet.kicad_pcb, pcb_control_unit_ethernet.kicad_sch, psu.kicad_sch, sensors.kicad_sch]
2026-03-01 WIP 2nd
    [eth.kicad_sch, ethercat_esc.kicad_sch]
2026-03-02 EtherCAT + HX711
    [ethercat_esc.kicad_sch, sensors.kicad_sch]
2026-03-18 Create Calculation HX711.xlsx
    [Calculation HX711.xlsx]
2026-05-06 New version
    [actors.kicad_sch, conn.kicad_sch, eth.kicad_sch, ethercat_esc.kicad_sch, pcb_control_unit_ethernet.kicad_pcb, pcb_control_unit_ethernet.kicad_sch, psu.kicad_sch, sensors.kicad_sch]
2026-05-14 Almost orderable, but: Size is too large to fit
    [BOM-pcb_control_unit_ethernet.csv, ethercat_esc.kicad_sch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]
2026-05-15 Release Candidate
    [actors.kicad_sch, pcb_control_unit_ethernet.kicad_pcb, pcb_control_unit_ethernet.kicad_sch]
2026-05-16 pcb_control_unit_ethercat as ordered @ JLCPCB
    [BOM-pcb_control_unit_ethernet.csv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]
2026-07-13 Consolidate common_stm32/tmc2209/usb_pd into stm32_libs submodule
    Adds the new github.com/klaus-liebler/stm32_libs repo as a submodule
    (shared by all three consumers via relative add_subdirectory() paths)
    and removes the now-duplicated local copies:
    - firmware_stm32_control_unit: common_stm32, TMC2209, usb_pd
    - firmware_stm32_devboard: common_stm32, tmc2209
    - WebServerExample/Nx_WebServer: newly wired up (didn't consume these
    libraries before) via a small local "stm32cubemx" INTERFACE target,
    since it uses the single-target vscode_generated.cmake CMake layout
    instead of the G4 projects' classic multi-target style. Also adds
    the LL (Low-Layer) UCPD/GPIO/DMA driver files this needed, w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
2026-07-14 Changed LED ReverseMount Footprint, Removed PullUp, HSOS Logo
    [actors.kicad_sch, conn.kicad_sch, eth.kicad_sch, ethercat_esc.kicad_sch, pcb_factory_control_unit.kicad_pcb, pcb_factory_control_unit.kicad_sch, psu.kicad_sch, sensors.kicad_sch]
2026-07-16 Renaming & transfering test code
    [Calculation HX711.xlsx, pcb_factory_control_unit.kicad_sch]
2026-07-16 Fixed code regeneration issues
    [firmware_factory_control_unit.ioc, main.c]
2026-07-17 TIM15 DMA for WS2812
2026-07-18 Massive refactoring
    [pcb_factory_control_unit.kicad_pcb, pcb_factory_control_unit.kicad_sch]
2026-07-18 Dynamic Controls in HTML, Hardware config assertions, still problems to solve with UART5
    [app.cc, firmware_factory_control_unit.ioc, io.hpp, main.c]
2026-07-19 Add INA226 power monitor, CPU temp/heap diagnostics, and fix cross-peripheral I2C/network starvation issues
    New:
    - INA226 driver (libs/hw/ina226) on I2C4, wired into the IO thread as
    PowerSetupAndLoop; populates PWR_BUS_VOLTAGE_MV/PWR_SHUNT_VOLTAGE_UV/
    PWR_CURRENT_MA/PWR_POWER_MW/PWR_STATUS. Shunt resistance calibrated
    empirically (3.2 mOhm effective vs 2 mOhm nominal, due to parasitic
    PCB/Kelvin-connection resistance dominating at this small a shunt value;
    comment documents the plan to move to 10 mOhm on a future board rev).
    - STM32H563 internal temperature via the DTS peripheral (RM0481 ch. 29,
    no HAL driver exists for it) and free-heap-in-KiB, both as new
    diagnostic register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
    [app.cc, firmware_factory_control_unit.ioc, io.cpp, io.hpp, main.c]
2026-07-19 Switched Resistor to special current sense resistor with 1mOhms
    [pcb_factory_control_unit.kicad_pcb]
2026-07-19 Rebuild web UI as multi-app dashboard, add binary register/system endpoints
    Replace the single-page Modbus register console with a router-driven dashboard
    shell (sidebar nav, mobile hamburger drawer) hosting three apps: the existing
    register console, a new Power Management app with client-recorded voltage/
    current/power time-series charts, and a new System Info app showing build-time
    and runtime data. /api/registers is now fully binary instead of text, and a new
    /api/system endpoint exposes runtime info (uptime, heap, IP/MAC, reset cause).
    Also embeds the Factory Control Unit logo and a matching generated header
    background.
    [webserver.cpp]
2026-07-19 Fix conveyor/compressor PWM: never started, and 100% duty wrapped to 0%
    HAL_TIM_PWM_Start() for TIM4_CH3/CH4 was never called anywhere, so the CCR
    writes in set_pwm_duty_permille() had no effect on the pins (motors never
    turned regardless of the holding register). Separately, at permille=1000 the
    computed CCR (ARR+1 = 0x10000) overflowed the 16-bit compare register back to
    0, which is full LOW instead of full HIGH -- slider all the way right stopped
    the motor instead of driving it at full speed. Clamp CCR to ARR to fix the
    overflow.
    [io.cpp]
2026-07-20 Add USB composite device (TinyUSB): working debug CDC port + fixes found along the way
    First stage of a planned 4-function USB composite device (debug CDC, Modbus
    CDC, CDC-NCM network, MSC) on the Factory Control Unit's USB_DRD_FS
    peripheral. This stage adds only the "FactoryControl Debug" virtual COM port
    (mirrors USART3 output), verified end-to-end on hardware.
    - New usbd_device.c/.h: TinyUSB init, composite descriptors, USB_VSENSE-based
    connect/disconnect, and the USB_DRD_FS ISR -- entirely self-contained and
    deliberately NOT managed by CubeMX (no NVIC checkbox in the .ioc), since
    TinyUSB's dcd_stm32_fsdev driver must own interrupt enable/disable timing
    itself. A CubeMX-generated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
    [app.cc, firmware_factory_control_unit.ioc, main.c, net_setup.cpp, net_setup.hpp]
2026-07-20 Free TIM6, reroute HAL_GetTick/HAL_Delay onto ThreadX + DWT cycle counter
    TIM6 (CubeMX's auto-chosen HAL timebase, since ThreadX owns SysTick
    exclusively for its own scheduler tick) was running its HAL_GetTick()/
    HAL_Delay() timebase about 11.5x slower than real time -- confirmed via
    DWT->CYCCNT as an independent third clock (ThreadX's own tx_time_get() was
    correct throughout: 300 ticks = exactly 3.000 real seconds). Root cause was
    never conclusively found (ruled out: HAL_InitTick() running before the final
    160MHz clock was set; the timer-clock-doubling rule looked correct on paper).
    Rather than keep chasing it, TIM6 dependency is removed entirely:
    - Core/Src/hal_tick_threadx.c: strong over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
    [app.cc, firmware_factory_control_unit.ioc, hal_tick_threadx.h, main.c]
2026-07-20 Add Modbus RTU server over USB CDC "FactoryControl Modbus" (Stage 2)
    Second TinyUSB CDC interface (endpoints 0x83/0x04/0x84) alongside the
    existing debug CDC. usbd_device_loop() gained an optional poll_hook
    parameter so the C++ ModbusRtuServer::Poll() can be driven from the
    C-only USB device thread loop without pulling tusb.h into a C++ TU;
    thin usbd_cdc_modbus_*() C wrappers expose the CDC1 read/write path for
    the same reason. ModbusRtuServer shares the same IModbusRegisterModel
    instance as the existing Modbus TCP server.
2026-07-20 Add CDC-NCM virtual network interface over USB (Stage 3)
    Third TinyUSB function: a virtual NIC (192.168.173.1) exposing the
    existing HTTPS webserver additionally at https://factory-box.local/,
    with the host getting 192.168.173.2 via a small built-in DHCP server.
    - usb_ncm_driver.c/.h: NetX Duo link driver for the NCM interface,
    following the same NX_IP_DRIVER command-dispatch shape as
    nx_stm32_eth_driver.c. TX from the NetX IP thread is handed off to
    the usbd_device_thread via a single-packet mailbox (poll_hook, same
    mechanism as ModbusRtuServer::Poll()) since tud_network_xmit() may
    only be called from the same thread as tud_task(). Builds/parses the
    Ethernet header by hand rath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
2026-07-20 Diagnose DHCP server network-parameter failure on USB-NCM interface
    Hardware test hit NX_DHCP_INVALID_NETWORK_PARAMETERS (0xA3) from
    nx_dhcp_set_interface_network_parameters(): its subnet-consistency
    check compares against whatever nx_dhcp_create_server_ip_address_list()
    captured from the interface earlier, not against fixed constants.
    Log the interface's actual committed address/mask via
    nx_ip_interface_address_get() right after nx_ip_interface_attach(),
    and feed the DHCP server config from that readback instead of the raw
    USB_NCM_IP_ADDRESS/_NET_MASK constants, so a mismatch becomes visible
    immediately instead of surfacing later as an opaque error code.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
    [net_setup.cpp]
2026-07-20 Fix USB-NCM DHCP server setup: dns_server_address=0 is rejected as invalid
    The diagnostic added previously confirmed the interface's committed
    address/mask were already correct (192.168.173.1/255.255.255.0) - the
    0xA3 (NX_DHCP_INVALID_NETWORK_PARAMETERS) was never about the subnet
    consistency check at all. nx_dhcp_set_interface_network_parameters()'s
    error-checking wrapper explicitly rejects a zero dns_server_address as
    invalid non-pointer input before the real implementation even runs.
    Pass the firmware's own address instead of 0; no real DNS service runs
    on it, so a client querying it just gets no answer, same practical
    effect as suppressing the option but without tripping the input check.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
    [net_setup.cpp]
2026-07-20 Fix USB-NCM mDNS setup: drop second NX_MDNS instance, enable existing one on both interfaces
    Hardware test hit NX_PORT_UNAVAILABLE (0x23) creating a second NX_MDNS
    instance on the same NX_IP: both would bind UDP port 5353 on the same
    IP instance, which isn't possible. Falls back to the plan's documented
    alternative: nx_mdns_enable(&app->mdns, USB_NCM_INTERFACE_INDEX) on the
    already-existing instance. The board now resolves the same per-board
    "factory-box-<hex>.local" name over USB as over Ethernet, not the
    originally-intended fixed "factory-box.local" - reaching that would
    need a custom mDNS responder capable of serving multiple hostnames
    over one UDP socket, out of scope here.
    Co-Authored-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
    [net_setup.cpp]
2026-07-20 Add temporary RX/TX diagnostics to usb_ncm_driver for DHCP-over-NCM debugging
    Windows enumerates the NCM adapter correctly (real MAC, DHCP-enabled)
    but falls back to APIPA instead of getting a lease from our DHCP
    server - meaning DHCP traffic isn't completing somewhere in the driver
    path. Logs rx/rx_dropped/tx/tx_dropped/tx_sent counters plus link
    state every ~3s so the next hardware test shows whether DHCP frames
    reach tud_network_recv_cb() at all, whether the driver attempts to
    send replies, and whether the single-packet TX mailbox is dropping
    them. Self-throttled in usb_ncm_driver_poll() rather than routed
    through the heartbeat, to leave that log line's already-tuned compact
    format alone.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
2026-07-21 Fix USB-NCM DHCP/HTTPS connectivity: RX alignment bug, TX queue, tud_task_ext
    Hardware debugging surfaced two real bugs that were silently killing
    all IP traffic on the USB-NCM interface:
    - usb_ncm_driver.c (RX): nx_packet_allocate(..., NX_RECEIVE_PACKET, ...)
    leaves nx_packet_prepend_ptr on a 4-byte boundary, but the 14-byte
    Ethernet header stripped from it is not a multiple of 4, so the IP
    header that follows landed 2 bytes off alignment. NetX Duo's
    _nx_ip_checksum_compute() computed a wrong result over the
    misaligned buffer, so every single received packet on this interface
    failed IP header checksum verification and was silently dropped -
    this is what blocked DHCP DISCOVER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
    [net_setup.cpp]
2026-07-21 Fix DTS temp-sensor timeout regression, drop USB-NCM mDNS, add IP SAN
    - usbd_device_loop()'s tud_task_ext(1, false) fix (previous commit)
    wakes the higher-priority usbd_device_thread every 1ms unconditionally,
    which starved io_thread's CPU-temperature DTS busy-wait (10ms timeout)
    during hardware testing. Made the timeout adaptive:
    usb_ncm_driver_has_pending_tx() reports whether a packet is actually
    queued, and only then does usbd_device_loop() shorten its wait to
    1ms - otherwise it goes back to blocking indefinitely like before,
    same as the original design's "0% CPU when idle" property, without
    reintroducing the multi-second reply latency this was fixing.
    - Removed mDNS entir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
    [app.cc, net_setup.cpp]
2026-07-22 Replace TinyUSB with USBX (Eclipse ThreadX) for the USB composite device
    Swaps the USB stack to match the project's existing ThreadX/NetX Duo
    foundation. USBX has no NCM class, so the virtual network interface moves
    from CDC-NCM to CDC-ECM; USBX's own _ux_network_driver_entry replaces the
    ~320-line hand-rolled NetX Duo bridge driver that CDC-NCM/TinyUSB needed.
    Vendors USBX (device-only, cdc_acm/cdc_ecm classes) from
    STMicroelectronics/stm32-mw-usbx under libs/ST/usbx, alongside the
    already-vendored ThreadX/FileX/NetX Duo. CDC-ACM instances now run against
    USBX's thread-based class model instead of TinyUSB's polled tud_task():
    Debug-CDC uses the non-blocking write_with_callback path, Modbus-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
    [app.cc, main.c, net_setup.cpp, nx_user.h, ux_stm32_config.h, ux_user.h]
2026-07-22 Minor changes
    [pcb_factory_control_unit.kicad_pcb]
2026-07-23 Add Nucleo-H563ZI test-rig support and CDC-NCM network interface via USBX
    Adds a BOARD_NUCLEO_H563ZI CMake option so the firmware can be exercised on a
    Nucleo-144 dev board without the real PCB (USER button simulates the light
    barrier, USER LED simulates the conveyor). Bring-up on real hardware
    surfaced and fixed two USBX bugs: unconfigured PMA endpoint addresses
    (all endpoints sharing address 0) and a too-small ThreadX system/interrupt
    stack overflowing during nested USB ISR calls.
    Replaces the RNDIS network interface (Windows' legacy RNDIS driver caused a
    host BSOD) with a project-written CDC-NCM USBX device class, since USBX
    ships no NCM class. The class plugs into USBX's own generic Net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
    [app.cc, io.cpp, main.c, main.h, net_setup.cpp]
2026-07-27 Replace ad-hoc build scripts with builder/ orchestrator, add I2C/PHY diagnostics
    Build process:
    - New builder/ Node/TypeScript orchestrator (docs/build-process.md) replaces
    the previously scattered tools/generate-*.mjs scripts, the CMake git-info
    custom target, and the vite-plugin-singlefile + postbuild-minify + embed
    script chain. Phases: ReadHardwareIDsAndGenerateFilesAndCerts{Lazy,Forced},
    ReadModbusRegisterMapAndGenerateFiles, ReadGitStatusAndGenerateFiles,
    CopyGeneratedFilesToBuildDirectory, BuildWebApp, BuildFirmware,
    FlashFirmware -- runnable individually or as pipeline:{lazy,forced,flash}
    npm scripts.
    - Board identity (cert/key/device_ids.hh) and generated code now live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
    [app.cc, io.cpp, main.c, net_setup.cpp, ux_user.h, webserver.cpp]
2026-07-27 Bump stm32_libs submodule (ModbusRtuServer USBX port, TCP Port() accessor)
2026-07-27 Deleted historic stuff
    [BOM-FactoryInABoxHat.csv, BOM-licheerv_nano_base.csv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]
2026-07-27 Move I2C device discovery to a one-time boot scan, transmit LAN8742 registers raw
    The per-request /api/i2c endpoint never reliably found devices, regardless of
    bus-recovery or NVIC-priority workarounds. Scan I2C1/I2C2/I2C4 once at boot
    from io_thread instead (mirroring the timing of the known-working pre-kernel
    reference scan) and serve the cached bitfields via /api/system. Root cause of
    the remaining false negatives/positives: back-to-back HAL_I2C_IsDeviceReady()
    calls need a settling delay between transactions (same pattern as the earlier
    TMC2209 timeout fix) and a preceding HAL_I2C_DeInit()+Init() reclaim actively
    produced phantom hits instead of preventing them.
    Also stop pre-interpreti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
    [app.cc, io.cpp, main.c, webserver.cpp, webserver.hpp]
2026-07-31 builder is not a dotnet project
    [Calculation HX711.xlsx]
2026-08-18 Add open62541-based OPC UA server with NetX Duo/ThreadX transport port
    Vendors open62541 v1.4.18 (MINIMAL nodeset, no ua-nodeset submodule needed)
    and adds a from-scratch EventLoop + TCP ConnectionManager for this board
    (no BSD sockets, only ThreadX/NetX Duo) built on the existing NX_TCPSERVER
    addon. SecurityPolicy#None only for now, small handwritten test address
    space (not yet generated from register-map.json). Runs as its own thread,
    listening on opc.tcp://:4840.
2026-08-18 Remove open62541 integration on this branch
    This branch explores a from-scratch, ThreadX/NetX Duo-native OPC UA
    server implementation instead. The open62541-based version remains on
    master as a working reference/fallback.
2026-08-18 Add from-scratch OPC UA Binary server (modern C++, no external OPC UA dependency)
    Implements the OPC UA Binary protocol stack directly against ThreadX/NetX Duo:
    type codec (extensible Variant via std::variant + type-descriptor pattern),
    UA TCP chunk framing, SecureChannel (Open/Close, SecurityPolicy#None only),
    Session lifecycle (Create/Activate/Close, anonymous auth), and the
    GetEndpoints/Read/Write/Browse services against a small statically-allocated
    address space. Transport reuses the existing NX_TCPSERVER addon (same
    building block as the HTTPS/WebSocket server), with each connection driving
    its own Connection state machine synchronously on NX_TCPSERVER's worker
    thread -- no separate pum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
2026-08-18 Make OPC UA address space a compile-time constexpr table in Flash
    Replaces the runtime AddObjectNode()/AddVariableNode()/AddReference()
    builder pattern with a non-owning AddressSpace view (std::span<const Node>
    + std::span<const ReferenceEntry>) over externally-defined constexpr
    tables. String/QualifiedName/LocalizedText/NodeId now hold std::string_view
    instead of std::string throughout the wire codec (safe: decoded strings
    only need to live for one synchronous Connection::HandleMessage() call),
    which is what makes Node itself a literal type usable in a constexpr
    initializer.
    Nodes are immutable by construction now: a writable Variable must go
    through a WriteCallback pointing at externally-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
    [opcua_setup.cpp]
2026-08-19 Control Unit: register-map redesign, SNTP clock, USB ISR logging fix
    Several independent pieces of work, bundled into one commit since they
    accumulated together this session:
    - Replace register-map.json with register_map_schema/*.cs (universal_register_access,
    a new C# schema tool styled after BestBinaryBuffers) -- generates type-safe Modbus
    accessors, TypeScript, and a real OPC UA address space from one schema instead of
    three independently-hand-synced representations. opcua_test_address_space.cpp/.hpp
    (hand-written test nodes) is replaced by the generated address space.
    - Add real UTC time via SNTP (Core/Src/sntp_setup.cpp, vendored NetX Duo DNS/SNTP
    addons) -- opcua::Now() was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
    [app.cc, opcua_setup.cpp, opcua_setup.hpp, sntp_setup.cpp, sntp_setup.hpp, test_opcua.py, webserver.cpp, ws_log_bridge.cpp]
2026-08-19 Control Unit: IPv6/mDNS AAAA support, fix Ethernet broadcast-filter bug, OPC UA session/security work
    IPv6 + mDNS:
    - Enable FEATURE_NX_IPV6 and mDNS IPv6 support so the board answers AAAA
    in addition to A, letting Windows resolve <host>.local without falling
    back to its slow negative-AAAA retry schedule.
    - Vendor the NetX Duo Neighbor Discovery cache implementation
    (nx_nd_cache_*.c) that FEATURE_NX_IPV6 needs but was missing from the
    vendored tree.
    Ethernet driver fix:
    - nx_stm32_eth_driver.c set FilterConfig.BroadcastFilter = ENABLE, which
    (despite the name) maps to the MAC's "Disable Broadcast Frames" bit and
    silently dropped all broadcast traffic (incl. DHCP) once the first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
    [http_websocket_server.hpp, net_setup.cpp, nx_user.h, opcua_setup.cpp, test_opcua.py]
2026-08-19 Control Unit: fix Release-build warnings, drop dead Node-orchestrator leftovers, update build docs
    Exclude USBX's unused PCI host-controller enumeration files from the device-only
    build and mark ws2812's dma_id maybe-unused (both only referenced from a
    HW_CONFIG_ASSERT that's a no-op in Release). Remove tools/environment-config.mjs.template,
    a leftover from the Node/TS build orchestrator that Program.cs replaced. Bring
    docs/build-process.md back in sync with the actual builder/ implementation: correct
    web/ npm install location, document required toolchain (cmake/ninja/arm-none-eabi-gcc/
    STM32CubeProgrammer), correct firmware_builder_common's real location (sibling repo,
    shared with an ESP32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
2026-08-19 Add Task Manager page: live ThreadX thread stats in the web UI
    Shows all ThreadX threads with state, priority, stack usage (current + true
    high-water mark), and real per-thread CPU load -- delivered on demand over
    the existing WebSocket connection (tasks.TaskManagerRequest/TaskListMessage,
    new BestBinaryBuffers schema) instead of a periodic server-side broadcast, so
    only clients with the page open cause any load.
    Firmware:
    - tx_execution_profile.h/.c: adds ThreadX's official execution-profiling
    hooks (_tx_execution_thread_enter/exit, _tx_execution_initialize), which
    are referenced by tx_thread_schedule.S under TX_EXECUTION_PROFILE_ENABLE
    but missing from the vendored ThreadX package.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
    [task_monitor.cpp, task_monitor.hpp, tx_execution_profile.c, tx_execution_profile.h, tx_user.h, webserver.cpp]
2026-08-20 Control Unit: integrate RoArm-M3 robot arm control + web teach UI
    Adds full firmware support for the RoArm-M3 servo arm on UART7 (Feetech
    SMS/STS protocol), closed-form kinematics/IK ported from Waveshare's
    reference firmware, an acceleration-limited joint tracker for smooth
    motion (replacing stepwise servo commands), mission storage via a
    vendored littlefs instance in a reserved 256K flash region, and
    WebSocket handlers wiring it all to a new "RoArm Teach" web page with
    a MoveIt2-style 3D interactive-marker gizmo (OGL) for live jogging and
    mission authoring.
2026-08-21 Control Unit: RAM cleanup pass 1 -- opcua_server/https_server rename+.bss fix, shared RSA cert, BestBinaryBuffer MAX_SIZE codegen
    Prompted by a RAM/network-copy analysis: g_server (OPC UA) sat in .data
    instead of .bss due to two non-zero default member initializers, wasn't
    organized as an App member like the HTTP server, and HTTPS had drifted onto
    a separate EC certificate based on a misdiagnosed performance issue (the
    real cause was RSA in an unoptimized Debug build, not RSA itself).
    - Move the OPC UA server object onto App (opcua_server, analogous to
    https_server, renamed from web_server); fix SessionTransport::bound_ and
    SecureChannel::serverSequenceNumber_ to be zero-initializable s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
    [app.cc, net_setup.cpp, opcua_setup.cpp, task_monitor.cpp, test-https-and-websocket.py, webserver.cpp]
2026-08-21 Control Unit: move Modbus registers + system info from REST to BestBinaryBuffer/WebSocket
    Completes the "one WebSocket channel, no second REST transport for
    application data" project decision -- the Modbus register snapshot/write
    and system-info (PHY registers, boot-time I2C scan) pages were the last
    holdouts, still speaking a hand-packed binary REST convention (GET
    /api/registers|/api/system|/api/write-holding) instead of the generated
    wire format everything else (RoArm, Task Manager) already uses.
    - New best_binary_buffers_schema/modbus.cs (GetRegistersRequest/
    RegistersMessage, WriteHoldingRequest/Response) and system.cs additions
    (PhyRegisters struct, SystemInfoRequest/Message) -- r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
2026-08-21 Control Unit: shrink HTTP/OPC UA session limits to the actual usage pattern
    Last workstream of the RAM cleanup: session capacity constants dated back
    to before the "one browser tab, one WebSocket" architecture was settled
    (Http::WebServer::MAX_SESSIONS was bumped to 6 partly as a margin against a
    suspected nx_tcpserver session-table leak; OpcUaTcpServer::MAX_SESSIONS=4
    was a generic guess). Per the project's actual usage pattern -- one SPA tab
    holding exactly one WebSocket, a future REST client sharing HTTP sessions
    with the browser instead of reserving its own, and OPC UA/Modbus each
    expecting a single concurrent client -- these can shrink substantially:
    - Http::WebServer::MAX_SESSIONS 6 -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
    [http_websocket_server.hpp]
2026-08-25 Control Unit: RoArm-M3 3D teach UI overhaul (SVG ViewCube, real meshes, mission planning UX)
    Replaces the programmatic-primitive robot visualization with the real Waveshare
    URDF meshes (vendored STL source assets + an offline extraction tool that welds/
    decimates them into a compact generated robot-data.ts), and ports the closed-form
    IK/gizmo from a validated prototype instead of the old CCD-based approach.
    Mission planning: collapsible panels for Gelenke/Kartesisches Ziel/Missionsplanung,
    a mission list that can grow to fill the sidebar and scrolls independently, clicking
    a mission step now jogs the arm there, and mission playback ramps joints smoothly
    instead of snapping.
    ViewCube: rebui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
    [base_link.stl, gripper_link.stl, link1.stl, link2.stl, link3.stl, link4.stl, link5.stl, roarm_m3.urdf]
2026-09-04 Control Unit builder: adopt the generalized IBuildContext from firmware_builder_common
    Follows the FirmwareBuilder.Common refactor (IBuildContext/AbstractBuildContext,
    attribute-based [BuildStep]/BuildStepRunner replacing CommandPipelineRegistry,
    board_info.json replacing board.json): adds Stm32BuildContext implementing
    IBuildContextStm32, moves every build step into [BuildStep] methods on
    Program.cs dispatched via BuildStepRunner.Run(), drops the now-superseded
    Paths.cs (folded into Stm32BuildContext/BuildContextPaths) and the
    BoardStorageOptions/Stm32ProgrammerOptions/CertificateAuthorityOptions
    duplicates now centralized in FirmwareBuilder.Common. CMakeLists.txt/
    constants.hh/docs/build-p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
2026-09-04 Control Unit web: mark unassigned I2C addresses as "?" instead of "reserved"
    The reserved-block addresses in the I2C scan lookup table aren't actually
    reserved by the I2C spec at these positions, "?" (unknown/unassigned) is the
    accurate label.
2026-09-04 PCB Control Unit: add EEPROM-select jumpers on EtherCAT ESC, new J7 connector
    ethercat_esc.kicad_sch: add EESDA solder jumpers JP4/JP5 with pull-up
    resistor R89 (3k3) and a RUNLED_PU label, wired to GND/+3V3.
    conn.kicad_sch: add 4-pin connector J7 (+12V/GND).
    [conn.kicad_sch, ethercat_esc.kicad_sch]
2026-09-29 Improved Schematics EtherCAT after Claude-Session. Refactoring in Builder
    [ethercat_esc.kicad_sch, pcb_factory_control_unit.kicad_sch]
2026-10-04 Control Unit: supply-voltage gate before power consumers, boot logic moved into App thread
    NOT YET TESTED ON HARDWARE -- builds clean (Release + Debug-Nucleo), boot
    behaviour still to be verified on the real board (barrel jack, USB-PD
    supply, laptop-only USB-C).
    Boot sequence:
    - main(): only GPIO plus the peripherals the gate needs (GPDMA, DCACHE,
    FLASH, ICACHE, USART3 for logging, I2C4 for the INA226, UCPD1), then
    tx_kernel_enter(). All other MX_*_Init() calls are "Do Not Generate
    Function Call" in the .ioc and run from MX_Init_PowerConsumers()
    (main.c USER CODE 4). STEPPER_EN (TMC2209 ENN, low-active) now starts
    HIGH, ETH PHY stays in reset until after the gate.
    - tx_application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
    [app.cc, firmware_factory_control_unit.ioc, hal_tick_threadx.h, main.c, main.h, net_setup.cpp, net_setup.hpp, opcua_setup.cpp]
2026-10-09 Control Unit: fix USB-NCM Code 10 after Windows update KB5124008
    Windows' usbncm.sys (Sept 2026, KB5124008) now rejects GET_NTB_PARAMETERS
    with wNdpIn/OutDivisor < 4 or not a power of two (STATUS_DEVICE_HARDWARE_ERROR,
    Device Manager Code 10, before any SET_INTERFACE). Report divisor 4; the
    bulk-IN path already places every datagram on a 4-byte boundary.
    Also align the class's EP0 handling with USBX's own classes: copy IN replies
    into the shared control buffer instead of permanently redirecting its
    data_pointer to flash, set the transfer phase explicitly, and don't issue
    extra transfers for requests without an IN data stage (the DCD sends the
    status ZLP itself).
    Verified on real HW: adapte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
2026-10-09 Control Unit: faster TLS handshake, TLS mutex init, free idle keep-alive slots
    - NetX Secure (vendored, marked PROJECT PATCH): sign the ECDHE
    ServerKeyExchange with the CRT variant of RSA when P/Q are available, as
    nx_secure_process_client_key_exchange.c already does. RSA-2048 signature
    2466 ms -> 674 ms, handshake 2.6 s -> 0.84 s, first page load ~13 s -> ~5 s
    over USB-NCM. ECDH P-256 was never the problem (~130 ms).
    - Call nx_secure_tls_initialize(): the global _nx_secure_tls_protection
    mutex was never created, so every internal tx_mutex_get() failed silently
    and TLS ran unprotected while log broadcasts send from other threads.
    - WebServer::BroadcastFrame() try-locks that mutex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
    [app.cc, http_websocket_server.hpp]
2026-10-09 Control Unit: pass milliseconds, not ThreadX ticks, to Io loop members
    Io::Loop() handed tx_time_get() (10 ms ticks) to processMembers(), but every
    consumer works in ms: PressureControlFeedback went out every 5 s instead of
    500 ms, PoseFeedback every 1 s instead of 100 ms, the RoArm motion integration
    ran 10x slow and mission delay steps ended immediately (tick timestamp
    compared against HAL_GetTick()). Use HAL_GetTick() (= ticks * 10).
2026-10-09 Control Unit web: app-neutral ws-client with per-namespace listeners
    ws-client.ts no longer knows any message type. Apps implement
    WsProtocolListener and register it per NAMESPACE_ID (one listener per
    namespace, kept in a map); decoding and dispatch happen in the app.
    wsRequest(namespaceId, encode, ResponseType) correlates responses generically
    via requestId and the expected (namespace, TYPE_ID), and now waits up to 10 s
    for the socket to open instead of failing immediately on page load.
    - WsRoArmBackend owns the roarm namespace (PoseFeedback) and sends jog events
    via sendBinary(); subscribeRoArmEvent/sendRoArmEvent are gone.
    - Firmware log mirroring moved to system-log-listener.ts.
    - Tas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
2026-10-09 Control Unit RoArm teach: fix pose jump after gizmo release
    Firmware clamped every joint to +-90deg (reference ARM_*_LIMIT values,
    meant only for the reference's own IK), while the gizmo IK solves against
    the URDF limits (elbow up to 169deg, base/roll +-180deg). Any target
    beyond +-90deg was clamped joint by joint, so the tracker -- and thus the
    PoseFeedback the 3D view adopts after release -- ended up in a completely
    different pose.
    - Firmware joint limits = intersection of servo mapping and URDF limits
    - Client JOINT_LIMITS_RAD mirrors them; gizmo IK intersects URDF limits
    with them, joint sliders use them
    - 3D view holds the released pose until feedback catches up (1deg / 5s)
    instead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
2026-10-14 Control Unit PCB: schematic rework (PSU, MX26631DL, XL6009 module, ERC fixes), new placement on 90 mm high board
2026-10-14 Control Unit PCB: autorouted first pass (483/540 connections, GND via fanout to In1)
2026-10-14 PCB WIP
2026-10-14 WIP PCB
2026-10-28 Builder: EC P-256 HTTPS leaf next to the RSA OPC UA leaf
    Preparation for the rtoos port: rtoos' TLS server offers ECDSA only, RSA
    remains for OPC UA (Basic256Sha256). GenerateCertificates(httpsEcLeaf: true)
    in FirmwareBuilder.Common issues device_https_certificate.der/key.der.
2026-10-31 FCU firmware on rtoos: HAL, CubeMX, ThreadX/NetX/USBX replaced
    - rtoos as submodule (GCC 16, C++26); presets Release/Debug (PCB revision 2) and
    Release-Rev1/Debug-Rev1 (first boards); pins per revision, checked at compile time.
    - Boot as before: identity check, supply gate with INA226 and USB-PD (20 V), power
    consumers, network, I/O cycle every 50 ms.
    - Network: Ethernet (DHCP, mDNS, SNTP), USB CDC-NCM with DHCP server and CDC-ACM Modbus
    RTU, HTTPS/WebSocket, Modbus TCP, OPC UA (generated nodes), SSH log terminal.
    - I/O: sensors, valves (+ vacuum valve/pump on revision 2), PWM, steppers (TMC2209, sigmoid
    ramps, sensorless homing), WS2812, CAN, RoArm-M3 with missions in the flash (sam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
2026-11-02 FCU: Terminal page (console + live log table) instead of the SSH log terminal
    - Web UI page "Terminal": a classic console (black, monospace, prompt,
    blinking cursor) for hardware tests, and the live firmware log as a table
    (level, time, logger, text) with level filter, auto-scroll switch and
    10000 lines kept in the browser.
    - Command catalog terminal_schema/commands.json -> builder step
    GenerateTerminalFiles -> web/generated/terminal-commands.ts (compiled into
    the web app: history, Tab completion of commands and parameter values,
    parameter tooltip, help and clear run in the browser) and
    Core/generated/terminal_commands.hh (firmware: a handler per command and an
    answer per loo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
2026-11-02 Terminal page fixes with regression tests; task manager without thread state
    - Prompt indentation: .term-line is white-space: pre-wrap and the prompt
    line's template had a line break and tabs inside the div, rendered as
    text. Regression test: web/src/apps/terminal-app.test.ts (happy-dom).
    - Completion: a space only when another parameter can follow; the empty
    word after a trailing space no longer counts as a parameter (no "too many
    parameters"). Line logic moved to web/src/terminal/command-line.ts with
    tests (command-line.test.ts).
    - Web unit tests: npm test (vitest, happy-dom).
    - Task manager: no thread state any more (sampled once a second it showed a
    random moment of threads t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
2026-11-03 Fix CAN-Bus Tranceiver
2026-11-03 FCU revision 2: CH224K instead of UCPD, new pins; motor PWM 1 kHz; rtoos SPI fix
    - Revision 2 PCB: USB-PD by a CH224K (20 V, CFG1 open), UCPD1 unused.
    INT_TOF1 = PC14, INT_TOF3 = PB13 (former CC1), CURRENT ALERT = PC9 (former
    DB2); rtoos board::init() switches the UCPD dead-battery pull-downs off.
    The supply gate only waits for >= 18 V; PD registers from the INA226.
    - Conveyor and compressor PWM (TIM4): 1 kHz instead of 2.5 kHz.
    - rtoos 738e491: SPI fills the TxFIFO before CSTART, so an interrupt can no
    longer stretch an HX711 PD_SCK pulse past 60 us (Renode test hx711_renode).
2026-11-03 FCU steppers in hardware: TIM2/TIM3 compare outputs, periods by GPDMA; DEDGE
    STEP 1 (PA15) and STEP 2 (PB4) are now TIM2_CH1 and TIM3_CH1 in toggle
    mode; GPDMA1 channels 4/5 write every step's period into ARR (rtos
    TimerStepper). No interrupt per step any more, the DMA interrupt refills
    every 32 steps; the edges no longer carry interrupt latency.
    Behaviour change: rtos Tmc2209::init() now sets DEDGE. Both STEP edges count,
    so one step of the firmware is one microstep - before, the driver counted
    only the rising edges and the motors moved half the commanded steps (at
    half the speed). Positions and speeds need recalibration.
    rtoos 1ad9cd6.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
2026-11-03 FCU I2C interrupt-driven: the I/O thread sleeps while the bytes move
    I2C1, I2C2 and I2C4 use rtos I2cMaster with a semaphore wait policy: the
    event interrupt moves every byte, the I/O thread sleeps until the STOP
    instead of busy-waiting a few hundred microseconds per register (the
    network thread gets the CPU meanwhile). Interrupts at priority 6.
    rtoos e4f8490.
2026-11-03 FCU EXTI: HX711 by interrupts alone, INA226 ALERT wakes the I/O thread, latched light barriers
    - HX711: DOUT's falling edge (EXTI2) starts the SPI transfer, the SPI end-of-
    transfer interrupt decodes it; no DOUT polling, no waiting in the I/O cycle.
    Status 1 when no reading came for a second.
    - INA226: ALERT on conversion ready (EXTI on PC9, rev 1: PD4) notifies the I/O
    thread, which reads between its cycles; config 0x4527 (16 averages: a
    measurement every 35.2 ms). Fallback read after 200 ms without ALERT.
    - Light barriers: EXTI on both edges latches every interruption; the register
    shows 1 for one cycle even if the object passed between two looks.
    - I/O thread: waits for event no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
2026-11-04 FCU layout: generated/ to the top level, schemas under schema/, RoArm example removed
    - Core/RoArm-M3_example deleted: Waveshare reference firmware, only read for
    the kinematics port, never built.
    - Core/generated -> generated (CMake, builder, .gitignore, docs); Core/ is gone.
    - best_binary_buffers_schema, register_map_schema, terminal_schema ->
    schema/best_binary_buffers, schema/register_map, schema/terminal. The
    builder sets the BestBinaryBuffers schema dir itself, since
    firmware_builder_common defaults to best_binary_buffers_schema/ at the root.
2026-11-04 FCU steppers: sensorless homing at the start, moves only when homed
    - Both steppers home at the start (StallGuard, towards the end stop) once
    the motor supply is up and the TMC2209 answers; without the supply no
    homing (StallGuard could report an end stop that is not there).
    - An axis that is not homed does not move; its target waits. A successful
    homing sets position and target to 0.
    - StallGuard is polled every 5 ms during the homing (SG_RESULT changes about
    every full step) instead of every 50 ms with the I/O cycle; the DIAG
    outputs are not wired on revision 2.
    - Status: Bit2 homing failed, Bit4 homing, Bit5 homed; StartHoming 0 ok,
    2 no end stop, 3 driver does not answer. Log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
2026-11-04 FCU cleanup: CubeMX leftovers removed, references to the HAL firmware updated
    - .mxproject (CubeMX state of the HAL firmware) and .clangd (56 null bytes)
    removed.
    - Comments and docs pointed to files of the HAL firmware (Core/Src/...,
    webserver.cpp, setup_and_loops/, Drivers/BSP) and to the old generated
    header names; they name the current files now. The RoArm comments no
    longer speak of a "later" C++ port, the HTTPS test docstring no longer of
    NetX/RSA, the task schema no longer of ThreadX/NetX pools.
    - rename-usb-devices.ps1: only the comment; its targets still have the HAL
    firmware's layout (noted there).
2026-11-04 FCU steppers: DIAG stall interrupt for the homing (pins assumed), rtoos homing fixes
    - DIAG1/DIAG2 of the TMC2209s on PE10/PE11 (revision 2; ASSUMPTION, the
    wires are not there yet; EXTI lines 10/11 free), input with pull-down:
    without the wires the homing polls over UART as before and logs that
    the stall did not show on DIAG.
    - A rising DIAG wakes the I/O thread (event_stall), which stops the motor
    at once; a DIAG from a driver error fails the homing.
    - rtoos: homing in StealthChop with CoolStep off, VACTUAL in microsteps of
    the set resolution (it ran 16 times too fast).
2026-11-05 FCU: Review-Korrekturen 5.11. (CH224K-PD-Trigger, Pinbelegung, Pull-ups, ESD, CAN-Terminierung, MPN/LCSC-Felder)
    - CH224K als USB-PD-Trigger statt UCPD
    - TOF3 -> PD10
    - UEXT_CS
    - Pull-ups fuer die Lichtschranken
    - ESD-Schutz: USBLC6 / NUP2105L
    - CAN-Terminierung per SW3 zuschaltbar
    - Silkscreen: 20-24V, UEXT CS
    - Korrigierte MPN-/Hersteller-/LCSC-Felder fuer alle SMD-Bauteile
2026-11-05 FCU revision 2: pins from the current schematic; UCPD dead battery off in Reset_Handler; POWER_GOOD pull-up
    - rtoos 9b546b8: UCPD_DBDIS in board_early_init() (first call in Reset_Handler) - PB13 is the
    active-low UEXT_CS; LED_INFO on PH0; SD card detect PD4 with pull-up.
    - Pins (KiCad netlist): VACUUM_VALVE PB14, INT_TOF3 PD10, STEPPER1_DIR PD5, DIAG PD6/PE0
    (EXTI6/EXTI0; EXTI10/11 handlers gone), INT_RGB PH1.
    - POWER_GOOD (CH224K PGOOD, open drain, PA9) input with internal pull-up, polled (EXTI line 9
    belongs to CURRENT ALERT); UEXT_CS driven high (deselected) with the supply pins.
    - Register schema / docs: IRQ and GPIO pins for both revisions.
    Not yet tested on hardware.
    Co-Authore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
2026-11-07 FCU firmware: rtoos with the shared Cortex-M/STM32 layers (G431 port)
    rtoos 5be1f56 -> 86441dd: the shared port/cortex_m + port/stm32 layers and the STM32G431
    port, plus the H5 features the rtoos merge had dropped (interrupt-driven I2C, timer
    toggle/one-pulse for the TimerStepper, terminal pin names). The firmware builds unchanged
    (Release and Release-Rev1; RAM identical, text +256 bytes). Groundwork for the STM32H743
    port (FCU revision 3).
2026-11-08 Changed MCU to STM32H743 - ready for review
2026-11-08 FCU firmware: hardware revision 3 (STM32H743VIT6)
    src/ is chip-neutral through the board package's board/chip.hpp (CPU port,
    kernel binding, Ethernet, RNG, NVIC); pins.hpp and hardware.hpp have a
    branch for revision 3 from the current netlist (U17): I2C3 supply bus
    (INA226, ToF 3, CH224Q), I2C4 for ToF 2, robot bus on USART1, DMA1 streams
    0-3 (32-bit stepper periods: the H7 DMA does not widen), ADC3 CPU
    temperature, 16-bit pressure ADC reduced to the register map's 12 bits,
    EXTI on the shared vectors, PC2_C/PC3_C analog switches closed for the
    HX711, POWER_GOOD from the TPS26631 (active high). RoArm missions
    (littlefs) use the whole bank 2 (1 MB at 0x08100000). No USB device on
    revision 3 ye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
2026-11-08 System page and terminal: I2C buses labelled with their real numbers
    The system page labelled the boot scans I2C1/I2C2/I2C4 whatever the board
    had; on hardware revision 3 the ToF 2 bus is I2C4 and the supply bus I2C3.
    SystemInfoMessage now carries a list of I2cBusScan {bus, devices}, the page
    labels each with the number the firmware sends (web/src/i2c-scan.ts, test
    fails with the fixed labels). The terminal's i2c command lists I2C3 too.
2026-11-08 RoArm missions on the SD card
    The missions move from the internal flash (littlefs) to the SD card (FAT,
    FileX): /MISSIONS/<index>.MSN, written as .TMP and renamed. On the STM32H743
    the flash's 128 KB sectors left littlefs room for only 5-6 missions. The card
    is mounted at the start and again at the next request (at most every 5 s)
    when it is missing or failed; no automatic formatting. STM32H563 boards move
    their former flash missions onto the card at the first mount and remove them
    from the flash; revision 3 has no flash data area any more.
    The FileX volume lies in RTOS_SDMMC_BUFFER (STM32H743: the non-cacheable AXI
    SRAM window SDMMC1's IDMA reaches, rtoos 5224e00).
    tools/test-missions-sd-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
2026-11-08 USB on hardware revision 3 (STM32H743 USB2_OTG_FS)
    The USB device (CDC-NCM network + CDC-ACM Modbus RTU) runs on every revision:
    network.cpp uses the board's controller (board::UsbDevice, board::init_usb(),
    RTOS_BOARD_USB_IRQ_HANDLER - rtoos f58dfff), FCU_USB_DEVICE is gone.
    tools/test-usb-renode.py: the revision 3 firmware in Renode with rtoos'
    scripted USB host - enumeration of the composite device, configuration and a
    Modbus RTU request over CDC-ACM answered correctly. Not run on hardware yet.
2026-11-08 FCU docs: PLC spec review round 2 - storage, POUs, libraries, GUI
    - E3 new: image + configuration in their own internal flash area (A/B
    slots at 0x081C0000 on both chips, power-loss safe), project source and
    RETAIN on the SD card; the PLC starts without a card.
    - Stage 1 has exactly one PLC_PRG; several POUs of every type come in P4,
    libraries with versions and namespaces in P7. Compiler and project
    format are built for several POUs from P1 on.
    - GUI: layout and workflows after CODESYS and the OpenPLC Editor
    (concepts only, it is GPLv3); the look comes from a mockup before P2.
    - Phases renumbered (P4 several POUs, P5 FBD, P6 SFC, P7 extensions).
    - Section links point to the English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
2026-11-09 FCU PLC P1: IEC 61131-3 ST compiler and bytecode VM in the web UI
    web/src/plc/ (DOM-free, `npm run typecheck:plc` enforces it):
    - compiler/: lexer, parser with error recovery, type checker (Ed. 3 implicit
    widening, literal types from context, range-checked conversions), code
    generator to the rtoos PLC bytecode, standard function blocks (TON, TOF,
    TP, R_TRIG, F_TRIG, SR, RS, CTU, CTD, CTUD) in ST, intrinsic functions
    (conversions, MIN/MAX/LIMIT/SEL/MUX, ABS, SQRT, SHL/ROL, ...), debug
    information (statement map, variable addresses). Recursion is rejected;
    the frame area per task comes from the call graph.
    - vm.ts: the TypeScript counterpart of rtoos/src/plc/vm.cpp (simulator,
    re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
2026-11-09 FCU web UI: PLC page (IEC 61131-3 IDE mockup with simulator)
    New page "SPS (IEC 61131)" (/plc), layout and workflows after
    docs/plc-iec61131.md 10.2 (CODESYS / OpenPLC Editor concepts):
    - toolbar: build, device (simulator; FCU: P2), load, load & start, start,
    stop, single cycle, reset, release forces; debug buttons shown, P3
    - project tree: PLC_PRG, task, I/O image, standard library; export/import
    of the project file, example project; autosave in the browser
    - declaration as a table (class, name, type, initial value, comment,
    online value) or as text, the same text underneath
    - ST editor without dependencies: highlighting, line numbers, error lines,
    inline online values (CODESYS inli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
2026-11-09 FCU PLC: I/O bindings in the image
    The compiler takes the I/O list as an option and writes one binding per I/O
    variable into the image (register, input/holding area, input/output, 1/16/32
    bits, signedness, data address); a missing or wrongly typed variable is an
    error. The IDE derives the list from the register map; 32-bit values follow
    the register binding's word order (high word first). The image carries a
    CRC-32 of the list as ioMapHash.
    Command registers (StepperXStartHoming, RoArmMissionControl) are not I/O
    variables: as cyclic outputs they would overwrite the firmware's answers
    (docs/plc-iec61131.md 6.3); they come with the FCU library blocks. The list
    of them stays in io-list.ts unti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
2026-11-09 FCU PLC P2: runtime on the device, control source, Renode test
    src/plc.*: the PLC thread (priority 11, below io) runs one cycle of the
    IEC program after each I/O cycle: input registers -> program variables,
    the program, output variables -> holding registers (only while the control
    source is IEC). Program and configuration (control source, autostart) are
    in the A/B flash slots at 0x081C0000 on both chips (rtos::plc::SlotStore),
    so the program starts by itself after power-on, without a browser.
    Control source IEC: the register bank's write filter refuses every holding
    register except the command registers to Modbus (exception 0x02), OPC UA
    (Bad_NotWritable) and the web UI's register panel (no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
2026-11-09 FCU PLC: the FCU as a device in the IDE
    The PLC page works with a device interface (ide/device.ts) that both the
    simulator and the FCU implement. FcuDevice speaks the WebSocket namespace
    plc: status and the program's variables by polling (online values), the
    download in 1 KB chunks with the flash commit (30 s timeout: an STM32H743
    sector erase), RUN/STOP/reset, the control source (fieldbus | IEC 61131)
    and autostart as device settings in the toolbar. Forcing on the FCU and
    single cycles are disabled there (P3 / simulator only).
    "Project != device" compares the project hash of the image on the device
    with the hash of the editor's state (compiler: projectHashOf), the same
    for both devices. On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
2026-11-09 FCU PLC: register classes (E5), I/O map hash, FCU library blocks
    Register classes from the schema (Kind = Output | Command | Parameter):
    StepperXStartHoming and RoArmMissionControl are commands, every other
    holding register an output. The hand-written lists of command registers in
    the firmware and the IDE are gone (register_map::holding_kind(), RegisterDef
    .kind). In IEC mode the command registers belong to the program too:
    Modbus 0x02, OPC UA Bad_NotWritable, the terminal's `home` refuses.
    Binding kind command in the runtime (src/plc.cpp): register -> variable
    before the cycle (the answer), variable -> register after it only if the
    program changed the variable in this cycle - a start is wr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
2026-11-09 FCU: compile-time resource checks (rtoos 9f4ab7b)
    src/hardware.hpp lists every resource of the firmware once and lets the
    compiler check that nothing is used twice: EXTI lines, timers, DMA
    channels/streams, U(S)ARTs (with the board's console), I2C buses, the I2C
    devices' (bus, address) pairs, and all pins (board::pins::* of the board
    package plus supply_pins and io_pins). What a revision does not have stays
    out: Barrier3 (revision 1), the DIAG lines (2/3), UCPD with its clock and
    DMA channels (1).
    All three revisions build; a deliberate conflict (servo bus on the console's
    USART3) stops the build with "a U(S)ART used twice". Renode PLC end-to-end
    test on revision 3: PASS.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
2026-11-09 FCU PLC: terminal command plc
    `plc` shows the state (read directly: state, control source, autostart,
    program size, cycles, instructions, runtime error, why downloads are
    refused). `plc run | stop | reset warm|cold | source fieldbus|iec |
    autostart on|off` (docs/plc-iec61131.md 6.2) go to the PLC thread as a
    request: they may write the flash journal, and the I/O thread that runs the
    terminal must not wait for that. The PLC thread logs the result.
    Renode (tools/test-plc-renode.py, revision 3): the state over the terminal,
    `plc reset` without warm|cold refused, `plc source fieldbus` and
    `plc autostart off` done through the PLC thread (log, status).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
2026-11-09 FCU PLC: project source on the SD card ("Vom Gerät"); rtoos f2c5d57
    PutProjectRequest / GetProjectRequest (namespace plc, ids 13-16): the IDE's
    project JSON in 1 KB chunks as /PLC/project.fcuplc.json, written as
    /PLC/project.tmp and renamed when complete (a power loss keeps the old or
    the new project), read back in chunks (src/plc_project.*). The I/O thread
    answers - it owns the card; the program itself stays in the flash slots and
    runs without a card (docs/plc-iec61131.md 4.5, 10.4).
    src/sd_card.*: card handling (mount, retry every 5 s, a lost card) shared by
    the RoArm missions and the PLC project; the missions keep /MISSIONS as their
    default directory, set up once per mounted card.
    IDE: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
2026-11-09 FCU PLC docs: RETAIN postponed, never in the internal flash; flash writes
    RETAIN stays unimplemented for now (the compiler warns that such a
    variable starts with its initial value) and must never be written to the
    internal flash. The candidates for later (backup SRAM with VBAT, writing on
    power loss, SD card) are noted. The flash writes as implemented are listed
    with their wear: a download erases one sector (A/B alternating), a
    configuration change appends a journal record, RUN writes nothing.
2026-11-09 FCU PLC: FCU_StepperMoveAbsolute
    Axis, Execute, Position (DINT), Velocity (0 keeps the speed) -> Done, Busy,
    CommandAborted, Error, ErrorID (1 not referenced, 2 drivers disabled,
    16#100 no such axis). It writes the output variables StepperXTarget /
    StepperXSpeed; another target written meanwhile ends it with
    CommandAborted. The firmware moves only an enabled, referenced axis, so the
    block refuses the others at once instead of waiting forever. Done comes
    from the position register reaching the goal with the axis standing - the
    "in position" bit still describes the old target in the cycle that writes
    the new one (test).
    The simulator's plant model reports the stepper status (enabled, moving,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
2026-11-09 FCU PLC P3: forcing on the FCU, debug lease
    ForceRequest (address, up to 8 bytes) / UnforceRequest (one address or
    0xFFFFFFFF for all), ids 17-20: 32 entries in the PLC thread, applied after
    the inputs are read and again after the program ran - an input force beats
    the input image, an output force the program. Released on STOP, ERROR,
    NO_PROGRAM, a control source switch, a reset and a download; every force
    is logged. StatusResponse: forces, leasedByOther.
    Debug lease (docs/plc-iec61131.md 10.3): the browser that forces holds it;
    force, write, RUN/STOP/reset and download from the others are refused.
    Releasing the last force or closing the WebSocket ends it - the forces stay
    then; the termina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
2026-11-09 FCU PLC P3: breakpoints and single step on the FCU (rtoos ff2d7e7)
    The images carry the statement table (header 88 bytes): the compiler writes
    the statement starts, both VMs verify them; the device steps by itself.
    Old images fail to load (header_size) - download the program again.
    Firmware: BreakpointsRequest (up to 64 code offsets, takes the debug lease),
    ControlRequest Continue / StepInto / StepOver / StepOut, HaltRequest (pc and
    the call chain), PlcState Halted. HALTED: the I/O cycle runs on, the outputs
    keep their values (no safe state), the forces stay, nothing continues by
    itself; RUN is refused; STOP and a download leave the halted cycle and clear
    the breakpoints; a step past the en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
2026-11-09 FCU PLC: FBD and SFC editors (preview of P5/P6)
    Two graphical programs of their own in the IDE's project tree ("Vorschau";
    POUs of the project come with P4), each translated to ST, compiled with the
    I/O list and the libraries, runnable in the simulator with online values.
    FBD (ide/fbd.ts, ide/fbd-editor.ts, SVG): networks of boxes - logic,
    comparison, arithmetic, SEL/MIN/MAX/LIMIT/MOVE, TON/TOF/TP, CTU/CTD,
    R_TRIG/F_TRIG, SR/RS - input variables (ST expressions) and output
    variables; drag to move, draw a wire from an output pin to an input pin,
    Delete removes, a palette adds, a side panel edits. Wires are orthogonal
    with a lane per input. Lowering: instance calls in dependency order,
    operat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
2026-11-09 FCU PLC FBD editor: pin snapping, crosshair cursor, data type colours
    A press near a pin starts a wire (from outputs and inputs), the rubber band
    snaps to the nearest opposite pin. Pin types are derived from fixed box pins,
    variables and literals and propagated over wires and generic boxes; pins and
    wires are coloured by type class, incompatible wires are dashed red.
2026-11-09 FCU web: maximize the working area (hide header and sidebar)
    A button in the header hides header and sidebar, a small handle at the top
    centre shows them again; remembered per browser. Full-height pages (PLC IDE,
    terminal) take the header height from --shell-header-h.
2026-11-09 FCU web: maximized view keeps a slim header with a visible restore button
    The tiny half-transparent handle was not found. Maximized now shows a 28px
    bar with the page title and "Menü einblenden". The state is kept per tab
    (sessionStorage), so a newly opened page always starts in the normal view.
2026-11-09 FCU PLC P3: watch subscriptions instead of polling the data segment
    WatchRequest/WatchValues: the browser subscribes the ranges of the variables
    the IDE shows; the PLC thread pushes them after a cycle, at most every 100 ms,
    all from the same cycle end. A closed session's subscription ends (session
    ids are reused). Older firmware: the browser falls back to polling.
    Tested in Renode on the H743 (consistency, rate, limits, session reuse).
2026-11-09 FCU PLC: no polling fallback - ReadRequest removed
    There is only the current firmware: the browser gets values through watch
    subscriptions only, the firmware no longer answers ReadRequest (ids 9/10
    stay reserved). The Renode test reads variables by a one-shot subscription.
2026-11-09 FCU: remove legacy - littlefs mission import, store_problem, project normalization
    There is only the current firmware: the import of RoArm missions from an
    internal-flash littlefs (old H563 firmware) and the PLC's guard against
    overwriting them are gone, rtos_littlefs is no longer linked, StatusResponse
    loses storeProblem. Projects must be complete (no defaults for old ones).
2026-11-09 FCU PLC IDE: FBD wire routing, sensors/actuators in the FBD palette, ST code completion
    Wires are routed per network around foreign boxes, each source on its own
    lines. The register map's sensors and actuators are FBD palette entries
    (bound nodes with type colour, unit, tooltip). The ST editor completes
    keywords, types, blocks, objects, variables, I/O and members. The add-object
    button no longer looks disabled.
2026-11-09 FCU: stepper test bench page, 2 HTTPS sessions, OPC UA test fixed, commands doc
    Web page "Schrittmotoren" (ws::stepper): manual control, moves with a
    run-time profile (linear ramp or sigmoid), homing with its own parameters,
    all TMC2209 settings, live driver values as curves. At most two HTTPS/
    WebSocket sessions (-35 KB RAM); the pool view shows the least free.
    rtoos f8ae0f9: OPC UA CreateSession fits real certificates. test_opcua.py:
    client certificate issued by the trusted CA, ClientSignature. Revision 2
    is out of the tests (never built); docs/kommandos.md documents builds,
    tests and switching boards.
2026-11-10 FCU: web status bar, dialogs, dark mode, explorer folders, FBD E/V/A insert; Gpio1/2, Malibotti
    Web UI:
    - common status bar (WebSocket state, app mode, app fields), app status texts removed
    - modal dialogs for all apps instead of confirm/prompt
    - dark mode switch, full screen on maximize
    - PLC IDE: explorer folder tree (nested, drag & drop, rename, delete with choice),
    task table checkbox fix (keyed rows), legacy I/O hint removed, pin colours from the
    declarations also while the project does not compile
    - FBD: E/V/A insert menus per network, "+ Netzwerk" below each network, routing with the bend
    near the target and lanes per target box (regression test: no crossing at SEL)
    Firmware (r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
2026-11-10 FCU PLC: FBD type conversion boxes; SFC action qualifier D
    FBD: palette group "Typumwandlung" with every X_TO_Y conversion of the
    elementary types that the compiler accepts, and TRUNC; the pins carry their
    types (wire colours), lowered as the function call. The rule which pairs
    convert is in one place now (compiler/types.ts conversionAllowed), used by
    the compiler and the palette.
    SFC: qualifier D (time delayed) with a time per action: a variable is TRUE
    from the time after the step's activation until the step is left (OR with
    N actions on the same variable); ST statements run under the same
    condition. A D action without a time is reported. Still to come: SD, DS,
    SL (and L, P0, P1) - docs/p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
2026-11-10 FCU: rtoos bump - DMA buffer section initialized at start (boot crash on rev 1)
2026-11-11 FCU: Rev1 boot lockup (USB vector), register console timeouts, dead WebSocket detection
    - rtoos: the H563 USB interrupt reached Default_Handler (misnamed vector) and locked the chip
    up after the boot; every image is now checked against its vector table after the link
    - register console: RegistersMessage's bounds (111/258) were below the grown register map
    (112/262), the answer could not be encoded and was never sent - every request timed out.
    Bounds 128/320, a static_assert in web.cpp ties them to the register map (fails with the old
    bounds, checked), a failed encode is logged instead of silently dropped
    - web: a request timeout with nothing at all received since it was sent gives th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
2026-11-11 PCB Update
2026-11-12 FCU: rtoos bump (DMA sections zeroed at start - rev 1 boot lockup); register console in IEC mode
    - rtoos f937aa0 replaces the never pushed edd2742: the startup zeroes the DMA sections, no
    non-zero start values allowed there (link check); the stepper read SRAM garbage at boot
    - register console: in IEC 61131 mode outputs and commands show "SPS" instead of controls (the
    device refuses them, only parameters are writable), the status bar says so, a refused write
    names the reason
2026-11-12 FCU: rudimentary EtherCAT (LAN9253) bring-up test, revisions 1 and 3
    The ESC was held in reset until now. ethercat_test.cpp releases it and talks to it over its
    QUADSPI/OCTOSPI lines as plain SPI by GPIO (READ 03h / WRITE 02h, LAN9253 DS00003421):
    - start: BYTE_TEST, ID_REV, HW_CFG, ESC type/revision/FMMUs/SMs/ports, PDI settings, EEPROM
    status logged
    - every I/O cycle: EEPROM emulation from a minimal SII image in RAM (configuration area with the
    strap-selected PDI settings and CRC, vendor 0 / product 0x9253, name "FCU EtherCAT test"),
    AL state requests acknowledged (BOOT refused), DL/AL status changes logged
    Goal: a master finds and identifies the device and takes it to OP. No mailbox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
2026-11-12 FCU EtherCAT test: polled, no IRQ needed (not connected on rev 1); why SPI by GPIO
2026-11-12 FCU: USB networking on revision 1 works - H563 USB erratum (rtoos), USB started last
    - rtoos 2ddbc95: the USB_DRD_FS controller raises CTR before the packet's count is in the
    packet memory; the driver now waits. Before, CDC-NCM lost the NTB boundaries after the first
    blocks: no DHCP, ARP, ping after a few seconds.
    - network.cpp: the USB device starts after the TLS and OPC UA setup, right before the network
    loop: the PC sees it only when the DHCP server answers. Started first, Windows' early DHCP
    requests went unanswered and it fell back to a 169.254 address for minutes.
    Checked on the board: DHCP at once, ping 20/20 (1400 bytes), the web app over HTTPS.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
2026-11-12 Minor updates on PCB after review
