klaus-liebler/factory_in_a_box/(notices)

Notices in the files:
firmware_factory_control_unit/Core/Inc/main.h:
Copyright (c) 2026 STMicroelectronics.
All rights reserved.
This software is licensed under terms that can be found in the LICENSE file
